arcoslab/open-coroco-legacy/src_DTC-SVM/Three-phase_bridge/20131107_111719.jpg

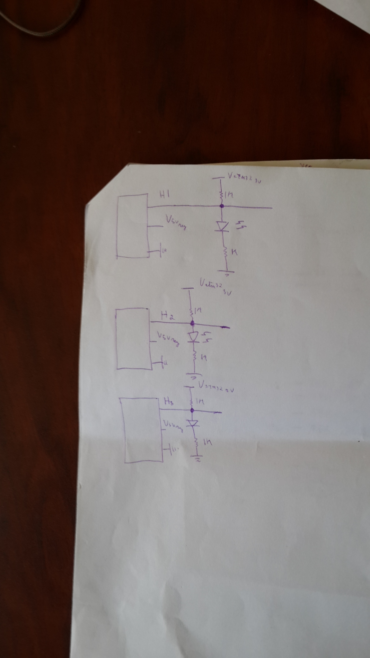
src_DTC-SVM/Three-phase_bridge/20131107_111719.jpg
