arcoslab/open-coroco-legacy/src_DTC-SVM/Three-phase_bridge/20131031_172141(1).jpg

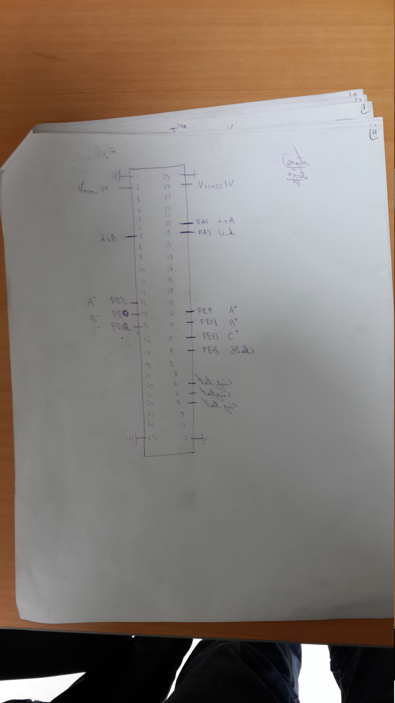
src_DTC-SVM/Three-phase_bridge/20131031_172141(1).jpg
