arcoslab/open-coroco-legacy/README.md

open-coroco
===========

COmpliant RObot COntroller is a free software project aiming to create an impedance controller based on a STM32F4 microcontroller using bldc motors and strain gauges.
