arcoslab/open-coroco-legacy/trabajo/datas/quadcopt/datasheet/accelerometer/bsp_lsm330.png

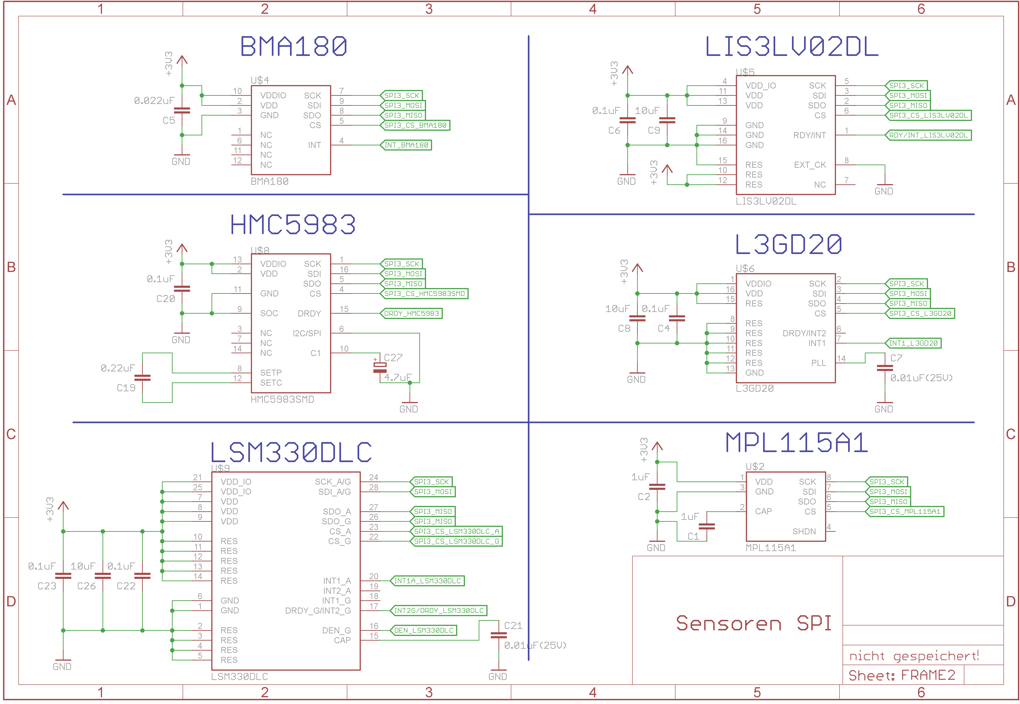
trabajo/datas/quadcopt/datasheet/accelerometer/bsp_lsm330.png
