arcoslab/open-coroco-legacy/trabajo/datas/quadcopt/datasheet/accelerometer/bsp_lsm330_stm32.png

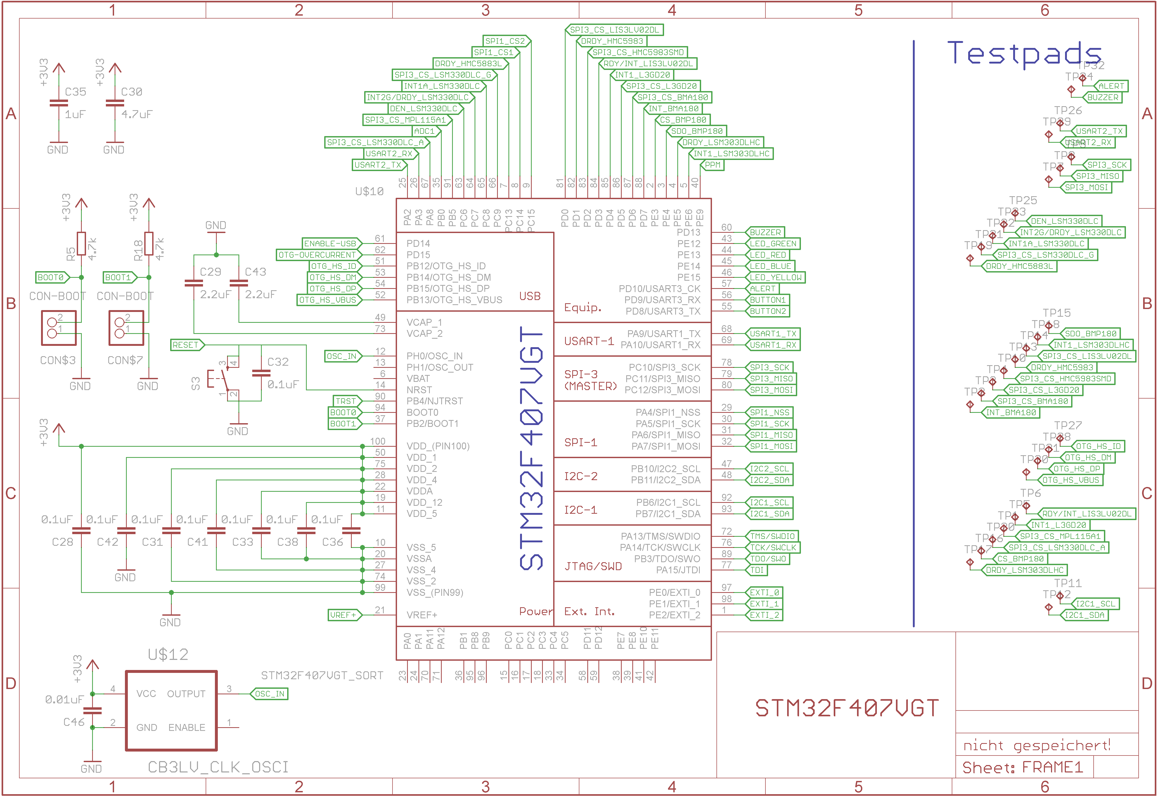
trabajo/datas/quadcopt/datasheet/accelerometer/bsp_lsm330_stm32.png
