arcoslab/open-coroco-legacy/trabajo/datas/quadcopt/datasheet/bsp_JTAG.jpg

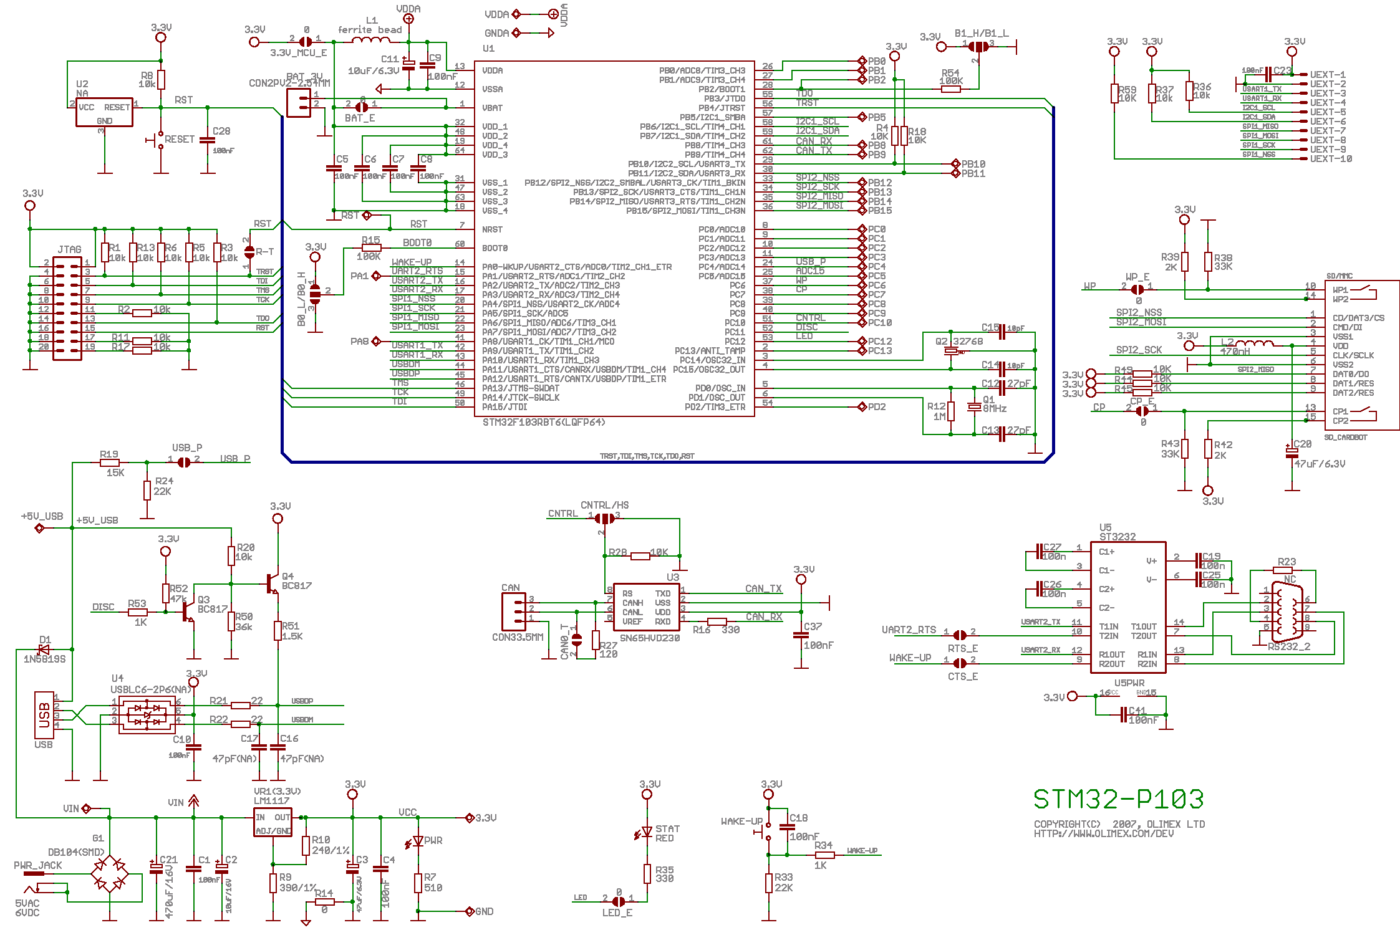
trabajo/datas/quadcopt/datasheet/bsp_JTAG.jpg
