arcoslab/open-coroco-legacy/trabajo/datas/quadcopt/datasheet/Schematics_KroozSD.jpg

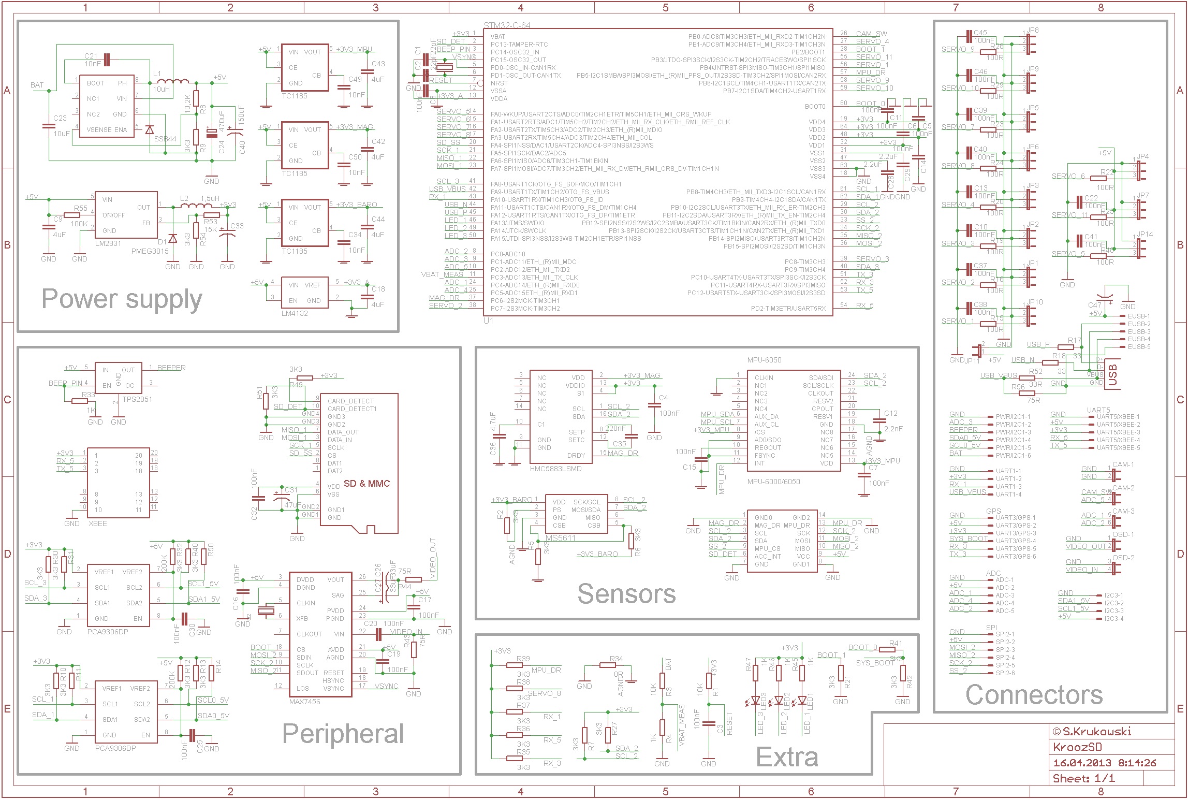
trabajo/datas/quadcopt/datasheet/Schematics_KroozSD.jpg
