arcoslab/open-coroco-legacy/trabajo/datas/quadcopt/components_octo.xlsx

Octocopter
µC1 -main
STM32F4 | mouser: $14.88
Connectors:
SD-Card
SD-Halterung direkt anschließen, evtl Pegel-Shifter einfügen. Wenn nicht benötigt, nur Halterung. Ansteuerung über SPI
SD-Connector | $1.64 | 688-SCHA5B0200
USB
direct Verbinden
USB-Connector
JTAG
herausführen, nötig? pins opfern. Vergleich mit BA, Schaltplan „bsp_Jtag“, großer Stecker
USART
4 stck verfügbar, Krooz 3 rausgeführt, welche Spannungen
XBEE
über UART ansteuern | $37.86 | 888-XBP24-ASI-001
OSD
MAX7456EUI+ | $20.64 | 700-MAX7456EUI
über SPI ansteuern
BARO measure
 |  | MS5611 | $6.51 | 824-MS561101BA03-50
 |  | I2C + SPI möglich, Krooz mit I2C
Accel/Gyro
LSM330DLC | $7.31 | 511-LSM330DLC
Package: LGA-28L Problem mit Löten!
I2C + SPI möglich, Krooz mit MPU_6050
GPS-Modul
Nole: Magnet, GPS, µC2
CAN-Bus:
http://www.fischl.de/usbtin/
http://www.mikrocontroller.net/topic/308543
http://www.mikrocontroller.net/topic/267388#new
http://ww1.microchip.com/downloads/en/AppNotes/00228a.pdf
http://www.mikrocontroller.net/topic/279426
http://www.mikrocontroller.net/topic/299315
Battery
AD-IO
Motors
PWM-Pins,
Gimpal
http://mikrocontroller.com/files/BL_Ctrl_V2_0_Doku.pdf
http://fpv-community.de/showthread.php?22617-Gimbal-Brushless-Controller-V3-0-50x50mm-by-Martinez
http://www.mikrocontroller.net/articles/Brushless-Controller_f%FCr_Modellbaumotoren
http://home.versanet.de/~b-konze/ur_blmc/schaltplan.htm
