arcoslab/open-coroco-legacy/trabajo/datas/quadcopt/datasheet/EvvGC v1.2/EvvGC v1.2 BOM.xls

Designator | Comment | Description | Footprint | Quantity
C1, C2 | 22pF | Capacitor | CAPC2012L | 2
C3, C4, C5, C6, C7, C8, C9, C10 | 100nF | Capacitor | CAPC2012L | 8
C11 | 47uF | Capacitor | TC6032-2412 | 1
D1 | LED2 | Typical RED, GREEN, YELLOW, AMBER GaAs LED | CAPC2012L | 1
J1 | USB Mini | USB 2.0, Right Angle, SMT, B Type, Receptacle, 5 Position, Black | 440247 | 1
P1 | I2C | Header, 4-Pin | HDR1X4 | 1
P2, P3, P4 | Header 3 | Header, 3-Pin | HDR1X3 | 3
P5 | SWD | Header, 4-Pin | HDR1X4 | 1
P6 | BOOT | Header, 3-Pin, Dual row | HDR2X3 | 1
P7 | Aux3 | Header, 3-Pin | HDR1X3 | 1
P9 | Aux4 | Header, 3-Pin | HDR1X3 | 1
P10 | Aux5 | Header, 3-Pin | HDR1X3 | 1
P11 | UART4 | Header, 4-Pin | HDR1X4 | 1
P12 | Aux1 | Header, 3-Pin | HDR1X3 | 1
P13 | Aux2 | Header, 3-Pin | HDR1X3 | 1
P14 | UART1 | Header, 4-Pin | HDR1X4 | 1
Q1, Q2, Q5, Q6, Q9, Q10, Q13, Q15, Q17 | SI4599DY | HEXFET Power MOSFET | SO-8_N | 9
Q3, Q4, Q7, Q8, Q11, Q12, Q14, Q16, Q18 | BSS123 | N-channel Enhancement Mode Field-effect Transistor | SOT23_N_EM | 9
Q19 | IRF9335 | HEXFET Power MOSFET | SO-8_N | 1
R1, R2, R3, R4, R6, R7, R10, R11, R12 | 330R | Resistor | C0805 | 9
R5, R8, R9, R13, R14, R15, R16 | 1K5 | RES 0603 1K5 | RESC1608N | 7
U1 | STM32F103RCT6 | STM32 ARM-based 32-bit MCU with 128 Kbytes Flash, 64-pin LQFP, Industrial Temperature | LQFP64_N | 1
U3 | 24C02C-E/SN | 2Kbit, 400kHz, 5V, I2C Serial EEPROM, 8-Pin SOIC 150mil, Extended Temperature | SOIC-SN8_N | 1
U4 | 78M33 | Positive Voltage Regulator | TO-252 | 1
Y1 | 8MHz | CRYSTAL 16M SMD5x3.2mm | ABM3 | 1
