arcoslab/open-coroco-legacy/trabajo/datas/robot/component_robot.xlsx

eeschema | (2013-dec-23)-stable |  | >> | Creation | date: | Fr | 30 | Mai | 2014 | 20:09:50 | CDT
#Cmp | ( | order |  |  | Mouser-Teilenr.
| | AD1 | AD2S1210 | LQFP48 |  | 584-AD2S1210ASTZ |  | $24.10 |  | x
| | C1 | 4.7µ | SM1206 |  | 581-12063C475KAT2A |  | $0.245 |  | x |  |  |  |  |  |  |  | ~ |  |  |  |  |  | ~
| | C2 | 10n | SM0805 |  | 77-VJ0805Y103KXBMC |  | $0.066 |  | x |  |  |  |  |  |  |  |  |  | ~ |  |  |  |  |  | ~
| | C3 | 10n | SM0805 |  | 77-VJ0805Y103KXBMC |  | $0.066 |  | x |  |  |  |  |  |  |  |  |  | ~ |  |  |  |  |  | ~
| | C4 | 20p | SM0805 |  | 581-08051A200JAT2A |  | $0.187 |  | x |  |  |  |  |  |  |  |  |  | ~ |  |  |  |  |  | ~
| | C5 | 10n | SM0805 |  | 77-VJ0805Y103KXBMC |  | $0.066 |  | x |  |  |  |  |  |  |  |  |  | ~ |  |  |  |  |  | ~
| | C6 | 10µ | SM1206 |  | 963-TMK316B7106KL-TD |  | $0.379 |  | x |  |  |  |  |  |  |  |  | ~ |  |  |  |  |  | ~
| | C7 | 4.7µ | SM1206 |  | 581-12063C475KAT2A |  | $0.245 |  | x |  |  |  |  |  |  |  | ~ |  |  |  |  |  | ~
| | C8 | 20p | SM0805 |  | 581-08051A200JAT2A |  | $0.187 |  | x |  |  |  |  |  |  |  |  |  | ~ |  |  |  |  |  | ~
| | C9 | 10n | SM0805 |  | 77-VJ0805Y103KXBMC |  | $0.066 |  | x |  |  |  |  |  |  |  |  |  | ~ |  |  |  |  |  | ~
| | C10 | 4.7µ | SM1206 |  | 581-12063C475KAT2A |  | $0.245 |  | x |  |  |  |  |  |  | ~ |  |  |  |  |  | ~
| | C11 | 2.2µ | SM0805 |  | 77-VJ0805V225MXJTBC |  | $0.066 |  | x |  |  |  |  |  |  | ~ |  |  |  |  |  | ~
| | C12 | 120p | SM0805 |  | 77-VJ0805A121GXXPBC |  | $0.065 |  | x |  |  |  |  |  |  |  | ~ |  |  |  |  |  | ~
| | C13 | 120p | SM0805 |  | 77-VJ0805A121GXXPBC |  | $0.065 |  | x |  |  |  |  |  |  |  | ~ |  |  |  |  |  | ~
| | C14 | 220µ | Elko_vert_DM10_RM5 |  | 140-REA221M1VBK1012P |  | $0.198 |  | x |  |  |  |  |  |  | ~ |  |  |  |  |  | ~
| | C15 | 10µ | SM1206 |  | 963-TMK316B7106KL-TD |  | $0.379 |  | x |  |  |  |  |  |  |  | ~ |  |  |  |  |  | ~
| | C16 | 100n | SM0805 |  | 77-VJ0805V104MXBPBC |  | $0.066 |  | x |  |  |  |  |  |  |  | ~ |  |  |  |  |  | ~
| | C17 | 100n | SM0805 |  | 77-VJ0805V104MXBPBC |  | $0.066 |  | x |  |  |  |  |  |  |  | ~ |  |  |  |  |  | ~
| | C18 | 10n | SM0805 |  | 77-VJ0805Y103KXBMC |  | $0.066 |  | x |  |  |  |  |  |  |  |  | ~ |  |  |  |  |  | ~
 | C19 | 100n | SM0805 |  | 77-VJ0805V104MXBPBC |  | $0.066 |  | x
 | C20 | 10µ | SM0805 |  | 963-TMK316B7106KL-TD |  | $0.379 |  | x
 | C21 | 10µ | SM0805 |  | 963-TMK316B7106KL-TD |  | $0.379 |  | x
| | D1 | DIODE | SM0805 |  | 821-TS4148-0805-RY |  | $0.111 |  | x |  |  |  |  |  |  |  | ~ |  |  |  |  |  | ~
| | D2 | DIODE | SM0805 |  | 821-TS4148-0805-RY |  | $0.111 |  | x |  |  |  |  |  |  |  | ~ |  |  |  |  |  | ~
| | D3 | DIODE | SM0805 |  | 821-TS4148-0805-RY |  | $0.111 |  | x |  |  |  |  |  |  |  | ~ |  |  |  |  |  | ~
| | D4 | DIODE | SM0805 |  | 821-TS4148-0805-RY |  | $0.111 |  | x |  |  |  |  |  |  |  | ~ |  |  |  |  |  | ~
 | Fuse | Fuse | 1812 |  | 650-MINISMDC110F/24 |  | $0.512 |  | x
| | IC1 | AD8662 | MSOP-8 |  | 584-AD8662ARMZ |  | $4.04 |  | x
| | Q1 | RECOM | Sip-3 |  | 919-R-78E5.0-0.5 |  | $3.10 |  | x
| | Q2 | BC846 | SOT-23 |  | 771-BC846215 |  | $0.145 |  | x |  |  |  |  |  |  |  |  | SOT-23
| | Q3 | BC856 | SOT-23 |  | 771-BC856B-T/R |  | $0.156 |  | x |  |  |  |  |  |  |  |  | SOT-23
| | Q4 | BC846 | SOT-23 |  | 771-BC846215 |  | $0.145 |  | x |  |  |  |  |  |  |  |  | SOT-23
| | Q5 | BC856 | SOT-23 |  | 771-BC856B-T/R |  | $0.156 |  | x |  |  |  |  |  |  |  |  | SOT-23
| | R1 | 1k | SM0805 |  | CRCW08051K00FKEA | http://de.mouser.com/Vishay-Dale |  |  | x |  |  |  |  |  |  |  |  |  |  | ~ |  |  |  |  |  | ~
| | R2 | 2.2k | SM0806 |  |  |  |  |  | x |  |  |  |  |  |  |  |  | ~ |  |  |  |  |  | ~
| | R3 | 8.66k | SM0807 |  | CRCW08058K66FKEA (http://de.mouser.com/ProductDetail/Vishay-Dale/CRCW08058K66FKEA/) |  |  |  | x |  |  |  |  |  |  |  | ~ |  |  |  |  |  | ~
| | R4 | 10k | SM0808 |  | CRCW080510K0JNEA (http://de.mouser.com/ProductDetail/Vishay-Dale/CRCW080510K0JNEA/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) | http://de.mouser.com/Vishay-Dale |  |  | x |  |  |  |  |  |  |  |  |  | ~ |  |  |  |  |  | ~
| | R5 | 22k | SM0809 |  | CRCW080522K0FKEA (http://de.mouser.com/ProductDetail/Vishay-Dale/CRCW080522K0FKEA/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) |  |  |  | x |  |  |  |  |  |  |  |  |  | ~ |  |  |  |  |  | ~
| | R6 | 10k | SM0810 |  | CRCW080510K0JNEA (http://de.mouser.com/ProductDetail/Vishay-Dale/CRCW080510K0JNEA/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) | http://de.mouser.com/Vishay-Dale |  |  | x |  |  |  |  |  |  |  |  |  | ~ |  |  |  |  |  | ~
| | R7 | 3.3k | SM0811 |  | CRCW08053K30FKEA |  |  |  | x |  |  |  |  |  |  |  |  | ~ |  |  |  |  |  | ~
| | R8 | 3.3k | SM0812 |  | CRCW08053K30FKEA |  |  |  | x |  |  |  |  |  |  |  |  | ~ |  |  |  |  |  | ~
| | R9 | 2.2k | SM0813 |  | 71-CRCW0805-2.2K-E3 (http://de.mouser.com/Search/ProductDetail.aspx) |  |  |  | x |  |  |  |  |  |  |  |  | ~ |  |  |  |  |  | ~
| | R10 | 4.7k | SM0814 |  | CRCW08054K70FKEA |  |  |  | x |  |  |  |  |  |  |  | ~ |  |  |  |  |  | ~
| | R11 | 4.7k | SM0815 |  | CRCW08054K70FKEA |  |  |  | x |  |  |  |  |  |  |  | ~ |  |  |  |  |  | ~
| | R12 | 4.7k | SM0816 |  | CRCW08054K70FKEA |  |  |  | x |  |  |  |  |  |  |  | ~ |  |  |  |  |  | ~
| | R13 | 4.7k | SM0817 |  | CRCW08054K70FKEA |  |  |  | x |  |  |  |  |  |  |  | ~ |  |  |  |  |  | ~
| | R14 | 2.2k | SM0818 |  | 71-CRCW0805-2.2K-E3 (http://de.mouser.com/Search/ProductDetail.aspx) |  |  |  | x |  |  |  |  |  |  |  | ~ |  |  |  |  |  | ~
| | R15 | 3.3k | SM0819 |  | CRCW08053K30FKEA |  |  |  | x |  |  |  |  |  |  |  | ~ |  |  |  |  |  | ~
| | R16 | 3.3k | SM0820 |  | CRCW08053K30FKEA |  |  |  | x |  |  |  |  |  |  |  | ~ |  |  |  |  |  | ~
| | R17 | 13.3k | SM0821 |  | CRCW080513K3FKEA (http://de.mouser.com/ProductDetail/Vishay-Dale/CRCW080513K3FKEA/) |  |  |  | x |  |  |  |  |  |  | ~ |  |  |  |  |  | ~
| | R18 | 10k | SM0822 |  | CRCW080510K0JNEA (http://de.mouser.com/ProductDetail/Vishay-Dale/CRCW080510K0JNEA/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) | http://de.mouser.com/Vishay-Dale |  |  | x |  |  |  |  |  |  |  |  | ~ |  |  |  |  |  | ~
| | R19 | 22k | SM0823 |  | CRCW080522K0FKEA (http://de.mouser.com/ProductDetail/Vishay-Dale/CRCW080522K0FKEA/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) |  |  |  | x |  |  |  |  |  |  |  |  | ~ |  |  |  |  |  | ~
| | R20 | 10k | SM0824 |  | CRCW080510K0JNEA (http://de.mouser.com/ProductDetail/Vishay-Dale/CRCW080510K0JNEA/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) | http://de.mouser.com/Vishay-Dale |  |  | x |  |  |  |  |  |  |  |  | ~ |  |  |  |  |  | ~
| | R21 | 2.2k | SM0825 |  | 71-CRCW0805-2.2K-E3 (http://de.mouser.com/Search/ProductDetail.aspx) |  |  |  | x |  |  |  |  |  |  |  | ~ |  |  |  |  |  | ~
 | R22 |  |  |  | 71-CRCW0805-0-E3 |  | $0.087 |  | x
 | R23 |  |  |  | 71-CRCW0805-0-E3 |  | $0.087 |  | x
| | R24 | 15.4k |  |  | CRCW080515K4FKEA (http://de.mouser.com/ProductDetail/Vishay-Dale/CRCW080515K4FKEA/) |  |  |  | x |  |  |  |  | ~ |  |  |  |  |  |  | ~
 | R25 | 8.66k | SM0807 |  | CRCW08058K66FKEA (http://de.mouser.com/ProductDetail/Vishay-Dale/CRCW08058K66FKEA/) |  |  |  | x
 | R26 | 15.4k |  |  | CRCW080515K4FKEA (http://de.mouser.com/ProductDetail/Vishay-Dale/CRCW080515K4FKEA/) |  |  |  | x
 | R27 | 13.3k |  |  | CRCW080513K3FKEA (http://de.mouser.com/ProductDetail/Vishay-Dale/CRCW080513K3FKEA/) |  |  |  | x
 | X1 | 8.192MHZ |  |  | 774-ATS081BSM-1E |  | $0.401 |  | x
 | P2 |  |  |  | 571-1986370-6 |  | $7.99 |  | x
 | P2 (Socket) |  |  |  | 571-284514-6 |  | $2.83 |  | x |  |  |  |  |  |  |  |  | ~
 | R/A POWER JACK |  |  |  | 502-RAPC712X |  | $1.34 |  | x |  |  |  |  |  |  |  |  | ~
 | Diode_Verpolung |  | 1206 |  | 581-SD1206S040S1R0 |  | $0.512 |  | x |  |  |  |  |  |  | ~
| | P1 | CONN_25X2 | Pinarray |  | 517-929400-01-25-RK |  | $1.91 |  | x |  |  |  |  |  |  | ~
 | P3 | CONN_25X2 | Pinarray |  | 517-929400-01-25-RK |  | $1.91 |  | x |  |  |  |  |  |  |  |  | ~
 | K1 | CONN_3X1 |  |  | 517-929834-02-03 |  | $0.207 |  | x |  |  |  |  |  |  |  |  | ~
 | K2 | CONN_3X1 |  |  | 517-929834-02-03 |  | $0.207 |  | x |  |  |  |  |  |  |  |  | ~
 | P4 | CONN_3X2 |  |  | 517-929836-09-03 |  | $0.36 |  | x |  |  |  |  |  |  |  |  | ~
 | P5 | CONN_3X2 |  |  | 517-929836-09-03 |  | $0.36 |  | x |  |  |  |  |  |  |  | ~
 |  |  |  |  |  |  |  |  |  |  |  |  |  |  |  | ~
 |  |  |  |  |  |  |  |  |  |  |  |  |  |  |  | ~
 |  |  |  |  |  |  |  |  |  |  |  |  |  |  | ~
 |  |  |  |  |  |  |  |  |  |  |  |  |  |  |  | ~
 |  |  |  |  |  |  |  |  |  |  |  |  |  |  |  | ~
 |  |  |  |  |  |  |  |  |  |  |  |  |  |  | ~
 |  |  |  |  |  |  |  |  |  |  |  |  |  |  |  |  | ~
 |  |  |  |  |  |  |  |  |  |  |  |  |  |  | ~
 |  |  |  |  |  |  |  |  |  |  |  |  |  |  |  | ~
 |  |  |  |  |  |  |  |  |  |  |  |  |  |  |  | ~
 |  |  |  |  |  |  |  |  |  |  |  |  |  |  |  | ~
 |  |  |  |  |  |  |  |  |  |  |  |  |  |  |  | ~
 |  |  |  |  |  |  |  |  |  |  |  |  |  |  |  | ~
 |  |  |  |  |  |  |  |  |  |  |  |  |  |  |  |  |  |  | ~
 |  |  |  |  |  |  |  |  |  |  |  |  |  |  |  |  | ~
 |  |  |  |  |  |  |  |  |  |  |  |  |  |  |  |  | ~
 |  |  |  |  |  |  |  |  |  |  |  |  |  |  |  | ~
 |  |  |  |  |  |  |  |  |  |  |  |  |  |  |  | ~
 |  |  |  |  |  |  |  |  |  |  |  |  |  |  |  |  | ~
 |  |  |  |  |  |  |  |  |  |  |  |  |  |  |  |  | ~
 |  |  |  |  |  |  |  |  |  |  |  |  |  |  |  | ~
 |  |  |  |  |  |  |  |  |  |  |  |  |  |  |  | ~
 |  |  |  |  |  |  |  |  |  |  |  |  |  |  |  | ~
 |  |  |  |  |  |  |  |  |  |  |  |  |  |  |  | ~
 |  |  |  |  |  |  |  |  |  |  |  |  |  |  |  | ~
 |  |  |  |  |  |  |  |  |  |  |  |  |  |  |  | ~
 |  |  |  |  |  |  |  |  |  |  |  | ~ |  |  |  |  |  | ~
 |  |  |  |  |  |  |  |  |  |  |  | ~ |  |  |  |  |  | ~
 |  |  |  |  |  |  |  |  |  |  |  |  |  |  |  |  | ~
 |  |  |  |  |  |  |  |  |  |  |  |  |  |  |  |  | ~
 |  |  |  |  |  |  |  |  |  |  |  |  |  |  |  | ~
| | 20p | C4 |  |  |  |  |  |  |  |  |  |  |  |  | ~
| | 20p | C8 |  |  |  |  |  |  |  |  |  | ~ |  |  |  |  |  | ~
| | 120p | C12 |  |  |  |  |  |  |  |  |  |  |  |  |  |  | ~
| | 120p | C13 |  |  |  |  |  |  |  |  |  |  | ~
| | 10n | C2
| | 10n | C3
| | 10n | C5
| | 10n | C9
| | 10n | C18
| | 100n | C16
| | 100n | C17
| | 2.2µ | C11
| | 4.7µ | C1
| | 4.7µ | C7
| | 4.7µ | C10
| | 22µ | C6
| | 220µ | C14
| | 10µ | C15
| | DIODE | D1
| | DIODE | D2
| | DIODE | D3
| | DIODE | D4
| | AD8662 | IC1
| | CONN_25X2 | P1
| | RECOM | Q1
| | BC846 | Q2
| | BC856 | Q3
| | BC846 | Q4
| | BC856 | Q5
| | 1k | R1
| | 2.2k | R2
| | 2.2k | R9
| | 2.2k | R14
| | 2.2k | R21
| | 3.3k | R7
| | 3.3k | R8
| | 3.3k | R15
| | 3.3k | R16
| | 4.7k | R10
| | 4.7k | R11
| | 4.7k | R12
| | 4.7k | R13
| | 10k | R4
| | 10k | R6
| | 10k | R18
| | 10k | R20
| | 13.6k | R3
| | 13.6k | R17
| | 22k | R5
| | 22k | R19
