arcoslab/open-coroco-legacy/src_DTC-SVM_Fixed_Testing/Vexta adapter/Before high density/Vexta_motor_adapter_real_measures.stl

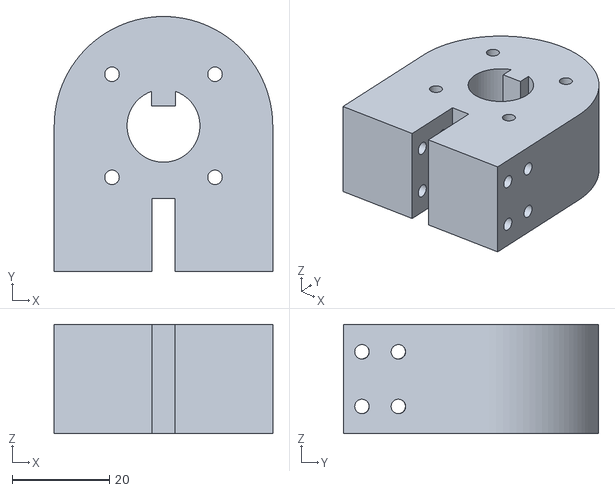
[picture p8: CAD file, 2014-08-01]
src_DTC-SVM_Fixed_Testing/Vexta adapter/Before high density/Vexta_motor_adapter_real_measures.stl
45.0 x 52.5 x 22.5
