arcoslab/open-coroco-legacy/src_Kalman_Filter/sources/src_DTC-SVM/Vexta adapter/old/Vexta_motor_adapter_squared.fcstd

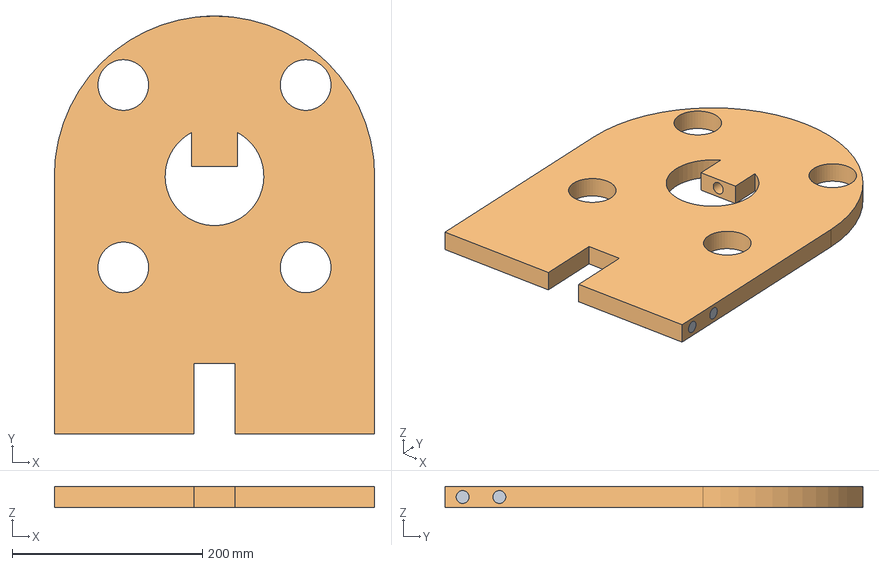
[picture p9: CAD file, 2014-08-01, an earlier design]
src_Kalman_Filter/sources/src_DTC-SVM/Vexta adapter/old/Vexta_motor_adapter_squared.fcstd
337.0 x 439.5 x 22.5 mm
