arcoslab/open-coroco-legacy/(list of files, cad)

Other CAD files:
src_Kalman_Filter/sources/src_DTC-SVM/Vexta adapter/Before high density/Vexta_motor_adapter_squared_real_measures.fcstd
src_DTC-SVM_Fixed_Testing/Vexta adapter/Before high density/Vexta_motor_adapter_squared_real_measures.fcstd
src_DTC-SVM_Fixed_Testing/Vexta adapter/Vexta_motor_adapter_squared_real_measures.fcstd
src_DTC-SVM_FixedPoint/Vexta adapter/Before high density/Vexta_motor_adapter_squared_real_measures.fcstd
src_DTC-SVM_FixedPoint/Vexta adapter/Vexta_motor_adapter_squared_real_measures.fcstd
src_Kalman_Filter/sources/src_DTC-SVM/Vexta adapter/Vexta_motor_adapter_squared_real_measures.fcstd
src_DTC-SVM_Fixed_Testing/Vexta adapter/old/Vexta_motor_just_holes.fcstd
src_DTC-SVM_FixedPoint/Vexta adapter/old/Vexta_motor_adapter.fcstd
src_DTC-SVM_Fixed_Testing/Vexta adapter/old/Vexta_motor_adapter.fcstd
src_Kalman_Filter/sources/src_DTC-SVM/Vexta adapter/old/Vexta_motor_adapter.fcstd
src_DTC-SVM_FixedPoint/Vexta adapter/old/Vexta_motor_adapter.stl
src_DTC-SVM_FixedPoint/Vexta adapter/old/Vexta_motor_just_holes.fcstd
src_DTC-SVM_Fixed_Testing/Vexta adapter/old/Vexta_motor_adapter.stl
src_Kalman_Filter/sources/src_DTC-SVM/Vexta adapter/old/Vexta_motor_adapter.stl
src_Kalman_Filter/sources/src_DTC-SVM/Vexta adapter/old/Vexta_motor_just_holes.fcstd
