arcoslab/open-coroco-legacy/src_DTC-SVM_FixedPoint/StackUsage.txt

Trigonometric_Functions.h:32:5:corrected_rounded_angle	0	static
Trigonometric_Functions.h:40:5:corrected_atan_rounded_angle	0	static
Trigonometric_Functions.h:76:7:sine_linear_interpolation	32	static
Trigonometric_Functions.h:128:7:fast_sine	8	static
Trigonometric_Functions.h:257:7:fast_cos	0	static
Trigonometric_Functions.h:308:7:atan_linear_interpolation	32	static
Trigonometric_Functions.h:338:7:fast_atan	0	static
Print.c:20:6:clean_stdin	8	static
Print.c:29:6:stdin_init	8	static
Print.c:36:6:receive_a_string	24	static
admittance_control.c:20:7:admittance_controller	0	static
PID.c:100:7:frequency_direction_two_hall_sensors_AB	12	static
PID.c:155:6:calc_freq	8	static
PID.c:318:6:frequency_input	16	static
filters.c:366:7:isA_moving_average_filter	136	static
filters.c:540:7:isB_moving_average_filter	136	static
filters.c:713:7:te_moving_average_filter	136	static
filters.c:887:7:wr_moving_average_filter	144	static
initial_setup.c:20:6:leds_init	8	static
initial_setup.c:29:6:hall_init	8	static
initial_setup.c:44:6:test_ports_init	8	static
initial_setup.c:55:6:DTC_SVM_tim_init	8	static
initial_setup.c:198:6:PID_tim_init	8	static
initial_setup.c:340:6:DTC_tim_init	8	static
initial_setup.c:483:6:adc_init	8	static
initial_setup.c:515:6:system_init	8	static
shunt.c:63:6:voltage_measure	24	static
sensorless_PID.c:34:6:sensorless_pure_speed_SVM_pi_controller	0	static
sensorless_PID.c:85:6:sensorless_speed_pi_controller	0	static
sensorless_PID.c:161:7:psi_advance_calculator	0	static
sensorless_PID.c:171:6:sensorless_torque_pi_controller	0	static
DTC.c:24:7:direct_stator_current_i_sD	0	static
DTC.c:28:7:quadrature_stator_current_i_sQ	0	static
DTC.c:36:7:switching_states	40	static
DTC.c:63:7:floating_switching_states	40	static
DTC.c:144:7:direct_stator_flux_linkage_estimator_psi_sD	0	static
DTC.c:167:7:quadrature_stator_flux_linkage_estimator_psi_sQ	0	static
DTC.c:295:6:flux_linkage_estimator_neglected_currents	16	static
DTC.c:441:7:rotor_speed_w_r	0	static
DTC.c:457:7:electromagnetic_torque_estimation_t_e	0	static
DTC.c:498:5:stator_flux_linkage_hysteresis_controller_d_psi	0	static
DTC.c:517:5:electromagnetic_torque_hysteresis_controller_d_te	0	static
DTC.c:575:6:optimal_voltage_switching_vector_selection_table	12	static
DTC.c:633:6:voltage_switch_inverter_VSI	40	static
DTC.c:884:7:fast_vector_angle	8	static
DTC.c:189:6:fast_vector_angle_and_magnitude	24	static
DTC.c:204:6:flux_linkage_estimator	56	static
DTC.c:912:7:extended_fast_atan	0	static
DTC.c:918:7:A_inverse_clark_transformation	0	static
DTC.c:924:7:B_inverse_clark_transformation	0	static
DTC.c:932:7:C_inverse_clark_transformation	0	static
DTC.c:942:7:duty_cycle_to_angle	8	static
DTC.c:956:7:phase_A_angle_to_stator_angle	0	static
DTC.c:969:7:stator_angle_to_phase_A	0	static
DTC.c:1010:7:DTC_torque_reference_PI	0	static
initial_rotor_position.c:23:6:checking_initial_rotor_currents_sign	0	static
initial_rotor_position.c:28:7:initial_rotor_position_I_VI_quadrants	8	static
initial_rotor_position.c:48:5:initial_rotor_sector_120_degrees_ABC	0	static
initial_rotor_position.c:86:7:initial_rotor_position_angle_discrimination	0	static
initial_rotor_position.c:138:6:initial_rotor_position_pulses	24	static
initial_rotor_position.c:296:6:do_nothing	0	static
initial_rotor_position.c:307:6:A_pulse_voltage_vector	0	static
initial_rotor_position.c:318:6:negative_A_pulse_voltage_vector	0	static
initial_rotor_position.c:328:6:B_pulse_voltage_vector	24	static
initial_rotor_position.c:339:6:negative_B_pulse_voltage_vector	24	static
initial_rotor_position.c:350:6:C_pulse_voltage_vector	24	static
initial_rotor_position.c:361:6:negative_C_pulse_voltage_vector	24	static
initial_rotor_position.c:375:6:zero_voltage_vector	8	static
initial_rotor_position.c:390:6:initial_rotor_position_ABC_pulses	56	static
SVM.c:22:7:SVM_V_s_ref_D	40	static
SVM.c:35:7:SVM_V_s_ref_Q	40	static
SVM.c:50:6:SVM_Maximum_allowed_V_s_ref	0	static
SVM.c:73:7:SVM_V_s_relative_angle	0	static
SVM.c:88:7:SVM_T1	16	static
SVM.c:98:7:SVM_T2	16	static
SVM.c:112:7:SVM_T_min_on	0	static
SVM.c:122:7:SVM_T_med_on	0	static
SVM.c:148:7:SVM_T_max_on	0	static
SVM.c:169:6:SVM_phase_duty_cycles	0	static
SVM.c:217:7:SVM_voltage_switch_inverter_VSI	32	static
SVM.c:338:6:shutdown_SVM_speed	0	static
SVM.c:356:6:shutdown_admittance_speed	0	static
SVM.c:383:6:shutdown_SVM_position	8	static
SVM.c:448:6:simple_shutdown	0	static
SVM.c:457:6:shutdown_SVM_torque	0	static
SVM.c:487:6:SVM_starting_open_loop	32	static
SVM.c:636:7:SVM_speed_close_loop_of_voltage_frequency	32	static
SVM.c:683:6:SVM_speed_close_loop	40	static
SVM.c:725:6:SVM_torque_close_loop	40	static
SVM.c:818:7:DTC_SVM	80	static
interrupts.c:378:6:adc_isr	16	static
collecting_data.c:144:6:collecting_collected_in_buffer	12	static
collecting_data.c:127:6:colllecting_flux_linkage	8	static
collecting_data.c:322:6:collecting_samples	0	static
collecting_data.c:235:6:collecting_floating_data	8	static
interrupts.c:156:6:tim1_up_tim10_isr	8	static
collecting_data.c:496:6:print_captured_data	0	static
collecting_data.c:548:6:print_captured_collected_char	200	static
collecting_data.c:1120:6:print_collected_data_buffer_character	0	static
collecting_data.c:1181:6:print_float_as_bytes	24	static
collecting_data.c:625:6:print_regular_data	24	static
collecting_data.c:928:6:full_print_regular_data	24	static
collecting_data.c:1081:6:print_collected_data_buffer	16	static
collecting_data.c:1202:6:print_fixedpt_as_bytes	24	static
collecting_data.c:1224:6:print_int_as_bytes	24	static
collecting_data.c:1246:1:fixedpt_print	80	static
parameter_identification.c:20:6:pwm_parameter_identification	32	static
example.c:98:5:main	8	static
