arcoslab/open-coroco-legacy/src_caro_DTC-SVM/Print/sine_function_plain.png

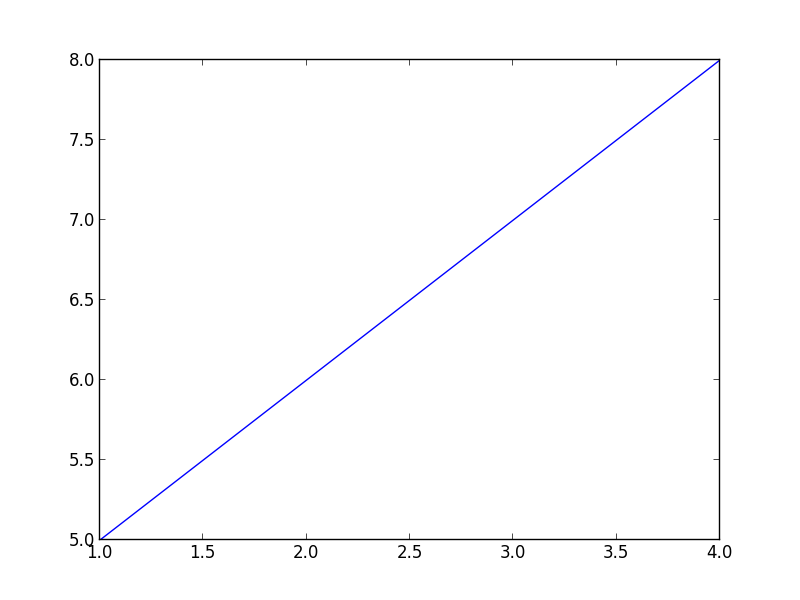
src_caro_DTC-SVM/Print/sine_function_plain.png
