arcoslab/open-coroco-legacy/src_DTC-SVM_Fixed_Testing/ADC_Measurements_Results/images/[Fri Apr 17 19:04:54 2015] [one 300 0, hall frequency controller, P =0.001]/[Fri Apr 17 19:04:54 2015] [one 300 0, hall frequency controller, P =0.001] data frequencies.csv

t t ref_freq ref_freq electric_frequency electric_frequency hall_freq hall_freq
t: 31.00 ref_freq: 300.00 electric_frequency: -1.74 hall_freq: 0.00 mechanical_freq: -0.35 gear_freq: -0.001736 changing_frequency initial 0
t: 31.00 ref_freq: 300.00 electric_frequency: -1.74 hall_freq: 0.00 mechanical_freq: -0.35 gear_freq: -0.001736 changing_frequency initial 0
t: 31.00 ref_freq: 300.00 electric_frequency: -1.74 hall_freq: 0.00 mechanical_freq: -0.35 gear_freq: -0.001736 changing_frequency initial 0
t: 31.00 ref_freq: 300.00 electric_frequency: -1.74 hall_freq: 0.00 mechanical_freq: -0.35 gear_freq: -0.001736 changing_frequency initial 0
t: 31.00 ref_freq: 300.00 electric_frequency: -1.74 hall_freq: 0.00 mechanical_freq: -0.35 gear_freq: -0.001736 changing_frequency initial 0
t: 31.00 ref_freq: 300.00 electric_frequency: -1.74 hall_freq: 0.00 mechanical_freq: -0.35 gear_freq: -0.001736 changing_frequency initial 0
t: 31.00 ref_freq: 300.00 electric_frequency: -1.74 hall_freq: 0.00 mechanical_freq: -0.35 gear_freq: -0.001736 changing_frequency initial 0
t: 31.00 ref_freq: 300.00 electric_frequency: -1.74 hall_freq: 0.00 mechanical_freq: -0.35 gear_freq: -0.001736 changing_frequency initial 0
t: 31.00 ref_freq: 300.00 electric_frequency: -1.74 hall_freq: 0.00 mechanical_freq: -0.35 gear_freq: -0.001736 changing_frequency initial 0
t: 31.00 ref_freq: 300.00 electric_frequency: -1.74 hall_freq: 0.00 mechanical_freq: -0.35 gear_freq: -0.001736 changing_frequency initial 0
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
t: 157.00 ref_freq: 300.00 electric_frequency: 1.67 hall_freq: 0.00 mechanical_freq: 0.33 gear_freq: 0.001670 changing_frequency initial 0
t: 172.00 ref_freq: 300.00 electric_frequency: 1.70 hall_freq: 0.00 mechanical_freq: 0.34 gear_freq: 0.001696 changing_frequency initial 0
t: 187.00 ref_freq: 300.00 electric_frequency: 1.63 hall_freq: 0.00 mechanical_freq: 0.33 gear_freq: 0.001632 changing_frequency initial 0
t: 201.00 ref_freq: 300.00 electric_frequency: 1.64 hall_freq: 0.00 mechanical_freq: 0.33 gear_freq: 0.001644 changing_frequency initial 0
t: 216.00 ref_freq: 300.00 electric_frequency: 1.62 hall_freq: 0.00 mechanical_freq: 0.32 gear_freq: 0.001616 changing_frequency initial 0
t: 231.00 ref_freq: 300.00 electric_frequency: 1.49 hall_freq: 0.00 mechanical_freq: 0.30 gear_freq: 0.001486 changing_frequency initial 0
t: 246.00 ref_freq: 300.00 electric_frequency: 1.51 hall_freq: 0.00 mechanical_freq: 0.30 gear_freq: 0.001509 changing_frequency initial 0
t: 261.00 ref_freq: 300.00 electric_frequency: 1.45 hall_freq: 0.00 mechanical_freq: 0.29 gear_freq: 0.001448 changing_frequency initial 0
t: 276.00 ref_freq: 300.00 electric_frequency: 1.40 hall_freq: 0.00 mechanical_freq: 0.28 gear_freq: 0.001395 changing_frequency initial 0
t: 290.00 ref_freq: 300.00 electric_frequency: 1.27 hall_freq: 0.00 mechanical_freq: 0.25 gear_freq: 0.001266 changing_frequency initial 0
t: 304.00 ref_freq: 300.00 electric_frequency: 1.30 hall_freq: 0.00 mechanical_freq: 0.26 gear_freq: 0.001300 changing_frequency initial 0
t: 318.00 ref_freq: 300.00 electric_frequency: 1.16 hall_freq: 0.00 mechanical_freq: 0.23 gear_freq: 0.001165 changing_frequency initial 0
t: 331.00 ref_freq: 300.00 electric_frequency: 1.08 hall_freq: 0.00 mechanical_freq: 0.22 gear_freq: 0.001085 changing_frequency initial 0
t: 344.00 ref_freq: 300.00 electric_frequency: 0.94 hall_freq: 0.00 mechanical_freq: 0.19 gear_freq: 0.000940 changing_frequency initial 0
t: 357.00 ref_freq: 300.00 electric_frequency: 0.89 hall_freq: 0.00 mechanical_freq: 0.18 gear_freq: 0.000887 changing_frequency initial 0
t: 372.00 ref_freq: 300.00 electric_frequency: 0.79 hall_freq: 0.00 mechanical_freq: 0.16 gear_freq: 0.000790 changing_frequency initial 0
t: 387.00 ref_freq: 300.00 electric_frequency: 0.64 hall_freq: 0.00 mechanical_freq: 0.13 gear_freq: 0.000643 changing_frequency initial 0
t: 403.00 ref_freq: 300.00 electric_frequency: 0.49 hall_freq: 0.00 mechanical_freq: 0.10 gear_freq: 0.000494 changing_frequency initial 0
t: 418.00 ref_freq: 300.00 electric_frequency: 0.35 hall_freq: 0.00 mechanical_freq: 0.07 gear_freq: 0.000345 changing_frequency initial 0
t: 432.00 ref_freq: 300.00 electric_frequency: 0.20 hall_freq: 0.00 mechanical_freq: 0.04 gear_freq: 0.000202 changing_frequency initial 0
t: 459.00 ref_freq: 300.00 electric_frequency: -0.11 hall_freq: 0.00 mechanical_freq: -0.02 gear_freq: -0.000111 changing_frequency initial 0
t: 473.00 ref_freq: 300.00 electric_frequency: -0.28 hall_freq: 0.00 mechanical_freq: -0.06 gear_freq: -0.000276 changing_frequency initial 0
t: 487.00 ref_freq: 300.00 electric_frequency: -0.44 hall_freq: 0.00 mechanical_freq: -0.09 gear_freq: -0.000444 changing_frequency initial 0
t: 502.00 ref_freq: 300.00 electric_frequency: -0.66 hall_freq: 0.00 mechanical_freq: -0.13 gear_freq: -0.000664 changing_frequency initial 0
t: 516.00 ref_freq: 300.00 electric_frequency: -0.85 hall_freq: 0.00 mechanical_freq: -0.17 gear_freq: -0.000854 changing_frequency initial 0
t: 532.00 ref_freq: 300.00 electric_frequency: -1.08 hall_freq: 0.00 mechanical_freq: -0.22 gear_freq: -0.001076 changing_frequency initial 0
t: 545.00 ref_freq: 300.00 electric_frequency: -1.26 hall_freq: 0.00 mechanical_freq: -0.25 gear_freq: -0.001263 changing_frequency initial 0
t: 559.00 ref_freq: 300.00 electric_frequency: -1.46 hall_freq: 0.00 mechanical_freq: -0.29 gear_freq: -0.001459 changing_frequency initial 0
t: 574.00 ref_freq: 300.00 electric_frequency: -1.69 hall_freq: 0.00 mechanical_freq: -0.34 gear_freq: -0.001688 changing_frequency initial 0
t: 588.00 ref_freq: 300.00 electric_frequency: -1.86 hall_freq: 0.00 mechanical_freq: -0.37 gear_freq: -0.001857 changing_frequency initial 0
t: 604.00 ref_freq: 300.00 electric_frequency: -2.07 hall_freq: 0.00 mechanical_freq: -0.41 gear_freq: -0.002067 changing_frequency initial 0
t: 618.00 ref_freq: 300.00 electric_frequency: -2.22 hall_freq: 0.00 mechanical_freq: -0.44 gear_freq: -0.002220 changing_frequency initial 0
t: 631.00 ref_freq: 300.00 electric_frequency: -2.40 hall_freq: 0.00 mechanical_freq: -0.48 gear_freq: -0.002396 changing_frequency initial 0
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
t: 171.00 ref_freq: 300.00 electric_frequency: -1.83 hall_freq: 0.00 mechanical_freq: -0.37 gear_freq: -0.001830 changing_frequency initial 0
t: 185.00 ref_freq: 300.00 electric_frequency: -1.55 hall_freq: 0.00 mechanical_freq: -0.31 gear_freq: -0.001547 changing_frequency initial 0
t: 199.00 ref_freq: 300.00 electric_frequency: -1.41 hall_freq: 0.00 mechanical_freq: -0.28 gear_freq: -0.001413 changing_frequency initial 0
t: 213.00 ref_freq: 300.00 electric_frequency: -1.18 hall_freq: 0.00 mechanical_freq: -0.24 gear_freq: -0.001176 changing_frequency initial 0
t: 225.00 ref_freq: 300.00 electric_frequency: -0.98 hall_freq: 0.00 mechanical_freq: -0.20 gear_freq: -0.000979 changing_frequency initial 0
t: 238.00 ref_freq: 300.00 electric_frequency: -0.79 hall_freq: 0.00 mechanical_freq: -0.16 gear_freq: -0.000787 changing_frequency initial 0
t: 252.00 ref_freq: 300.00 electric_frequency: -0.64 hall_freq: 0.00 mechanical_freq: -0.13 gear_freq: -0.000639 changing_frequency initial 0
t: 265.00 ref_freq: 300.00 electric_frequency: -0.47 hall_freq: 0.00 mechanical_freq: -0.09 gear_freq: -0.000467 changing_frequency initial 0
t: 279.00 ref_freq: 300.00 electric_frequency: -0.25 hall_freq: 0.00 mechanical_freq: -0.05 gear_freq: -0.000253 changing_frequency initial 0
t: 292.00 ref_freq: 300.00 electric_frequency: -0.08 hall_freq: 0.00 mechanical_freq: -0.02 gear_freq: -0.000083 changing_frequency initial 0
t: 305.00 ref_freq: 300.00 electric_frequency: 0.09 hall_freq: 0.00 mechanical_freq: 0.02 gear_freq: 0.000093 changing_frequency initial 0
t: 318.00 ref_freq: 300.00 electric_frequency: 0.25 hall_freq: 0.00 mechanical_freq: 0.05 gear_freq: 0.000247 changing_frequency initial 0
t: 330.00 ref_freq: 300.00 electric_frequency: 0.37 hall_freq: 0.00 mechanical_freq: 0.07 gear_freq: 0.000371 changing_frequency initial 0
t: 344.00 ref_freq: 300.00 electric_frequency: 0.53 hall_freq: 0.00 mechanical_freq: 0.11 gear_freq: 0.000533 changing_frequency initial 0
t: 357.00 ref_freq: 300.00 electric_frequency: 0.64 hall_freq: 0.00 mechanical_freq: 0.13 gear_freq: 0.000637 changing_frequency initial 0
t: 370.00 ref_freq: 300.00 electric_frequency: 0.77 hall_freq: 0.00 mechanical_freq: 0.15 gear_freq: 0.000765 changing_frequency initial 0
t: 383.00 ref_freq: 300.00 electric_frequency: 0.90 hall_freq: 0.00 mechanical_freq: 0.18 gear_freq: 0.000903 changing_frequency initial 0
t: 396.00 ref_freq: 300.00 electric_frequency: 1.01 hall_freq: 0.00 mechanical_freq: 0.20 gear_freq: 0.001009 changing_frequency initial 0
t: 409.00 ref_freq: 300.00 electric_frequency: 1.10 hall_freq: 0.00 mechanical_freq: 0.22 gear_freq: 0.001096 changing_frequency initial 0
t: 422.00 ref_freq: 300.00 electric_frequency: 1.23 hall_freq: 0.00 mechanical_freq: 0.25 gear_freq: 0.001227 changing_frequency initial 0
t: 434.00 ref_freq: 300.00 electric_frequency: 1.32 hall_freq: 0.00 mechanical_freq: 0.26 gear_freq: 0.001316 changing_frequency initial 0
t: 447.00 ref_freq: 300.00 electric_frequency: 1.40 hall_freq: 0.00 mechanical_freq: 0.28 gear_freq: 0.001398 changing_frequency initial 0
t: 460.00 ref_freq: 300.00 electric_frequency: 1.45 hall_freq: 0.00 mechanical_freq: 0.29 gear_freq: 0.001451 changing_frequency initial 0
t: 473.00 ref_freq: 300.00 electric_frequency: 1.51 hall_freq: 0.00 mechanical_freq: 0.30 gear_freq: 0.001512 changing_frequency initial 0
t: 486.00 ref_freq: 300.00 electric_frequency: 1.54 hall_freq: 0.00 mechanical_freq: 0.31 gear_freq: 0.001541 changing_frequency initial 0
t: 499.00 ref_freq: 300.00 electric_frequency: 1.65 hall_freq: 0.00 mechanical_freq: 0.33 gear_freq: 0.001646 changing_frequency initial 0
t: 511.00 ref_freq: 300.00 electric_frequency: 1.71 hall_freq: 0.00 mechanical_freq: 0.34 gear_freq: 0.001711 changing_frequency initial 0
t: 524.00 ref_freq: 300.00 electric_frequency: 1.77 hall_freq: 0.00 mechanical_freq: 0.35 gear_freq: 0.001773 changing_frequency initial 0
t: 537.00 ref_freq: 300.00 electric_frequency: 1.81 hall_freq: 0.00 mechanical_freq: 0.36 gear_freq: 0.001815 changing_frequency initial 0
t: 550.00 ref_freq: 300.00 electric_frequency: 1.82 hall_freq: 0.00 mechanical_freq: 0.36 gear_freq: 0.001816 changing_frequency initial 0
t: 563.00 ref_freq: 300.00 electric_frequency: 1.86 hall_freq: 0.00 mechanical_freq: 0.37 gear_freq: 0.001860 changing_frequency initial 0
t: 577.00 ref_freq: 300.00 electric_frequency: 1.87 hall_freq: 0.00 mechanical_freq: 0.37 gear_freq: 0.001875 changing_frequency initial 0
t: 590.00 ref_freq: 300.00 electric_frequency: 1.85 hall_freq: 0.00 mechanical_freq: 0.37 gear_freq: 0.001854 changing_frequency initial 0
t: 603.00 ref_freq: 300.00 electric_frequency: 1.96 hall_freq: 0.00 mechanical_freq: 0.39 gear_freq: 0.001958 changing_frequency initial 0
t: 617.00 ref_freq: 300.00 electric_frequency: 1.93 hall_freq: 0.00 mechanical_freq: 0.39 gear_freq: 0.001933 changing_frequency initial 0
t: 630.00 ref_freq: 300.00 electric_frequency: 1.91 hall_freq: 0.00 mechanical_freq: 0.38 gear_freq: 0.001910 changing_frequency initial 0
t: 644.00 ref_freq: 300.00 electric_frequency: 1.87 hall_freq: 0.00 mechanical_freq: 0.37 gear_freq: 0.001869 changing_frequency initial 0
t: 658.00 ref_freq: 300.00 electric_frequency: 1.91 hall_freq: 0.00 mechanical_freq: 0.38 gear_freq: 0.001913 changing_frequency initial 0
t: 672.00 ref_freq: 300.00 electric_frequency: 1.90 hall_freq: 0.00 mechanical_freq: 0.38 gear_freq: 0.001899 changing_frequency initial 0
t: 686.00 ref_freq: 300.00 electric_frequency: 1.88 hall_freq: 0.00 mechanical_freq: 0.38 gear_freq: 0.001877 changing_frequency initial 0
t: 699.00 ref_freq: 300.00 electric_frequency: 1.85 hall_freq: 0.00 mechanical_freq: 0.37 gear_freq: 0.001851 changing_frequency initial 0
t: 712.00 ref_freq: 300.00 electric_frequency: 1.82 hall_freq: 0.00 mechanical_freq: 0.36 gear_freq: 0.001816 changing_frequency initial 0
t: 725.00 ref_freq: 300.00 electric_frequency: 1.78 hall_freq: 0.00 mechanical_freq: 0.36 gear_freq: 0.001778 changing_frequency initial 0
t: 739.00 ref_freq: 300.00 electric_frequency: 1.73 hall_freq: 0.00 mechanical_freq: 0.35 gear_freq: 0.001726 changing_frequency initial 0
t: 751.00 ref_freq: 300.00 electric_frequency: 1.75 hall_freq: 0.00 mechanical_freq: 0.35 gear_freq: 0.001754 changing_frequency initial 0
t: 764.00 ref_freq: 300.00 electric_frequency: 1.67 hall_freq: 0.00 mechanical_freq: 0.33 gear_freq: 0.001674 changing_frequency initial 0
t: 777.00 ref_freq: 300.00 electric_frequency: 1.61 hall_freq: 0.00 mechanical_freq: 0.32 gear_freq: 0.001605 changing_frequency initial 0
t: 791.00 ref_freq: 300.00 electric_frequency: 1.55 hall_freq: 0.00 mechanical_freq: 0.31 gear_freq: 0.001550 changing_frequency initial 0
t: 804.00 ref_freq: 300.00 electric_frequency: 1.43 hall_freq: 0.00 mechanical_freq: 0.29 gear_freq: 0.001433 changing_frequency initial 0
t: 818.00 ref_freq: 300.00 electric_frequency: 1.41 hall_freq: 0.00 mechanical_freq: 0.28 gear_freq: 0.001409 changing_frequency initial 0
t: 832.00 ref_freq: 300.00 electric_frequency: 1.24 hall_freq: 0.00 mechanical_freq: 0.25 gear_freq: 0.001244 changing_frequency initial 0
t: 846.00 ref_freq: 300.00 electric_frequency: 1.18 hall_freq: 0.00 mechanical_freq: 0.24 gear_freq: 0.001178 changing_frequency initial 0
t: 859.00 ref_freq: 300.00 electric_frequency: 1.08 hall_freq: 0.00 mechanical_freq: 0.22 gear_freq: 0.001083 changing_frequency initial 0
t: 873.00 ref_freq: 300.00 electric_frequency: 0.97 hall_freq: 0.00 mechanical_freq: 0.19 gear_freq: 0.000969 changing_frequency initial 0
t: 887.00 ref_freq: 300.00 electric_frequency: 0.83 hall_freq: 0.00 mechanical_freq: 0.17 gear_freq: 0.000826 changing_frequency initial 0
t: 900.00 ref_freq: 300.00 electric_frequency: 0.74 hall_freq: 0.00 mechanical_freq: 0.15 gear_freq: 0.000738 changing_frequency initial 0
t: 914.00 ref_freq: 300.00 electric_frequency: 0.51 hall_freq: 0.00 mechanical_freq: 0.10 gear_freq: 0.000506 changing_frequency initial 0
t: 929.00 ref_freq: 300.00 electric_frequency: 0.40 hall_freq: 0.00 mechanical_freq: 0.08 gear_freq: 0.000397 changing_frequency initial 0
t: 942.00 ref_freq: 300.00 electric_frequency: 0.29 hall_freq: 0.00 mechanical_freq: 0.06 gear_freq: 0.000288 changing_frequency initial 0
t: 956.00 ref_freq: 300.00 electric_frequency: 0.09 hall_freq: 0.00 mechanical_freq: 0.02 gear_freq: 0.000088 changing_frequency initial 0
t: 970.00 ref_freq: 300.00 electric_frequency: -0.13 hall_freq: 0.00 mechanical_freq: -0.03 gear_freq: -0.000133 changing_frequency initial 0
t: 984.00 ref_freq: 300.00 electric_frequency: -0.24 hall_freq: 0.00 mechanical_freq: -0.05 gear_freq: -0.000244 changing_frequency initial 0
t: 998.00 ref_freq: 300.00 electric_frequency: -0.50 hall_freq: 0.00 mechanical_freq: -0.10 gear_freq: -0.000504 changing_frequency initial 0
t: 1012.00 ref_freq: 300.00 electric_frequency: -0.63 hall_freq: 0.00 mechanical_freq: -0.13 gear_freq: -0.000631 changing_frequency initial 0
t: 1026.00 ref_freq: 300.00 electric_frequency: -0.83 hall_freq: 0.00 mechanical_freq: -0.17 gear_freq: -0.000830 changing_frequency initial 0
t: 1041.00 ref_freq: 300.00 electric_frequency: -1.04 hall_freq: 0.00 mechanical_freq: -0.21 gear_freq: -0.001041 changing_frequency initial 0
t: 1054.00 ref_freq: 300.00 electric_frequency: -1.24 hall_freq: 0.00 mechanical_freq: -0.25 gear_freq: -0.001240 changing_frequency initial 0
t: 1067.00 ref_freq: 300.00 electric_frequency: -1.40 hall_freq: 0.00 mechanical_freq: -0.28 gear_freq: -0.001395 changing_frequency initial 0
t: 1081.00 ref_freq: 300.00 electric_frequency: -1.61 hall_freq: 0.00 mechanical_freq: -0.32 gear_freq: -0.001615 changing_frequency initial 0
t: 1094.00 ref_freq: 300.00 electric_frequency: -1.78 hall_freq: 0.00 mechanical_freq: -0.36 gear_freq: -0.001784 changing_frequency initial 0
t: 1108.00 ref_freq: 300.00 electric_frequency: -2.03 hall_freq: 0.00 mechanical_freq: -0.41 gear_freq: -0.002027 changing_frequency initial 0
t: 1121.00 ref_freq: 300.00 electric_frequency: -2.14 hall_freq: 0.00 mechanical_freq: -0.43 gear_freq: -0.002135 changing_frequency initial 0
t: 1134.00 ref_freq: 300.00 electric_frequency: -2.30 hall_freq: 0.00 mechanical_freq: -0.46 gear_freq: -0.002303 changing_frequency initial 0
t: 1147.00 ref_freq: 300.00 electric_frequency: -2.44 hall_freq: 0.00 mechanical_freq: -0.49 gear_freq: -0.002440 changing_frequency initial 0
t: 1161.00 ref_freq: 300.00 electric_frequency: -2.57 hall_freq: 0.00 mechanical_freq: -0.51 gear_freq: -0.002567 changing_frequency initial 0
t: 1174.00 ref_freq: 300.00 electric_frequency: -2.66 hall_freq: 0.00 mechanical_freq: -0.53 gear_freq: -0.002661 changing_frequency initial 0
t: 1187.00 ref_freq: 300.00 electric_frequency: -2.74 hall_freq: 0.00 mechanical_freq: -0.55 gear_freq: -0.002736 changing_frequency initial 0
t: 1200.00 ref_freq: 300.00 electric_frequency: -2.81 hall_freq: 0.00 mechanical_freq: -0.56 gear_freq: -0.002813 changing_frequency initial 0
t: 1213.00 ref_freq: 300.00 electric_frequency: -2.87 hall_freq: 0.00 mechanical_freq: -0.57 gear_freq: -0.002872 changing_frequency initial 0
t: 1226.00 ref_freq: 300.00 electric_frequency: -2.88 hall_freq: 0.00 mechanical_freq: -0.58 gear_freq: -0.002875 changing_frequency initial 0
t: 1239.00 ref_freq: 300.00 electric_frequency: -2.88 hall_freq: 0.00 mechanical_freq: -0.58 gear_freq: -0.002879 changing_frequency initial 0
t: 1252.00 ref_freq: 300.00 electric_frequency: -2.83 hall_freq: 0.00 mechanical_freq: -0.57 gear_freq: -0.002829 changing_frequency initial 0
t: 1265.00 ref_freq: 300.00 electric_frequency: -2.80 hall_freq: 0.00 mechanical_freq: -0.56 gear_freq: -0.002799 changing_frequency initial 0
t: 1278.00 ref_freq: 300.00 electric_frequency: -2.73 hall_freq: 0.00 mechanical_freq: -0.55 gear_freq: -0.002727 changing_frequency initial 0
t: 1291.00 ref_freq: 300.00 electric_frequency: -2.63 hall_freq: 0.00 mechanical_freq: -0.53 gear_freq: -0.002626 changing_frequency initial 0
t: 1305.00 ref_freq: 300.00 electric_frequency: -2.51 hall_freq: 0.00 mechanical_freq: -0.50 gear_freq: -0.002511 changing_frequency initial 0
t: 1318.00 ref_freq: 300.00 electric_frequency: -2.34 hall_freq: 0.00 mechanical_freq: -0.47 gear_freq: -0.002338 changing_frequency initial 0
t: 1331.00 ref_freq: 300.00 electric_frequency: -2.25 hall_freq: 0.00 mechanical_freq: -0.45 gear_freq: -0.002249 changing_frequency initial 0
t: 1344.00 ref_freq: 300.00 electric_frequency: -2.05 hall_freq: 0.00 mechanical_freq: -0.41 gear_freq: -0.002047 changing_frequency initial 0
t: 1358.00 ref_freq: 300.00 electric_frequency: -1.88 hall_freq: 0.00 mechanical_freq: -0.38 gear_freq: -0.001876 changing_frequency initial 0
t: 1372.00 ref_freq: 300.00 electric_frequency: -1.69 hall_freq: 0.00 mechanical_freq: -0.34 gear_freq: -0.001691 changing_frequency initial 0
t: 1386.00 ref_freq: 300.00 electric_frequency: -1.48 hall_freq: 0.00 mechanical_freq: -0.30 gear_freq: -0.001479 changing_frequency initial 0
t: 1399.00 ref_freq: 300.00 electric_frequency: -1.27 hall_freq: 0.00 mechanical_freq: -0.25 gear_freq: -0.001266 changing_frequency initial 0
t: 1413.00 ref_freq: 300.00 electric_frequency: -1.10 hall_freq: 0.00 mechanical_freq: -0.22 gear_freq: -0.001103 changing_frequency initial 0
t: 1426.00 ref_freq: 300.00 electric_frequency: -0.86 hall_freq: 0.00 mechanical_freq: -0.17 gear_freq: -0.000864 changing_frequency initial 0
t: 1440.00 ref_freq: 300.00 electric_frequency: -0.67 hall_freq: 0.00 mechanical_freq: -0.13 gear_freq: -0.000671 changing_frequency initial 0
t: 1454.00 ref_freq: 300.00 electric_frequency: -0.50 hall_freq: 0.00 mechanical_freq: -0.10 gear_freq: -0.000498 changing_frequency initial 0
t: 1467.00 ref_freq: 300.00 electric_frequency: -0.36 hall_freq: 0.00 mechanical_freq: -0.07 gear_freq: -0.000355 changing_frequency initial 0
t: 1480.00 ref_freq: 300.00 electric_frequency: -0.18 hall_freq: 0.00 mechanical_freq: -0.04 gear_freq: -0.000180 changing_frequency initial 0
t: 1494.00 ref_freq: 300.00 electric_frequency: -0.01 hall_freq: 0.00 mechanical_freq: -0.00 gear_freq: -0.000009 changing_frequency initial 0
t: 1507.00 ref_freq: 300.00 electric_frequency: 0.17 hall_freq: 0.00 mechanical_freq: 0.03 gear_freq: 0.000167 changing_frequency initial 0
t: 1520.00 ref_freq: 300.00 electric_frequency: 0.30 hall_freq: 0.00 mechanical_freq: 0.06 gear_freq: 0.000304 changing_frequency initial 0
t: 1533.00 ref_freq: 300.00 electric_frequency: 0.48 hall_freq: 0.00 mechanical_freq: 0.10 gear_freq: 0.000476 changing_frequency initial 0
t: 1546.00 ref_freq: 300.00 electric_frequency: 0.58 hall_freq: 0.00 mechanical_freq: 0.12 gear_freq: 0.000575 changing_frequency initial 0
t: 1559.00 ref_freq: 300.00 electric_frequency: 0.73 hall_freq: 0.00 mechanical_freq: 0.15 gear_freq: 0.000734 changing_frequency initial 0
t: 1572.00 ref_freq: 300.00 electric_frequency: 0.87 hall_freq: 0.00 mechanical_freq: 0.17 gear_freq: 0.000874 changing_frequency initial 0
t: 1585.00 ref_freq: 300.00 electric_frequency: 0.97 hall_freq: 0.00 mechanical_freq: 0.19 gear_freq: 0.000975 changing_frequency initial 0
t: 1598.00 ref_freq: 300.00 electric_frequency: 1.09 hall_freq: 0.00 mechanical_freq: 0.22 gear_freq: 0.001090 changing_frequency initial 0
t: 1611.00 ref_freq: 300.00 electric_frequency: 1.18 hall_freq: 0.00 mechanical_freq: 0.24 gear_freq: 0.001175 changing_frequency initial 0
t: 1624.00 ref_freq: 300.00 electric_frequency: 1.27 hall_freq: 0.00 mechanical_freq: 0.25 gear_freq: 0.001274 changing_frequency initial 0
t: 1636.00 ref_freq: 300.00 electric_frequency: 1.35 hall_freq: 0.00 mechanical_freq: 0.27 gear_freq: 0.001354 changing_frequency initial 0
t: 1649.00 ref_freq: 300.00 electric_frequency: 1.39 hall_freq: 0.00 mechanical_freq: 0.28 gear_freq: 0.001389 changing_frequency initial 0
t: 1662.00 ref_freq: 300.00 electric_frequency: 1.50 hall_freq: 0.00 mechanical_freq: 0.30 gear_freq: 0.001503 changing_frequency initial 0
t: 1675.00 ref_freq: 300.00 electric_frequency: 1.53 hall_freq: 0.00 mechanical_freq: 0.31 gear_freq: 0.001533 changing_frequency initial 0
t: 1688.00 ref_freq: 300.00 electric_frequency: 1.64 hall_freq: 0.00 mechanical_freq: 0.33 gear_freq: 0.001639 changing_frequency initial 0
t: 1701.00 ref_freq: 300.00 electric_frequency: 1.68 hall_freq: 0.00 mechanical_freq: 0.34 gear_freq: 0.001681 changing_frequency initial 0
t: 1714.00 ref_freq: 300.00 electric_frequency: 1.74 hall_freq: 0.00 mechanical_freq: 0.35 gear_freq: 0.001738 changing_frequency initial 0
t: 1727.00 ref_freq: 300.00 electric_frequency: 1.82 hall_freq: 0.00 mechanical_freq: 0.36 gear_freq: 0.001818 changing_frequency initial 0
t: 1740.00 ref_freq: 300.00 electric_frequency: 1.78 hall_freq: 0.00 mechanical_freq: 0.36 gear_freq: 0.001780 changing_frequency initial 0
t: 1753.00 ref_freq: 300.00 electric_frequency: 1.90 hall_freq: 0.00 mechanical_freq: 0.38 gear_freq: 0.001899 changing_frequency initial 0
t: 1766.00 ref_freq: 300.00 electric_frequency: 1.92 hall_freq: 0.00 mechanical_freq: 0.38 gear_freq: 0.001924 changing_frequency initial 0
t: 1780.00 ref_freq: 300.00 electric_frequency: 1.86 hall_freq: 0.00 mechanical_freq: 0.37 gear_freq: 0.001864 changing_frequency initial 0
t: 1794.00 ref_freq: 300.00 electric_frequency: 1.94 hall_freq: 0.00 mechanical_freq: 0.39 gear_freq: 0.001938 changing_frequency initial 0
t: 1808.00 ref_freq: 300.00 electric_frequency: 1.97 hall_freq: 0.00 mechanical_freq: 0.39 gear_freq: 0.001968 changing_frequency initial 0
t: 1821.00 ref_freq: 300.00 electric_frequency: 1.94 hall_freq: 0.00 mechanical_freq: 0.39 gear_freq: 0.001936 changing_frequency initial 0
t: 1834.00 ref_freq: 300.00 electric_frequency: 1.96 hall_freq: 0.00 mechanical_freq: 0.39 gear_freq: 0.001963 changing_frequency initial 0
t: 1848.00 ref_freq: 300.00 electric_frequency: 1.99 hall_freq: 0.00 mechanical_freq: 0.40 gear_freq: 0.001993 changing_frequency initial 0
t: 1862.00 ref_freq: 300.00 electric_frequency: 1.94 hall_freq: 0.00 mechanical_freq: 0.39 gear_freq: 0.001938 changing_frequency initial 0
t: 1876.00 ref_freq: 300.00 electric_frequency: 1.96 hall_freq: 0.00 mechanical_freq: 0.39 gear_freq: 0.001956 changing_frequency initial 0
t: 1890.00 ref_freq: 300.00 electric_frequency: 1.93 hall_freq: 0.00 mechanical_freq: 0.39 gear_freq: 0.001932 changing_frequency initial 0
t: 1903.00 ref_freq: 300.00 electric_frequency: 1.82 hall_freq: 0.00 mechanical_freq: 0.36 gear_freq: 0.001821 changing_frequency initial 0
t: 1917.00 ref_freq: 300.00 electric_frequency: 1.90 hall_freq: 0.00 mechanical_freq: 0.38 gear_freq: 0.001898 changing_frequency initial 0
t: 1931.00 ref_freq: 300.00 electric_frequency: 1.73 hall_freq: 0.00 mechanical_freq: 0.35 gear_freq: 0.001729 changing_frequency initial 0
t: 1945.00 ref_freq: 300.00 electric_frequency: 1.84 hall_freq: 0.00 mechanical_freq: 0.37 gear_freq: 0.001838 changing_frequency initial 0
t: 1959.00 ref_freq: 300.00 electric_frequency: 1.68 hall_freq: 0.00 mechanical_freq: 0.34 gear_freq: 0.001684 changing_frequency initial 0
t: 1973.00 ref_freq: 300.00 electric_frequency: 1.60 hall_freq: 0.00 mechanical_freq: 0.32 gear_freq: 0.001602 changing_frequency initial 0
t: 1987.00 ref_freq: 300.00 electric_frequency: 1.57 hall_freq: 0.00 mechanical_freq: 0.31 gear_freq: 0.001571 changing_frequency initial 0
t: 2001.00 ref_freq: 300.00 electric_frequency: 1.43 hall_freq: 0.00 mechanical_freq: 0.29 gear_freq: 0.001431 changing_frequency initial 0
t: 2015.00 ref_freq: 300.00 electric_frequency: 1.37 hall_freq: 0.00 mechanical_freq: 0.27 gear_freq: 0.001371 changing_frequency initial 0
t: 2029.00 ref_freq: 300.00 electric_frequency: 1.23 hall_freq: 0.00 mechanical_freq: 0.25 gear_freq: 0.001233 changing_frequency initial 0
t: 2043.00 ref_freq: 300.00 electric_frequency: 1.21 hall_freq: 0.00 mechanical_freq: 0.24 gear_freq: 0.001214 changing_frequency initial 0
t: 2056.00 ref_freq: 300.00 electric_frequency: 1.12 hall_freq: 0.00 mechanical_freq: 0.22 gear_freq: 0.001117 changing_frequency initial 0
t: 2069.00 ref_freq: 300.00 electric_frequency: 0.99 hall_freq: 0.00 mechanical_freq: 0.20 gear_freq: 0.000986 changing_frequency initial 0
t: 2082.00 ref_freq: 300.00 electric_frequency: 0.86 hall_freq: 0.00 mechanical_freq: 0.17 gear_freq: 0.000858 changing_frequency initial 0
t: 2095.00 ref_freq: 300.00 electric_frequency: 0.74 hall_freq: 0.00 mechanical_freq: 0.15 gear_freq: 0.000739 changing_frequency initial 0
t: 2108.00 ref_freq: 300.00 electric_frequency: 0.71 hall_freq: 0.00 mechanical_freq: 0.14 gear_freq: 0.000713 changing_frequency initial 0
t: 2121.00 ref_freq: 300.00 electric_frequency: 0.48 hall_freq: 0.00 mechanical_freq: 0.10 gear_freq: 0.000477 changing_frequency initial 0
t: 2134.00 ref_freq: 300.00 electric_frequency: 0.34 hall_freq: 0.00 mechanical_freq: 0.07 gear_freq: 0.000342 changing_frequency initial 0
t: 2148.00 ref_freq: 300.00 electric_frequency: 0.20 hall_freq: 0.00 mechanical_freq: 0.04 gear_freq: 0.000200 changing_frequency initial 0
t: 2161.00 ref_freq: 300.00 electric_frequency: 0.03 hall_freq: 0.00 mechanical_freq: 0.01 gear_freq: 0.000027 changing_frequency initial 0
t: 2175.00 ref_freq: 300.00 electric_frequency: -0.14 hall_freq: 0.00 mechanical_freq: -0.03 gear_freq: -0.000137 changing_frequency initial 0
t: 2189.00 ref_freq: 300.00 electric_frequency: -0.33 hall_freq: 0.00 mechanical_freq: -0.07 gear_freq: -0.000332 changing_frequency initial 0
t: 2203.00 ref_freq: 300.00 electric_frequency: -0.48 hall_freq: 0.00 mechanical_freq: -0.10 gear_freq: -0.000480 changing_frequency initial 0
t: 2230.00 ref_freq: 300.00 electric_frequency: -0.90 hall_freq: 0.00 mechanical_freq: -0.18 gear_freq: -0.000903 changing_frequency initial 0
t: 2244.00 ref_freq: 300.00 electric_frequency: -1.07 hall_freq: 0.00 mechanical_freq: -0.21 gear_freq: -0.001066 changing_frequency initial 0
t: 2257.00 ref_freq: 300.00 electric_frequency: -1.27 hall_freq: 0.00 mechanical_freq: -0.25 gear_freq: -0.001266 changing_frequency initial 0
t: 2271.00 ref_freq: 300.00 electric_frequency: -1.47 hall_freq: 0.00 mechanical_freq: -0.29 gear_freq: -0.001474 changing_frequency initial 0
t: 2285.00 ref_freq: 300.00 electric_frequency: -1.67 hall_freq: 0.00 mechanical_freq: -0.33 gear_freq: -0.001670 changing_frequency initial 0
t: 2300.00 ref_freq: 300.00 electric_frequency: -1.86 hall_freq: 0.00 mechanical_freq: -0.37 gear_freq: -0.001855 changing_frequency initial 0
t: 2314.00 ref_freq: 300.00 electric_frequency: -2.09 hall_freq: 0.00 mechanical_freq: -0.42 gear_freq: -0.002093 changing_frequency initial 0
t: 2328.00 ref_freq: 300.00 electric_frequency: -2.24 hall_freq: 0.00 mechanical_freq: -0.45 gear_freq: -0.002236 changing_frequency initial 0
t: 2341.00 ref_freq: 300.00 electric_frequency: -2.37 hall_freq: 0.00 mechanical_freq: -0.47 gear_freq: -0.002373 changing_frequency initial 0
t: 2354.00 ref_freq: 300.00 electric_frequency: -2.53 hall_freq: 0.00 mechanical_freq: -0.51 gear_freq: -0.002534 changing_frequency initial 0
t: 2368.00 ref_freq: 300.00 electric_frequency: -2.63 hall_freq: 0.00 mechanical_freq: -0.53 gear_freq: -0.002628 changing_frequency initial 0
t: 2382.00 ref_freq: 300.00 electric_frequency: -2.70 hall_freq: 0.00 mechanical_freq: -0.54 gear_freq: -0.002695 changing_frequency initial 0
t: 2396.00 ref_freq: 300.00 electric_frequency: -2.82 hall_freq: 0.00 mechanical_freq: -0.56 gear_freq: -0.002819 changing_frequency initial 0
t: 2410.00 ref_freq: 300.00 electric_frequency: -2.85 hall_freq: 0.00 mechanical_freq: -0.57 gear_freq: -0.002849 changing_frequency initial 0
t: 2424.00 ref_freq: 300.00 electric_frequency: -2.83 hall_freq: 0.00 mechanical_freq: -0.57 gear_freq: -0.002826 changing_frequency initial 0
t: 2438.00 ref_freq: 300.00 electric_frequency: -2.87 hall_freq: 0.00 mechanical_freq: -0.57 gear_freq: -0.002865 changing_frequency initial 0
t: 2452.00 ref_freq: 300.00 electric_frequency: -2.81 hall_freq: 0.00 mechanical_freq: -0.56 gear_freq: -0.002807 changing_frequency initial 0
t: 2466.00 ref_freq: 300.00 electric_frequency: -2.81 hall_freq: 0.00 mechanical_freq: -0.56 gear_freq: -0.002806 changing_frequency initial 0
t: 2480.00 ref_freq: 300.00 electric_frequency: -2.72 hall_freq: 0.00 mechanical_freq: -0.54 gear_freq: -0.002723 changing_frequency initial 0
t: 2495.00 ref_freq: 300.00 electric_frequency: -2.55 hall_freq: 0.00 mechanical_freq: -0.51 gear_freq: -0.002554 changing_frequency initial 0
t: 2509.00 ref_freq: 300.00 electric_frequency: -2.47 hall_freq: 0.00 mechanical_freq: -0.49 gear_freq: -0.002469 changing_frequency initial 0
t: 2523.00 ref_freq: 300.00 electric_frequency: -2.27 hall_freq: 0.00 mechanical_freq: -0.45 gear_freq: -0.002266 changing_frequency initial 0
t: 2550.00 ref_freq: 300.00 electric_frequency: -1.99 hall_freq: 0.00 mechanical_freq: -0.40 gear_freq: -0.001994 changing_frequency initial 0
t: 2563.00 ref_freq: 300.00 electric_frequency: -1.77 hall_freq: 0.00 mechanical_freq: -0.35 gear_freq: -0.001769 changing_frequency initial 0
t: 2577.00 ref_freq: 300.00 electric_frequency: -1.61 hall_freq: 0.00 mechanical_freq: -0.32 gear_freq: -0.001615 changing_frequency initial 0
t: 2591.00 ref_freq: 300.00 electric_frequency: -1.37 hall_freq: 0.00 mechanical_freq: -0.27 gear_freq: -0.001373 changing_frequency initial 0
t: 2604.00 ref_freq: 300.00 electric_frequency: -1.26 hall_freq: 0.00 mechanical_freq: -0.25 gear_freq: -0.001264 changing_frequency initial 0
t: 2617.00 ref_freq: 300.00 electric_frequency: -1.01 hall_freq: 0.00 mechanical_freq: -0.20 gear_freq: -0.001014 changing_frequency initial 0
t: 2630.00 ref_freq: 300.00 electric_frequency: -0.84 hall_freq: 0.00 mechanical_freq: -0.17 gear_freq: -0.000845 changing_frequency initial 0
t: 2643.00 ref_freq: 300.00 electric_frequency: -0.65 hall_freq: 0.00 mechanical_freq: -0.13 gear_freq: -0.000654 changing_frequency initial 0
t: 2656.00 ref_freq: 300.00 electric_frequency: -0.50 hall_freq: 0.00 mechanical_freq: -0.10 gear_freq: -0.000495 changing_frequency initial 0
t: 2670.00 ref_freq: 300.00 electric_frequency: -0.26 hall_freq: 0.00 mechanical_freq: -0.05 gear_freq: -0.000258 changing_frequency initial 0
t: 2683.00 ref_freq: 300.00 electric_frequency: -0.16 hall_freq: 0.00 mechanical_freq: -0.03 gear_freq: -0.000161 changing_frequency initial 0
t: 2696.00 ref_freq: 300.00 electric_frequency: 0.07 hall_freq: 0.00 mechanical_freq: 0.01 gear_freq: 0.000070 changing_frequency initial 0
t: 2710.00 ref_freq: 300.00 electric_frequency: 0.21 hall_freq: 0.00 mechanical_freq: 0.04 gear_freq: 0.000210 changing_frequency initial 0
t: 2725.00 ref_freq: 300.00 electric_frequency: 0.39 hall_freq: 0.00 mechanical_freq: 0.08 gear_freq: 0.000391 changing_frequency initial 0
t: 2738.00 ref_freq: 300.00 electric_frequency: 0.51 hall_freq: 0.00 mechanical_freq: 0.10 gear_freq: 0.000513 changing_frequency initial 0
t: 2751.00 ref_freq: 300.00 electric_frequency: 0.68 hall_freq: 0.00 mechanical_freq: 0.14 gear_freq: 0.000683 changing_frequency initial 0
t: 2764.00 ref_freq: 300.00 electric_frequency: 0.78 hall_freq: 0.00 mechanical_freq: 0.16 gear_freq: 0.000782 changing_frequency initial 0
t: 2776.00 ref_freq: 300.00 electric_frequency: 0.85 hall_freq: 0.00 mechanical_freq: 0.17 gear_freq: 0.000847 changing_frequency initial 0
t: 2789.00 ref_freq: 300.00 electric_frequency: 1.00 hall_freq: 0.00 mechanical_freq: 0.20 gear_freq: 0.000999 changing_frequency initial 0
t: 2802.00 ref_freq: 300.00 electric_frequency: 1.12 hall_freq: 0.00 mechanical_freq: 0.22 gear_freq: 0.001120 changing_frequency initial 0
t: 2815.00 ref_freq: 300.00 electric_frequency: 1.23 hall_freq: 0.00 mechanical_freq: 0.25 gear_freq: 0.001226 changing_frequency initial 0
t: 2829.00 ref_freq: 300.00 electric_frequency: 1.32 hall_freq: 0.00 mechanical_freq: 0.26 gear_freq: 0.001323 changing_frequency initial 0
t: 2842.00 ref_freq: 300.00 electric_frequency: 1.41 hall_freq: 0.00 mechanical_freq: 0.28 gear_freq: 0.001410 changing_frequency initial 0
t: 2856.00 ref_freq: 300.00 electric_frequency: 1.50 hall_freq: 0.00 mechanical_freq: 0.30 gear_freq: 0.001500 changing_frequency initial 0
t: 2870.00 ref_freq: 300.00 electric_frequency: 1.57 hall_freq: 0.00 mechanical_freq: 0.31 gear_freq: 0.001572 changing_frequency initial 0
t: 2883.00 ref_freq: 300.00 electric_frequency: 1.64 hall_freq: 0.00 mechanical_freq: 0.33 gear_freq: 0.001637 changing_frequency initial 0
t: 2896.00 ref_freq: 300.00 electric_frequency: 1.68 hall_freq: 0.00 mechanical_freq: 0.34 gear_freq: 0.001683 changing_frequency initial 0
t: 2909.00 ref_freq: 300.00 electric_frequency: 1.76 hall_freq: 0.00 mechanical_freq: 0.35 gear_freq: 0.001758 changing_frequency initial 0
t: 2922.00 ref_freq: 300.00 electric_frequency: 1.80 hall_freq: 0.00 mechanical_freq: 0.36 gear_freq: 0.001802 changing_frequency initial 0
t: 2935.00 ref_freq: 300.00 electric_frequency: 1.80 hall_freq: 0.00 mechanical_freq: 0.36 gear_freq: 0.001797 changing_frequency initial 0
t: 2949.00 ref_freq: 300.00 electric_frequency: 1.88 hall_freq: 0.00 mechanical_freq: 0.38 gear_freq: 0.001876 changing_frequency initial 0
t: 2963.00 ref_freq: 300.00 electric_frequency: 1.84 hall_freq: 0.00 mechanical_freq: 0.37 gear_freq: 0.001837 changing_frequency initial 0
t: 2976.00 ref_freq: 300.00 electric_frequency: 1.96 hall_freq: 0.00 mechanical_freq: 0.39 gear_freq: 0.001955 changing_frequency initial 0
t: 2989.00 ref_freq: 300.00 electric_frequency: 1.87 hall_freq: 0.00 mechanical_freq: 0.37 gear_freq: 0.001871 changing_frequency initial 0
t: 3002.00 ref_freq: 300.00 electric_frequency: 1.99 hall_freq: 0.00 mechanical_freq: 0.40 gear_freq: 0.001988 changing_frequency initial 0
t: 3015.00 ref_freq: 300.00 electric_frequency: 1.96 hall_freq: 0.00 mechanical_freq: 0.39 gear_freq: 0.001963 changing_frequency initial 0
t: 3028.00 ref_freq: 300.00 electric_frequency: 1.95 hall_freq: 0.00 mechanical_freq: 0.39 gear_freq: 0.001948 changing_frequency initial 0
t: 3041.00 ref_freq: 300.00 electric_frequency: 2.02 hall_freq: 0.00 mechanical_freq: 0.40 gear_freq: 0.002016 changing_frequency initial 0
t: 3054.00 ref_freq: 300.00 electric_frequency: 1.95 hall_freq: 0.00 mechanical_freq: 0.39 gear_freq: 0.001950 changing_frequency initial 0
t: 3068.00 ref_freq: 300.00 electric_frequency: 1.96 hall_freq: 0.00 mechanical_freq: 0.39 gear_freq: 0.001955 changing_frequency initial 0
t: 3081.00 ref_freq: 300.00 electric_frequency: 1.92 hall_freq: 0.00 mechanical_freq: 0.38 gear_freq: 0.001921 changing_frequency initial 0
t: 3094.00 ref_freq: 300.00 electric_frequency: 1.89 hall_freq: 0.00 mechanical_freq: 0.38 gear_freq: 0.001891 changing_frequency initial 0
t: 3107.00 ref_freq: 300.00 electric_frequency: 1.89 hall_freq: 0.00 mechanical_freq: 0.38 gear_freq: 0.001895 changing_frequency initial 0
t: 3120.00 ref_freq: 300.00 electric_frequency: 1.83 hall_freq: 0.00 mechanical_freq: 0.37 gear_freq: 0.001825 changing_frequency initial 0
t: 3133.00 ref_freq: 300.00 electric_frequency: 1.80 hall_freq: 0.00 mechanical_freq: 0.36 gear_freq: 0.001802 changing_frequency initial 0
t: 3146.00 ref_freq: 300.00 electric_frequency: 1.77 hall_freq: 0.00 mechanical_freq: 0.35 gear_freq: 0.001765 changing_frequency initial 0
t: 3160.00 ref_freq: 300.00 electric_frequency: 1.67 hall_freq: 0.00 mechanical_freq: 0.33 gear_freq: 0.001675 changing_frequency initial 0
t: 3173.00 ref_freq: 300.00 electric_frequency: 1.62 hall_freq: 0.00 mechanical_freq: 0.32 gear_freq: 0.001621 changing_frequency initial 0
t: 3187.00 ref_freq: 300.00 electric_frequency: 1.53 hall_freq: 0.00 mechanical_freq: 0.31 gear_freq: 0.001533 changing_frequency initial 0
t: 3200.00 ref_freq: 300.00 electric_frequency: 1.47 hall_freq: 0.00 mechanical_freq: 0.29 gear_freq: 0.001466 changing_frequency initial 0
t: 3213.00 ref_freq: 300.00 electric_frequency: 1.45 hall_freq: 0.00 mechanical_freq: 0.29 gear_freq: 0.001447 changing_frequency initial 0
t: 3226.00 ref_freq: 300.00 electric_frequency: 1.33 hall_freq: 0.00 mechanical_freq: 0.27 gear_freq: 0.001327 changing_frequency initial 0
t: 3239.00 ref_freq: 300.00 electric_frequency: 1.23 hall_freq: 0.00 mechanical_freq: 0.25 gear_freq: 0.001231 changing_frequency initial 0
t: 3252.00 ref_freq: 300.00 electric_frequency: 1.16 hall_freq: 0.00 mechanical_freq: 0.23 gear_freq: 0.001155 changing_frequency initial 0
t: 3266.00 ref_freq: 300.00 electric_frequency: 1.01 hall_freq: 0.00 mechanical_freq: 0.20 gear_freq: 0.001011 changing_frequency initial 0
t: 3280.00 ref_freq: 300.00 electric_frequency: 0.89 hall_freq: 0.00 mechanical_freq: 0.18 gear_freq: 0.000889 changing_frequency initial 0
t: 3293.00 ref_freq: 300.00 electric_frequency: 0.81 hall_freq: 0.00 mechanical_freq: 0.16 gear_freq: 0.000808 changing_frequency initial 0
t: 3308.00 ref_freq: 300.00 electric_frequency: 0.64 hall_freq: 0.00 mechanical_freq: 0.13 gear_freq: 0.000639 changing_frequency initial 0
t: 3322.00 ref_freq: 300.00 electric_frequency: 0.52 hall_freq: 0.00 mechanical_freq: 0.10 gear_freq: 0.000523 changing_frequency initial 0
t: 3337.00 ref_freq: 300.00 electric_frequency: 0.33 hall_freq: 0.00 mechanical_freq: 0.07 gear_freq: 0.000327 changing_frequency initial 0
t: 3351.00 ref_freq: 300.00 electric_frequency: 0.17 hall_freq: 0.00 mechanical_freq: 0.03 gear_freq: 0.000173 changing_frequency initial 0
t: 3366.00 ref_freq: 300.00 electric_frequency: -0.01 hall_freq: 0.00 mechanical_freq: -0.00 gear_freq: -0.000009 changing_frequency initial 0
t: 3380.00 ref_freq: 300.00 electric_frequency: -0.20 hall_freq: 0.00 mechanical_freq: -0.04 gear_freq: -0.000195 changing_frequency initial 0
t: 3394.00 ref_freq: 300.00 electric_frequency: -0.39 hall_freq: 0.00 mechanical_freq: -0.08 gear_freq: -0.000395 changing_frequency initial 0
t: 3408.00 ref_freq: 300.00 electric_frequency: -0.56 hall_freq: 0.00 mechanical_freq: -0.11 gear_freq: -0.000560 changing_frequency initial 0
t: 3421.00 ref_freq: 300.00 electric_frequency: -0.74 hall_freq: 0.00 mechanical_freq: -0.15 gear_freq: -0.000735 changing_frequency initial 0
t: 3435.00 ref_freq: 300.00 electric_frequency: -0.95 hall_freq: 0.00 mechanical_freq: -0.19 gear_freq: -0.000947 changing_frequency initial 0
t: 3448.00 ref_freq: 300.00 electric_frequency: -1.12 hall_freq: 0.00 mechanical_freq: -0.22 gear_freq: -0.001121 changing_frequency initial 0
t: 3461.00 ref_freq: 300.00 electric_frequency: -1.34 hall_freq: 0.00 mechanical_freq: -0.27 gear_freq: -0.001344 changing_frequency initial 0
t: 3475.00 ref_freq: 300.00 electric_frequency: -1.51 hall_freq: 0.00 mechanical_freq: -0.30 gear_freq: -0.001511 changing_frequency initial 0
t: 3488.00 ref_freq: 300.00 electric_frequency: -1.69 hall_freq: 0.00 mechanical_freq: -0.34 gear_freq: -0.001691 changing_frequency initial 0
t: 3501.00 ref_freq: 300.00 electric_frequency: -1.89 hall_freq: 0.00 mechanical_freq: -0.38 gear_freq: -0.001886 changing_frequency initial 0
t: 3515.00 ref_freq: 300.00 electric_frequency: -2.02 hall_freq: 0.00 mechanical_freq: -0.40 gear_freq: -0.002018 changing_frequency initial 0
t: 3528.00 ref_freq: 300.00 electric_frequency: -2.20 hall_freq: 0.00 mechanical_freq: -0.44 gear_freq: -0.002201 changing_frequency initial 0
t: 3541.00 ref_freq: 300.00 electric_frequency: -2.37 hall_freq: 0.00 mechanical_freq: -0.47 gear_freq: -0.002365 changing_frequency initial 0
t: 3555.00 ref_freq: 300.00 electric_frequency: -2.53 hall_freq: 0.00 mechanical_freq: -0.51 gear_freq: -0.002529 changing_frequency initial 0
t: 3569.00 ref_freq: 300.00 electric_frequency: -2.66 hall_freq: 0.00 mechanical_freq: -0.53 gear_freq: -0.002660 changing_frequency initial 0
t: 3582.00 ref_freq: 300.00 electric_frequency: -2.66 hall_freq: 0.00 mechanical_freq: -0.53 gear_freq: -0.002660 changing_frequency initial 0
t: 3596.00 ref_freq: 300.00 electric_frequency: -2.73 hall_freq: 0.00 mechanical_freq: -0.55 gear_freq: -0.002727 changing_frequency initial 0
t: 3610.00 ref_freq: 300.00 electric_frequency: -2.81 hall_freq: 0.00 mechanical_freq: -0.56 gear_freq: -0.002807 changing_frequency initial 0
t: 3624.00 ref_freq: 300.00 electric_frequency: -2.88 hall_freq: 0.00 mechanical_freq: -0.58 gear_freq: -0.002881 changing_frequency initial 0
t: 3638.00 ref_freq: 300.00 electric_frequency: -2.88 hall_freq: 0.00 mechanical_freq: -0.58 gear_freq: -0.002876 changing_frequency initial 0
t: 3652.00 ref_freq: 300.00 electric_frequency: -2.85 hall_freq: 0.00 mechanical_freq: -0.57 gear_freq: -0.002850 changing_frequency initial 0
t: 3666.00 ref_freq: 300.00 electric_frequency: -2.73 hall_freq: 0.00 mechanical_freq: -0.55 gear_freq: -0.002731 changing_frequency initial 0
t: 3680.00 ref_freq: 300.00 electric_frequency: -2.70 hall_freq: 0.00 mechanical_freq: -0.54 gear_freq: -0.002698 changing_frequency initial 0
t: 3695.00 ref_freq: 300.00 electric_frequency: -2.58 hall_freq: 0.00 mechanical_freq: -0.52 gear_freq: -0.002583 changing_frequency initial 0
t: 3710.00 ref_freq: 300.00 electric_frequency: -2.39 hall_freq: 0.00 mechanical_freq: -0.48 gear_freq: -0.002395 changing_frequency initial 0
t: 3724.00 ref_freq: 300.00 electric_frequency: -2.23 hall_freq: 0.00 mechanical_freq: -0.45 gear_freq: -0.002231 changing_frequency initial 0
t: 3738.00 ref_freq: 300.00 electric_frequency: -2.06 hall_freq: 0.00 mechanical_freq: -0.41 gear_freq: -0.002060 changing_frequency initial 0
t: 3752.00 ref_freq: 300.00 electric_frequency: -1.92 hall_freq: 0.00 mechanical_freq: -0.38 gear_freq: -0.001918 changing_frequency initial 0
t: 3765.00 ref_freq: 300.00 electric_frequency: -1.75 hall_freq: 0.00 mechanical_freq: -0.35 gear_freq: -0.001749 changing_frequency initial 0
t: 3780.00 ref_freq: 300.00 electric_frequency: -1.59 hall_freq: 0.00 mechanical_freq: -0.32 gear_freq: -0.001591 changing_frequency initial 0
t: 3794.00 ref_freq: 300.00 electric_frequency: -1.32 hall_freq: 0.00 mechanical_freq: -0.26 gear_freq: -0.001324 changing_frequency initial 0
t: 3808.00 ref_freq: 300.00 electric_frequency: -1.13 hall_freq: 0.00 mechanical_freq: -0.23 gear_freq: -0.001129 changing_frequency initial 0
t: 3821.00 ref_freq: 300.00 electric_frequency: -0.98 hall_freq: 0.00 mechanical_freq: -0.20 gear_freq: -0.000978 changing_frequency initial 0
t: 3834.00 ref_freq: 300.00 electric_frequency: -0.76 hall_freq: 0.00 mechanical_freq: -0.15 gear_freq: -0.000758 changing_frequency initial 0
t: 3848.00 ref_freq: 300.00 electric_frequency: -0.56 hall_freq: 0.00 mechanical_freq: -0.11 gear_freq: -0.000565 changing_frequency initial 0
t: 3861.00 ref_freq: 300.00 electric_frequency: -0.42 hall_freq: 0.00 mechanical_freq: -0.08 gear_freq: -0.000425 changing_frequency initial 0
t: 3874.00 ref_freq: 300.00 electric_frequency: -0.23 hall_freq: 0.00 mechanical_freq: -0.05 gear_freq: -0.000232 changing_frequency initial 0
t: 3886.00 ref_freq: 300.00 electric_frequency: -0.10 hall_freq: 0.00 mechanical_freq: -0.02 gear_freq: -0.000097 changing_frequency initial 0
t: 3899.00 ref_freq: 300.00 electric_frequency: 0.07 hall_freq: 0.00 mechanical_freq: 0.01 gear_freq: 0.000065 changing_frequency initial 0
t: 3912.00 ref_freq: 300.00 electric_frequency: 0.24 hall_freq: 0.00 mechanical_freq: 0.05 gear_freq: 0.000243 changing_frequency initial 0
t: 3925.00 ref_freq: 300.00 electric_frequency: 0.38 hall_freq: 0.00 mechanical_freq: 0.08 gear_freq: 0.000385 changing_frequency initial 0
t: 3938.00 ref_freq: 300.00 electric_frequency: 0.54 hall_freq: 0.00 mechanical_freq: 0.11 gear_freq: 0.000539 changing_frequency initial 0
t: 3951.00 ref_freq: 300.00 electric_frequency: 0.64 hall_freq: 0.00 mechanical_freq: 0.13 gear_freq: 0.000637 changing_frequency initial 0
t: 3964.00 ref_freq: 300.00 electric_frequency: 0.77 hall_freq: 0.00 mechanical_freq: 0.15 gear_freq: 0.000774 changing_frequency initial 0
t: 3976.00 ref_freq: 300.00 electric_frequency: 0.89 hall_freq: 0.00 mechanical_freq: 0.18 gear_freq: 0.000887 changing_frequency initial 0
t: 3989.00 ref_freq: 300.00 electric_frequency: 1.01 hall_freq: 0.00 mechanical_freq: 0.20 gear_freq: 0.001012 changing_frequency initial 0
t: 4002.00 ref_freq: 300.00 electric_frequency: 1.10 hall_freq: 0.00 mechanical_freq: 0.22 gear_freq: 0.001102 changing_frequency initial 0
t: 4015.00 ref_freq: 300.00 electric_frequency: 1.24 hall_freq: 0.00 mechanical_freq: 0.25 gear_freq: 0.001239 changing_frequency initial 0
t: 4028.00 ref_freq: 300.00 electric_frequency: 1.29 hall_freq: 0.00 mechanical_freq: 0.26 gear_freq: 0.001294 changing_frequency initial 0
t: 4041.00 ref_freq: 300.00 electric_frequency: 1.42 hall_freq: 0.00 mechanical_freq: 0.28 gear_freq: 0.001421 changing_frequency initial 0
t: 4055.00 ref_freq: 300.00 electric_frequency: 1.49 hall_freq: 0.00 mechanical_freq: 0.30 gear_freq: 0.001494 changing_frequency initial 0
t: 4068.00 ref_freq: 300.00 electric_frequency: 1.58 hall_freq: 0.00 mechanical_freq: 0.32 gear_freq: 0.001580 changing_frequency initial 0
t: 4080.00 ref_freq: 300.00 electric_frequency: 1.60 hall_freq: 0.00 mechanical_freq: 0.32 gear_freq: 0.001599 changing_frequency initial 0
t: 4094.00 ref_freq: 300.00 electric_frequency: 1.65 hall_freq: 0.00 mechanical_freq: 0.33 gear_freq: 0.001653 changing_frequency initial 0
t: 4107.00 ref_freq: 300.00 electric_frequency: 1.73 hall_freq: 0.00 mechanical_freq: 0.35 gear_freq: 0.001734 changing_frequency initial 0
t: 4121.00 ref_freq: 300.00 electric_frequency: 1.77 hall_freq: 0.00 mechanical_freq: 0.35 gear_freq: 0.001769 changing_frequency initial 0
t: 4134.00 ref_freq: 300.00 electric_frequency: 1.81 hall_freq: 0.00 mechanical_freq: 0.36 gear_freq: 0.001814 changing_frequency initial 0
t: 4148.00 ref_freq: 300.00 electric_frequency: 1.86 hall_freq: 0.00 mechanical_freq: 0.37 gear_freq: 0.001860 changing_frequency initial 0
t: 4162.00 ref_freq: 300.00 electric_frequency: 1.88 hall_freq: 0.00 mechanical_freq: 0.38 gear_freq: 0.001875 changing_frequency initial 0
t: 4176.00 ref_freq: 300.00 electric_frequency: 1.86 hall_freq: 0.00 mechanical_freq: 0.37 gear_freq: 0.001864 changing_frequency initial 0
t: 4190.00 ref_freq: 300.00 electric_frequency: 1.99 hall_freq: 0.00 mechanical_freq: 0.40 gear_freq: 0.001986 changing_frequency initial 0
t: 4204.00 ref_freq: 300.00 electric_frequency: 1.99 hall_freq: 0.00 mechanical_freq: 0.40 gear_freq: 0.001988 changing_frequency initial 0
t: 4217.00 ref_freq: 300.00 electric_frequency: 1.99 hall_freq: 0.00 mechanical_freq: 0.40 gear_freq: 0.001993 changing_frequency initial 0
t: 4230.00 ref_freq: 300.00 electric_frequency: 1.97 hall_freq: 0.00 mechanical_freq: 0.39 gear_freq: 0.001966 changing_frequency initial 0
t: 4244.00 ref_freq: 300.00 electric_frequency: 1.96 hall_freq: 0.00 mechanical_freq: 0.39 gear_freq: 0.001958 changing_frequency initial 0
t: 4259.00 ref_freq: 300.00 electric_frequency: 1.94 hall_freq: 0.00 mechanical_freq: 0.39 gear_freq: 0.001937 changing_frequency initial 0
t: 4274.00 ref_freq: 300.00 electric_frequency: 1.93 hall_freq: 0.00 mechanical_freq: 0.39 gear_freq: 0.001934 changing_frequency initial 0
t: 4289.00 ref_freq: 300.00 electric_frequency: 1.92 hall_freq: 0.00 mechanical_freq: 0.38 gear_freq: 0.001920 changing_frequency initial 0
t: 4304.00 ref_freq: 300.00 electric_frequency: 1.86 hall_freq: 0.00 mechanical_freq: 0.37 gear_freq: 0.001860 changing_frequency initial 0
t: 4318.00 ref_freq: 300.00 electric_frequency: 1.86 hall_freq: 0.00 mechanical_freq: 0.37 gear_freq: 0.001865 changing_frequency initial 0
t: 4333.00 ref_freq: 300.00 electric_frequency: 1.81 hall_freq: 0.00 mechanical_freq: 0.36 gear_freq: 0.001809 changing_frequency initial 0
t: 4347.00 ref_freq: 300.00 electric_frequency: 1.72 hall_freq: 0.00 mechanical_freq: 0.34 gear_freq: 0.001724 changing_frequency initial 0
t: 4361.00 ref_freq: 300.00 electric_frequency: 1.66 hall_freq: 0.00 mechanical_freq: 0.33 gear_freq: 0.001661 changing_frequency initial 0
t: 4375.00 ref_freq: 300.00 electric_frequency: 1.62 hall_freq: 0.00 mechanical_freq: 0.32 gear_freq: 0.001625 changing_frequency initial 0
t: 4389.00 ref_freq: 300.00 electric_frequency: 1.54 hall_freq: 0.00 mechanical_freq: 0.31 gear_freq: 0.001542 changing_frequency initial 0
t: 4403.00 ref_freq: 300.00 electric_frequency: 1.47 hall_freq: 0.00 mechanical_freq: 0.29 gear_freq: 0.001466 changing_frequency initial 0
t: 4417.00 ref_freq: 300.00 electric_frequency: 1.39 hall_freq: 0.00 mechanical_freq: 0.28 gear_freq: 0.001386 changing_frequency initial 0
t: 4431.00 ref_freq: 300.00 electric_frequency: 1.29 hall_freq: 0.00 mechanical_freq: 0.26 gear_freq: 0.001289 changing_frequency initial 0
t: 4445.00 ref_freq: 300.00 electric_frequency: 1.18 hall_freq: 0.00 mechanical_freq: 0.24 gear_freq: 0.001176 changing_frequency initial 0
t: 4459.00 ref_freq: 300.00 electric_frequency: 1.06 hall_freq: 0.00 mechanical_freq: 0.21 gear_freq: 0.001065 changing_frequency initial 0
t: 4474.00 ref_freq: 300.00 electric_frequency: 0.96 hall_freq: 0.00 mechanical_freq: 0.19 gear_freq: 0.000960 changing_frequency initial 0
t: 4489.00 ref_freq: 300.00 electric_frequency: 0.83 hall_freq: 0.00 mechanical_freq: 0.17 gear_freq: 0.000830 changing_frequency initial 0
t: 4502.00 ref_freq: 300.00 electric_frequency: 0.68 hall_freq: 0.00 mechanical_freq: 0.14 gear_freq: 0.000678 changing_frequency initial 0
t: 4515.00 ref_freq: 300.00 electric_frequency: 0.61 hall_freq: 0.00 mechanical_freq: 0.12 gear_freq: 0.000605 changing_frequency initial 0
t: 4529.00 ref_freq: 300.00 electric_frequency: 0.43 hall_freq: 0.00 mechanical_freq: 0.09 gear_freq: 0.000435 changing_frequency initial 0
t: 4543.00 ref_freq: 300.00 electric_frequency: 0.27 hall_freq: 0.00 mechanical_freq: 0.05 gear_freq: 0.000271 changing_frequency initial 0
t: 4558.00 ref_freq: 300.00 electric_frequency: 0.09 hall_freq: 0.00 mechanical_freq: 0.02 gear_freq: 0.000089 changing_frequency initial 0
t: 4573.00 ref_freq: 300.00 electric_frequency: -0.10 hall_freq: 0.00 mechanical_freq: -0.02 gear_freq: -0.000098 changing_frequency initial 0
t: 4588.00 ref_freq: 300.00 electric_frequency: -0.28 hall_freq: 0.00 mechanical_freq: -0.06 gear_freq: -0.000282 changing_frequency initial 0
t: 4603.00 ref_freq: 300.00 electric_frequency: -0.46 hall_freq: 0.00 mechanical_freq: -0.09 gear_freq: -0.000457 changing_frequency initial 0
t: 4617.00 ref_freq: 300.00 electric_frequency: -0.72 hall_freq: 0.00 mechanical_freq: -0.14 gear_freq: -0.000716 changing_frequency initial 0
t: 4631.00 ref_freq: 300.00 electric_frequency: -0.87 hall_freq: 0.00 mechanical_freq: -0.17 gear_freq: -0.000865 changing_frequency initial 0
t: 4646.00 ref_freq: 300.00 electric_frequency: -1.12 hall_freq: 0.00 mechanical_freq: -0.22 gear_freq: -0.001117 changing_frequency initial 0
t: 4660.00 ref_freq: 300.00 electric_frequency: -1.36 hall_freq: 0.00 mechanical_freq: -0.27 gear_freq: -0.001361 changing_frequency initial 0
t: 4675.00 ref_freq: 300.00 electric_frequency: -1.51 hall_freq: 0.00 mechanical_freq: -0.30 gear_freq: -0.001510 changing_frequency initial 0
t: 4689.00 ref_freq: 300.00 electric_frequency: -1.76 hall_freq: 0.00 mechanical_freq: -0.35 gear_freq: -0.001759 changing_frequency initial 0
t: 4703.00 ref_freq: 300.00 electric_frequency: -1.92 hall_freq: 0.00 mechanical_freq: -0.38 gear_freq: -0.001916 changing_frequency initial 0
t: 4717.00 ref_freq: 300.00 electric_frequency: -2.07 hall_freq: 0.00 mechanical_freq: -0.41 gear_freq: -0.002073 changing_frequency initial 0
t: 4731.00 ref_freq: 300.00 electric_frequency: -2.25 hall_freq: 0.00 mechanical_freq: -0.45 gear_freq: -0.002246 changing_frequency initial 0
t: 4745.00 ref_freq: 300.00 electric_frequency: -2.42 hall_freq: 0.00 mechanical_freq: -0.48 gear_freq: -0.002423 changing_frequency initial 0
t: 4759.00 ref_freq: 300.00 electric_frequency: -2.57 hall_freq: 0.00 mechanical_freq: -0.51 gear_freq: -0.002572 changing_frequency initial 0
t: 4773.00 ref_freq: 300.00 electric_frequency: -2.72 hall_freq: 0.00 mechanical_freq: -0.54 gear_freq: -0.002716 changing_frequency initial 0
t: 4786.00 ref_freq: 300.00 electric_frequency: -2.75 hall_freq: 0.00 mechanical_freq: -0.55 gear_freq: -0.002752 changing_frequency initial 0
t: 4799.00 ref_freq: 300.00 electric_frequency: -2.84 hall_freq: 0.00 mechanical_freq: -0.57 gear_freq: -0.002840 changing_frequency initial 0
t: 4813.00 ref_freq: 300.00 electric_frequency: -2.91 hall_freq: 0.00 mechanical_freq: -0.58 gear_freq: -0.002905 changing_frequency initial 0
t: 4827.00 ref_freq: 300.00 electric_frequency: -2.84 hall_freq: 0.00 mechanical_freq: -0.57 gear_freq: -0.002840 changing_frequency initial 0
t: 4841.00 ref_freq: 300.00 electric_frequency: -2.85 hall_freq: 0.00 mechanical_freq: -0.57 gear_freq: -0.002853 changing_frequency initial 0
t: 4855.00 ref_freq: 300.00 electric_frequency: -2.84 hall_freq: 0.00 mechanical_freq: -0.57 gear_freq: -0.002843 changing_frequency initial 0
t: 4869.00 ref_freq: 300.00 electric_frequency: -2.78 hall_freq: 0.00 mechanical_freq: -0.56 gear_freq: -0.002776 changing_frequency initial 0
t: 4883.00 ref_freq: 300.00 electric_frequency: -2.63 hall_freq: 0.00 mechanical_freq: -0.53 gear_freq: -0.002634 changing_frequency initial 0
t: 4897.00 ref_freq: 300.00 electric_frequency: -2.56 hall_freq: 0.00 mechanical_freq: -0.51 gear_freq: -0.002562 changing_frequency initial 0
t: 4911.00 ref_freq: 300.00 electric_frequency: -2.45 hall_freq: 0.00 mechanical_freq: -0.49 gear_freq: -0.002448 changing_frequency initial 0
t: 4925.00 ref_freq: 300.00 electric_frequency: -2.28 hall_freq: 0.00 mechanical_freq: -0.46 gear_freq: -0.002279 changing_frequency initial 0
t: 4940.00 ref_freq: 300.00 electric_frequency: -2.09 hall_freq: 0.00 mechanical_freq: -0.42 gear_freq: -0.002092 changing_frequency initial 0
t: 4954.00 ref_freq: 300.00 electric_frequency: -1.94 hall_freq: 0.00 mechanical_freq: -0.39 gear_freq: -0.001943 changing_frequency initial 0
t: 4968.00 ref_freq: 300.00 electric_frequency: -1.78 hall_freq: 0.00 mechanical_freq: -0.36 gear_freq: -0.001777 changing_frequency initial 0
t: 4981.00 ref_freq: 300.00 electric_frequency: -1.50 hall_freq: 0.00 mechanical_freq: -0.30 gear_freq: -0.001497 changing_frequency initial 0
t: 4996.00 ref_freq: 300.00 electric_frequency: -1.28 hall_freq: 0.00 mechanical_freq: -0.26 gear_freq: -0.001284 changing_frequency initial 0
t: 5009.00 ref_freq: 300.00 electric_frequency: -1.20 hall_freq: 0.00 mechanical_freq: -0.24 gear_freq: -0.001197 changing_frequency initial 0
t: 5022.00 ref_freq: 300.00 electric_frequency: -0.94 hall_freq: 0.00 mechanical_freq: -0.19 gear_freq: -0.000937 changing_frequency initial 0
t: 5035.00 ref_freq: 300.00 electric_frequency: -0.75 hall_freq: 0.00 mechanical_freq: -0.15 gear_freq: -0.000751 changing_frequency initial 0
t: 5048.00 ref_freq: 300.00 electric_frequency: -0.63 hall_freq: 0.00 mechanical_freq: -0.13 gear_freq: -0.000633 changing_frequency initial 0
t: 5061.00 ref_freq: 300.00 electric_frequency: -0.42 hall_freq: 0.00 mechanical_freq: -0.08 gear_freq: -0.000425 changing_frequency initial 0
t: 5074.00 ref_freq: 300.00 electric_frequency: -0.23 hall_freq: 0.00 mechanical_freq: -0.05 gear_freq: -0.000226 changing_frequency initial 0
t: 5088.00 ref_freq: 300.00 electric_frequency: -0.06 hall_freq: 0.00 mechanical_freq: -0.01 gear_freq: -0.000060 changing_frequency initial 0
t: 5100.00 ref_freq: 300.00 electric_frequency: 0.10 hall_freq: 0.00 mechanical_freq: 0.02 gear_freq: 0.000100 changing_frequency initial 0
t: 5114.00 ref_freq: 300.00 electric_frequency: 0.26 hall_freq: 0.00 mechanical_freq: 0.05 gear_freq: 0.000265 changing_frequency initial 0
t: 5127.00 ref_freq: 300.00 electric_frequency: 0.41 hall_freq: 0.00 mechanical_freq: 0.08 gear_freq: 0.000411 changing_frequency initial 0
t: 5140.00 ref_freq: 300.00 electric_frequency: 0.56 hall_freq: 0.00 mechanical_freq: 0.11 gear_freq: 0.000558 changing_frequency initial 0
t: 5153.00 ref_freq: 300.00 electric_frequency: 0.67 hall_freq: 0.00 mechanical_freq: 0.13 gear_freq: 0.000672 changing_frequency initial 0
t: 5167.00 ref_freq: 300.00 electric_frequency: 0.82 hall_freq: 0.00 mechanical_freq: 0.16 gear_freq: 0.000819 changing_frequency initial 0
t: 5180.00 ref_freq: 300.00 electric_frequency: 0.92 hall_freq: 0.00 mechanical_freq: 0.18 gear_freq: 0.000923 changing_frequency initial 0
t: 5193.00 ref_freq: 300.00 electric_frequency: 1.06 hall_freq: 0.00 mechanical_freq: 0.21 gear_freq: 0.001059 changing_frequency initial 0
t: 5205.00 ref_freq: 300.00 electric_frequency: 1.13 hall_freq: 0.00 mechanical_freq: 0.23 gear_freq: 0.001128 changing_frequency initial 0
t: 5219.00 ref_freq: 300.00 electric_frequency: 1.25 hall_freq: 0.00 mechanical_freq: 0.25 gear_freq: 0.001252 changing_frequency initial 0
t: 5232.00 ref_freq: 300.00 electric_frequency: 1.36 hall_freq: 0.00 mechanical_freq: 0.27 gear_freq: 0.001360 changing_frequency initial 0
t: 5245.00 ref_freq: 300.00 electric_frequency: 1.42 hall_freq: 0.00 mechanical_freq: 0.28 gear_freq: 0.001417 changing_frequency initial 0
t: 5259.00 ref_freq: 300.00 electric_frequency: 1.49 hall_freq: 0.00 mechanical_freq: 0.30 gear_freq: 0.001491 changing_frequency initial 0
t: 5273.00 ref_freq: 300.00 electric_frequency: 1.52 hall_freq: 0.00 mechanical_freq: 0.30 gear_freq: 0.001520 changing_frequency initial 0
t: 5287.00 ref_freq: 300.00 electric_frequency: 1.64 hall_freq: 0.00 mechanical_freq: 0.33 gear_freq: 0.001643 changing_frequency initial 0
t: 5302.00 ref_freq: 300.00 electric_frequency: 1.70 hall_freq: 0.00 mechanical_freq: 0.34 gear_freq: 0.001704 changing_frequency initial 0
t: 5315.00 ref_freq: 300.00 electric_frequency: 1.79 hall_freq: 0.00 mechanical_freq: 0.36 gear_freq: 0.001789 changing_frequency initial 0
t: 5329.00 ref_freq: 300.00 electric_frequency: 1.83 hall_freq: 0.00 mechanical_freq: 0.37 gear_freq: 0.001833 changing_frequency initial 0
t: 5341.00 ref_freq: 300.00 electric_frequency: 1.78 hall_freq: 0.00 mechanical_freq: 0.36 gear_freq: 0.001779 changing_frequency initial 0
t: 5354.00 ref_freq: 300.00 electric_frequency: 1.85 hall_freq: 0.00 mechanical_freq: 0.37 gear_freq: 0.001850 changing_frequency initial 0
t: 5368.00 ref_freq: 300.00 electric_frequency: 1.84 hall_freq: 0.00 mechanical_freq: 0.37 gear_freq: 0.001841 changing_frequency initial 0
t: 5381.00 ref_freq: 300.00 electric_frequency: 1.92 hall_freq: 0.00 mechanical_freq: 0.38 gear_freq: 0.001916 changing_frequency initial 0
t: 5395.00 ref_freq: 300.00 electric_frequency: 1.93 hall_freq: 0.00 mechanical_freq: 0.39 gear_freq: 0.001930 changing_frequency initial 0
t: 5408.00 ref_freq: 300.00 electric_frequency: 1.98 hall_freq: 0.00 mechanical_freq: 0.40 gear_freq: 0.001977 changing_frequency initial 0
t: 5422.00 ref_freq: 300.00 electric_frequency: 1.98 hall_freq: 0.00 mechanical_freq: 0.40 gear_freq: 0.001978 changing_frequency initial 0
t: 5436.00 ref_freq: 300.00 electric_frequency: 1.95 hall_freq: 0.00 mechanical_freq: 0.39 gear_freq: 0.001953 changing_frequency initial 0
t: 5451.00 ref_freq: 300.00 electric_frequency: 1.98 hall_freq: 0.00 mechanical_freq: 0.40 gear_freq: 0.001978 changing_frequency initial 0
t: 5465.00 ref_freq: 300.00 electric_frequency: 1.95 hall_freq: 0.00 mechanical_freq: 0.39 gear_freq: 0.001949 changing_frequency initial 0
t: 5478.00 ref_freq: 300.00 electric_frequency: 1.85 hall_freq: 0.00 mechanical_freq: 0.37 gear_freq: 0.001855 changing_frequency initial 0
t: 5491.00 ref_freq: 300.00 electric_frequency: 1.84 hall_freq: 0.00 mechanical_freq: 0.37 gear_freq: 0.001843 changing_frequency initial 0
t: 5504.00 ref_freq: 300.00 electric_frequency: 1.91 hall_freq: 0.00 mechanical_freq: 0.38 gear_freq: 0.001908 changing_frequency initial 0
t: 5518.00 ref_freq: 300.00 electric_frequency: 1.84 hall_freq: 0.00 mechanical_freq: 0.37 gear_freq: 0.001842 changing_frequency initial 0
t: 5532.00 ref_freq: 300.00 electric_frequency: 1.79 hall_freq: 0.00 mechanical_freq: 0.36 gear_freq: 0.001793 changing_frequency initial 0
t: 5546.00 ref_freq: 300.00 electric_frequency: 1.74 hall_freq: 0.00 mechanical_freq: 0.35 gear_freq: 0.001740 changing_frequency initial 0
t: 5560.00 ref_freq: 300.00 electric_frequency: 1.69 hall_freq: 0.00 mechanical_freq: 0.34 gear_freq: 0.001693 changing_frequency initial 0
t: 5574.00 ref_freq: 300.00 electric_frequency: 1.57 hall_freq: 0.00 mechanical_freq: 0.31 gear_freq: 0.001573 changing_frequency initial 0
t: 5587.00 ref_freq: 300.00 electric_frequency: 1.56 hall_freq: 0.00 mechanical_freq: 0.31 gear_freq: 0.001564 changing_frequency initial 0
t: 5601.00 ref_freq: 300.00 electric_frequency: 1.47 hall_freq: 0.00 mechanical_freq: 0.29 gear_freq: 0.001469 changing_frequency initial 0
t: 5615.00 ref_freq: 300.00 electric_frequency: 1.40 hall_freq: 0.00 mechanical_freq: 0.28 gear_freq: 0.001400 changing_frequency initial 0
t: 5629.00 ref_freq: 300.00 electric_frequency: 1.31 hall_freq: 0.00 mechanical_freq: 0.26 gear_freq: 0.001306 changing_frequency initial 0
t: 5642.00 ref_freq: 300.00 electric_frequency: 1.20 hall_freq: 0.00 mechanical_freq: 0.24 gear_freq: 0.001204 changing_frequency initial 0
t: 5655.00 ref_freq: 300.00 electric_frequency: 1.10 hall_freq: 0.00 mechanical_freq: 0.22 gear_freq: 0.001101 changing_frequency initial 0
t: 5668.00 ref_freq: 300.00 electric_frequency: 1.00 hall_freq: 0.00 mechanical_freq: 0.20 gear_freq: 0.001001 changing_frequency initial 0
t: 5682.00 ref_freq: 300.00 electric_frequency: 0.89 hall_freq: 0.00 mechanical_freq: 0.18 gear_freq: 0.000888 changing_frequency initial 0
t: 5695.00 ref_freq: 300.00 electric_frequency: 0.74 hall_freq: 0.00 mechanical_freq: 0.15 gear_freq: 0.000739 changing_frequency initial 0
t: 5709.00 ref_freq: 300.00 electric_frequency: 0.63 hall_freq: 0.00 mechanical_freq: 0.13 gear_freq: 0.000630 changing_frequency initial 0
t: 5723.00 ref_freq: 300.00 electric_frequency: 0.46 hall_freq: 0.00 mechanical_freq: 0.09 gear_freq: 0.000462 changing_frequency initial 0
t: 5737.00 ref_freq: 300.00 electric_frequency: 0.33 hall_freq: 0.00 mechanical_freq: 0.07 gear_freq: 0.000328 changing_frequency initial 0
t: 5751.00 ref_freq: 300.00 electric_frequency: 0.15 hall_freq: 0.00 mechanical_freq: 0.03 gear_freq: 0.000147 changing_frequency initial 0
t: 5765.00 ref_freq: 300.00 electric_frequency: -0.07 hall_freq: 0.00 mechanical_freq: -0.01 gear_freq: -0.000074 changing_frequency initial 0
t: 5779.00 ref_freq: 300.00 electric_frequency: -0.16 hall_freq: 0.00 mechanical_freq: -0.03 gear_freq: -0.000157 changing_frequency initial 0
t: 5792.00 ref_freq: 300.00 electric_frequency: -0.35 hall_freq: 0.00 mechanical_freq: -0.07 gear_freq: -0.000346 changing_frequency initial 0
t: 5805.00 ref_freq: 300.00 electric_frequency: -0.52 hall_freq: 0.00 mechanical_freq: -0.10 gear_freq: -0.000519 changing_frequency initial 0
t: 5819.00 ref_freq: 300.00 electric_frequency: -0.70 hall_freq: 0.00 mechanical_freq: -0.14 gear_freq: -0.000705 changing_frequency initial 0
t: 5834.00 ref_freq: 300.00 electric_frequency: -0.93 hall_freq: 0.00 mechanical_freq: -0.19 gear_freq: -0.000930 changing_frequency initial 0
t: 5848.00 ref_freq: 300.00 electric_frequency: -1.14 hall_freq: 0.00 mechanical_freq: -0.23 gear_freq: -0.001143 changing_frequency initial 0
t: 5862.00 ref_freq: 300.00 electric_frequency: -1.39 hall_freq: 0.00 mechanical_freq: -0.28 gear_freq: -0.001392 changing_frequency initial 0
t: 5877.00 ref_freq: 300.00 electric_frequency: -1.55 hall_freq: 0.00 mechanical_freq: -0.31 gear_freq: -0.001548 changing_frequency initial 0
t: 5892.00 ref_freq: 300.00 electric_frequency: -1.74 hall_freq: 0.00 mechanical_freq: -0.35 gear_freq: -0.001745 changing_frequency initial 0
t: 5906.00 ref_freq: 300.00 electric_frequency: -1.93 hall_freq: 0.00 mechanical_freq: -0.39 gear_freq: -0.001929 changing_frequency initial 0
t: 5920.00 ref_freq: 300.00 electric_frequency: -2.11 hall_freq: 0.00 mechanical_freq: -0.42 gear_freq: -0.002112 changing_frequency initial 0
t: 5934.00 ref_freq: 300.00 electric_frequency: -2.34 hall_freq: 0.00 mechanical_freq: -0.47 gear_freq: -0.002336 changing_frequency initial 0
t: 5949.00 ref_freq: 300.00 electric_frequency: -2.47 hall_freq: 0.00 mechanical_freq: -0.49 gear_freq: -0.002473 changing_frequency initial 0
t: 5963.00 ref_freq: 300.00 electric_frequency: -2.62 hall_freq: 0.00 mechanical_freq: -0.52 gear_freq: -0.002620 changing_frequency initial 0
t: 5977.00 ref_freq: 300.00 electric_frequency: -2.65 hall_freq: 0.00 mechanical_freq: -0.53 gear_freq: -0.002655 changing_frequency initial 0
t: 5991.00 ref_freq: 300.00 electric_frequency: -2.78 hall_freq: 0.00 mechanical_freq: -0.56 gear_freq: -0.002781 changing_frequency initial 0
t: 6006.00 ref_freq: 300.00 electric_frequency: -2.84 hall_freq: 0.00 mechanical_freq: -0.57 gear_freq: -0.002840 changing_frequency initial 0
t: 6020.00 ref_freq: 300.00 electric_frequency: -2.88 hall_freq: 0.00 mechanical_freq: -0.58 gear_freq: -0.002878 changing_frequency initial 0
t: 6034.00 ref_freq: 300.00 electric_frequency: -2.88 hall_freq: 0.00 mechanical_freq: -0.58 gear_freq: -0.002879 changing_frequency initial 0
t: 6048.00 ref_freq: 300.00 electric_frequency: -2.79 hall_freq: 0.00 mechanical_freq: -0.56 gear_freq: -0.002791 changing_frequency initial 0
t: 6061.00 ref_freq: 300.00 electric_frequency: -2.82 hall_freq: 0.00 mechanical_freq: -0.56 gear_freq: -0.002816 changing_frequency initial 0
t: 6074.00 ref_freq: 300.00 electric_frequency: -2.71 hall_freq: 0.00 mechanical_freq: -0.54 gear_freq: -0.002709 changing_frequency initial 0
t: 6088.00 ref_freq: 300.00 electric_frequency: -2.69 hall_freq: 0.00 mechanical_freq: -0.54 gear_freq: -0.002691 changing_frequency initial 0
t: 6102.00 ref_freq: 300.00 electric_frequency: -2.45 hall_freq: 0.00 mechanical_freq: -0.49 gear_freq: -0.002452 changing_frequency initial 0
t: 6116.00 ref_freq: 300.00 electric_frequency: -2.30 hall_freq: 0.00 mechanical_freq: -0.46 gear_freq: -0.002305 changing_frequency initial 0
t: 6130.00 ref_freq: 300.00 electric_frequency: -2.17 hall_freq: 0.00 mechanical_freq: -0.43 gear_freq: -0.002173 changing_frequency initial 0
t: 6144.00 ref_freq: 300.00 electric_frequency: -2.08 hall_freq: 0.00 mechanical_freq: -0.42 gear_freq: -0.002082 changing_frequency initial 0
t: 6158.00 ref_freq: 300.00 electric_frequency: -1.86 hall_freq: 0.00 mechanical_freq: -0.37 gear_freq: -0.001859 changing_frequency initial 0
t: 6173.00 ref_freq: 300.00 electric_frequency: -1.62 hall_freq: 0.00 mechanical_freq: -0.32 gear_freq: -0.001619 changing_frequency initial 0
t: 6188.00 ref_freq: 300.00 electric_frequency: -1.41 hall_freq: 0.00 mechanical_freq: -0.28 gear_freq: -0.001406 changing_frequency initial 0
t: 6202.00 ref_freq: 300.00 electric_frequency: -1.25 hall_freq: 0.00 mechanical_freq: -0.25 gear_freq: -0.001245 changing_frequency initial 0
t: 6216.00 ref_freq: 300.00 electric_frequency: -1.09 hall_freq: 0.00 mechanical_freq: -0.22 gear_freq: -0.001089 changing_frequency initial 0
t: 6229.00 ref_freq: 300.00 electric_frequency: -0.90 hall_freq: 0.00 mechanical_freq: -0.18 gear_freq: -0.000896 changing_frequency initial 0
t: 6242.00 ref_freq: 300.00 electric_frequency: -0.64 hall_freq: 0.00 mechanical_freq: -0.13 gear_freq: -0.000640 changing_frequency initial 0
t: 6255.00 ref_freq: 300.00 electric_frequency: -0.47 hall_freq: 0.00 mechanical_freq: -0.09 gear_freq: -0.000467 changing_frequency initial 0
t: 6268.00 ref_freq: 300.00 electric_frequency: -0.31 hall_freq: 0.00 mechanical_freq: -0.06 gear_freq: -0.000311 changing_frequency initial 0
t: 6281.00 ref_freq: 300.00 electric_frequency: -0.12 hall_freq: 0.00 mechanical_freq: -0.02 gear_freq: -0.000120 changing_frequency initial 0
t: 6294.00 ref_freq: 300.00 electric_frequency: 0.04 hall_freq: 0.00 mechanical_freq: 0.01 gear_freq: 0.000039 changing_frequency initial 0
t: 6307.00 ref_freq: 300.00 electric_frequency: 0.17 hall_freq: 0.00 mechanical_freq: 0.03 gear_freq: 0.000175 changing_frequency initial 0
t: 6320.00 ref_freq: 300.00 electric_frequency: 0.34 hall_freq: 0.00 mechanical_freq: 0.07 gear_freq: 0.000341 changing_frequency initial 0
t: 6333.00 ref_freq: 300.00 electric_frequency: 0.47 hall_freq: 0.00 mechanical_freq: 0.09 gear_freq: 0.000466 changing_frequency initial 0
t: 6345.00 ref_freq: 300.00 electric_frequency: 0.55 hall_freq: 0.00 mechanical_freq: 0.11 gear_freq: 0.000552 changing_frequency initial 0
t: 6358.00 ref_freq: 300.00 electric_frequency: 0.75 hall_freq: 0.00 mechanical_freq: 0.15 gear_freq: 0.000745 changing_frequency initial 0
t: 6372.00 ref_freq: 300.00 electric_frequency: 0.87 hall_freq: 0.00 mechanical_freq: 0.17 gear_freq: 0.000871 changing_frequency initial 0
t: 6385.00 ref_freq: 300.00 electric_frequency: 0.96 hall_freq: 0.00 mechanical_freq: 0.19 gear_freq: 0.000956 changing_frequency initial 0
t: 6398.00 ref_freq: 300.00 electric_frequency: 1.03 hall_freq: 0.00 mechanical_freq: 0.21 gear_freq: 0.001029 changing_frequency initial 0
t: 6411.00 ref_freq: 300.00 electric_frequency: 1.16 hall_freq: 0.00 mechanical_freq: 0.23 gear_freq: 0.001163 changing_frequency initial 0
t: 6425.00 ref_freq: 300.00 electric_frequency: 1.27 hall_freq: 0.00 mechanical_freq: 0.25 gear_freq: 0.001270 changing_frequency initial 0
t: 6437.00 ref_freq: 300.00 electric_frequency: 1.38 hall_freq: 0.00 mechanical_freq: 0.28 gear_freq: 0.001383 changing_frequency initial 0
t: 6450.00 ref_freq: 300.00 electric_frequency: 1.44 hall_freq: 0.00 mechanical_freq: 0.29 gear_freq: 0.001437 changing_frequency initial 0
t: 6463.00 ref_freq: 300.00 electric_frequency: 1.53 hall_freq: 0.00 mechanical_freq: 0.31 gear_freq: 0.001530 changing_frequency initial 0
t: 6476.00 ref_freq: 300.00 electric_frequency: 1.53 hall_freq: 0.00 mechanical_freq: 0.31 gear_freq: 0.001528 changing_frequency initial 0
t: 6490.00 ref_freq: 300.00 electric_frequency: 1.65 hall_freq: 0.00 mechanical_freq: 0.33 gear_freq: 0.001654 changing_frequency initial 0
t: 6503.00 ref_freq: 300.00 electric_frequency: 1.75 hall_freq: 0.00 mechanical_freq: 0.35 gear_freq: 0.001753 changing_frequency initial 0
t: 6517.00 ref_freq: 300.00 electric_frequency: 1.79 hall_freq: 0.00 mechanical_freq: 0.36 gear_freq: 0.001793 changing_frequency initial 0
t: 6531.00 ref_freq: 300.00 electric_frequency: 1.88 hall_freq: 0.00 mechanical_freq: 0.38 gear_freq: 0.001879 changing_frequency initial 0
t: 6544.00 ref_freq: 300.00 electric_frequency: 1.89 hall_freq: 0.00 mechanical_freq: 0.38 gear_freq: 0.001890 changing_frequency initial 0
t: 6557.00 ref_freq: 300.00 electric_frequency: 1.88 hall_freq: 0.00 mechanical_freq: 0.38 gear_freq: 0.001884 changing_frequency initial 0
t: 6570.00 ref_freq: 300.00 electric_frequency: 1.91 hall_freq: 0.00 mechanical_freq: 0.38 gear_freq: 0.001912 changing_frequency initial 0
t: 6584.00 ref_freq: 300.00 electric_frequency: 1.93 hall_freq: 0.00 mechanical_freq: 0.39 gear_freq: 0.001932 changing_frequency initial 0
t: 6597.00 ref_freq: 300.00 electric_frequency: 1.94 hall_freq: 0.00 mechanical_freq: 0.39 gear_freq: 0.001936 changing_frequency initial 0
t: 6611.00 ref_freq: 300.00 electric_frequency: 1.95 hall_freq: 0.00 mechanical_freq: 0.39 gear_freq: 0.001948 changing_frequency initial 0
t: 6625.00 ref_freq: 300.00 electric_frequency: 1.95 hall_freq: 0.00 mechanical_freq: 0.39 gear_freq: 0.001945 changing_frequency initial 0
t: 6639.00 ref_freq: 300.00 electric_frequency: 1.98 hall_freq: 0.00 mechanical_freq: 0.40 gear_freq: 0.001981 changing_frequency initial 0
t: 6653.00 ref_freq: 300.00 electric_frequency: 2.00 hall_freq: 0.00 mechanical_freq: 0.40 gear_freq: 0.001995 changing_frequency initial 0
t: 6667.00 ref_freq: 300.00 electric_frequency: 1.94 hall_freq: 0.00 mechanical_freq: 0.39 gear_freq: 0.001939 changing_frequency initial 0
t: 6681.00 ref_freq: 300.00 electric_frequency: 1.95 hall_freq: 0.00 mechanical_freq: 0.39 gear_freq: 0.001949 changing_frequency initial 0
t: 6695.00 ref_freq: 300.00 electric_frequency: 1.89 hall_freq: 0.00 mechanical_freq: 0.38 gear_freq: 0.001893 changing_frequency initial 0
t: 6708.00 ref_freq: 300.00 electric_frequency: 1.85 hall_freq: 0.00 mechanical_freq: 0.37 gear_freq: 0.001848 changing_frequency initial 0
t: 6721.00 ref_freq: 300.00 electric_frequency: 1.88 hall_freq: 0.00 mechanical_freq: 0.38 gear_freq: 0.001884 changing_frequency initial 0
t: 6734.00 ref_freq: 300.00 electric_frequency: 1.76 hall_freq: 0.00 mechanical_freq: 0.35 gear_freq: 0.001764 changing_frequency initial 0
t: 6748.00 ref_freq: 300.00 electric_frequency: 1.74 hall_freq: 0.00 mechanical_freq: 0.35 gear_freq: 0.001740 changing_frequency initial 0
t: 6776.00 ref_freq: 300.00 electric_frequency: 1.60 hall_freq: 0.00 mechanical_freq: 0.32 gear_freq: 0.001603 changing_frequency initial 0
t: 6789.00 ref_freq: 300.00 electric_frequency: 1.57 hall_freq: 0.00 mechanical_freq: 0.31 gear_freq: 0.001575 changing_frequency initial 0
t: 6803.00 ref_freq: 300.00 electric_frequency: 1.46 hall_freq: 0.00 mechanical_freq: 0.29 gear_freq: 0.001465 changing_frequency initial 0
t: 6817.00 ref_freq: 300.00 electric_frequency: 1.33 hall_freq: 0.00 mechanical_freq: 0.27 gear_freq: 0.001326 changing_frequency initial 0
t: 6831.00 ref_freq: 300.00 electric_frequency: 1.29 hall_freq: 0.00 mechanical_freq: 0.26 gear_freq: 0.001290 changing_frequency initial 0
t: 6845.00 ref_freq: 300.00 electric_frequency: 1.18 hall_freq: 0.00 mechanical_freq: 0.24 gear_freq: 0.001184 changing_frequency initial 0
t: 6859.00 ref_freq: 300.00 electric_frequency: 1.11 hall_freq: 0.00 mechanical_freq: 0.22 gear_freq: 0.001114 changing_frequency initial 0
t: 6872.00 ref_freq: 300.00 electric_frequency: 1.01 hall_freq: 0.00 mechanical_freq: 0.20 gear_freq: 0.001006 changing_frequency initial 0
t: 6885.00 ref_freq: 300.00 electric_frequency: 0.88 hall_freq: 0.00 mechanical_freq: 0.18 gear_freq: 0.000877 changing_frequency initial 0
t: 6899.00 ref_freq: 300.00 electric_frequency: 0.71 hall_freq: 0.00 mechanical_freq: 0.14 gear_freq: 0.000713 changing_frequency initial 0
t: 6913.00 ref_freq: 300.00 electric_frequency: 0.53 hall_freq: 0.00 mechanical_freq: 0.11 gear_freq: 0.000528 changing_frequency initial 0
t: 6926.00 ref_freq: 300.00 electric_frequency: 0.45 hall_freq: 0.00 mechanical_freq: 0.09 gear_freq: 0.000451 changing_frequency initial 0
t: 6940.00 ref_freq: 300.00 electric_frequency: 0.24 hall_freq: 0.00 mechanical_freq: 0.05 gear_freq: 0.000237 changing_frequency initial 0
t: 6954.00 ref_freq: 300.00 electric_frequency: 0.12 hall_freq: 0.00 mechanical_freq: 0.02 gear_freq: 0.000123 changing_frequency initial 0
t: 6969.00 ref_freq: 300.00 electric_frequency: -0.12 hall_freq: 0.00 mechanical_freq: -0.02 gear_freq: -0.000118 changing_frequency initial 0
t: 6983.00 ref_freq: 300.00 electric_frequency: -0.22 hall_freq: 0.00 mechanical_freq: -0.04 gear_freq: -0.000219 changing_frequency initial 0
t: 6997.00 ref_freq: 300.00 electric_frequency: -0.41 hall_freq: 0.00 mechanical_freq: -0.08 gear_freq: -0.000412 changing_frequency initial 0
t: 7011.00 ref_freq: 300.00 electric_frequency: -0.63 hall_freq: 0.00 mechanical_freq: -0.13 gear_freq: -0.000634 changing_frequency initial 0
t: 7026.00 ref_freq: 300.00 electric_frequency: -0.82 hall_freq: 0.00 mechanical_freq: -0.16 gear_freq: -0.000817 changing_frequency initial 0
t: 7039.00 ref_freq: 300.00 electric_frequency: -1.02 hall_freq: 0.00 mechanical_freq: -0.20 gear_freq: -0.001016 changing_frequency initial 0
t: 7053.00 ref_freq: 300.00 electric_frequency: -1.20 hall_freq: 0.00 mechanical_freq: -0.24 gear_freq: -0.001203 changing_frequency initial 0
t: 7069.00 ref_freq: 300.00 electric_frequency: -1.44 hall_freq: 0.00 mechanical_freq: -0.29 gear_freq: -0.001436 changing_frequency initial 0
t: 7083.00 ref_freq: 300.00 electric_frequency: -1.66 hall_freq: 0.00 mechanical_freq: -0.33 gear_freq: -0.001658 changing_frequency initial 0
t: 7097.00 ref_freq: 300.00 electric_frequency: -1.83 hall_freq: 0.00 mechanical_freq: -0.37 gear_freq: -0.001826 changing_frequency initial 0
t: 7110.00 ref_freq: 300.00 electric_frequency: -1.99 hall_freq: 0.00 mechanical_freq: -0.40 gear_freq: -0.001995 changing_frequency initial 0
t: 7124.00 ref_freq: 300.00 electric_frequency: -2.18 hall_freq: 0.00 mechanical_freq: -0.44 gear_freq: -0.002176 changing_frequency initial 0
t: 7138.00 ref_freq: 300.00 electric_frequency: -2.33 hall_freq: 0.00 mechanical_freq: -0.47 gear_freq: -0.002331 changing_frequency initial 0
t: 7152.00 ref_freq: 300.00 electric_frequency: -2.46 hall_freq: 0.00 mechanical_freq: -0.49 gear_freq: -0.002463 changing_frequency initial 0
t: 7166.00 ref_freq: 300.00 electric_frequency: -2.56 hall_freq: 0.00 mechanical_freq: -0.51 gear_freq: -0.002565 changing_frequency initial 0
t: 7180.00 ref_freq: 300.00 electric_frequency: -2.68 hall_freq: 0.00 mechanical_freq: -0.54 gear_freq: -0.002683 changing_frequency initial 0
t: 7194.00 ref_freq: 300.00 electric_frequency: -2.77 hall_freq: 0.00 mechanical_freq: -0.55 gear_freq: -0.002766 changing_frequency initial 0
t: 7207.00 ref_freq: 300.00 electric_frequency: -2.80 hall_freq: 0.00 mechanical_freq: -0.56 gear_freq: -0.002803 changing_frequency initial 0
t: 7220.00 ref_freq: 300.00 electric_frequency: -2.84 hall_freq: 0.00 mechanical_freq: -0.57 gear_freq: -0.002843 changing_frequency initial 0
t: 7233.00 ref_freq: 300.00 electric_frequency: -2.77 hall_freq: 0.00 mechanical_freq: -0.55 gear_freq: -0.002771 changing_frequency initial 0
t: 7246.00 ref_freq: 300.00 electric_frequency: -2.77 hall_freq: 0.00 mechanical_freq: -0.55 gear_freq: -0.002773 changing_frequency initial 0
t: 7260.00 ref_freq: 300.00 electric_frequency: -2.79 hall_freq: 0.00 mechanical_freq: -0.56 gear_freq: -0.002787 changing_frequency initial 0
t: 7274.00 ref_freq: 300.00 electric_frequency: -2.74 hall_freq: 0.00 mechanical_freq: -0.55 gear_freq: -0.002739 changing_frequency initial 0
t: 7288.00 ref_freq: 300.00 electric_frequency: -2.65 hall_freq: 0.00 mechanical_freq: -0.53 gear_freq: -0.002655 changing_frequency initial 0
t: 7302.00 ref_freq: 300.00 electric_frequency: -2.48 hall_freq: 0.00 mechanical_freq: -0.50 gear_freq: -0.002484 changing_frequency initial 0
t: 7316.00 ref_freq: 300.00 electric_frequency: -2.31 hall_freq: 0.00 mechanical_freq: -0.46 gear_freq: -0.002305 changing_frequency initial 0
t: 7330.00 ref_freq: 300.00 electric_frequency: -2.24 hall_freq: 0.00 mechanical_freq: -0.45 gear_freq: -0.002243 changing_frequency initial 0
t: 7344.00 ref_freq: 300.00 electric_frequency: -2.06 hall_freq: 0.00 mechanical_freq: -0.41 gear_freq: -0.002062 changing_frequency initial 0
t: 7359.00 ref_freq: 300.00 electric_frequency: -1.87 hall_freq: 0.00 mechanical_freq: -0.37 gear_freq: -0.001868 changing_frequency initial 0
t: 7374.00 ref_freq: 300.00 electric_frequency: -1.63 hall_freq: 0.00 mechanical_freq: -0.33 gear_freq: -0.001635 changing_frequency initial 0
t: 7388.00 ref_freq: 300.00 electric_frequency: -1.43 hall_freq: 0.00 mechanical_freq: -0.29 gear_freq: -0.001425 changing_frequency initial 0
t: 7402.00 ref_freq: 300.00 electric_frequency: -1.21 hall_freq: 0.00 mechanical_freq: -0.24 gear_freq: -0.001211 changing_frequency initial 0
t: 7416.00 ref_freq: 300.00 electric_frequency: -1.06 hall_freq: 0.00 mechanical_freq: -0.21 gear_freq: -0.001061 changing_frequency initial 0
t: 7429.00 ref_freq: 300.00 electric_frequency: -0.90 hall_freq: 0.00 mechanical_freq: -0.18 gear_freq: -0.000899 changing_frequency initial 0
t: 7441.00 ref_freq: 300.00 electric_frequency: -0.69 hall_freq: 0.00 mechanical_freq: -0.14 gear_freq: -0.000690 changing_frequency initial 0
t: 7454.00 ref_freq: 300.00 electric_frequency: -0.49 hall_freq: 0.00 mechanical_freq: -0.10 gear_freq: -0.000485 changing_frequency initial 0
t: 7469.00 ref_freq: 300.00 electric_frequency: -0.30 hall_freq: 0.00 mechanical_freq: -0.06 gear_freq: -0.000297 changing_frequency initial 0
t: 7482.00 ref_freq: 300.00 electric_frequency: -0.17 hall_freq: 0.00 mechanical_freq: -0.03 gear_freq: -0.000173 changing_frequency initial 0
t: 7495.00 ref_freq: 300.00 electric_frequency: -0.00 hall_freq: 0.00 mechanical_freq: -0.00 gear_freq: -0.000000 changing_frequency initial 0
t: 7510.00 ref_freq: 300.00 electric_frequency: 0.21 hall_freq: 0.00 mechanical_freq: 0.04 gear_freq: 0.000210 changing_frequency initial 0
t: 7524.00 ref_freq: 300.00 electric_frequency: 0.38 hall_freq: 0.00 mechanical_freq: 0.08 gear_freq: 0.000377 changing_frequency initial 0
t: 7537.00 ref_freq: 300.00 electric_frequency: 0.50 hall_freq: 0.00 mechanical_freq: 0.10 gear_freq: 0.000501 changing_frequency initial 0
t: 7550.00 ref_freq: 300.00 electric_frequency: 0.64 hall_freq: 0.00 mechanical_freq: 0.13 gear_freq: 0.000640 changing_frequency initial 0
t: 7562.00 ref_freq: 300.00 electric_frequency: 0.78 hall_freq: 0.00 mechanical_freq: 0.16 gear_freq: 0.000782 changing_frequency initial 0
t: 7575.00 ref_freq: 300.00 electric_frequency: 0.90 hall_freq: 0.00 mechanical_freq: 0.18 gear_freq: 0.000898 changing_frequency initial 0
t: 7588.00 ref_freq: 300.00 electric_frequency: 1.00 hall_freq: 0.00 mechanical_freq: 0.20 gear_freq: 0.000998 changing_frequency initial 0
t: 7601.00 ref_freq: 300.00 electric_frequency: 1.10 hall_freq: 0.00 mechanical_freq: 0.22 gear_freq: 0.001098 changing_frequency initial 0
t: 7614.00 ref_freq: 300.00 electric_frequency: 1.21 hall_freq: 0.00 mechanical_freq: 0.24 gear_freq: 0.001211 changing_frequency initial 0
t: 7628.00 ref_freq: 300.00 electric_frequency: 1.30 hall_freq: 0.00 mechanical_freq: 0.26 gear_freq: 0.001297 changing_frequency initial 0
t: 7641.00 ref_freq: 300.00 electric_frequency: 1.42 hall_freq: 0.00 mechanical_freq: 0.28 gear_freq: 0.001416 changing_frequency initial 0
t: 7654.00 ref_freq: 300.00 electric_frequency: 1.47 hall_freq: 0.00 mechanical_freq: 0.29 gear_freq: 0.001473 changing_frequency initial 0
t: 7667.00 ref_freq: 300.00 electric_frequency: 1.54 hall_freq: 0.00 mechanical_freq: 0.31 gear_freq: 0.001539 changing_frequency initial 0
t: 7680.00 ref_freq: 300.00 electric_frequency: 1.61 hall_freq: 0.00 mechanical_freq: 0.32 gear_freq: 0.001605 changing_frequency initial 0
t: 7693.00 ref_freq: 300.00 electric_frequency: 1.67 hall_freq: 0.00 mechanical_freq: 0.33 gear_freq: 0.001671 changing_frequency initial 0
t: 7706.00 ref_freq: 300.00 electric_frequency: 1.71 hall_freq: 0.00 mechanical_freq: 0.34 gear_freq: 0.001711 changing_frequency initial 0
t: 7719.00 ref_freq: 300.00 electric_frequency: 1.77 hall_freq: 0.00 mechanical_freq: 0.35 gear_freq: 0.001767 changing_frequency initial 0
t: 7733.00 ref_freq: 300.00 electric_frequency: 1.81 hall_freq: 0.00 mechanical_freq: 0.36 gear_freq: 0.001808 changing_frequency initial 0
t: 7747.00 ref_freq: 300.00 electric_frequency: 1.87 hall_freq: 0.00 mechanical_freq: 0.37 gear_freq: 0.001868 changing_frequency initial 0
t: 7761.00 ref_freq: 300.00 electric_frequency: 1.89 hall_freq: 0.00 mechanical_freq: 0.38 gear_freq: 0.001888 changing_frequency initial 0
t: 7774.00 ref_freq: 300.00 electric_frequency: 1.92 hall_freq: 0.00 mechanical_freq: 0.38 gear_freq: 0.001924 changing_frequency initial 0
t: 7787.00 ref_freq: 300.00 electric_frequency: 1.95 hall_freq: 0.00 mechanical_freq: 0.39 gear_freq: 0.001955 changing_frequency initial 0
t: 7801.00 ref_freq: 300.00 electric_frequency: 1.96 hall_freq: 0.00 mechanical_freq: 0.39 gear_freq: 0.001959 changing_frequency initial 0
t: 7815.00 ref_freq: 300.00 electric_frequency: 1.95 hall_freq: 0.00 mechanical_freq: 0.39 gear_freq: 0.001954 changing_frequency initial 0
t: 7829.00 ref_freq: 300.00 electric_frequency: 1.99 hall_freq: 0.00 mechanical_freq: 0.40 gear_freq: 0.001987 changing_frequency initial 0
t: 7843.00 ref_freq: 300.00 electric_frequency: 1.99 hall_freq: 0.00 mechanical_freq: 0.40 gear_freq: 0.001991 changing_frequency initial 0
t: 7857.00 ref_freq: 300.00 electric_frequency: 1.97 hall_freq: 0.00 mechanical_freq: 0.39 gear_freq: 0.001967 changing_frequency initial 0
t: 7872.00 ref_freq: 300.00 electric_frequency: 1.92 hall_freq: 0.00 mechanical_freq: 0.38 gear_freq: 0.001924 changing_frequency initial 0
t: 7886.00 ref_freq: 300.00 electric_frequency: 1.97 hall_freq: 0.00 mechanical_freq: 0.39 gear_freq: 0.001966 changing_frequency initial 0
t: 7900.00 ref_freq: 300.00 electric_frequency: 1.91 hall_freq: 0.00 mechanical_freq: 0.38 gear_freq: 0.001915 changing_frequency initial 0
t: 7914.00 ref_freq: 300.00 electric_frequency: 1.90 hall_freq: 0.00 mechanical_freq: 0.38 gear_freq: 0.001896 changing_frequency initial 0
t: 7927.00 ref_freq: 300.00 electric_frequency: 1.83 hall_freq: 0.00 mechanical_freq: 0.37 gear_freq: 0.001825 changing_frequency initial 0
t: 7940.00 ref_freq: 300.00 electric_frequency: 1.83 hall_freq: 0.00 mechanical_freq: 0.37 gear_freq: 0.001827 changing_frequency initial 0
t: 7954.00 ref_freq: 300.00 electric_frequency: 1.75 hall_freq: 0.00 mechanical_freq: 0.35 gear_freq: 0.001748 changing_frequency initial 0
t: 7967.00 ref_freq: 300.00 electric_frequency: 1.64 hall_freq: 0.00 mechanical_freq: 0.33 gear_freq: 0.001642 changing_frequency initial 0
t: 7980.00 ref_freq: 300.00 electric_frequency: 1.62 hall_freq: 0.00 mechanical_freq: 0.32 gear_freq: 0.001621 changing_frequency initial 0
t: 7993.00 ref_freq: 300.00 electric_frequency: 1.51 hall_freq: 0.00 mechanical_freq: 0.30 gear_freq: 0.001513 changing_frequency initial 0
t: 8006.00 ref_freq: 300.00 electric_frequency: 1.46 hall_freq: 0.00 mechanical_freq: 0.29 gear_freq: 0.001464 changing_frequency initial 0
t: 8020.00 ref_freq: 300.00 electric_frequency: 1.40 hall_freq: 0.00 mechanical_freq: 0.28 gear_freq: 0.001400 changing_frequency initial 0
t: 8033.00 ref_freq: 300.00 electric_frequency: 1.31 hall_freq: 0.00 mechanical_freq: 0.26 gear_freq: 0.001312 changing_frequency initial 0
t: 8046.00 ref_freq: 300.00 electric_frequency: 1.19 hall_freq: 0.00 mechanical_freq: 0.24 gear_freq: 0.001191 changing_frequency initial 0
t: 8060.00 ref_freq: 300.00 electric_frequency: 1.06 hall_freq: 0.00 mechanical_freq: 0.21 gear_freq: 0.001056 changing_frequency initial 0
t: 8073.00 ref_freq: 300.00 electric_frequency: 1.00 hall_freq: 0.00 mechanical_freq: 0.20 gear_freq: 0.000998 changing_frequency initial 0
t: 8086.00 ref_freq: 300.00 electric_frequency: 0.88 hall_freq: 0.00 mechanical_freq: 0.18 gear_freq: 0.000878 changing_frequency initial 0
t: 8099.00 ref_freq: 300.00 electric_frequency: 0.71 hall_freq: 0.00 mechanical_freq: 0.14 gear_freq: 0.000715 changing_frequency initial 0
t: 8112.00 ref_freq: 300.00 electric_frequency: 0.62 hall_freq: 0.00 mechanical_freq: 0.12 gear_freq: 0.000617 changing_frequency initial 0
t: 8125.00 ref_freq: 300.00 electric_frequency: 0.44 hall_freq: 0.00 mechanical_freq: 0.09 gear_freq: 0.000444 changing_frequency initial 0
t: 8139.00 ref_freq: 300.00 electric_frequency: 0.29 hall_freq: 0.00 mechanical_freq: 0.06 gear_freq: 0.000291 changing_frequency initial 0
t: 8153.00 ref_freq: 300.00 electric_frequency: 0.08 hall_freq: 0.00 mechanical_freq: 0.02 gear_freq: 0.000081 changing_frequency initial 0
t: 8166.00 ref_freq: 300.00 electric_frequency: 0.01 hall_freq: 0.00 mechanical_freq: 0.00 gear_freq: 0.000006 changing_frequency initial 0
t: 8179.00 ref_freq: 300.00 electric_frequency: -0.20 hall_freq: 0.00 mechanical_freq: -0.04 gear_freq: -0.000197 changing_frequency initial 0
t: 8192.00 ref_freq: 300.00 electric_frequency: -0.33 hall_freq: 0.00 mechanical_freq: -0.07 gear_freq: -0.000330 changing_frequency initial 0
t: 8219.00 ref_freq: 300.00 electric_frequency: -0.73 hall_freq: 0.00 mechanical_freq: -0.15 gear_freq: -0.000727 changing_frequency initial 0
t: 8233.00 ref_freq: 300.00 electric_frequency: -0.92 hall_freq: 0.00 mechanical_freq: -0.18 gear_freq: -0.000925 changing_frequency initial 0
t: 8248.00 ref_freq: 300.00 electric_frequency: -1.12 hall_freq: 0.00 mechanical_freq: -0.22 gear_freq: -0.001123 changing_frequency initial 0
t: 8262.00 ref_freq: 300.00 electric_frequency: -1.39 hall_freq: 0.00 mechanical_freq: -0.28 gear_freq: -0.001388 changing_frequency initial 0
t: 8276.00 ref_freq: 300.00 electric_frequency: -1.53 hall_freq: 0.00 mechanical_freq: -0.31 gear_freq: -0.001529 changing_frequency initial 0
t: 8289.00 ref_freq: 300.00 electric_frequency: -1.70 hall_freq: 0.00 mechanical_freq: -0.34 gear_freq: -0.001705 changing_frequency initial 0
t: 8303.00 ref_freq: 300.00 electric_frequency: -1.89 hall_freq: 0.00 mechanical_freq: -0.38 gear_freq: -0.001893 changing_frequency initial 0
t: 8316.00 ref_freq: 300.00 electric_frequency: -2.13 hall_freq: 0.00 mechanical_freq: -0.43 gear_freq: -0.002125 changing_frequency initial 0
t: 8331.00 ref_freq: 300.00 electric_frequency: -2.24 hall_freq: 0.00 mechanical_freq: -0.45 gear_freq: -0.002243 changing_frequency initial 0
t: 8344.00 ref_freq: 300.00 electric_frequency: -2.35 hall_freq: 0.00 mechanical_freq: -0.47 gear_freq: -0.002347 changing_frequency initial 0
t: 8357.00 ref_freq: 300.00 electric_frequency: -2.56 hall_freq: 0.00 mechanical_freq: -0.51 gear_freq: -0.002559 changing_frequency initial 0
t: 8371.00 ref_freq: 300.00 electric_frequency: -2.66 hall_freq: 0.00 mechanical_freq: -0.53 gear_freq: -0.002660 changing_frequency initial 0
t: 8385.00 ref_freq: 300.00 electric_frequency: -2.72 hall_freq: 0.00 mechanical_freq: -0.54 gear_freq: -0.002723 changing_frequency initial 0
t: 8399.00 ref_freq: 300.00 electric_frequency: -2.73 hall_freq: 0.00 mechanical_freq: -0.55 gear_freq: -0.002726 changing_frequency initial 0
t: 8414.00 ref_freq: 300.00 electric_frequency: -2.84 hall_freq: 0.00 mechanical_freq: -0.57 gear_freq: -0.002842 changing_frequency initial 0
t: 8428.00 ref_freq: 300.00 electric_frequency: -2.83 hall_freq: 0.00 mechanical_freq: -0.57 gear_freq: -0.002831 changing_frequency initial 0
t: 8443.00 ref_freq: 300.00 electric_frequency: -2.87 hall_freq: 0.00 mechanical_freq: -0.57 gear_freq: -0.002872 changing_frequency initial 0
t: 8458.00 ref_freq: 300.00 electric_frequency: -2.84 hall_freq: 0.00 mechanical_freq: -0.57 gear_freq: -0.002838 changing_frequency initial 0
t: 8472.00 ref_freq: 300.00 electric_frequency: -2.76 hall_freq: 0.00 mechanical_freq: -0.55 gear_freq: -0.002764 changing_frequency initial 0
t: 8485.00 ref_freq: 300.00 electric_frequency: -2.68 hall_freq: 0.00 mechanical_freq: -0.54 gear_freq: -0.002679 changing_frequency initial 0
t: 8498.00 ref_freq: 300.00 electric_frequency: -2.53 hall_freq: 0.00 mechanical_freq: -0.51 gear_freq: -0.002533 changing_frequency initial 0
t: 8511.00 ref_freq: 300.00 electric_frequency: -2.38 hall_freq: 0.00 mechanical_freq: -0.48 gear_freq: -0.002381 changing_frequency initial 0
t: 8525.00 ref_freq: 300.00 electric_frequency: -2.30 hall_freq: 0.00 mechanical_freq: -0.46 gear_freq: -0.002299 changing_frequency initial 0
t: 8538.00 ref_freq: 300.00 electric_frequency: -2.11 hall_freq: 0.00 mechanical_freq: -0.42 gear_freq: -0.002111 changing_frequency initial 0
t: 8551.00 ref_freq: 300.00 electric_frequency: -1.96 hall_freq: 0.00 mechanical_freq: -0.39 gear_freq: -0.001957 changing_frequency initial 0
t: 8564.00 ref_freq: 300.00 electric_frequency: -1.72 hall_freq: 0.00 mechanical_freq: -0.34 gear_freq: -0.001721 changing_frequency initial 0
t: 8577.00 ref_freq: 300.00 electric_frequency: -1.62 hall_freq: 0.00 mechanical_freq: -0.32 gear_freq: -0.001624 changing_frequency initial 0
t: 8591.00 ref_freq: 300.00 electric_frequency: -1.46 hall_freq: 0.00 mechanical_freq: -0.29 gear_freq: -0.001460 changing_frequency initial 0
t: 8605.00 ref_freq: 300.00 electric_frequency: -1.19 hall_freq: 0.00 mechanical_freq: -0.24 gear_freq: -0.001188 changing_frequency initial 0
t: 8618.00 ref_freq: 300.00 electric_frequency: -0.98 hall_freq: 0.00 mechanical_freq: -0.20 gear_freq: -0.000977 changing_frequency initial 0
t: 8631.00 ref_freq: 300.00 electric_frequency: -0.83 hall_freq: 0.00 mechanical_freq: -0.17 gear_freq: -0.000829 changing_frequency initial 0
t: 8644.00 ref_freq: 300.00 electric_frequency: -0.63 hall_freq: 0.00 mechanical_freq: -0.13 gear_freq: -0.000634 changing_frequency initial 0
t: 8657.00 ref_freq: 300.00 electric_frequency: -0.44 hall_freq: 0.00 mechanical_freq: -0.09 gear_freq: -0.000438 changing_frequency initial 0
t: 8670.00 ref_freq: 300.00 electric_frequency: -0.34 hall_freq: 0.00 mechanical_freq: -0.07 gear_freq: -0.000338 changing_frequency initial 0
t: 8683.00 ref_freq: 300.00 electric_frequency: -0.10 hall_freq: 0.00 mechanical_freq: -0.02 gear_freq: -0.000101 changing_frequency initial 0
t: 8697.00 ref_freq: 300.00 electric_frequency: 0.04 hall_freq: 0.00 mechanical_freq: 0.01 gear_freq: 0.000036 changing_frequency initial 0
t: 8712.00 ref_freq: 300.00 electric_frequency: 0.24 hall_freq: 0.00 mechanical_freq: 0.05 gear_freq: 0.000235 changing_frequency initial 0
t: 8726.00 ref_freq: 300.00 electric_frequency: 0.38 hall_freq: 0.00 mechanical_freq: 0.08 gear_freq: 0.000376 changing_frequency initial 0
t: 8739.00 ref_freq: 300.00 electric_frequency: 0.49 hall_freq: 0.00 mechanical_freq: 0.10 gear_freq: 0.000488 changing_frequency initial 0
t: 8752.00 ref_freq: 300.00 electric_frequency: 0.62 hall_freq: 0.00 mechanical_freq: 0.12 gear_freq: 0.000615 changing_frequency initial 0
t: 8766.00 ref_freq: 300.00 electric_frequency: 0.81 hall_freq: 0.00 mechanical_freq: 0.16 gear_freq: 0.000810 changing_frequency initial 0
t: 8780.00 ref_freq: 300.00 electric_frequency: 0.95 hall_freq: 0.00 mechanical_freq: 0.19 gear_freq: 0.000950 changing_frequency initial 0
t: 8795.00 ref_freq: 300.00 electric_frequency: 1.07 hall_freq: 0.00 mechanical_freq: 0.21 gear_freq: 0.001065 changing_frequency initial 0
t: 8809.00 ref_freq: 300.00 electric_frequency: 1.16 hall_freq: 0.00 mechanical_freq: 0.23 gear_freq: 0.001157 changing_frequency initial 0
t: 8822.00 ref_freq: 300.00 electric_frequency: 1.25 hall_freq: 0.00 mechanical_freq: 0.25 gear_freq: 0.001249 changing_frequency initial 0
t: 8907.00 ref_freq: 300.00 electric_frequency: 1.74 hall_freq: 0.00 mechanical_freq: 0.35 gear_freq: 0.001742 changing_frequency initial 0
t: 8921.00 ref_freq: 300.00 electric_frequency: 1.78 hall_freq: 0.00 mechanical_freq: 0.36 gear_freq: 0.001782 changing_frequency initial 0
t: 8935.00 ref_freq: 300.00 electric_frequency: 1.85 hall_freq: 0.00 mechanical_freq: 0.37 gear_freq: 0.001848 changing_frequency initial 0
t: 8949.00 ref_freq: 300.00 electric_frequency: 1.91 hall_freq: 0.00 mechanical_freq: 0.38 gear_freq: 0.001915 changing_frequency initial 0
t: 8963.00 ref_freq: 300.00 electric_frequency: 1.89 hall_freq: 0.00 mechanical_freq: 0.38 gear_freq: 0.001888 changing_frequency initial 0
t: 8977.00 ref_freq: 300.00 electric_frequency: 1.93 hall_freq: 0.00 mechanical_freq: 0.39 gear_freq: 0.001930 changing_frequency initial 0
t: 8990.00 ref_freq: 300.00 electric_frequency: 1.98 hall_freq: 0.00 mechanical_freq: 0.40 gear_freq: 0.001982 changing_frequency initial 0
t: 9003.00 ref_freq: 300.00 electric_frequency: 1.94 hall_freq: 0.00 mechanical_freq: 0.39 gear_freq: 0.001936 changing_frequency initial 0
t: 9016.00 ref_freq: 300.00 electric_frequency: 1.97 hall_freq: 0.00 mechanical_freq: 0.39 gear_freq: 0.001965 changing_frequency initial 0
t: 9030.00 ref_freq: 300.00 electric_frequency: 1.98 hall_freq: 0.00 mechanical_freq: 0.40 gear_freq: 0.001982 changing_frequency initial 0
t: 9044.00 ref_freq: 300.00 electric_frequency: 1.89 hall_freq: 0.00 mechanical_freq: 0.38 gear_freq: 0.001890 changing_frequency initial 0
t: 9057.00 ref_freq: 300.00 electric_frequency: 1.93 hall_freq: 0.00 mechanical_freq: 0.39 gear_freq: 0.001928 changing_frequency initial 0
t: 9070.00 ref_freq: 300.00 electric_frequency: 1.96 hall_freq: 0.00 mechanical_freq: 0.39 gear_freq: 0.001961 changing_frequency initial 0
t: 9083.00 ref_freq: 300.00 electric_frequency: 1.91 hall_freq: 0.00 mechanical_freq: 0.38 gear_freq: 0.001914 changing_frequency initial 0
t: 9097.00 ref_freq: 300.00 electric_frequency: 1.88 hall_freq: 0.00 mechanical_freq: 0.38 gear_freq: 0.001879 changing_frequency initial 0
t: 9110.00 ref_freq: 300.00 electric_frequency: 1.84 hall_freq: 0.00 mechanical_freq: 0.37 gear_freq: 0.001838 changing_frequency initial 0
t: 9124.00 ref_freq: 300.00 electric_frequency: 1.80 hall_freq: 0.00 mechanical_freq: 0.36 gear_freq: 0.001804 changing_frequency initial 0
t: 9138.00 ref_freq: 300.00 electric_frequency: 1.83 hall_freq: 0.00 mechanical_freq: 0.37 gear_freq: 0.001831 changing_frequency initial 0
t: 9151.00 ref_freq: 300.00 electric_frequency: 1.72 hall_freq: 0.00 mechanical_freq: 0.34 gear_freq: 0.001722 changing_frequency initial 0
t: 9165.00 ref_freq: 300.00 electric_frequency: 1.71 hall_freq: 0.00 mechanical_freq: 0.34 gear_freq: 0.001710 changing_frequency initial 0
t: 9179.00 ref_freq: 300.00 electric_frequency: 1.62 hall_freq: 0.00 mechanical_freq: 0.32 gear_freq: 0.001623 changing_frequency initial 0
t: 9193.00 ref_freq: 300.00 electric_frequency: 1.53 hall_freq: 0.00 mechanical_freq: 0.31 gear_freq: 0.001532 changing_frequency initial 0
t: 9207.00 ref_freq: 300.00 electric_frequency: 1.44 hall_freq: 0.00 mechanical_freq: 0.29 gear_freq: 0.001439 changing_frequency initial 0
t: 9221.00 ref_freq: 300.00 electric_frequency: 1.42 hall_freq: 0.00 mechanical_freq: 0.28 gear_freq: 0.001417 changing_frequency initial 0
t: 9235.00 ref_freq: 300.00 electric_frequency: 1.25 hall_freq: 0.00 mechanical_freq: 0.25 gear_freq: 0.001250 changing_frequency initial 0
t: 9248.00 ref_freq: 300.00 electric_frequency: 1.19 hall_freq: 0.00 mechanical_freq: 0.24 gear_freq: 0.001186 changing_frequency initial 0
t: 9263.00 ref_freq: 300.00 electric_frequency: 0.99 hall_freq: 0.00 mechanical_freq: 0.20 gear_freq: 0.000992 changing_frequency initial 0
t: 9276.00 ref_freq: 300.00 electric_frequency: 0.92 hall_freq: 0.00 mechanical_freq: 0.18 gear_freq: 0.000918 changing_frequency initial 0
t: 9290.00 ref_freq: 300.00 electric_frequency: 0.81 hall_freq: 0.00 mechanical_freq: 0.16 gear_freq: 0.000807 changing_frequency initial 0
t: 9303.00 ref_freq: 300.00 electric_frequency: 0.74 hall_freq: 0.00 mechanical_freq: 0.15 gear_freq: 0.000744 changing_frequency initial 0
t: 9316.00 ref_freq: 300.00 electric_frequency: 0.59 hall_freq: 0.00 mechanical_freq: 0.12 gear_freq: 0.000594 changing_frequency initial 0
t: 9329.00 ref_freq: 300.00 electric_frequency: 0.42 hall_freq: 0.00 mechanical_freq: 0.08 gear_freq: 0.000419 changing_frequency initial 0
t: 9342.00 ref_freq: 300.00 electric_frequency: 0.27 hall_freq: 0.00 mechanical_freq: 0.05 gear_freq: 0.000274 changing_frequency initial 0
t: 9355.00 ref_freq: 300.00 electric_frequency: 0.10 hall_freq: 0.00 mechanical_freq: 0.02 gear_freq: 0.000098 changing_frequency initial 0
t: 9369.00 ref_freq: 300.00 electric_frequency: -0.02 hall_freq: 0.00 mechanical_freq: -0.00 gear_freq: -0.000024 changing_frequency initial 0
t: 9382.00 ref_freq: 300.00 electric_frequency: -0.24 hall_freq: 0.00 mechanical_freq: -0.05 gear_freq: -0.000239 changing_frequency initial 0
t: 9395.00 ref_freq: 300.00 electric_frequency: -0.39 hall_freq: 0.00 mechanical_freq: -0.08 gear_freq: -0.000392 changing_frequency initial 0
t: 9408.00 ref_freq: 300.00 electric_frequency: -0.55 hall_freq: 0.00 mechanical_freq: -0.11 gear_freq: -0.000548 changing_frequency initial 0
t: 9421.00 ref_freq: 300.00 electric_frequency: -0.81 hall_freq: 0.00 mechanical_freq: -0.16 gear_freq: -0.000810 changing_frequency initial 0
t: 9435.00 ref_freq: 300.00 electric_frequency: -0.93 hall_freq: 0.00 mechanical_freq: -0.19 gear_freq: -0.000931 changing_frequency initial 0
t: 9449.00 ref_freq: 300.00 electric_frequency: -1.15 hall_freq: 0.00 mechanical_freq: -0.23 gear_freq: -0.001151 changing_frequency initial 0
t: 9462.00 ref_freq: 300.00 electric_frequency: -1.35 hall_freq: 0.00 mechanical_freq: -0.27 gear_freq: -0.001349 changing_frequency initial 0
t: 9475.00 ref_freq: 300.00 electric_frequency: -1.51 hall_freq: 0.00 mechanical_freq: -0.30 gear_freq: -0.001509 changing_frequency initial 0
t: 9488.00 ref_freq: 300.00 electric_frequency: -1.75 hall_freq: 0.00 mechanical_freq: -0.35 gear_freq: -0.001746 changing_frequency initial 0
t: 9501.00 ref_freq: 300.00 electric_frequency: -1.92 hall_freq: 0.00 mechanical_freq: -0.38 gear_freq: -0.001924 changing_frequency initial 0
t: 9514.00 ref_freq: 300.00 electric_frequency: -2.07 hall_freq: 0.00 mechanical_freq: -0.41 gear_freq: -0.002070 changing_frequency initial 0
t: 9527.00 ref_freq: 300.00 electric_frequency: -2.20 hall_freq: 0.00 mechanical_freq: -0.44 gear_freq: -0.002195 changing_frequency initial 0
t: 9540.00 ref_freq: 300.00 electric_frequency: -2.33 hall_freq: 0.00 mechanical_freq: -0.47 gear_freq: -0.002333 changing_frequency initial 0
t: 9553.00 ref_freq: 300.00 electric_frequency: -2.46 hall_freq: 0.00 mechanical_freq: -0.49 gear_freq: -0.002464 changing_frequency initial 0
t: 9566.00 ref_freq: 300.00 electric_frequency: -2.61 hall_freq: 0.00 mechanical_freq: -0.52 gear_freq: -0.002614 changing_frequency initial 0
t: 9580.00 ref_freq: 300.00 electric_frequency: -2.70 hall_freq: 0.00 mechanical_freq: -0.54 gear_freq: -0.002702 changing_frequency initial 0
t: 9594.00 ref_freq: 300.00 electric_frequency: -2.73 hall_freq: 0.00 mechanical_freq: -0.55 gear_freq: -0.002728 changing_frequency initial 0
t: 9608.00 ref_freq: 300.00 electric_frequency: -2.82 hall_freq: 0.00 mechanical_freq: -0.56 gear_freq: -0.002823 changing_frequency initial 0
t: 9621.00 ref_freq: 300.00 electric_frequency: -2.87 hall_freq: 0.00 mechanical_freq: -0.57 gear_freq: -0.002875 changing_frequency initial 0
t: 9635.00 ref_freq: 300.00 electric_frequency: -2.89 hall_freq: 0.00 mechanical_freq: -0.58 gear_freq: -0.002886 changing_frequency initial 0
t: 9649.00 ref_freq: 300.00 electric_frequency: -2.88 hall_freq: 0.00 mechanical_freq: -0.58 gear_freq: -0.002880 changing_frequency initial 0
t: 9663.00 ref_freq: 300.00 electric_frequency: -2.82 hall_freq: 0.00 mechanical_freq: -0.56 gear_freq: -0.002823 changing_frequency initial 0
t: 9678.00 ref_freq: 300.00 electric_frequency: -2.72 hall_freq: 0.00 mechanical_freq: -0.54 gear_freq: -0.002720 changing_frequency initial 0
t: 9694.00 ref_freq: 300.00 electric_frequency: -2.56 hall_freq: 0.00 mechanical_freq: -0.51 gear_freq: -0.002560 changing_frequency initial 0
t: 9707.00 ref_freq: 300.00 electric_frequency: -2.43 hall_freq: 0.00 mechanical_freq: -0.49 gear_freq: -0.002426 changing_frequency initial 0
t: 9721.00 ref_freq: 300.00 electric_frequency: -2.24 hall_freq: 0.00 mechanical_freq: -0.45 gear_freq: -0.002239 changing_frequency initial 0
t: 9735.00 ref_freq: 300.00 electric_frequency: -2.11 hall_freq: 0.00 mechanical_freq: -0.42 gear_freq: -0.002114 changing_frequency initial 0
t: 9749.00 ref_freq: 300.00 electric_frequency: -1.94 hall_freq: 0.00 mechanical_freq: -0.39 gear_freq: -0.001941 changing_frequency initial 0
t: 9764.00 ref_freq: 300.00 electric_frequency: -1.75 hall_freq: 0.00 mechanical_freq: -0.35 gear_freq: -0.001748 changing_frequency initial 0
t: 9778.00 ref_freq: 300.00 electric_frequency: -1.60 hall_freq: 0.00 mechanical_freq: -0.32 gear_freq: -0.001596 changing_frequency initial 0
t: 9792.00 ref_freq: 300.00 electric_frequency: -1.38 hall_freq: 0.00 mechanical_freq: -0.28 gear_freq: -0.001383 changing_frequency initial 0
t: 9807.00 ref_freq: 300.00 electric_frequency: -1.14 hall_freq: 0.00 mechanical_freq: -0.23 gear_freq: -0.001140 changing_frequency initial 0
t: 9821.00 ref_freq: 300.00 electric_frequency: -0.95 hall_freq: 0.00 mechanical_freq: -0.19 gear_freq: -0.000949 changing_frequency initial 0
t: 9835.00 ref_freq: 300.00 electric_frequency: -0.78 hall_freq: 0.00 mechanical_freq: -0.16 gear_freq: -0.000776 changing_frequency initial 0
t: 9848.00 ref_freq: 300.00 electric_frequency: -0.57 hall_freq: 0.00 mechanical_freq: -0.11 gear_freq: -0.000569 changing_frequency initial 0
t: 9861.00 ref_freq: 300.00 electric_frequency: -0.40 hall_freq: 0.00 mechanical_freq: -0.08 gear_freq: -0.000403 changing_frequency initial 0
t: 9873.00 ref_freq: 300.00 electric_frequency: -0.28 hall_freq: 0.00 mechanical_freq: -0.06 gear_freq: -0.000277 changing_frequency initial 0
t: 9886.00 ref_freq: 300.00 electric_frequency: -0.07 hall_freq: 0.00 mechanical_freq: -0.01 gear_freq: -0.000074 changing_frequency initial 0
t: 9899.00 ref_freq: 300.00 electric_frequency: 0.11 hall_freq: 0.00 mechanical_freq: 0.02 gear_freq: 0.000105 changing_frequency initial 0
t: 9912.00 ref_freq: 300.00 electric_frequency: 0.24 hall_freq: 0.00 mechanical_freq: 0.05 gear_freq: 0.000242 changing_frequency initial 0
t: 9925.00 ref_freq: 300.00 electric_frequency: 0.38 hall_freq: 0.00 mechanical_freq: 0.08 gear_freq: 0.000384 changing_frequency initial 0
t: 9938.00 ref_freq: 300.00 electric_frequency: 0.51 hall_freq: 0.00 mechanical_freq: 0.10 gear_freq: 0.000512 changing_frequency initial 0
t: 9951.00 ref_freq: 300.00 electric_frequency: 0.66 hall_freq: 0.00 mechanical_freq: 0.13 gear_freq: 0.000661 changing_frequency initial 0
t: 9964.00 ref_freq: 300.00 electric_frequency: 0.80 hall_freq: 0.00 mechanical_freq: 0.16 gear_freq: 0.000803 changing_frequency initial 0
t: 9976.00 ref_freq: 300.00 electric_frequency: 0.88 hall_freq: 0.00 mechanical_freq: 0.18 gear_freq: 0.000883 changing_frequency initial 0
t: 9989.00 ref_freq: 300.00 electric_frequency: 1.02 hall_freq: 0.00 mechanical_freq: 0.20 gear_freq: 0.001020 changing_frequency initial 0
t: 10002.00 ref_freq: 300.00 electric_frequency: 1.13 hall_freq: 0.00 mechanical_freq: 0.23 gear_freq: 0.001131 changing_frequency initial 0
t: 10016.00 ref_freq: 300.00 electric_frequency: 1.22 hall_freq: 0.00 mechanical_freq: 0.24 gear_freq: 0.001224 changing_frequency initial 0
t: 10029.00 ref_freq: 300.00 electric_frequency: 1.34 hall_freq: 0.00 mechanical_freq: 0.27 gear_freq: 0.001337 changing_frequency initial 0
t: 10043.00 ref_freq: 300.00 electric_frequency: 1.41 hall_freq: 0.00 mechanical_freq: 0.28 gear_freq: 0.001413 changing_frequency initial 0
t: 10056.00 ref_freq: 300.00 electric_frequency: 1.47 hall_freq: 0.00 mechanical_freq: 0.29 gear_freq: 0.001471 changing_frequency initial 0
t: 10069.00 ref_freq: 300.00 electric_frequency: 1.56 hall_freq: 0.00 mechanical_freq: 0.31 gear_freq: 0.001556 changing_frequency initial 0
t: 10082.00 ref_freq: 300.00 electric_frequency: 1.62 hall_freq: 0.00 mechanical_freq: 0.32 gear_freq: 0.001624 changing_frequency initial 0
t: 10096.00 ref_freq: 300.00 electric_frequency: 1.68 hall_freq: 0.00 mechanical_freq: 0.34 gear_freq: 0.001685 changing_frequency initial 0
t: 10110.00 ref_freq: 300.00 electric_frequency: 1.69 hall_freq: 0.00 mechanical_freq: 0.34 gear_freq: 0.001687 changing_frequency initial 0
t: 10123.00 ref_freq: 300.00 electric_frequency: 1.79 hall_freq: 0.00 mechanical_freq: 0.36 gear_freq: 0.001788 changing_frequency initial 0
t: 10137.00 ref_freq: 300.00 electric_frequency: 1.84 hall_freq: 0.00 mechanical_freq: 0.37 gear_freq: 0.001842 changing_frequency initial 0
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
