arcoslab/open-coroco-legacy/src_DTC-SVM_Fixed_Testing/ADC_Measurements_Results/images/[Fri Apr 17 19:05:29 2015] [one 300 0, hall frequency controller, P =0.001]/[Fri Apr 17 19:05:29 2015] [one 300 0, hall frequency controller, P =0.001] data frequencies.csv

t t ref_freq ref_freq electric_frequency electric_frequency hall_freq hall_freq
t: 122.00 ref_freq: 300.00 electric_frequency: 1.83 hall_freq: 0.00 mechanical_freq: 0.37 gear_freq: 0.001827 changing_frequency initial 0
t: 122.00 ref_freq: 300.00 electric_frequency: 1.83 hall_freq: 0.00 mechanical_freq: 0.37 gear_freq: 0.001827 changing_frequency initial 0
t: 122.00 ref_freq: 300.00 electric_frequency: 1.83 hall_freq: 0.00 mechanical_freq: 0.37 gear_freq: 0.001827 changing_frequency initial 0
t: 122.00 ref_freq: 300.00 electric_frequency: 1.83 hall_freq: 0.00 mechanical_freq: 0.37 gear_freq: 0.001827 changing_frequency initial 0
t: 122.00 ref_freq: 300.00 electric_frequency: 1.83 hall_freq: 0.00 mechanical_freq: 0.37 gear_freq: 0.001827 changing_frequency initial 0
t: 122.00 ref_freq: 300.00 electric_frequency: 1.83 hall_freq: 0.00 mechanical_freq: 0.37 gear_freq: 0.001827 changing_frequency initial 0
t: 122.00 ref_freq: 300.00 electric_frequency: 1.83 hall_freq: 0.00 mechanical_freq: 0.37 gear_freq: 0.001827 changing_frequency initial 0
t: 122.00 ref_freq: 300.00 electric_frequency: 1.83 hall_freq: 0.00 mechanical_freq: 0.37 gear_freq: 0.001827 changing_frequency initial 0
t: 122.00 ref_freq: 300.00 electric_frequency: 1.83 hall_freq: 0.00 mechanical_freq: 0.37 gear_freq: 0.001827 changing_frequency initial 0
t: 122.00 ref_freq: 300.00 electric_frequency: 1.83 hall_freq: 0.00 mechanical_freq: 0.37 gear_freq: 0.001827 changing_frequency initial 0
t: 122.00 ref_freq: 300.00 electric_frequency: 1.83 hall_freq: 0.00 mechanical_freq: 0.37 gear_freq: 0.001827 changing_frequency initial 0
t: 122.00 ref_freq: 300.00 electric_frequency: 1.83 hall_freq: 0.00 mechanical_freq: 0.37 gear_freq: 0.001827 changing_frequency initial 0
t: 122.00 ref_freq: 300.00 electric_frequency: 1.83 hall_freq: 0.00 mechanical_freq: 0.37 gear_freq: 0.001827 changing_frequency initial 0
t: 122.00 ref_freq: 300.00 electric_frequency: 1.83 hall_freq: 0.00 mechanical_freq: 0.37 gear_freq: 0.001827 changing_frequency initial 0
t: 122.00 ref_freq: 300.00 electric_frequency: 1.83 hall_freq: 0.00 mechanical_freq: 0.37 gear_freq: 0.001827 changing_frequency initial 0
t: 142.00 ref_freq: 300.00 electric_frequency: 1.83 hall_freq: 0.00 mechanical_freq: 0.37 gear_freq: 0.001829 changing_frequency initial 0
t: 15.00 ref_freq: 300.00 electric_frequency: 1.73 hall_freq: 0.00 mechanical_freq: 0.35 gear_freq: 0.001731 changing_frequency initial 0
t: 29.00 ref_freq: 300.00 electric_frequency: 1.75 hall_freq: 0.00 mechanical_freq: 0.35 gear_freq: 0.001747 changing_frequency initial 0
t: 43.00 ref_freq: 300.00 electric_frequency: 1.67 hall_freq: 0.00 mechanical_freq: 0.33 gear_freq: 0.001673 changing_frequency initial 0
t: 57.00 ref_freq: 300.00 electric_frequency: 1.71 hall_freq: 0.00 mechanical_freq: 0.34 gear_freq: 0.001707 changing_frequency initial 0
t: 71.00 ref_freq: 300.00 electric_frequency: 1.47 hall_freq: 0.00 mechanical_freq: 0.29 gear_freq: 0.001467 changing_frequency initial 0
t: 85.00 ref_freq: 300.00 electric_frequency: 1.45 hall_freq: 0.00 mechanical_freq: 0.29 gear_freq: 0.001451 changing_frequency initial 0
t: 99.00 ref_freq: 300.00 electric_frequency: 1.42 hall_freq: 0.00 mechanical_freq: 0.28 gear_freq: 0.001420 changing_frequency initial 0
t: 113.00 ref_freq: 300.00 electric_frequency: 1.30 hall_freq: 0.00 mechanical_freq: 0.26 gear_freq: 0.001297 changing_frequency initial 0
t: 127.00 ref_freq: 300.00 electric_frequency: 1.22 hall_freq: 0.00 mechanical_freq: 0.24 gear_freq: 0.001218 changing_frequency initial 0
t: 141.00 ref_freq: 300.00 electric_frequency: 1.10 hall_freq: 0.00 mechanical_freq: 0.22 gear_freq: 0.001098 changing_frequency initial 0
t: 155.00 ref_freq: 300.00 electric_frequency: 1.00 hall_freq: 0.00 mechanical_freq: 0.20 gear_freq: 0.000998 changing_frequency initial 0
t: 169.00 ref_freq: 300.00 electric_frequency: 0.86 hall_freq: 0.00 mechanical_freq: 0.17 gear_freq: 0.000858 changing_frequency initial 0
t: 182.00 ref_freq: 300.00 electric_frequency: 0.82 hall_freq: 0.00 mechanical_freq: 0.16 gear_freq: 0.000823 changing_frequency initial 0
t: 195.00 ref_freq: 300.00 electric_frequency: 0.64 hall_freq: 0.00 mechanical_freq: 0.13 gear_freq: 0.000644 changing_frequency initial 0
t: 209.00 ref_freq: 300.00 electric_frequency: 0.49 hall_freq: 0.00 mechanical_freq: 0.10 gear_freq: 0.000489 changing_frequency initial 0
t: 223.00 ref_freq: 300.00 electric_frequency: 0.33 hall_freq: 0.00 mechanical_freq: 0.07 gear_freq: 0.000331 changing_frequency initial 0
t: 237.00 ref_freq: 300.00 electric_frequency: 0.17 hall_freq: 0.00 mechanical_freq: 0.03 gear_freq: 0.000174 changing_frequency initial 0
t: 252.00 ref_freq: 300.00 electric_frequency: 0.02 hall_freq: 0.00 mechanical_freq: 0.00 gear_freq: 0.000020 changing_frequency initial 0
t: 267.00 ref_freq: 300.00 electric_frequency: -0.20 hall_freq: 0.00 mechanical_freq: -0.04 gear_freq: -0.000195 changing_frequency initial 0
t: 282.00 ref_freq: 300.00 electric_frequency: -0.41 hall_freq: 0.00 mechanical_freq: -0.08 gear_freq: -0.000406 changing_frequency initial 0
t: 297.00 ref_freq: 300.00 electric_frequency: -0.59 hall_freq: 0.00 mechanical_freq: -0.12 gear_freq: -0.000591 changing_frequency initial 0
t: 312.00 ref_freq: 300.00 electric_frequency: -0.88 hall_freq: 0.00 mechanical_freq: -0.18 gear_freq: -0.000883 changing_frequency initial 0
t: 327.00 ref_freq: 300.00 electric_frequency: -1.02 hall_freq: 0.00 mechanical_freq: -0.20 gear_freq: -0.001023 changing_frequency initial 0
t: 341.00 ref_freq: 300.00 electric_frequency: -1.25 hall_freq: 0.00 mechanical_freq: -0.25 gear_freq: -0.001247 changing_frequency initial 0
t: 355.00 ref_freq: 300.00 electric_frequency: -1.45 hall_freq: 0.00 mechanical_freq: -0.29 gear_freq: -0.001454 changing_frequency initial 0
t: 369.00 ref_freq: 300.00 electric_frequency: -1.65 hall_freq: 0.00 mechanical_freq: -0.33 gear_freq: -0.001652 changing_frequency initial 0
t: 383.00 ref_freq: 300.00 electric_frequency: -1.87 hall_freq: 0.00 mechanical_freq: -0.37 gear_freq: -0.001867 changing_frequency initial 0
t: 397.00 ref_freq: 300.00 electric_frequency: -2.07 hall_freq: 0.00 mechanical_freq: -0.41 gear_freq: -0.002074 changing_frequency initial 0
t: 411.00 ref_freq: 300.00 electric_frequency: -2.26 hall_freq: 0.00 mechanical_freq: -0.45 gear_freq: -0.002258 changing_frequency initial 0
t: 425.00 ref_freq: 300.00 electric_frequency: -2.45 hall_freq: 0.00 mechanical_freq: -0.49 gear_freq: -0.002445 changing_frequency initial 0
t: 438.00 ref_freq: 300.00 electric_frequency: -2.66 hall_freq: 0.00 mechanical_freq: -0.53 gear_freq: -0.002662 changing_frequency initial 0
t: 451.00 ref_freq: 300.00 electric_frequency: -2.75 hall_freq: 0.00 mechanical_freq: -0.55 gear_freq: -0.002754 changing_frequency initial 0
t: 465.00 ref_freq: 300.00 electric_frequency: -2.86 hall_freq: 0.00 mechanical_freq: -0.57 gear_freq: -0.002860 changing_frequency initial 0
t: 479.00 ref_freq: 300.00 electric_frequency: -2.97 hall_freq: 0.00 mechanical_freq: -0.59 gear_freq: -0.002971 changing_frequency initial 0
t: 493.00 ref_freq: 300.00 electric_frequency: -3.09 hall_freq: 0.00 mechanical_freq: -0.62 gear_freq: -0.003092 changing_frequency initial 0
t: 507.00 ref_freq: 300.00 electric_frequency: -3.10 hall_freq: 0.00 mechanical_freq: -0.62 gear_freq: -0.003104 changing_frequency initial 0
t: 521.00 ref_freq: 300.00 electric_frequency: -3.15 hall_freq: 0.00 mechanical_freq: -0.63 gear_freq: -0.003146 changing_frequency initial 0
t: 535.00 ref_freq: 300.00 electric_frequency: -3.07 hall_freq: 0.00 mechanical_freq: -0.61 gear_freq: -0.003067 changing_frequency initial 0
t: 549.00 ref_freq: 300.00 electric_frequency: -3.12 hall_freq: 0.00 mechanical_freq: -0.62 gear_freq: -0.003115 changing_frequency initial 0
t: 563.00 ref_freq: 300.00 electric_frequency: -3.07 hall_freq: 0.00 mechanical_freq: -0.61 gear_freq: -0.003066 changing_frequency initial 0
t: 577.00 ref_freq: 300.00 electric_frequency: -2.96 hall_freq: 0.00 mechanical_freq: -0.59 gear_freq: -0.002956 changing_frequency initial 0
t: 591.00 ref_freq: 300.00 electric_frequency: -2.85 hall_freq: 0.00 mechanical_freq: -0.57 gear_freq: -0.002850 changing_frequency initial 0
t: 606.00 ref_freq: 300.00 electric_frequency: -2.65 hall_freq: 0.00 mechanical_freq: -0.53 gear_freq: -0.002652 changing_frequency initial 0
t: 621.00 ref_freq: 300.00 electric_frequency: -2.54 hall_freq: 0.00 mechanical_freq: -0.51 gear_freq: -0.002537 changing_frequency initial 0
t: 636.00 ref_freq: 300.00 electric_frequency: -2.34 hall_freq: 0.00 mechanical_freq: -0.47 gear_freq: -0.002344 changing_frequency initial 0
t: 650.00 ref_freq: 300.00 electric_frequency: -2.10 hall_freq: 0.00 mechanical_freq: -0.42 gear_freq: -0.002103 changing_frequency initial 0
t: 664.00 ref_freq: 300.00 electric_frequency: -1.83 hall_freq: 0.00 mechanical_freq: -0.37 gear_freq: -0.001826 changing_frequency initial 0
t: 678.00 ref_freq: 300.00 electric_frequency: -1.73 hall_freq: 0.00 mechanical_freq: -0.35 gear_freq: -0.001730 changing_frequency initial 0
t: 691.00 ref_freq: 300.00 electric_frequency: -1.52 hall_freq: 0.00 mechanical_freq: -0.30 gear_freq: -0.001519 changing_frequency initial 0
t: 705.00 ref_freq: 300.00 electric_frequency: -1.29 hall_freq: 0.00 mechanical_freq: -0.26 gear_freq: -0.001287 changing_frequency initial 0
t: 719.00 ref_freq: 300.00 electric_frequency: -1.10 hall_freq: 0.00 mechanical_freq: -0.22 gear_freq: -0.001095 changing_frequency initial 0
t: 732.00 ref_freq: 300.00 electric_frequency: -0.90 hall_freq: 0.00 mechanical_freq: -0.18 gear_freq: -0.000897 changing_frequency initial 0
t: 745.00 ref_freq: 300.00 electric_frequency: -0.67 hall_freq: 0.00 mechanical_freq: -0.13 gear_freq: -0.000673 changing_frequency initial 0
t: 759.00 ref_freq: 300.00 electric_frequency: -0.55 hall_freq: 0.00 mechanical_freq: -0.11 gear_freq: -0.000549 changing_frequency initial 0
t: 774.00 ref_freq: 300.00 electric_frequency: -0.25 hall_freq: 0.00 mechanical_freq: -0.05 gear_freq: -0.000247 changing_frequency initial 0
t: 788.00 ref_freq: 300.00 electric_frequency: -0.08 hall_freq: 0.00 mechanical_freq: -0.02 gear_freq: -0.000078 changing_frequency initial 0
t: 803.00 ref_freq: 300.00 electric_frequency: 0.10 hall_freq: 0.00 mechanical_freq: 0.02 gear_freq: 0.000100 changing_frequency initial 0
t: 817.00 ref_freq: 300.00 electric_frequency: 0.26 hall_freq: 0.00 mechanical_freq: 0.05 gear_freq: 0.000257 changing_frequency initial 0
t: 831.00 ref_freq: 300.00 electric_frequency: 0.43 hall_freq: 0.00 mechanical_freq: 0.09 gear_freq: 0.000434 changing_frequency initial 0
t: 844.00 ref_freq: 300.00 electric_frequency: 0.55 hall_freq: 0.00 mechanical_freq: 0.11 gear_freq: 0.000554 changing_frequency initial 0
t: 858.00 ref_freq: 300.00 electric_frequency: 0.72 hall_freq: 0.00 mechanical_freq: 0.14 gear_freq: 0.000724 changing_frequency initial 0
t: 871.00 ref_freq: 300.00 electric_frequency: 0.83 hall_freq: 0.00 mechanical_freq: 0.17 gear_freq: 0.000827 changing_frequency initial 0
t: 885.00 ref_freq: 300.00 electric_frequency: 0.96 hall_freq: 0.00 mechanical_freq: 0.19 gear_freq: 0.000955 changing_frequency initial 0
t: 898.00 ref_freq: 300.00 electric_frequency: 1.08 hall_freq: 0.00 mechanical_freq: 0.22 gear_freq: 0.001075 changing_frequency initial 0
t: 912.00 ref_freq: 300.00 electric_frequency: 1.17 hall_freq: 0.00 mechanical_freq: 0.23 gear_freq: 0.001170 changing_frequency initial 0
t: 926.00 ref_freq: 300.00 electric_frequency: 1.28 hall_freq: 0.00 mechanical_freq: 0.26 gear_freq: 0.001279 changing_frequency initial 0
t: 940.00 ref_freq: 300.00 electric_frequency: 1.38 hall_freq: 0.00 mechanical_freq: 0.28 gear_freq: 0.001381 changing_frequency initial 0
t: 954.00 ref_freq: 300.00 electric_frequency: 1.46 hall_freq: 0.00 mechanical_freq: 0.29 gear_freq: 0.001460 changing_frequency initial 0
t: 968.00 ref_freq: 300.00 electric_frequency: 1.53 hall_freq: 0.00 mechanical_freq: 0.31 gear_freq: 0.001534 changing_frequency initial 0
t: 982.00 ref_freq: 300.00 electric_frequency: 1.63 hall_freq: 0.00 mechanical_freq: 0.33 gear_freq: 0.001630 changing_frequency initial 0
t: 996.00 ref_freq: 300.00 electric_frequency: 1.69 hall_freq: 0.00 mechanical_freq: 0.34 gear_freq: 0.001688 changing_frequency initial 0
t: 1009.00 ref_freq: 300.00 electric_frequency: 1.77 hall_freq: 0.00 mechanical_freq: 0.35 gear_freq: 0.001766 changing_frequency initial 0
t: 1022.00 ref_freq: 300.00 electric_frequency: 1.81 hall_freq: 0.00 mechanical_freq: 0.36 gear_freq: 0.001812 changing_frequency initial 0
t: 1035.00 ref_freq: 300.00 electric_frequency: 1.83 hall_freq: 0.00 mechanical_freq: 0.37 gear_freq: 0.001830 changing_frequency initial 0
t: 1049.00 ref_freq: 300.00 electric_frequency: 1.80 hall_freq: 0.00 mechanical_freq: 0.36 gear_freq: 0.001804 changing_frequency initial 0
t: 1063.00 ref_freq: 300.00 electric_frequency: 1.93 hall_freq: 0.00 mechanical_freq: 0.39 gear_freq: 0.001932 changing_frequency initial 0
t: 1077.00 ref_freq: 300.00 electric_frequency: 1.96 hall_freq: 0.00 mechanical_freq: 0.39 gear_freq: 0.001963 changing_frequency initial 0
t: 1091.00 ref_freq: 300.00 electric_frequency: 1.98 hall_freq: 0.00 mechanical_freq: 0.40 gear_freq: 0.001983 changing_frequency initial 0
t: 1104.00 ref_freq: 300.00 electric_frequency: 1.98 hall_freq: 0.00 mechanical_freq: 0.40 gear_freq: 0.001976 changing_frequency initial 0
t: 1119.00 ref_freq: 300.00 electric_frequency: 1.89 hall_freq: 0.00 mechanical_freq: 0.38 gear_freq: 0.001894 changing_frequency initial 0
t: 1133.00 ref_freq: 300.00 electric_frequency: 1.94 hall_freq: 0.00 mechanical_freq: 0.39 gear_freq: 0.001937 changing_frequency initial 0
t: 1148.00 ref_freq: 300.00 electric_frequency: 1.98 hall_freq: 0.00 mechanical_freq: 0.40 gear_freq: 0.001982 changing_frequency initial 0
t: 1162.00 ref_freq: 300.00 electric_frequency: 1.89 hall_freq: 0.00 mechanical_freq: 0.38 gear_freq: 0.001890 changing_frequency initial 0
t: 1177.00 ref_freq: 300.00 electric_frequency: 1.94 hall_freq: 0.00 mechanical_freq: 0.39 gear_freq: 0.001943 changing_frequency initial 0
t: 1191.00 ref_freq: 300.00 electric_frequency: 1.89 hall_freq: 0.00 mechanical_freq: 0.38 gear_freq: 0.001892 changing_frequency initial 0
t: 1206.00 ref_freq: 300.00 electric_frequency: 1.85 hall_freq: 0.00 mechanical_freq: 0.37 gear_freq: 0.001846 changing_frequency initial 0
t: 1220.00 ref_freq: 300.00 electric_frequency: 1.82 hall_freq: 0.00 mechanical_freq: 0.36 gear_freq: 0.001821 changing_frequency initial 0
t: 1235.00 ref_freq: 300.00 electric_frequency: 1.80 hall_freq: 0.00 mechanical_freq: 0.36 gear_freq: 0.001797 changing_frequency initial 0
t: 1248.00 ref_freq: 300.00 electric_frequency: 1.72 hall_freq: 0.00 mechanical_freq: 0.34 gear_freq: 0.001720 changing_frequency initial 0
t: 1261.00 ref_freq: 300.00 electric_frequency: 1.65 hall_freq: 0.00 mechanical_freq: 0.33 gear_freq: 0.001653 changing_frequency initial 0
t: 1276.00 ref_freq: 300.00 electric_frequency: 1.61 hall_freq: 0.00 mechanical_freq: 0.32 gear_freq: 0.001610 changing_frequency initial 0
t: 1291.00 ref_freq: 300.00 electric_frequency: 1.51 hall_freq: 0.00 mechanical_freq: 0.30 gear_freq: 0.001510 changing_frequency initial 0
t: 1305.00 ref_freq: 300.00 electric_frequency: 1.43 hall_freq: 0.00 mechanical_freq: 0.29 gear_freq: 0.001428 changing_frequency initial 0
t: 1319.00 ref_freq: 300.00 electric_frequency: 1.34 hall_freq: 0.00 mechanical_freq: 0.27 gear_freq: 0.001342 changing_frequency initial 0
t: 1334.00 ref_freq: 300.00 electric_frequency: 1.31 hall_freq: 0.00 mechanical_freq: 0.26 gear_freq: 0.001307 changing_frequency initial 0
t: 1348.00 ref_freq: 300.00 electric_frequency: 1.17 hall_freq: 0.00 mechanical_freq: 0.23 gear_freq: 0.001175 changing_frequency initial 0
t: 1363.00 ref_freq: 300.00 electric_frequency: 1.02 hall_freq: 0.00 mechanical_freq: 0.20 gear_freq: 0.001017 changing_frequency initial 0
t: 1378.00 ref_freq: 300.00 electric_frequency: 0.88 hall_freq: 0.00 mechanical_freq: 0.18 gear_freq: 0.000877 changing_frequency initial 0
t: 1392.00 ref_freq: 300.00 electric_frequency: 0.76 hall_freq: 0.00 mechanical_freq: 0.15 gear_freq: 0.000756 changing_frequency initial 0
t: 1406.00 ref_freq: 300.00 electric_frequency: 0.64 hall_freq: 0.00 mechanical_freq: 0.13 gear_freq: 0.000643 changing_frequency initial 0
t: 1420.00 ref_freq: 300.00 electric_frequency: 0.49 hall_freq: 0.00 mechanical_freq: 0.10 gear_freq: 0.000486 changing_frequency initial 0
t: 1435.00 ref_freq: 300.00 electric_frequency: 0.30 hall_freq: 0.00 mechanical_freq: 0.06 gear_freq: 0.000299 changing_frequency initial 0
t: 1449.00 ref_freq: 300.00 electric_frequency: 0.18 hall_freq: 0.00 mechanical_freq: 0.04 gear_freq: 0.000179 changing_frequency initial 0
t: 1463.00 ref_freq: 300.00 electric_frequency: -0.02 hall_freq: 0.00 mechanical_freq: -0.00 gear_freq: -0.000024 changing_frequency initial 0
t: 1477.00 ref_freq: 300.00 electric_frequency: -0.18 hall_freq: 0.00 mechanical_freq: -0.04 gear_freq: -0.000178 changing_frequency initial 0
t: 1491.00 ref_freq: 300.00 electric_frequency: -0.35 hall_freq: 0.00 mechanical_freq: -0.07 gear_freq: -0.000353 changing_frequency initial 0
t: 1505.00 ref_freq: 300.00 electric_frequency: -0.56 hall_freq: 0.00 mechanical_freq: -0.11 gear_freq: -0.000563 changing_frequency initial 0
t: 1520.00 ref_freq: 300.00 electric_frequency: -0.74 hall_freq: 0.00 mechanical_freq: -0.15 gear_freq: -0.000742 changing_frequency initial 0
t: 1535.00 ref_freq: 300.00 electric_frequency: -0.99 hall_freq: 0.00 mechanical_freq: -0.20 gear_freq: -0.000986 changing_frequency initial 0
t: 1549.00 ref_freq: 300.00 electric_frequency: -1.19 hall_freq: 0.00 mechanical_freq: -0.24 gear_freq: -0.001195 changing_frequency initial 0
t: 1564.00 ref_freq: 300.00 electric_frequency: -1.41 hall_freq: 0.00 mechanical_freq: -0.28 gear_freq: -0.001410 changing_frequency initial 0
t: 1578.00 ref_freq: 300.00 electric_frequency: -1.59 hall_freq: 0.00 mechanical_freq: -0.32 gear_freq: -0.001591 changing_frequency initial 0
t: 1591.00 ref_freq: 300.00 electric_frequency: -1.83 hall_freq: 0.00 mechanical_freq: -0.37 gear_freq: -0.001833 changing_frequency initial 0
t: 1605.00 ref_freq: 300.00 electric_frequency: -1.97 hall_freq: 0.00 mechanical_freq: -0.39 gear_freq: -0.001973 changing_frequency initial 0
t: 1620.00 ref_freq: 300.00 electric_frequency: -2.14 hall_freq: 0.00 mechanical_freq: -0.43 gear_freq: -0.002140 changing_frequency initial 0
t: 1636.00 ref_freq: 300.00 electric_frequency: -2.34 hall_freq: 0.00 mechanical_freq: -0.47 gear_freq: -0.002343 changing_frequency initial 0
t: 1650.00 ref_freq: 300.00 electric_frequency: -2.44 hall_freq: 0.00 mechanical_freq: -0.49 gear_freq: -0.002436 changing_frequency initial 0
t: 1664.00 ref_freq: 300.00 electric_frequency: -2.65 hall_freq: 0.00 mechanical_freq: -0.53 gear_freq: -0.002652 changing_frequency initial 0
t: 1678.00 ref_freq: 300.00 electric_frequency: -2.65 hall_freq: 0.00 mechanical_freq: -0.53 gear_freq: -0.002652 changing_frequency initial 0
t: 1692.00 ref_freq: 300.00 electric_frequency: -2.79 hall_freq: 0.00 mechanical_freq: -0.56 gear_freq: -0.002788 changing_frequency initial 0
t: 1707.00 ref_freq: 300.00 electric_frequency: -2.87 hall_freq: 0.00 mechanical_freq: -0.57 gear_freq: -0.002871 changing_frequency initial 0
t: 1721.00 ref_freq: 300.00 electric_frequency: -2.87 hall_freq: 0.00 mechanical_freq: -0.57 gear_freq: -0.002869 changing_frequency initial 0
t: 1735.00 ref_freq: 300.00 electric_frequency: -2.87 hall_freq: 0.00 mechanical_freq: -0.57 gear_freq: -0.002871 changing_frequency initial 0
t: 1749.00 ref_freq: 300.00 electric_frequency: -2.86 hall_freq: 0.00 mechanical_freq: -0.57 gear_freq: -0.002858 changing_frequency initial 0
t: 1764.00 ref_freq: 300.00 electric_frequency: -2.80 hall_freq: 0.00 mechanical_freq: -0.56 gear_freq: -0.002804 changing_frequency initial 0
t: 1778.00 ref_freq: 300.00 electric_frequency: -2.70 hall_freq: 0.00 mechanical_freq: -0.54 gear_freq: -0.002698 changing_frequency initial 0
t: 1792.00 ref_freq: 300.00 electric_frequency: -2.64 hall_freq: 0.00 mechanical_freq: -0.53 gear_freq: -0.002636 changing_frequency initial 0
t: 1807.00 ref_freq: 300.00 electric_frequency: -2.42 hall_freq: 0.00 mechanical_freq: -0.48 gear_freq: -0.002420 changing_frequency initial 0
t: 1821.00 ref_freq: 300.00 electric_frequency: -2.29 hall_freq: 0.00 mechanical_freq: -0.46 gear_freq: -0.002290 changing_frequency initial 0
t: 1852.00 ref_freq: 300.00 electric_frequency: -1.94 hall_freq: 0.00 mechanical_freq: -0.39 gear_freq: -0.001943 changing_frequency initial 0
t: 1866.00 ref_freq: 300.00 electric_frequency: -1.76 hall_freq: 0.00 mechanical_freq: -0.35 gear_freq: -0.001757 changing_frequency initial 0
t: 1880.00 ref_freq: 300.00 electric_frequency: -1.51 hall_freq: 0.00 mechanical_freq: -0.30 gear_freq: -0.001510 changing_frequency initial 0
t: 1894.00 ref_freq: 300.00 electric_frequency: -1.34 hall_freq: 0.00 mechanical_freq: -0.27 gear_freq: -0.001338 changing_frequency initial 0
t: 1907.00 ref_freq: 300.00 electric_frequency: -1.16 hall_freq: 0.00 mechanical_freq: -0.23 gear_freq: -0.001160 changing_frequency initial 0
t: 1920.00 ref_freq: 300.00 electric_frequency: -1.00 hall_freq: 0.00 mechanical_freq: -0.20 gear_freq: -0.000997 changing_frequency initial 0
t: 1933.00 ref_freq: 300.00 electric_frequency: -0.80 hall_freq: 0.00 mechanical_freq: -0.16 gear_freq: -0.000804 changing_frequency initial 0
t: 1946.00 ref_freq: 300.00 electric_frequency: -0.60 hall_freq: 0.00 mechanical_freq: -0.12 gear_freq: -0.000602 changing_frequency initial 0
t: 1959.00 ref_freq: 300.00 electric_frequency: -0.41 hall_freq: 0.00 mechanical_freq: -0.08 gear_freq: -0.000405 changing_frequency initial 0
t: 1972.00 ref_freq: 300.00 electric_frequency: -0.28 hall_freq: 0.00 mechanical_freq: -0.06 gear_freq: -0.000278 changing_frequency initial 0
t: 1985.00 ref_freq: 300.00 electric_frequency: -0.06 hall_freq: 0.00 mechanical_freq: -0.01 gear_freq: -0.000056 changing_frequency initial 0
t: 1997.00 ref_freq: 300.00 electric_frequency: 0.06 hall_freq: 0.00 mechanical_freq: 0.01 gear_freq: 0.000065 changing_frequency initial 0
t: 2010.00 ref_freq: 300.00 electric_frequency: 0.24 hall_freq: 0.00 mechanical_freq: 0.05 gear_freq: 0.000237 changing_frequency initial 0
t: 2024.00 ref_freq: 300.00 electric_frequency: 0.37 hall_freq: 0.00 mechanical_freq: 0.07 gear_freq: 0.000370 changing_frequency initial 0
t: 2051.00 ref_freq: 300.00 electric_frequency: 0.69 hall_freq: 0.00 mechanical_freq: 0.14 gear_freq: 0.000687 changing_frequency initial 0
t: 2064.00 ref_freq: 300.00 electric_frequency: 0.80 hall_freq: 0.00 mechanical_freq: 0.16 gear_freq: 0.000804 changing_frequency initial 0
t: 2078.00 ref_freq: 300.00 electric_frequency: 0.94 hall_freq: 0.00 mechanical_freq: 0.19 gear_freq: 0.000941 changing_frequency initial 0
t: 2091.00 ref_freq: 300.00 electric_frequency: 1.04 hall_freq: 0.00 mechanical_freq: 0.21 gear_freq: 0.001039 changing_frequency initial 0
t: 2105.00 ref_freq: 300.00 electric_frequency: 1.16 hall_freq: 0.00 mechanical_freq: 0.23 gear_freq: 0.001163 changing_frequency initial 0
t: 2117.00 ref_freq: 300.00 electric_frequency: 1.25 hall_freq: 0.00 mechanical_freq: 0.25 gear_freq: 0.001251 changing_frequency initial 0
t: 2131.00 ref_freq: 300.00 electric_frequency: 1.33 hall_freq: 0.00 mechanical_freq: 0.27 gear_freq: 0.001326 changing_frequency initial 0
t: 2144.00 ref_freq: 300.00 electric_frequency: 1.44 hall_freq: 0.00 mechanical_freq: 0.29 gear_freq: 0.001438 changing_frequency initial 0
t: 2157.00 ref_freq: 300.00 electric_frequency: 1.50 hall_freq: 0.00 mechanical_freq: 0.30 gear_freq: 0.001499 changing_frequency initial 0
t: 2171.00 ref_freq: 300.00 electric_frequency: 1.55 hall_freq: 0.00 mechanical_freq: 0.31 gear_freq: 0.001549 changing_frequency initial 0
t: 2184.00 ref_freq: 300.00 electric_frequency: 1.58 hall_freq: 0.00 mechanical_freq: 0.32 gear_freq: 0.001578 changing_frequency initial 0
t: 2197.00 ref_freq: 300.00 electric_frequency: 1.69 hall_freq: 0.00 mechanical_freq: 0.34 gear_freq: 0.001690 changing_frequency initial 0
t: 2224.00 ref_freq: 300.00 electric_frequency: 1.79 hall_freq: 0.00 mechanical_freq: 0.36 gear_freq: 0.001793 changing_frequency initial 0
t: 2239.00 ref_freq: 300.00 electric_frequency: 1.85 hall_freq: 0.00 mechanical_freq: 0.37 gear_freq: 0.001846 changing_frequency initial 0
t: 2252.00 ref_freq: 300.00 electric_frequency: 1.88 hall_freq: 0.00 mechanical_freq: 0.38 gear_freq: 0.001881 changing_frequency initial 0
t: 2266.00 ref_freq: 300.00 electric_frequency: 1.90 hall_freq: 0.00 mechanical_freq: 0.38 gear_freq: 0.001897 changing_frequency initial 0
t: 2280.00 ref_freq: 300.00 electric_frequency: 1.93 hall_freq: 0.00 mechanical_freq: 0.39 gear_freq: 0.001926 changing_frequency initial 0
t: 2294.00 ref_freq: 300.00 electric_frequency: 1.94 hall_freq: 0.00 mechanical_freq: 0.39 gear_freq: 0.001941 changing_frequency initial 0
t: 2307.00 ref_freq: 300.00 electric_frequency: 1.97 hall_freq: 0.00 mechanical_freq: 0.39 gear_freq: 0.001972 changing_frequency initial 0
t: 2321.00 ref_freq: 300.00 electric_frequency: 1.96 hall_freq: 0.00 mechanical_freq: 0.39 gear_freq: 0.001960 changing_frequency initial 0
t: 2334.00 ref_freq: 300.00 electric_frequency: 1.95 hall_freq: 0.00 mechanical_freq: 0.39 gear_freq: 0.001947 changing_frequency initial 0
t: 2348.00 ref_freq: 300.00 electric_frequency: 1.97 hall_freq: 0.00 mechanical_freq: 0.39 gear_freq: 0.001971 changing_frequency initial 0
t: 2361.00 ref_freq: 300.00 electric_frequency: 1.96 hall_freq: 0.00 mechanical_freq: 0.39 gear_freq: 0.001962 changing_frequency initial 0
t: 2374.00 ref_freq: 300.00 electric_frequency: 1.93 hall_freq: 0.00 mechanical_freq: 0.39 gear_freq: 0.001925 changing_frequency initial 0
t: 2387.00 ref_freq: 300.00 electric_frequency: 1.90 hall_freq: 0.00 mechanical_freq: 0.38 gear_freq: 0.001904 changing_frequency initial 0
t: 2400.00 ref_freq: 300.00 electric_frequency: 1.88 hall_freq: 0.00 mechanical_freq: 0.38 gear_freq: 0.001879 changing_frequency initial 0
t: 2414.00 ref_freq: 300.00 electric_frequency: 1.80 hall_freq: 0.00 mechanical_freq: 0.36 gear_freq: 0.001797 changing_frequency initial 0
t: 2428.00 ref_freq: 300.00 electric_frequency: 1.80 hall_freq: 0.00 mechanical_freq: 0.36 gear_freq: 0.001798 changing_frequency initial 0
t: 2442.00 ref_freq: 300.00 electric_frequency: 1.81 hall_freq: 0.00 mechanical_freq: 0.36 gear_freq: 0.001809 changing_frequency initial 0
t: 2455.00 ref_freq: 300.00 electric_frequency: 1.69 hall_freq: 0.00 mechanical_freq: 0.34 gear_freq: 0.001691 changing_frequency initial 0
t: 2470.00 ref_freq: 300.00 electric_frequency: 1.63 hall_freq: 0.00 mechanical_freq: 0.33 gear_freq: 0.001634 changing_frequency initial 0
t: 2483.00 ref_freq: 300.00 electric_frequency: 1.55 hall_freq: 0.00 mechanical_freq: 0.31 gear_freq: 0.001550 changing_frequency initial 0
t: 2497.00 ref_freq: 300.00 electric_frequency: 1.50 hall_freq: 0.00 mechanical_freq: 0.30 gear_freq: 0.001505 changing_frequency initial 0
t: 2511.00 ref_freq: 300.00 electric_frequency: 1.41 hall_freq: 0.00 mechanical_freq: 0.28 gear_freq: 0.001414 changing_frequency initial 0
t: 2526.00 ref_freq: 300.00 electric_frequency: 1.34 hall_freq: 0.00 mechanical_freq: 0.27 gear_freq: 0.001340 changing_frequency initial 0
t: 2540.00 ref_freq: 300.00 electric_frequency: 1.25 hall_freq: 0.00 mechanical_freq: 0.25 gear_freq: 0.001250 changing_frequency initial 0
t: 2554.00 ref_freq: 300.00 electric_frequency: 1.11 hall_freq: 0.00 mechanical_freq: 0.22 gear_freq: 0.001109 changing_frequency initial 0
t: 2567.00 ref_freq: 300.00 electric_frequency: 0.98 hall_freq: 0.00 mechanical_freq: 0.20 gear_freq: 0.000984 changing_frequency initial 0
t: 2580.00 ref_freq: 300.00 electric_frequency: 0.90 hall_freq: 0.00 mechanical_freq: 0.18 gear_freq: 0.000898 changing_frequency initial 0
t: 2594.00 ref_freq: 300.00 electric_frequency: 0.76 hall_freq: 0.00 mechanical_freq: 0.15 gear_freq: 0.000763 changing_frequency initial 0
t: 2609.00 ref_freq: 300.00 electric_frequency: 0.62 hall_freq: 0.00 mechanical_freq: 0.12 gear_freq: 0.000624 changing_frequency initial 0
t: 2623.00 ref_freq: 300.00 electric_frequency: 0.47 hall_freq: 0.00 mechanical_freq: 0.09 gear_freq: 0.000475 changing_frequency initial 0
t: 2636.00 ref_freq: 300.00 electric_frequency: 0.35 hall_freq: 0.00 mechanical_freq: 0.07 gear_freq: 0.000353 changing_frequency initial 0
t: 2651.00 ref_freq: 300.00 electric_frequency: 0.16 hall_freq: 0.00 mechanical_freq: 0.03 gear_freq: 0.000162 changing_frequency initial 0
t: 2666.00 ref_freq: 300.00 electric_frequency: -0.04 hall_freq: 0.00 mechanical_freq: -0.01 gear_freq: -0.000043 changing_frequency initial 0
t: 2680.00 ref_freq: 300.00 electric_frequency: -0.23 hall_freq: 0.00 mechanical_freq: -0.05 gear_freq: -0.000227 changing_frequency initial 0
t: 2694.00 ref_freq: 300.00 electric_frequency: -0.41 hall_freq: 0.00 mechanical_freq: -0.08 gear_freq: -0.000414 changing_frequency initial 0
t: 2708.00 ref_freq: 300.00 electric_frequency: -0.60 hall_freq: 0.00 mechanical_freq: -0.12 gear_freq: -0.000596 changing_frequency initial 0
t: 2721.00 ref_freq: 300.00 electric_frequency: -0.78 hall_freq: 0.00 mechanical_freq: -0.16 gear_freq: -0.000781 changing_frequency initial 0
t: 2735.00 ref_freq: 300.00 electric_frequency: -0.96 hall_freq: 0.00 mechanical_freq: -0.19 gear_freq: -0.000962 changing_frequency initial 0
t: 2748.00 ref_freq: 300.00 electric_frequency: -1.16 hall_freq: 0.00 mechanical_freq: -0.23 gear_freq: -0.001155 changing_frequency initial 0
t: 2761.00 ref_freq: 300.00 electric_frequency: -1.34 hall_freq: 0.00 mechanical_freq: -0.27 gear_freq: -0.001337 changing_frequency initial 0
t: 2775.00 ref_freq: 300.00 electric_frequency: -1.53 hall_freq: 0.00 mechanical_freq: -0.31 gear_freq: -0.001531 changing_frequency initial 0
t: 2789.00 ref_freq: 300.00 electric_frequency: -1.74 hall_freq: 0.00 mechanical_freq: -0.35 gear_freq: -0.001744 changing_frequency initial 0
t: 2803.00 ref_freq: 300.00 electric_frequency: -1.93 hall_freq: 0.00 mechanical_freq: -0.39 gear_freq: -0.001925 changing_frequency initial 0
t: 2817.00 ref_freq: 300.00 electric_frequency: -2.16 hall_freq: 0.00 mechanical_freq: -0.43 gear_freq: -0.002156 changing_frequency initial 0
t: 2831.00 ref_freq: 300.00 electric_frequency: -2.27 hall_freq: 0.00 mechanical_freq: -0.45 gear_freq: -0.002273 changing_frequency initial 0
t: 2844.00 ref_freq: 300.00 electric_frequency: -2.44 hall_freq: 0.00 mechanical_freq: -0.49 gear_freq: -0.002442 changing_frequency initial 0
t: 2858.00 ref_freq: 300.00 electric_frequency: -2.59 hall_freq: 0.00 mechanical_freq: -0.52 gear_freq: -0.002590 changing_frequency initial 0
t: 2871.00 ref_freq: 300.00 electric_frequency: -2.69 hall_freq: 0.00 mechanical_freq: -0.54 gear_freq: -0.002685 changing_frequency initial 0
t: 2884.00 ref_freq: 300.00 electric_frequency: -2.75 hall_freq: 0.00 mechanical_freq: -0.55 gear_freq: -0.002751 changing_frequency initial 0
t: 2898.00 ref_freq: 300.00 electric_frequency: -2.83 hall_freq: 0.00 mechanical_freq: -0.57 gear_freq: -0.002833 changing_frequency initial 0
t: 2911.00 ref_freq: 300.00 electric_frequency: -2.82 hall_freq: 0.00 mechanical_freq: -0.56 gear_freq: -0.002821 changing_frequency initial 0
t: 2925.00 ref_freq: 300.00 electric_frequency: -2.92 hall_freq: 0.00 mechanical_freq: -0.58 gear_freq: -0.002918 changing_frequency initial 0
t: 2938.00 ref_freq: 300.00 electric_frequency: -2.79 hall_freq: 0.00 mechanical_freq: -0.56 gear_freq: -0.002787 changing_frequency initial 0
t: 2951.00 ref_freq: 300.00 electric_frequency: -2.85 hall_freq: 0.00 mechanical_freq: -0.57 gear_freq: -0.002846 changing_frequency initial 0
t: 2965.00 ref_freq: 300.00 electric_frequency: -2.75 hall_freq: 0.00 mechanical_freq: -0.55 gear_freq: -0.002752 changing_frequency initial 0
t: 2979.00 ref_freq: 300.00 electric_frequency: -2.63 hall_freq: 0.00 mechanical_freq: -0.53 gear_freq: -0.002629 changing_frequency initial 0
t: 2994.00 ref_freq: 300.00 electric_frequency: -2.53 hall_freq: 0.00 mechanical_freq: -0.51 gear_freq: -0.002530 changing_frequency initial 0
t: 3009.00 ref_freq: 300.00 electric_frequency: -2.43 hall_freq: 0.00 mechanical_freq: -0.49 gear_freq: -0.002432 changing_frequency initial 0
t: 3024.00 ref_freq: 300.00 electric_frequency: -2.20 hall_freq: 0.00 mechanical_freq: -0.44 gear_freq: -0.002197 changing_frequency initial 0
t: 3038.00 ref_freq: 300.00 electric_frequency: -2.19 hall_freq: 0.00 mechanical_freq: -0.44 gear_freq: -0.002186 changing_frequency initial 0
t: 3052.00 ref_freq: 300.00 electric_frequency: -1.94 hall_freq: 0.00 mechanical_freq: -0.39 gear_freq: -0.001939 changing_frequency initial 0
t: 3067.00 ref_freq: 300.00 electric_frequency: -1.74 hall_freq: 0.00 mechanical_freq: -0.35 gear_freq: -0.001740 changing_frequency initial 0
t: 3082.00 ref_freq: 300.00 electric_frequency: -1.49 hall_freq: 0.00 mechanical_freq: -0.30 gear_freq: -0.001494 changing_frequency initial 0
t: 3097.00 ref_freq: 300.00 electric_frequency: -1.25 hall_freq: 0.00 mechanical_freq: -0.25 gear_freq: -0.001250 changing_frequency initial 0
t: 3111.00 ref_freq: 300.00 electric_frequency: -1.08 hall_freq: 0.00 mechanical_freq: -0.22 gear_freq: -0.001082 changing_frequency initial 0
t: 3124.00 ref_freq: 300.00 electric_frequency: -0.88 hall_freq: 0.00 mechanical_freq: -0.18 gear_freq: -0.000881 changing_frequency initial 0
t: 3137.00 ref_freq: 300.00 electric_frequency: -0.69 hall_freq: 0.00 mechanical_freq: -0.14 gear_freq: -0.000692 changing_frequency initial 0
t: 3151.00 ref_freq: 300.00 electric_frequency: -0.49 hall_freq: 0.00 mechanical_freq: -0.10 gear_freq: -0.000488 changing_frequency initial 0
t: 3164.00 ref_freq: 300.00 electric_frequency: -0.34 hall_freq: 0.00 mechanical_freq: -0.07 gear_freq: -0.000343 changing_frequency initial 0
t: 3179.00 ref_freq: 300.00 electric_frequency: -0.12 hall_freq: 0.00 mechanical_freq: -0.02 gear_freq: -0.000121 changing_frequency initial 0
t: 3192.00 ref_freq: 300.00 electric_frequency: 0.02 hall_freq: 0.00 mechanical_freq: 0.00 gear_freq: 0.000023 changing_frequency initial 0
t: 3207.00 ref_freq: 300.00 electric_frequency: 0.15 hall_freq: 0.00 mechanical_freq: 0.03 gear_freq: 0.000150 changing_frequency initial 0
t: 3221.00 ref_freq: 300.00 electric_frequency: 0.37 hall_freq: 0.00 mechanical_freq: 0.07 gear_freq: 0.000368 changing_frequency initial 0
t: 3235.00 ref_freq: 300.00 electric_frequency: 0.53 hall_freq: 0.00 mechanical_freq: 0.11 gear_freq: 0.000528 changing_frequency initial 0
t: 3248.00 ref_freq: 300.00 electric_frequency: 0.64 hall_freq: 0.00 mechanical_freq: 0.13 gear_freq: 0.000637 changing_frequency initial 0
t: 3262.00 ref_freq: 300.00 electric_frequency: 0.80 hall_freq: 0.00 mechanical_freq: 0.16 gear_freq: 0.000795 changing_frequency initial 0
t: 3277.00 ref_freq: 300.00 electric_frequency: 0.85 hall_freq: 0.00 mechanical_freq: 0.17 gear_freq: 0.000853 changing_frequency initial 0
t: 3290.00 ref_freq: 300.00 electric_frequency: 1.04 hall_freq: 0.00 mechanical_freq: 0.21 gear_freq: 0.001044 changing_frequency initial 0
t: 3302.00 ref_freq: 300.00 electric_frequency: 1.12 hall_freq: 0.00 mechanical_freq: 0.22 gear_freq: 0.001117 changing_frequency initial 0
t: 3315.00 ref_freq: 300.00 electric_frequency: 1.23 hall_freq: 0.00 mechanical_freq: 0.25 gear_freq: 0.001232 changing_frequency initial 0
t: 3328.00 ref_freq: 300.00 electric_frequency: 1.30 hall_freq: 0.00 mechanical_freq: 0.26 gear_freq: 0.001298 changing_frequency initial 0
t: 3341.00 ref_freq: 300.00 electric_frequency: 1.40 hall_freq: 0.00 mechanical_freq: 0.28 gear_freq: 0.001404 changing_frequency initial 0
t: 3354.00 ref_freq: 300.00 electric_frequency: 1.51 hall_freq: 0.00 mechanical_freq: 0.30 gear_freq: 0.001508 changing_frequency initial 0
t: 3367.00 ref_freq: 300.00 electric_frequency: 1.56 hall_freq: 0.00 mechanical_freq: 0.31 gear_freq: 0.001561 changing_frequency initial 0
t: 3380.00 ref_freq: 300.00 electric_frequency: 1.63 hall_freq: 0.00 mechanical_freq: 0.33 gear_freq: 0.001629 changing_frequency initial 0
t: 3393.00 ref_freq: 300.00 electric_frequency: 1.68 hall_freq: 0.00 mechanical_freq: 0.34 gear_freq: 0.001678 changing_frequency initial 0
t: 3406.00 ref_freq: 300.00 electric_frequency: 1.67 hall_freq: 0.00 mechanical_freq: 0.33 gear_freq: 0.001673 changing_frequency initial 0
t: 3422.00 ref_freq: 300.00 electric_frequency: 1.79 hall_freq: 0.00 mechanical_freq: 0.36 gear_freq: 0.001790 changing_frequency initial 0
t: 3436.00 ref_freq: 300.00 electric_frequency: 1.84 hall_freq: 0.00 mechanical_freq: 0.37 gear_freq: 0.001841 changing_frequency initial 0
t: 3451.00 ref_freq: 300.00 electric_frequency: 1.86 hall_freq: 0.00 mechanical_freq: 0.37 gear_freq: 0.001864 changing_frequency initial 0
t: 3464.00 ref_freq: 300.00 electric_frequency: 1.83 hall_freq: 0.00 mechanical_freq: 0.37 gear_freq: 0.001833 changing_frequency initial 0
t: 3477.00 ref_freq: 300.00 electric_frequency: 1.91 hall_freq: 0.00 mechanical_freq: 0.38 gear_freq: 0.001910 changing_frequency initial 0
t: 3491.00 ref_freq: 300.00 electric_frequency: 1.95 hall_freq: 0.00 mechanical_freq: 0.39 gear_freq: 0.001952 changing_frequency initial 0
t: 3505.00 ref_freq: 300.00 electric_frequency: 1.89 hall_freq: 0.00 mechanical_freq: 0.38 gear_freq: 0.001891 changing_frequency initial 0
t: 3519.00 ref_freq: 300.00 electric_frequency: 1.95 hall_freq: 0.00 mechanical_freq: 0.39 gear_freq: 0.001951 changing_frequency initial 0
t: 3534.00 ref_freq: 300.00 electric_frequency: 1.98 hall_freq: 0.00 mechanical_freq: 0.40 gear_freq: 0.001982 changing_frequency initial 0
t: 3549.00 ref_freq: 300.00 electric_frequency: 1.95 hall_freq: 0.00 mechanical_freq: 0.39 gear_freq: 0.001945 changing_frequency initial 0
t: 3562.00 ref_freq: 300.00 electric_frequency: 1.93 hall_freq: 0.00 mechanical_freq: 0.39 gear_freq: 0.001929 changing_frequency initial 0
t: 3577.00 ref_freq: 300.00 electric_frequency: 1.92 hall_freq: 0.00 mechanical_freq: 0.38 gear_freq: 0.001918 changing_frequency initial 0
t: 3592.00 ref_freq: 300.00 electric_frequency: 1.93 hall_freq: 0.00 mechanical_freq: 0.39 gear_freq: 0.001934 changing_frequency initial 0
t: 3606.00 ref_freq: 300.00 electric_frequency: 1.87 hall_freq: 0.00 mechanical_freq: 0.37 gear_freq: 0.001867 changing_frequency initial 0
t: 3619.00 ref_freq: 300.00 electric_frequency: 1.87 hall_freq: 0.00 mechanical_freq: 0.37 gear_freq: 0.001874 changing_frequency initial 0
t: 3632.00 ref_freq: 300.00 electric_frequency: 1.73 hall_freq: 0.00 mechanical_freq: 0.35 gear_freq: 0.001729 changing_frequency initial 0
t: 3646.00 ref_freq: 300.00 electric_frequency: 1.78 hall_freq: 0.00 mechanical_freq: 0.36 gear_freq: 0.001776 changing_frequency initial 0
t: 3662.00 ref_freq: 300.00 electric_frequency: 1.72 hall_freq: 0.00 mechanical_freq: 0.34 gear_freq: 0.001721 changing_frequency initial 0
t: 3675.00 ref_freq: 300.00 electric_frequency: 1.55 hall_freq: 0.00 mechanical_freq: 0.31 gear_freq: 0.001555 changing_frequency initial 0
t: 3690.00 ref_freq: 300.00 electric_frequency: 1.55 hall_freq: 0.00 mechanical_freq: 0.31 gear_freq: 0.001548 changing_frequency initial 0
t: 3704.00 ref_freq: 300.00 electric_frequency: 1.46 hall_freq: 0.00 mechanical_freq: 0.29 gear_freq: 0.001464 changing_frequency initial 0
t: 3718.00 ref_freq: 300.00 electric_frequency: 1.31 hall_freq: 0.00 mechanical_freq: 0.26 gear_freq: 0.001312 changing_frequency initial 0
t: 3732.00 ref_freq: 300.00 electric_frequency: 1.29 hall_freq: 0.00 mechanical_freq: 0.26 gear_freq: 0.001292 changing_frequency initial 0
t: 3746.00 ref_freq: 300.00 electric_frequency: 1.18 hall_freq: 0.00 mechanical_freq: 0.24 gear_freq: 0.001176 changing_frequency initial 0
t: 3761.00 ref_freq: 300.00 electric_frequency: 1.10 hall_freq: 0.00 mechanical_freq: 0.22 gear_freq: 0.001098 changing_frequency initial 0
t: 3775.00 ref_freq: 300.00 electric_frequency: 0.94 hall_freq: 0.00 mechanical_freq: 0.19 gear_freq: 0.000937 changing_frequency initial 0
t: 3789.00 ref_freq: 300.00 electric_frequency: 0.82 hall_freq: 0.00 mechanical_freq: 0.16 gear_freq: 0.000820 changing_frequency initial 0
t: 3802.00 ref_freq: 300.00 electric_frequency: 0.67 hall_freq: 0.00 mechanical_freq: 0.13 gear_freq: 0.000673 changing_frequency initial 0
t: 3816.00 ref_freq: 300.00 electric_frequency: 0.56 hall_freq: 0.00 mechanical_freq: 0.11 gear_freq: 0.000564 changing_frequency initial 0
t: 3831.00 ref_freq: 300.00 electric_frequency: 0.38 hall_freq: 0.00 mechanical_freq: 0.08 gear_freq: 0.000377 changing_frequency initial 0
t: 3845.00 ref_freq: 300.00 electric_frequency: 0.22 hall_freq: 0.00 mechanical_freq: 0.04 gear_freq: 0.000216 changing_frequency initial 0
t: 3860.00 ref_freq: 300.00 electric_frequency: 0.07 hall_freq: 0.00 mechanical_freq: 0.01 gear_freq: 0.000075 changing_frequency initial 0
t: 3875.00 ref_freq: 300.00 electric_frequency: -0.14 hall_freq: 0.00 mechanical_freq: -0.03 gear_freq: -0.000142 changing_frequency initial 0
t: 3889.00 ref_freq: 300.00 electric_frequency: -0.32 hall_freq: 0.00 mechanical_freq: -0.06 gear_freq: -0.000324 changing_frequency initial 0
t: 3902.00 ref_freq: 300.00 electric_frequency: -0.51 hall_freq: 0.00 mechanical_freq: -0.10 gear_freq: -0.000507 changing_frequency initial 0
t: 3917.00 ref_freq: 300.00 electric_frequency: -0.71 hall_freq: 0.00 mechanical_freq: -0.14 gear_freq: -0.000708 changing_frequency initial 0
t: 3932.00 ref_freq: 300.00 electric_frequency: -0.93 hall_freq: 0.00 mechanical_freq: -0.19 gear_freq: -0.000934 changing_frequency initial 0
t: 3946.00 ref_freq: 300.00 electric_frequency: -1.14 hall_freq: 0.00 mechanical_freq: -0.23 gear_freq: -0.001141 changing_frequency initial 0
t: 3960.00 ref_freq: 300.00 electric_frequency: -1.32 hall_freq: 0.00 mechanical_freq: -0.26 gear_freq: -0.001324 changing_frequency initial 0
t: 3975.00 ref_freq: 300.00 electric_frequency: -1.54 hall_freq: 0.00 mechanical_freq: -0.31 gear_freq: -0.001541 changing_frequency initial 0
t: 3989.00 ref_freq: 300.00 electric_frequency: -1.72 hall_freq: 0.00 mechanical_freq: -0.34 gear_freq: -0.001724 changing_frequency initial 0
t: 4004.00 ref_freq: 300.00 electric_frequency: -1.98 hall_freq: 0.00 mechanical_freq: -0.40 gear_freq: -0.001981 changing_frequency initial 0
t: 4018.00 ref_freq: 300.00 electric_frequency: -2.10 hall_freq: 0.00 mechanical_freq: -0.42 gear_freq: -0.002097 changing_frequency initial 0
t: 4037.00 ref_freq: 300.00 electric_frequency: -2.31 hall_freq: 0.00 mechanical_freq: -0.46 gear_freq: -0.002309 changing_frequency initial 0
t: 4051.00 ref_freq: 300.00 electric_frequency: -2.47 hall_freq: 0.00 mechanical_freq: -0.49 gear_freq: -0.002468 changing_frequency initial 0
t: 4065.00 ref_freq: 300.00 electric_frequency: -2.62 hall_freq: 0.00 mechanical_freq: -0.52 gear_freq: -0.002621 changing_frequency initial 0
t: 4078.00 ref_freq: 300.00 electric_frequency: -2.72 hall_freq: 0.00 mechanical_freq: -0.54 gear_freq: -0.002717 changing_frequency initial 0
t: 4092.00 ref_freq: 300.00 electric_frequency: -2.75 hall_freq: 0.00 mechanical_freq: -0.55 gear_freq: -0.002749 changing_frequency initial 0
t: 4107.00 ref_freq: 300.00 electric_frequency: -2.81 hall_freq: 0.00 mechanical_freq: -0.56 gear_freq: -0.002812 changing_frequency initial 0
t: 4122.00 ref_freq: 300.00 electric_frequency: -2.78 hall_freq: 0.00 mechanical_freq: -0.56 gear_freq: -0.002783 changing_frequency initial 0
t: 4136.00 ref_freq: 300.00 electric_frequency: -2.83 hall_freq: 0.00 mechanical_freq: -0.57 gear_freq: -0.002834 changing_frequency initial 0
t: 4151.00 ref_freq: 300.00 electric_frequency: -2.79 hall_freq: 0.00 mechanical_freq: -0.56 gear_freq: -0.002793 changing_frequency initial 0
t: 4165.00 ref_freq: 300.00 electric_frequency: -2.75 hall_freq: 0.00 mechanical_freq: -0.55 gear_freq: -0.002745 changing_frequency initial 0
t: 4180.00 ref_freq: 300.00 electric_frequency: -2.69 hall_freq: 0.00 mechanical_freq: -0.54 gear_freq: -0.002689 changing_frequency initial 0
t: 4195.00 ref_freq: 300.00 electric_frequency: -2.53 hall_freq: 0.00 mechanical_freq: -0.51 gear_freq: -0.002528 changing_frequency initial 0
t: 4209.00 ref_freq: 300.00 electric_frequency: -2.41 hall_freq: 0.00 mechanical_freq: -0.48 gear_freq: -0.002407 changing_frequency initial 0
t: 4224.00 ref_freq: 300.00 electric_frequency: -2.29 hall_freq: 0.00 mechanical_freq: -0.46 gear_freq: -0.002289 changing_frequency initial 0
t: 4239.00 ref_freq: 300.00 electric_frequency: -2.06 hall_freq: 0.00 mechanical_freq: -0.41 gear_freq: -0.002060 changing_frequency initial 0
t: 4254.00 ref_freq: 300.00 electric_frequency: -1.92 hall_freq: 0.00 mechanical_freq: -0.38 gear_freq: -0.001919 changing_frequency initial 0
t: 4268.00 ref_freq: 300.00 electric_frequency: -1.77 hall_freq: 0.00 mechanical_freq: -0.35 gear_freq: -0.001768 changing_frequency initial 0
t: 4282.00 ref_freq: 300.00 electric_frequency: -1.53 hall_freq: 0.00 mechanical_freq: -0.31 gear_freq: -0.001526 changing_frequency initial 0
t: 4297.00 ref_freq: 300.00 electric_frequency: -1.28 hall_freq: 0.00 mechanical_freq: -0.26 gear_freq: -0.001279 changing_frequency initial 0
t: 4311.00 ref_freq: 300.00 electric_frequency: -1.06 hall_freq: 0.00 mechanical_freq: -0.21 gear_freq: -0.001064 changing_frequency initial 0
t: 4325.00 ref_freq: 300.00 electric_frequency: -0.87 hall_freq: 0.00 mechanical_freq: -0.17 gear_freq: -0.000871 changing_frequency initial 0
t: 4338.00 ref_freq: 300.00 electric_frequency: -0.67 hall_freq: 0.00 mechanical_freq: -0.13 gear_freq: -0.000670 changing_frequency initial 0
t: 4351.00 ref_freq: 300.00 electric_frequency: -0.51 hall_freq: 0.00 mechanical_freq: -0.10 gear_freq: -0.000511 changing_frequency initial 0
t: 4365.00 ref_freq: 300.00 electric_frequency: -0.32 hall_freq: 0.00 mechanical_freq: -0.06 gear_freq: -0.000319 changing_frequency initial 0
t: 4378.00 ref_freq: 300.00 electric_frequency: -0.19 hall_freq: 0.00 mechanical_freq: -0.04 gear_freq: -0.000189 changing_frequency initial 0
t: 4393.00 ref_freq: 300.00 electric_frequency: 0.02 hall_freq: 0.00 mechanical_freq: 0.00 gear_freq: 0.000023 changing_frequency initial 0
t: 4407.00 ref_freq: 300.00 electric_frequency: 0.18 hall_freq: 0.00 mechanical_freq: 0.04 gear_freq: 0.000185 changing_frequency initial 0
t: 4421.00 ref_freq: 300.00 electric_frequency: 0.34 hall_freq: 0.00 mechanical_freq: 0.07 gear_freq: 0.000339 changing_frequency initial 0
t: 4435.00 ref_freq: 300.00 electric_frequency: 0.51 hall_freq: 0.00 mechanical_freq: 0.10 gear_freq: 0.000511 changing_frequency initial 0
t: 4449.00 ref_freq: 300.00 electric_frequency: 0.66 hall_freq: 0.00 mechanical_freq: 0.13 gear_freq: 0.000658 changing_frequency initial 0
t: 4462.00 ref_freq: 300.00 electric_frequency: 0.76 hall_freq: 0.00 mechanical_freq: 0.15 gear_freq: 0.000758 changing_frequency initial 0
t: 4475.00 ref_freq: 300.00 electric_frequency: 0.83 hall_freq: 0.00 mechanical_freq: 0.17 gear_freq: 0.000830 changing_frequency initial 0
t: 4488.00 ref_freq: 300.00 electric_frequency: 1.01 hall_freq: 0.00 mechanical_freq: 0.20 gear_freq: 0.001006 changing_frequency initial 0
t: 4501.00 ref_freq: 300.00 electric_frequency: 1.11 hall_freq: 0.00 mechanical_freq: 0.22 gear_freq: 0.001114 changing_frequency initial 0
t: 4514.00 ref_freq: 300.00 electric_frequency: 1.23 hall_freq: 0.00 mechanical_freq: 0.25 gear_freq: 0.001235 changing_frequency initial 0
t: 4527.00 ref_freq: 300.00 electric_frequency: 1.31 hall_freq: 0.00 mechanical_freq: 0.26 gear_freq: 0.001314 changing_frequency initial 0
t: 4541.00 ref_freq: 300.00 electric_frequency: 1.40 hall_freq: 0.00 mechanical_freq: 0.28 gear_freq: 0.001398 changing_frequency initial 0
t: 4555.00 ref_freq: 300.00 electric_frequency: 1.51 hall_freq: 0.00 mechanical_freq: 0.30 gear_freq: 0.001507 changing_frequency initial 0
t: 4569.00 ref_freq: 300.00 electric_frequency: 1.56 hall_freq: 0.00 mechanical_freq: 0.31 gear_freq: 0.001558 changing_frequency initial 0
t: 4583.00 ref_freq: 300.00 electric_frequency: 1.64 hall_freq: 0.00 mechanical_freq: 0.33 gear_freq: 0.001643 changing_frequency initial 0
t: 4597.00 ref_freq: 300.00 electric_frequency: 1.68 hall_freq: 0.00 mechanical_freq: 0.34 gear_freq: 0.001682 changing_frequency initial 0
t: 4612.00 ref_freq: 300.00 electric_frequency: 1.76 hall_freq: 0.00 mechanical_freq: 0.35 gear_freq: 0.001758 changing_frequency initial 0
t: 4625.00 ref_freq: 300.00 electric_frequency: 1.79 hall_freq: 0.00 mechanical_freq: 0.36 gear_freq: 0.001790 changing_frequency initial 0
t: 4640.00 ref_freq: 300.00 electric_frequency: 1.85 hall_freq: 0.00 mechanical_freq: 0.37 gear_freq: 0.001848 changing_frequency initial 0
t: 4653.00 ref_freq: 300.00 electric_frequency: 1.86 hall_freq: 0.00 mechanical_freq: 0.37 gear_freq: 0.001859 changing_frequency initial 0
t: 4667.00 ref_freq: 300.00 electric_frequency: 1.85 hall_freq: 0.00 mechanical_freq: 0.37 gear_freq: 0.001850 changing_frequency initial 0
t: 4681.00 ref_freq: 300.00 electric_frequency: 1.94 hall_freq: 0.00 mechanical_freq: 0.39 gear_freq: 0.001939 changing_frequency initial 0
t: 4694.00 ref_freq: 300.00 electric_frequency: 1.95 hall_freq: 0.00 mechanical_freq: 0.39 gear_freq: 0.001946 changing_frequency initial 0
t: 4708.00 ref_freq: 300.00 electric_frequency: 2.01 hall_freq: 0.00 mechanical_freq: 0.40 gear_freq: 0.002006 changing_frequency initial 0
t: 4722.00 ref_freq: 300.00 electric_frequency: 2.01 hall_freq: 0.00 mechanical_freq: 0.40 gear_freq: 0.002007 changing_frequency initial 0
t: 4736.00 ref_freq: 300.00 electric_frequency: 1.95 hall_freq: 0.00 mechanical_freq: 0.39 gear_freq: 0.001951 changing_frequency initial 0
t: 4750.00 ref_freq: 300.00 electric_frequency: 1.96 hall_freq: 0.00 mechanical_freq: 0.39 gear_freq: 0.001956 changing_frequency initial 0
t: 4765.00 ref_freq: 300.00 electric_frequency: 1.92 hall_freq: 0.00 mechanical_freq: 0.38 gear_freq: 0.001918 changing_frequency initial 0
t: 4779.00 ref_freq: 300.00 electric_frequency: 1.91 hall_freq: 0.00 mechanical_freq: 0.38 gear_freq: 0.001913 changing_frequency initial 0
t: 4794.00 ref_freq: 300.00 electric_frequency: 1.89 hall_freq: 0.00 mechanical_freq: 0.38 gear_freq: 0.001891 changing_frequency initial 0
t: 4809.00 ref_freq: 300.00 electric_frequency: 1.86 hall_freq: 0.00 mechanical_freq: 0.37 gear_freq: 0.001863 changing_frequency initial 0
t: 4824.00 ref_freq: 300.00 electric_frequency: 1.82 hall_freq: 0.00 mechanical_freq: 0.36 gear_freq: 0.001820 changing_frequency initial 0
t: 4837.00 ref_freq: 300.00 electric_frequency: 1.84 hall_freq: 0.00 mechanical_freq: 0.37 gear_freq: 0.001843 changing_frequency initial 0
t: 4851.00 ref_freq: 300.00 electric_frequency: 1.77 hall_freq: 0.00 mechanical_freq: 0.35 gear_freq: 0.001768 changing_frequency initial 0
t: 4866.00 ref_freq: 300.00 electric_frequency: 1.69 hall_freq: 0.00 mechanical_freq: 0.34 gear_freq: 0.001688 changing_frequency initial 0
t: 4880.00 ref_freq: 300.00 electric_frequency: 1.53 hall_freq: 0.00 mechanical_freq: 0.31 gear_freq: 0.001529 changing_frequency initial 0
t: 4894.00 ref_freq: 300.00 electric_frequency: 1.56 hall_freq: 0.00 mechanical_freq: 0.31 gear_freq: 0.001558 changing_frequency initial 0
t: 4908.00 ref_freq: 300.00 electric_frequency: 1.42 hall_freq: 0.00 mechanical_freq: 0.28 gear_freq: 0.001422 changing_frequency initial 0
t: 4921.00 ref_freq: 300.00 electric_frequency: 1.33 hall_freq: 0.00 mechanical_freq: 0.27 gear_freq: 0.001332 changing_frequency initial 0
t: 4935.00 ref_freq: 300.00 electric_frequency: 1.23 hall_freq: 0.00 mechanical_freq: 0.25 gear_freq: 0.001228 changing_frequency initial 0
t: 4950.00 ref_freq: 300.00 electric_frequency: 1.15 hall_freq: 0.00 mechanical_freq: 0.23 gear_freq: 0.001152 changing_frequency initial 0
t: 4963.00 ref_freq: 300.00 electric_frequency: 1.06 hall_freq: 0.00 mechanical_freq: 0.21 gear_freq: 0.001059 changing_frequency initial 0
t: 4978.00 ref_freq: 300.00 electric_frequency: 0.92 hall_freq: 0.00 mechanical_freq: 0.18 gear_freq: 0.000918 changing_frequency initial 0
t: 4992.00 ref_freq: 300.00 electric_frequency: 0.78 hall_freq: 0.00 mechanical_freq: 0.16 gear_freq: 0.000778 changing_frequency initial 0
t: 5007.00 ref_freq: 300.00 electric_frequency: 0.58 hall_freq: 0.00 mechanical_freq: 0.12 gear_freq: 0.000583 changing_frequency initial 0
t: 5022.00 ref_freq: 300.00 electric_frequency: 0.50 hall_freq: 0.00 mechanical_freq: 0.10 gear_freq: 0.000504 changing_frequency initial 0
t: 5036.00 ref_freq: 300.00 electric_frequency: 0.31 hall_freq: 0.00 mechanical_freq: 0.06 gear_freq: 0.000311 changing_frequency initial 0
t: 5051.00 ref_freq: 300.00 electric_frequency: 0.16 hall_freq: 0.00 mechanical_freq: 0.03 gear_freq: 0.000160 changing_frequency initial 0
t: 5064.00 ref_freq: 300.00 electric_frequency: -0.03 hall_freq: 0.00 mechanical_freq: -0.01 gear_freq: -0.000032 changing_frequency initial 0
t: 5080.00 ref_freq: 300.00 electric_frequency: -0.19 hall_freq: 0.00 mechanical_freq: -0.04 gear_freq: -0.000195 changing_frequency initial 0
t: 5097.00 ref_freq: 300.00 electric_frequency: -0.44 hall_freq: 0.00 mechanical_freq: -0.09 gear_freq: -0.000442 changing_frequency initial 0
t: 5112.00 ref_freq: 300.00 electric_frequency: -0.66 hall_freq: 0.00 mechanical_freq: -0.13 gear_freq: -0.000658 changing_frequency initial 0
t: 5126.00 ref_freq: 300.00 electric_frequency: -0.83 hall_freq: 0.00 mechanical_freq: -0.17 gear_freq: -0.000826 changing_frequency initial 0
t: 5141.00 ref_freq: 300.00 electric_frequency: -1.05 hall_freq: 0.00 mechanical_freq: -0.21 gear_freq: -0.001050 changing_frequency initial 0
t: 5157.00 ref_freq: 300.00 electric_frequency: -1.28 hall_freq: 0.00 mechanical_freq: -0.26 gear_freq: -0.001277 changing_frequency initial 0
t: 5172.00 ref_freq: 300.00 electric_frequency: -1.49 hall_freq: 0.00 mechanical_freq: -0.30 gear_freq: -0.001492 changing_frequency initial 0
t: 5187.00 ref_freq: 300.00 electric_frequency: -1.73 hall_freq: 0.00 mechanical_freq: -0.35 gear_freq: -0.001729 changing_frequency initial 0
t: 5203.00 ref_freq: 300.00 electric_frequency: -1.92 hall_freq: 0.00 mechanical_freq: -0.38 gear_freq: -0.001925 changing_frequency initial 0
t: 5218.00 ref_freq: 300.00 electric_frequency: -2.14 hall_freq: 0.00 mechanical_freq: -0.43 gear_freq: -0.002142 changing_frequency initial 0
t: 5233.00 ref_freq: 300.00 electric_frequency: -2.29 hall_freq: 0.00 mechanical_freq: -0.46 gear_freq: -0.002292 changing_frequency initial 0
t: 5248.00 ref_freq: 300.00 electric_frequency: -2.41 hall_freq: 0.00 mechanical_freq: -0.48 gear_freq: -0.002408 changing_frequency initial 0
t: 5263.00 ref_freq: 300.00 electric_frequency: -2.56 hall_freq: 0.00 mechanical_freq: -0.51 gear_freq: -0.002556 changing_frequency initial 0
t: 5278.00 ref_freq: 300.00 electric_frequency: -2.71 hall_freq: 0.00 mechanical_freq: -0.54 gear_freq: -0.002713 changing_frequency initial 0
t: 5294.00 ref_freq: 300.00 electric_frequency: -2.81 hall_freq: 0.00 mechanical_freq: -0.56 gear_freq: -0.002812 changing_frequency initial 0
t: 385616.00 ref_freq: 300.00 electric_frequency: -2.06 hall_freq: 0.00 mechanical_freq: -0.41 gear_freq: -0.002057 changing_frequency initial 0
