arcoslab/open-coroco-legacy/src_DTC-SVM_Fixed_Testing/ADC_Measurements_Results/images/[Fri Apr 17 19:06:12 2015] [one 300 0, hall frequency controller, P =0.001]/[Fri Apr 17 19:06:12 2015] [one 300 0, hall frequency controller, P =0.001] data frequencies.csv

t t ref_freq ref_freq electric_frequency electric_frequency hall_freq hall_freq
t: 154.00 ref_freq: 300.00 electric_frequency: -1.89 hall_freq: 0.00 mechanical_freq: -0.38 gear_freq: -0.001885 changing_frequency initial 0
t: 168.00 ref_freq: 300.00 electric_frequency: -1.79 hall_freq: 0.00 mechanical_freq: -0.36 gear_freq: -0.001794 changing_frequency initial 0
t: 183.00 ref_freq: 300.00 electric_frequency: -1.60 hall_freq: 0.00 mechanical_freq: -0.32 gear_freq: -0.001599 changing_frequency initial 0
t: 197.00 ref_freq: 300.00 electric_frequency: -1.49 hall_freq: 0.00 mechanical_freq: -0.30 gear_freq: -0.001485 changing_frequency initial 0
t: 211.00 ref_freq: 300.00 electric_frequency: -1.29 hall_freq: 0.00 mechanical_freq: -0.26 gear_freq: -0.001287 changing_frequency initial 0
t: 226.00 ref_freq: 300.00 electric_frequency: -1.10 hall_freq: 0.00 mechanical_freq: -0.22 gear_freq: -0.001102 changing_frequency initial 0
t: 239.00 ref_freq: 300.00 electric_frequency: -0.94 hall_freq: 0.00 mechanical_freq: -0.19 gear_freq: -0.000940 changing_frequency initial 0
t: 252.00 ref_freq: 300.00 electric_frequency: -0.80 hall_freq: 0.00 mechanical_freq: -0.16 gear_freq: -0.000797 changing_frequency initial 0
t: 265.00 ref_freq: 300.00 electric_frequency: -0.68 hall_freq: 0.00 mechanical_freq: -0.14 gear_freq: -0.000678 changing_frequency initial 0
t: 278.00 ref_freq: 300.00 electric_frequency: -0.44 hall_freq: 0.00 mechanical_freq: -0.09 gear_freq: -0.000444 changing_frequency initial 0
t: 291.00 ref_freq: 300.00 electric_frequency: -0.31 hall_freq: 0.00 mechanical_freq: -0.06 gear_freq: -0.000311 changing_frequency initial 0
t: 305.00 ref_freq: 300.00 electric_frequency: -0.19 hall_freq: 0.00 mechanical_freq: -0.04 gear_freq: -0.000186 changing_frequency initial 0
t: 318.00 ref_freq: 300.00 electric_frequency: -0.01 hall_freq: 0.00 mechanical_freq: -0.00 gear_freq: -0.000005 changing_frequency initial 0
t: 331.00 ref_freq: 300.00 electric_frequency: 0.13 hall_freq: 0.00 mechanical_freq: 0.03 gear_freq: 0.000133 changing_frequency initial 0
t: 343.00 ref_freq: 300.00 electric_frequency: 0.23 hall_freq: 0.00 mechanical_freq: 0.05 gear_freq: 0.000231 changing_frequency initial 0
t: 356.00 ref_freq: 300.00 electric_frequency: 0.41 hall_freq: 0.00 mechanical_freq: 0.08 gear_freq: 0.000412 changing_frequency initial 0
t: 369.00 ref_freq: 300.00 electric_frequency: 0.53 hall_freq: 0.00 mechanical_freq: 0.11 gear_freq: 0.000534 changing_frequency initial 0
t: 382.00 ref_freq: 300.00 electric_frequency: 0.64 hall_freq: 0.00 mechanical_freq: 0.13 gear_freq: 0.000636 changing_frequency initial 0
t: 396.00 ref_freq: 300.00 electric_frequency: 0.80 hall_freq: 0.00 mechanical_freq: 0.16 gear_freq: 0.000796 changing_frequency initial 0
t: 409.00 ref_freq: 300.00 electric_frequency: 0.90 hall_freq: 0.00 mechanical_freq: 0.18 gear_freq: 0.000904 changing_frequency initial 0
t: 422.00 ref_freq: 300.00 electric_frequency: 1.00 hall_freq: 0.00 mechanical_freq: 0.20 gear_freq: 0.000995 changing_frequency initial 0
t: 435.00 ref_freq: 300.00 electric_frequency: 1.11 hall_freq: 0.00 mechanical_freq: 0.22 gear_freq: 0.001112 changing_frequency initial 0
t: 451.00 ref_freq: 300.00 electric_frequency: 1.23 hall_freq: 0.00 mechanical_freq: 0.25 gear_freq: 0.001231 changing_frequency initial 0
t: 464.00 ref_freq: 300.00 electric_frequency: 1.31 hall_freq: 0.00 mechanical_freq: 0.26 gear_freq: 0.001308 changing_frequency initial 0
t: 478.00 ref_freq: 300.00 electric_frequency: 1.38 hall_freq: 0.00 mechanical_freq: 0.28 gear_freq: 0.001381 changing_frequency initial 0
t: 493.00 ref_freq: 300.00 electric_frequency: 1.50 hall_freq: 0.00 mechanical_freq: 0.30 gear_freq: 0.001500 changing_frequency initial 0
t: 507.00 ref_freq: 300.00 electric_frequency: 1.58 hall_freq: 0.00 mechanical_freq: 0.32 gear_freq: 0.001580 changing_frequency initial 0
t: 520.00 ref_freq: 300.00 electric_frequency: 1.62 hall_freq: 0.00 mechanical_freq: 0.32 gear_freq: 0.001616 changing_frequency initial 0
t: 534.00 ref_freq: 300.00 electric_frequency: 1.68 hall_freq: 0.00 mechanical_freq: 0.34 gear_freq: 0.001680 changing_frequency initial 0
t: 549.00 ref_freq: 300.00 electric_frequency: 1.77 hall_freq: 0.00 mechanical_freq: 0.35 gear_freq: 0.001768 changing_frequency initial 0
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
t: 213.00 ref_freq: 300.00 electric_frequency: 1.69 hall_freq: 0.00 mechanical_freq: 0.34 gear_freq: 0.001690 changing_frequency initial 0
t: 227.00 ref_freq: 300.00 electric_frequency: 1.58 hall_freq: 0.00 mechanical_freq: 0.32 gear_freq: 0.001575 changing_frequency initial 0
t: 241.00 ref_freq: 300.00 electric_frequency: 1.54 hall_freq: 0.00 mechanical_freq: 0.31 gear_freq: 0.001539 changing_frequency initial 0
t: 254.00 ref_freq: 300.00 electric_frequency: 1.46 hall_freq: 0.00 mechanical_freq: 0.29 gear_freq: 0.001463 changing_frequency initial 0
t: 268.00 ref_freq: 300.00 electric_frequency: 1.32 hall_freq: 0.00 mechanical_freq: 0.26 gear_freq: 0.001318 changing_frequency initial 0
t: 282.00 ref_freq: 300.00 electric_frequency: 1.30 hall_freq: 0.00 mechanical_freq: 0.26 gear_freq: 0.001297 changing_frequency initial 0
t: 297.00 ref_freq: 300.00 electric_frequency: 1.16 hall_freq: 0.00 mechanical_freq: 0.23 gear_freq: 0.001164 changing_frequency initial 0
t: 312.00 ref_freq: 300.00 electric_frequency: 1.11 hall_freq: 0.00 mechanical_freq: 0.22 gear_freq: 0.001108 changing_frequency initial 0
t: 326.00 ref_freq: 300.00 electric_frequency: 0.99 hall_freq: 0.00 mechanical_freq: 0.20 gear_freq: 0.000990 changing_frequency initial 0
t: 340.00 ref_freq: 300.00 electric_frequency: 0.80 hall_freq: 0.00 mechanical_freq: 0.16 gear_freq: 0.000799 changing_frequency initial 0
t: 355.00 ref_freq: 300.00 electric_frequency: 0.67 hall_freq: 0.00 mechanical_freq: 0.13 gear_freq: 0.000666 changing_frequency initial 0
t: 368.00 ref_freq: 300.00 electric_frequency: 0.52 hall_freq: 0.00 mechanical_freq: 0.10 gear_freq: 0.000517 changing_frequency initial 0
t: 383.00 ref_freq: 300.00 electric_frequency: 0.39 hall_freq: 0.00 mechanical_freq: 0.08 gear_freq: 0.000393 changing_frequency initial 0
t: 396.00 ref_freq: 300.00 electric_frequency: 0.24 hall_freq: 0.00 mechanical_freq: 0.05 gear_freq: 0.000238 changing_frequency initial 0
t: 410.00 ref_freq: 300.00 electric_frequency: 0.05 hall_freq: 0.00 mechanical_freq: 0.01 gear_freq: 0.000055 changing_frequency initial 0
t: 424.00 ref_freq: 300.00 electric_frequency: -0.11 hall_freq: 0.00 mechanical_freq: -0.02 gear_freq: -0.000106 changing_frequency initial 0
t: 438.00 ref_freq: 300.00 electric_frequency: -0.34 hall_freq: 0.00 mechanical_freq: -0.07 gear_freq: -0.000342 changing_frequency initial 0
t: 453.00 ref_freq: 300.00 electric_frequency: -0.47 hall_freq: 0.00 mechanical_freq: -0.09 gear_freq: -0.000466 changing_frequency initial 0
t: 467.00 ref_freq: 300.00 electric_frequency: -0.67 hall_freq: 0.00 mechanical_freq: -0.13 gear_freq: -0.000672 changing_frequency initial 0
t: 481.00 ref_freq: 300.00 electric_frequency: -0.86 hall_freq: 0.00 mechanical_freq: -0.17 gear_freq: -0.000864 changing_frequency initial 0
t: 495.00 ref_freq: 300.00 electric_frequency: -1.07 hall_freq: 0.00 mechanical_freq: -0.21 gear_freq: -0.001069 changing_frequency initial 0
t: 510.00 ref_freq: 300.00 electric_frequency: -1.27 hall_freq: 0.00 mechanical_freq: -0.25 gear_freq: -0.001274 changing_frequency initial 0
t: 524.00 ref_freq: 300.00 electric_frequency: -1.48 hall_freq: 0.00 mechanical_freq: -0.30 gear_freq: -0.001480 changing_frequency initial 0
t: 537.00 ref_freq: 300.00 electric_frequency: -1.66 hall_freq: 0.00 mechanical_freq: -0.33 gear_freq: -0.001661 changing_frequency initial 0
t: 550.00 ref_freq: 300.00 electric_frequency: -1.82 hall_freq: 0.00 mechanical_freq: -0.36 gear_freq: -0.001822 changing_frequency initial 0
t: 563.00 ref_freq: 300.00 electric_frequency: -2.00 hall_freq: 0.00 mechanical_freq: -0.40 gear_freq: -0.001996 changing_frequency initial 0
t: 591.00 ref_freq: 300.00 electric_frequency: -2.35 hall_freq: 0.00 mechanical_freq: -0.47 gear_freq: -0.002350 changing_frequency initial 0
t: 605.00 ref_freq: 300.00 electric_frequency: -2.44 hall_freq: 0.00 mechanical_freq: -0.49 gear_freq: -0.002442 changing_frequency initial 0
t: 619.00 ref_freq: 300.00 electric_frequency: -2.63 hall_freq: 0.00 mechanical_freq: -0.53 gear_freq: -0.002626 changing_frequency initial 0
t: 635.00 ref_freq: 300.00 electric_frequency: -2.70 hall_freq: 0.00 mechanical_freq: -0.54 gear_freq: -0.002704 changing_frequency initial 0
t: 650.00 ref_freq: 300.00 electric_frequency: -2.79 hall_freq: 0.00 mechanical_freq: -0.56 gear_freq: -0.002789 changing_frequency initial 0
t: 663.00 ref_freq: 300.00 electric_frequency: -2.78 hall_freq: 0.00 mechanical_freq: -0.56 gear_freq: -0.002781 changing_frequency initial 0
t: 676.00 ref_freq: 300.00 electric_frequency: -2.81 hall_freq: 0.00 mechanical_freq: -0.56 gear_freq: -0.002814 changing_frequency initial 0
t: 691.00 ref_freq: 300.00 electric_frequency: -2.81 hall_freq: 0.00 mechanical_freq: -0.56 gear_freq: -0.002808 changing_frequency initial 0
t: 705.00 ref_freq: 300.00 electric_frequency: -2.72 hall_freq: 0.00 mechanical_freq: -0.54 gear_freq: -0.002722 changing_frequency initial 0
t: 718.00 ref_freq: 300.00 electric_frequency: -2.70 hall_freq: 0.00 mechanical_freq: -0.54 gear_freq: -0.002701 changing_frequency initial 0
t: 732.00 ref_freq: 300.00 electric_frequency: -2.57 hall_freq: 0.00 mechanical_freq: -0.51 gear_freq: -0.002570 changing_frequency initial 0
t: 746.00 ref_freq: 300.00 electric_frequency: -2.54 hall_freq: 0.00 mechanical_freq: -0.51 gear_freq: -0.002541 changing_frequency initial 0
t: 759.00 ref_freq: 300.00 electric_frequency: -2.32 hall_freq: 0.00 mechanical_freq: -0.46 gear_freq: -0.002324 changing_frequency initial 0
t: 772.00 ref_freq: 300.00 electric_frequency: -2.22 hall_freq: 0.00 mechanical_freq: -0.44 gear_freq: -0.002220 changing_frequency initial 0
t: 786.00 ref_freq: 300.00 electric_frequency: -2.12 hall_freq: 0.00 mechanical_freq: -0.42 gear_freq: -0.002125 changing_frequency initial 0
t: 801.00 ref_freq: 300.00 electric_frequency: -1.85 hall_freq: 0.00 mechanical_freq: -0.37 gear_freq: -0.001855 changing_frequency initial 0
t: 815.00 ref_freq: 300.00 electric_frequency: -1.68 hall_freq: 0.00 mechanical_freq: -0.34 gear_freq: -0.001676 changing_frequency initial 0
t: 829.00 ref_freq: 300.00 electric_frequency: -1.55 hall_freq: 0.00 mechanical_freq: -0.31 gear_freq: -0.001546 changing_frequency initial 0
t: 843.00 ref_freq: 300.00 electric_frequency: -1.35 hall_freq: 0.00 mechanical_freq: -0.27 gear_freq: -0.001351 changing_frequency initial 0
t: 857.00 ref_freq: 300.00 electric_frequency: -1.13 hall_freq: 0.00 mechanical_freq: -0.23 gear_freq: -0.001133 changing_frequency initial 0
t: 870.00 ref_freq: 300.00 electric_frequency: -0.97 hall_freq: 0.00 mechanical_freq: -0.19 gear_freq: -0.000974 changing_frequency initial 0
t: 883.00 ref_freq: 300.00 electric_frequency: -0.72 hall_freq: 0.00 mechanical_freq: -0.14 gear_freq: -0.000716 changing_frequency initial 0
t: 896.00 ref_freq: 300.00 electric_frequency: -0.57 hall_freq: 0.00 mechanical_freq: -0.11 gear_freq: -0.000568 changing_frequency initial 0
t: 909.00 ref_freq: 300.00 electric_frequency: -0.43 hall_freq: 0.00 mechanical_freq: -0.09 gear_freq: -0.000431 changing_frequency initial 0
t: 923.00 ref_freq: 300.00 electric_frequency: -0.24 hall_freq: 0.00 mechanical_freq: -0.05 gear_freq: -0.000237 changing_frequency initial 0
t: 937.00 ref_freq: 300.00 electric_frequency: -0.06 hall_freq: 0.00 mechanical_freq: -0.01 gear_freq: -0.000062 changing_frequency initial 0
t: 950.00 ref_freq: 300.00 electric_frequency: 0.13 hall_freq: 0.00 mechanical_freq: 0.03 gear_freq: 0.000126 changing_frequency initial 0
t: 964.00 ref_freq: 300.00 electric_frequency: 0.28 hall_freq: 0.00 mechanical_freq: 0.06 gear_freq: 0.000281 changing_frequency initial 0
t: 977.00 ref_freq: 300.00 electric_frequency: 0.43 hall_freq: 0.00 mechanical_freq: 0.09 gear_freq: 0.000428 changing_frequency initial 0
t: 990.00 ref_freq: 300.00 electric_frequency: 0.57 hall_freq: 0.00 mechanical_freq: 0.11 gear_freq: 0.000569 changing_frequency initial 0
t: 1002.00 ref_freq: 300.00 electric_frequency: 0.69 hall_freq: 0.00 mechanical_freq: 0.14 gear_freq: 0.000686 changing_frequency initial 0
t: 1015.00 ref_freq: 300.00 electric_frequency: 0.82 hall_freq: 0.00 mechanical_freq: 0.16 gear_freq: 0.000819 changing_frequency initial 0
t: 1028.00 ref_freq: 300.00 electric_frequency: 0.95 hall_freq: 0.00 mechanical_freq: 0.19 gear_freq: 0.000952 changing_frequency initial 0
t: 1041.00 ref_freq: 300.00 electric_frequency: 1.04 hall_freq: 0.00 mechanical_freq: 0.21 gear_freq: 0.001044 changing_frequency initial 0
t: 1054.00 ref_freq: 300.00 electric_frequency: 1.10 hall_freq: 0.00 mechanical_freq: 0.22 gear_freq: 0.001096 changing_frequency initial 0
t: 1067.00 ref_freq: 300.00 electric_frequency: 1.27 hall_freq: 0.00 mechanical_freq: 0.25 gear_freq: 0.001267 changing_frequency initial 0
t: 1080.00 ref_freq: 300.00 electric_frequency: 1.34 hall_freq: 0.00 mechanical_freq: 0.27 gear_freq: 0.001339 changing_frequency initial 0
t: 1092.00 ref_freq: 300.00 electric_frequency: 1.41 hall_freq: 0.00 mechanical_freq: 0.28 gear_freq: 0.001409 changing_frequency initial 0
t: 1106.00 ref_freq: 300.00 electric_frequency: 1.49 hall_freq: 0.00 mechanical_freq: 0.30 gear_freq: 0.001494 changing_frequency initial 0
t: 1119.00 ref_freq: 300.00 electric_frequency: 1.54 hall_freq: 0.00 mechanical_freq: 0.31 gear_freq: 0.001543 changing_frequency initial 0
t: 1133.00 ref_freq: 300.00 electric_frequency: 1.67 hall_freq: 0.00 mechanical_freq: 0.33 gear_freq: 0.001670 changing_frequency initial 0
t: 1147.00 ref_freq: 300.00 electric_frequency: 1.72 hall_freq: 0.00 mechanical_freq: 0.34 gear_freq: 0.001718 changing_frequency initial 0
t: 1161.00 ref_freq: 300.00 electric_frequency: 1.74 hall_freq: 0.00 mechanical_freq: 0.35 gear_freq: 0.001736 changing_frequency initial 0
t: 1174.00 ref_freq: 300.00 electric_frequency: 1.81 hall_freq: 0.00 mechanical_freq: 0.36 gear_freq: 0.001814 changing_frequency initial 0
t: 1187.00 ref_freq: 300.00 electric_frequency: 1.82 hall_freq: 0.00 mechanical_freq: 0.36 gear_freq: 0.001823 changing_frequency initial 0
t: 1201.00 ref_freq: 300.00 electric_frequency: 1.91 hall_freq: 0.00 mechanical_freq: 0.38 gear_freq: 0.001908 changing_frequency initial 0
t: 1215.00 ref_freq: 300.00 electric_frequency: 1.89 hall_freq: 0.00 mechanical_freq: 0.38 gear_freq: 0.001887 changing_frequency initial 0
t: 1228.00 ref_freq: 300.00 electric_frequency: 1.95 hall_freq: 0.00 mechanical_freq: 0.39 gear_freq: 0.001949 changing_frequency initial 0
t: 1241.00 ref_freq: 300.00 electric_frequency: 1.93 hall_freq: 0.00 mechanical_freq: 0.39 gear_freq: 0.001934 changing_frequency initial 0
t: 1254.00 ref_freq: 300.00 electric_frequency: 1.98 hall_freq: 0.00 mechanical_freq: 0.40 gear_freq: 0.001984 changing_frequency initial 0
t: 1267.00 ref_freq: 300.00 electric_frequency: 1.90 hall_freq: 0.00 mechanical_freq: 0.38 gear_freq: 0.001903 changing_frequency initial 0
t: 1280.00 ref_freq: 300.00 electric_frequency: 1.99 hall_freq: 0.00 mechanical_freq: 0.40 gear_freq: 0.001987 changing_frequency initial 0
t: 1294.00 ref_freq: 300.00 electric_frequency: 1.94 hall_freq: 0.00 mechanical_freq: 0.39 gear_freq: 0.001943 changing_frequency initial 0
t: 1308.00 ref_freq: 300.00 electric_frequency: 1.95 hall_freq: 0.00 mechanical_freq: 0.39 gear_freq: 0.001948 changing_frequency initial 0
t: 1321.00 ref_freq: 300.00 electric_frequency: 1.97 hall_freq: 0.00 mechanical_freq: 0.39 gear_freq: 0.001966 changing_frequency initial 0
t: 1335.00 ref_freq: 300.00 electric_frequency: 1.96 hall_freq: 0.00 mechanical_freq: 0.39 gear_freq: 0.001964 changing_frequency initial 0
t: 1350.00 ref_freq: 300.00 electric_frequency: 1.88 hall_freq: 0.00 mechanical_freq: 0.38 gear_freq: 0.001879 changing_frequency initial 0
t: 1363.00 ref_freq: 300.00 electric_frequency: 1.85 hall_freq: 0.00 mechanical_freq: 0.37 gear_freq: 0.001845 changing_frequency initial 0
t: 1377.00 ref_freq: 300.00 electric_frequency: 1.80 hall_freq: 0.00 mechanical_freq: 0.36 gear_freq: 0.001797 changing_frequency initial 0
t: 1390.00 ref_freq: 300.00 electric_frequency: 1.75 hall_freq: 0.00 mechanical_freq: 0.35 gear_freq: 0.001754 changing_frequency initial 0
t: 1404.00 ref_freq: 300.00 electric_frequency: 1.75 hall_freq: 0.00 mechanical_freq: 0.35 gear_freq: 0.001751 changing_frequency initial 0
t: 1418.00 ref_freq: 300.00 electric_frequency: 1.68 hall_freq: 0.00 mechanical_freq: 0.34 gear_freq: 0.001677 changing_frequency initial 0
t: 1432.00 ref_freq: 300.00 electric_frequency: 1.57 hall_freq: 0.00 mechanical_freq: 0.31 gear_freq: 0.001572 changing_frequency initial 0
t: 1446.00 ref_freq: 300.00 electric_frequency: 1.54 hall_freq: 0.00 mechanical_freq: 0.31 gear_freq: 0.001541 changing_frequency initial 0
t: 1459.00 ref_freq: 300.00 electric_frequency: 1.45 hall_freq: 0.00 mechanical_freq: 0.29 gear_freq: 0.001454 changing_frequency initial 0
t: 1486.00 ref_freq: 300.00 electric_frequency: 1.27 hall_freq: 0.00 mechanical_freq: 0.25 gear_freq: 0.001265 changing_frequency initial 0
t: 1500.00 ref_freq: 300.00 electric_frequency: 1.17 hall_freq: 0.00 mechanical_freq: 0.23 gear_freq: 0.001175 changing_frequency initial 0
t: 1513.00 ref_freq: 300.00 electric_frequency: 1.03 hall_freq: 0.00 mechanical_freq: 0.21 gear_freq: 0.001034 changing_frequency initial 0
t: 1526.00 ref_freq: 300.00 electric_frequency: 0.92 hall_freq: 0.00 mechanical_freq: 0.18 gear_freq: 0.000922 changing_frequency initial 0
t: 1539.00 ref_freq: 300.00 electric_frequency: 0.85 hall_freq: 0.00 mechanical_freq: 0.17 gear_freq: 0.000852 changing_frequency initial 0
t: 1552.00 ref_freq: 300.00 electric_frequency: 0.72 hall_freq: 0.00 mechanical_freq: 0.14 gear_freq: 0.000720 changing_frequency initial 0
t: 1565.00 ref_freq: 300.00 electric_frequency: 0.59 hall_freq: 0.00 mechanical_freq: 0.12 gear_freq: 0.000592 changing_frequency initial 0
t: 1578.00 ref_freq: 300.00 electric_frequency: 0.34 hall_freq: 0.00 mechanical_freq: 0.07 gear_freq: 0.000338 changing_frequency initial 0
t: 1592.00 ref_freq: 300.00 electric_frequency: 0.23 hall_freq: 0.00 mechanical_freq: 0.05 gear_freq: 0.000235 changing_frequency initial 0
t: 1606.00 ref_freq: 300.00 electric_frequency: 0.08 hall_freq: 0.00 mechanical_freq: 0.02 gear_freq: 0.000080 changing_frequency initial 0
t: 1620.00 ref_freq: 300.00 electric_frequency: -0.15 hall_freq: 0.00 mechanical_freq: -0.03 gear_freq: -0.000148 changing_frequency initial 0
t: 1633.00 ref_freq: 300.00 electric_frequency: -0.27 hall_freq: 0.00 mechanical_freq: -0.05 gear_freq: -0.000267 changing_frequency initial 0
t: 1646.00 ref_freq: 300.00 electric_frequency: -0.43 hall_freq: 0.00 mechanical_freq: -0.09 gear_freq: -0.000426 changing_frequency initial 0
t: 1659.00 ref_freq: 300.00 electric_frequency: -0.67 hall_freq: 0.00 mechanical_freq: -0.13 gear_freq: -0.000674 changing_frequency initial 0
t: 1673.00 ref_freq: 300.00 electric_frequency: -0.78 hall_freq: 0.00 mechanical_freq: -0.16 gear_freq: -0.000784 changing_frequency initial 0
t: 1687.00 ref_freq: 300.00 electric_frequency: -1.00 hall_freq: 0.00 mechanical_freq: -0.20 gear_freq: -0.001003 changing_frequency initial 0
t: 1701.00 ref_freq: 300.00 electric_frequency: -1.19 hall_freq: 0.00 mechanical_freq: -0.24 gear_freq: -0.001194 changing_frequency initial 0
t: 1715.00 ref_freq: 300.00 electric_frequency: -1.42 hall_freq: 0.00 mechanical_freq: -0.28 gear_freq: -0.001423 changing_frequency initial 0
t: 1729.00 ref_freq: 300.00 electric_frequency: -1.62 hall_freq: 0.00 mechanical_freq: -0.32 gear_freq: -0.001616 changing_frequency initial 0
t: 1742.00 ref_freq: 300.00 electric_frequency: -1.78 hall_freq: 0.00 mechanical_freq: -0.36 gear_freq: -0.001777 changing_frequency initial 0
t: 1756.00 ref_freq: 300.00 electric_frequency: -1.97 hall_freq: 0.00 mechanical_freq: -0.39 gear_freq: -0.001968 changing_frequency initial 0
t: 1770.00 ref_freq: 300.00 electric_frequency: -2.10 hall_freq: 0.00 mechanical_freq: -0.42 gear_freq: -0.002096 changing_frequency initial 0
t: 1785.00 ref_freq: 300.00 electric_frequency: -2.32 hall_freq: 0.00 mechanical_freq: -0.46 gear_freq: -0.002324 changing_frequency initial 0
t: 1799.00 ref_freq: 300.00 electric_frequency: -2.46 hall_freq: 0.00 mechanical_freq: -0.49 gear_freq: -0.002464 changing_frequency initial 0
t: 1812.00 ref_freq: 300.00 electric_frequency: -2.58 hall_freq: 0.00 mechanical_freq: -0.52 gear_freq: -0.002578 changing_frequency initial 0
t: 1826.00 ref_freq: 300.00 electric_frequency: -2.69 hall_freq: 0.00 mechanical_freq: -0.54 gear_freq: -0.002685 changing_frequency initial 0
t: 1840.00 ref_freq: 300.00 electric_frequency: -2.69 hall_freq: 0.00 mechanical_freq: -0.54 gear_freq: -0.002689 changing_frequency initial 0
t: 1853.00 ref_freq: 300.00 electric_frequency: -2.85 hall_freq: 0.00 mechanical_freq: -0.57 gear_freq: -0.002851 changing_frequency initial 0
t: 1867.00 ref_freq: 300.00 electric_frequency: -2.83 hall_freq: 0.00 mechanical_freq: -0.57 gear_freq: -0.002826 changing_frequency initial 0
t: 1880.00 ref_freq: 300.00 electric_frequency: -2.78 hall_freq: 0.00 mechanical_freq: -0.56 gear_freq: -0.002780 changing_frequency initial 0
t: 1893.00 ref_freq: 300.00 electric_frequency: -2.84 hall_freq: 0.00 mechanical_freq: -0.57 gear_freq: -0.002844 changing_frequency initial 0
t: 1906.00 ref_freq: 300.00 electric_frequency: -2.82 hall_freq: 0.00 mechanical_freq: -0.56 gear_freq: -0.002825 changing_frequency initial 0
t: 1919.00 ref_freq: 300.00 electric_frequency: -2.73 hall_freq: 0.00 mechanical_freq: -0.55 gear_freq: -0.002732 changing_frequency initial 0
t: 1933.00 ref_freq: 300.00 electric_frequency: -2.69 hall_freq: 0.00 mechanical_freq: -0.54 gear_freq: -0.002689 changing_frequency initial 0
t: 1946.00 ref_freq: 300.00 electric_frequency: -2.62 hall_freq: 0.00 mechanical_freq: -0.52 gear_freq: -0.002620 changing_frequency initial 0
t: 1960.00 ref_freq: 300.00 electric_frequency: -2.46 hall_freq: 0.00 mechanical_freq: -0.49 gear_freq: -0.002456 changing_frequency initial 0
t: 1973.00 ref_freq: 300.00 electric_frequency: -2.33 hall_freq: 0.00 mechanical_freq: -0.47 gear_freq: -0.002334 changing_frequency initial 0
t: 1987.00 ref_freq: 300.00 electric_frequency: -2.04 hall_freq: 0.00 mechanical_freq: -0.41 gear_freq: -0.002036 changing_frequency initial 0
t: 2001.00 ref_freq: 300.00 electric_frequency: -1.98 hall_freq: 0.00 mechanical_freq: -0.40 gear_freq: -0.001975 changing_frequency initial 0
t: 2014.00 ref_freq: 300.00 electric_frequency: -1.76 hall_freq: 0.00 mechanical_freq: -0.35 gear_freq: -0.001759 changing_frequency initial 0
t: 2028.00 ref_freq: 300.00 electric_frequency: -1.58 hall_freq: 0.00 mechanical_freq: -0.32 gear_freq: -0.001578 changing_frequency initial 0
t: 2042.00 ref_freq: 300.00 electric_frequency: -1.37 hall_freq: 0.00 mechanical_freq: -0.27 gear_freq: -0.001373 changing_frequency initial 0
t: 2056.00 ref_freq: 300.00 electric_frequency: -1.18 hall_freq: 0.00 mechanical_freq: -0.24 gear_freq: -0.001183 changing_frequency initial 0
t: 2069.00 ref_freq: 300.00 electric_frequency: -0.98 hall_freq: 0.00 mechanical_freq: -0.20 gear_freq: -0.000979 changing_frequency initial 0
t: 2081.00 ref_freq: 300.00 electric_frequency: -0.82 hall_freq: 0.00 mechanical_freq: -0.16 gear_freq: -0.000819 changing_frequency initial 0
t: 2094.00 ref_freq: 300.00 electric_frequency: -0.59 hall_freq: 0.00 mechanical_freq: -0.12 gear_freq: -0.000595 changing_frequency initial 0
t: 2107.00 ref_freq: 300.00 electric_frequency: -0.40 hall_freq: 0.00 mechanical_freq: -0.08 gear_freq: -0.000401 changing_frequency initial 0
t: 2119.00 ref_freq: 300.00 electric_frequency: -0.27 hall_freq: 0.00 mechanical_freq: -0.05 gear_freq: -0.000265 changing_frequency initial 0
t: 2132.00 ref_freq: 300.00 electric_frequency: -0.11 hall_freq: 0.00 mechanical_freq: -0.02 gear_freq: -0.000111 changing_frequency initial 0
t: 2145.00 ref_freq: 300.00 electric_frequency: 0.06 hall_freq: 0.00 mechanical_freq: 0.01 gear_freq: 0.000058 changing_frequency initial 0
t: 2158.00 ref_freq: 300.00 electric_frequency: 0.15 hall_freq: 0.00 mechanical_freq: 0.03 gear_freq: 0.000151 changing_frequency initial 0
t: 2171.00 ref_freq: 300.00 electric_frequency: 0.35 hall_freq: 0.00 mechanical_freq: 0.07 gear_freq: 0.000347 changing_frequency initial 0
t: 2184.00 ref_freq: 300.00 electric_frequency: 0.46 hall_freq: 0.00 mechanical_freq: 0.09 gear_freq: 0.000464 changing_frequency initial 0
t: 2197.00 ref_freq: 300.00 electric_frequency: 0.64 hall_freq: 0.00 mechanical_freq: 0.13 gear_freq: 0.000639 changing_frequency initial 0
t: 2224.00 ref_freq: 300.00 electric_frequency: 0.91 hall_freq: 0.00 mechanical_freq: 0.18 gear_freq: 0.000910 changing_frequency initial 0
t: 2237.00 ref_freq: 300.00 electric_frequency: 1.02 hall_freq: 0.00 mechanical_freq: 0.20 gear_freq: 0.001017 changing_frequency initial 0
t: 2251.00 ref_freq: 300.00 electric_frequency: 1.14 hall_freq: 0.00 mechanical_freq: 0.23 gear_freq: 0.001139 changing_frequency initial 0
t: 2264.00 ref_freq: 300.00 electric_frequency: 1.22 hall_freq: 0.00 mechanical_freq: 0.24 gear_freq: 0.001217 changing_frequency initial 0
t: 2277.00 ref_freq: 300.00 electric_frequency: 1.32 hall_freq: 0.00 mechanical_freq: 0.26 gear_freq: 0.001317 changing_frequency initial 0
t: 2290.00 ref_freq: 300.00 electric_frequency: 1.41 hall_freq: 0.00 mechanical_freq: 0.28 gear_freq: 0.001414 changing_frequency initial 0
t: 2303.00 ref_freq: 300.00 electric_frequency: 1.50 hall_freq: 0.00 mechanical_freq: 0.30 gear_freq: 0.001501 changing_frequency initial 0
t: 2317.00 ref_freq: 300.00 electric_frequency: 1.55 hall_freq: 0.00 mechanical_freq: 0.31 gear_freq: 0.001547 changing_frequency initial 0
t: 2330.00 ref_freq: 300.00 electric_frequency: 1.63 hall_freq: 0.00 mechanical_freq: 0.33 gear_freq: 0.001634 changing_frequency initial 0
t: 2343.00 ref_freq: 300.00 electric_frequency: 1.67 hall_freq: 0.00 mechanical_freq: 0.33 gear_freq: 0.001673 changing_frequency initial 0
t: 2356.00 ref_freq: 300.00 electric_frequency: 1.73 hall_freq: 0.00 mechanical_freq: 0.35 gear_freq: 0.001727 changing_frequency initial 0
t: 2368.00 ref_freq: 300.00 electric_frequency: 1.79 hall_freq: 0.00 mechanical_freq: 0.36 gear_freq: 0.001790 changing_frequency initial 0
t: 2381.00 ref_freq: 300.00 electric_frequency: 1.83 hall_freq: 0.00 mechanical_freq: 0.37 gear_freq: 0.001828 changing_frequency initial 0
t: 2394.00 ref_freq: 300.00 electric_frequency: 1.84 hall_freq: 0.00 mechanical_freq: 0.37 gear_freq: 0.001843 changing_frequency initial 0
t: 2407.00 ref_freq: 300.00 electric_frequency: 1.90 hall_freq: 0.00 mechanical_freq: 0.38 gear_freq: 0.001902 changing_frequency initial 0
t: 2420.00 ref_freq: 300.00 electric_frequency: 1.92 hall_freq: 0.00 mechanical_freq: 0.38 gear_freq: 0.001924 changing_frequency initial 0
t: 2433.00 ref_freq: 300.00 electric_frequency: 1.93 hall_freq: 0.00 mechanical_freq: 0.39 gear_freq: 0.001932 changing_frequency initial 0
t: 2446.00 ref_freq: 300.00 electric_frequency: 1.97 hall_freq: 0.00 mechanical_freq: 0.39 gear_freq: 0.001971 changing_frequency initial 0
t: 2460.00 ref_freq: 300.00 electric_frequency: 1.90 hall_freq: 0.00 mechanical_freq: 0.38 gear_freq: 0.001899 changing_frequency initial 0
t: 2474.00 ref_freq: 300.00 electric_frequency: 1.99 hall_freq: 0.00 mechanical_freq: 0.40 gear_freq: 0.001992 changing_frequency initial 0
t: 2487.00 ref_freq: 300.00 electric_frequency: 1.95 hall_freq: 0.00 mechanical_freq: 0.39 gear_freq: 0.001949 changing_frequency initial 0
t: 2500.00 ref_freq: 300.00 electric_frequency: 2.00 hall_freq: 0.00 mechanical_freq: 0.40 gear_freq: 0.001995 changing_frequency initial 0
t: 2514.00 ref_freq: 300.00 electric_frequency: 1.92 hall_freq: 0.00 mechanical_freq: 0.38 gear_freq: 0.001925 changing_frequency initial 0
t: 2528.00 ref_freq: 300.00 electric_frequency: 1.91 hall_freq: 0.00 mechanical_freq: 0.38 gear_freq: 0.001913 changing_frequency initial 0
t: 2542.00 ref_freq: 300.00 electric_frequency: 1.89 hall_freq: 0.00 mechanical_freq: 0.38 gear_freq: 0.001889 changing_frequency initial 0
t: 2556.00 ref_freq: 300.00 electric_frequency: 1.91 hall_freq: 0.00 mechanical_freq: 0.38 gear_freq: 0.001912 changing_frequency initial 0
t: 2570.00 ref_freq: 300.00 electric_frequency: 1.82 hall_freq: 0.00 mechanical_freq: 0.36 gear_freq: 0.001821 changing_frequency initial 0
t: 2583.00 ref_freq: 300.00 electric_frequency: 1.79 hall_freq: 0.00 mechanical_freq: 0.36 gear_freq: 0.001795 changing_frequency initial 0
t: 2598.00 ref_freq: 300.00 electric_frequency: 1.74 hall_freq: 0.00 mechanical_freq: 0.35 gear_freq: 0.001743 changing_frequency initial 0
t: 2612.00 ref_freq: 300.00 electric_frequency: 1.66 hall_freq: 0.00 mechanical_freq: 0.33 gear_freq: 0.001662 changing_frequency initial 0
t: 2625.00 ref_freq: 300.00 electric_frequency: 1.55 hall_freq: 0.00 mechanical_freq: 0.31 gear_freq: 0.001553 changing_frequency initial 0
t: 2639.00 ref_freq: 300.00 electric_frequency: 1.53 hall_freq: 0.00 mechanical_freq: 0.31 gear_freq: 0.001532 changing_frequency initial 0
t: 2652.00 ref_freq: 300.00 electric_frequency: 1.40 hall_freq: 0.00 mechanical_freq: 0.28 gear_freq: 0.001405 changing_frequency initial 0
t: 2667.00 ref_freq: 300.00 electric_frequency: 1.37 hall_freq: 0.00 mechanical_freq: 0.27 gear_freq: 0.001367 changing_frequency initial 0
t: 2682.00 ref_freq: 300.00 electric_frequency: 1.33 hall_freq: 0.00 mechanical_freq: 0.27 gear_freq: 0.001327 changing_frequency initial 0
t: 2697.00 ref_freq: 300.00 electric_frequency: 1.15 hall_freq: 0.00 mechanical_freq: 0.23 gear_freq: 0.001147 changing_frequency initial 0
t: 2711.00 ref_freq: 300.00 electric_frequency: 1.03 hall_freq: 0.00 mechanical_freq: 0.21 gear_freq: 0.001030 changing_frequency initial 0
t: 2725.00 ref_freq: 300.00 electric_frequency: 0.88 hall_freq: 0.00 mechanical_freq: 0.18 gear_freq: 0.000881 changing_frequency initial 0
t: 2739.00 ref_freq: 300.00 electric_frequency: 0.84 hall_freq: 0.00 mechanical_freq: 0.17 gear_freq: 0.000841 changing_frequency initial 0
t: 2753.00 ref_freq: 300.00 electric_frequency: 0.66 hall_freq: 0.00 mechanical_freq: 0.13 gear_freq: 0.000664 changing_frequency initial 0
t: 2768.00 ref_freq: 300.00 electric_frequency: 0.50 hall_freq: 0.00 mechanical_freq: 0.10 gear_freq: 0.000503 changing_frequency initial 0
t: 2782.00 ref_freq: 300.00 electric_frequency: 0.35 hall_freq: 0.00 mechanical_freq: 0.07 gear_freq: 0.000349 changing_frequency initial 0
t: 2795.00 ref_freq: 300.00 electric_frequency: 0.20 hall_freq: 0.00 mechanical_freq: 0.04 gear_freq: 0.000203 changing_frequency initial 0
t: 2809.00 ref_freq: 300.00 electric_frequency: 0.07 hall_freq: 0.00 mechanical_freq: 0.01 gear_freq: 0.000069 changing_frequency initial 0
t: 2823.00 ref_freq: 300.00 electric_frequency: -0.10 hall_freq: 0.00 mechanical_freq: -0.02 gear_freq: -0.000103 changing_frequency initial 0
t: 2837.00 ref_freq: 300.00 electric_frequency: -0.31 hall_freq: 0.00 mechanical_freq: -0.06 gear_freq: -0.000314 changing_frequency initial 0
t: 2851.00 ref_freq: 300.00 electric_frequency: -0.50 hall_freq: 0.00 mechanical_freq: -0.10 gear_freq: -0.000498 changing_frequency initial 0
t: 2864.00 ref_freq: 300.00 electric_frequency: -0.69 hall_freq: 0.00 mechanical_freq: -0.14 gear_freq: -0.000691 changing_frequency initial 0
t: 2892.00 ref_freq: 300.00 electric_frequency: -1.08 hall_freq: 0.00 mechanical_freq: -0.22 gear_freq: -0.001083 changing_frequency initial 0
t: 2906.00 ref_freq: 300.00 electric_frequency: -1.26 hall_freq: 0.00 mechanical_freq: -0.25 gear_freq: -0.001265 changing_frequency initial 0
t: 2920.00 ref_freq: 300.00 electric_frequency: -1.47 hall_freq: 0.00 mechanical_freq: -0.29 gear_freq: -0.001466 changing_frequency initial 0
t: 2935.00 ref_freq: 300.00 electric_frequency: -1.68 hall_freq: 0.00 mechanical_freq: -0.34 gear_freq: -0.001677 changing_frequency initial 0
t: 2951.00 ref_freq: 300.00 electric_frequency: -1.85 hall_freq: 0.00 mechanical_freq: -0.37 gear_freq: -0.001849 changing_frequency initial 0
t: 2966.00 ref_freq: 300.00 electric_frequency: -2.11 hall_freq: 0.00 mechanical_freq: -0.42 gear_freq: -0.002114 changing_frequency initial 0
t: 2980.00 ref_freq: 300.00 electric_frequency: -2.33 hall_freq: 0.00 mechanical_freq: -0.47 gear_freq: -0.002330 changing_frequency initial 0
t: 2994.00 ref_freq: 300.00 electric_frequency: -2.45 hall_freq: 0.00 mechanical_freq: -0.49 gear_freq: -0.002449 changing_frequency initial 0
t: 3008.00 ref_freq: 300.00 electric_frequency: -2.58 hall_freq: 0.00 mechanical_freq: -0.52 gear_freq: -0.002583 changing_frequency initial 0
t: 3022.00 ref_freq: 300.00 electric_frequency: -2.66 hall_freq: 0.00 mechanical_freq: -0.53 gear_freq: -0.002659 changing_frequency initial 0
t: 3037.00 ref_freq: 300.00 electric_frequency: -2.78 hall_freq: 0.00 mechanical_freq: -0.56 gear_freq: -0.002785 changing_frequency initial 0
t: 3052.00 ref_freq: 300.00 electric_frequency: -2.83 hall_freq: 0.00 mechanical_freq: -0.57 gear_freq: -0.002830 changing_frequency initial 0
t: 3067.00 ref_freq: 300.00 electric_frequency: -2.82 hall_freq: 0.00 mechanical_freq: -0.56 gear_freq: -0.002816 changing_frequency initial 0
t: 3082.00 ref_freq: 300.00 electric_frequency: -2.87 hall_freq: 0.00 mechanical_freq: -0.57 gear_freq: -0.002873 changing_frequency initial 0
t: 3097.00 ref_freq: 300.00 electric_frequency: -2.79 hall_freq: 0.00 mechanical_freq: -0.56 gear_freq: -0.002793 changing_frequency initial 0
t: 3111.00 ref_freq: 300.00 electric_frequency: -2.75 hall_freq: 0.00 mechanical_freq: -0.55 gear_freq: -0.002749 changing_frequency initial 0
t: 3125.00 ref_freq: 300.00 electric_frequency: -2.69 hall_freq: 0.00 mechanical_freq: -0.54 gear_freq: -0.002690 changing_frequency initial 0
t: 3140.00 ref_freq: 300.00 electric_frequency: -2.62 hall_freq: 0.00 mechanical_freq: -0.52 gear_freq: -0.002617 changing_frequency initial 0
t: 3155.00 ref_freq: 300.00 electric_frequency: -2.47 hall_freq: 0.00 mechanical_freq: -0.49 gear_freq: -0.002469 changing_frequency initial 0
t: 3169.00 ref_freq: 300.00 electric_frequency: -2.28 hall_freq: 0.00 mechanical_freq: -0.46 gear_freq: -0.002277 changing_frequency initial 0
t: 3183.00 ref_freq: 300.00 electric_frequency: -2.18 hall_freq: 0.00 mechanical_freq: -0.44 gear_freq: -0.002176 changing_frequency initial 0
t: 3197.00 ref_freq: 300.00 electric_frequency: -1.95 hall_freq: 0.00 mechanical_freq: -0.39 gear_freq: -0.001952 changing_frequency initial 0
t: 3211.00 ref_freq: 300.00 electric_frequency: -1.79 hall_freq: 0.00 mechanical_freq: -0.36 gear_freq: -0.001789 changing_frequency initial 0
t: 3227.00 ref_freq: 300.00 electric_frequency: -1.56 hall_freq: 0.00 mechanical_freq: -0.31 gear_freq: -0.001561 changing_frequency initial 0
t: 3242.00 ref_freq: 300.00 electric_frequency: -1.38 hall_freq: 0.00 mechanical_freq: -0.28 gear_freq: -0.001383 changing_frequency initial 0
t: 3256.00 ref_freq: 300.00 electric_frequency: -1.13 hall_freq: 0.00 mechanical_freq: -0.23 gear_freq: -0.001129 changing_frequency initial 0
t: 3268.00 ref_freq: 300.00 electric_frequency: -1.03 hall_freq: 0.00 mechanical_freq: -0.21 gear_freq: -0.001025 changing_frequency initial 0
t: 3282.00 ref_freq: 300.00 electric_frequency: -0.74 hall_freq: 0.00 mechanical_freq: -0.15 gear_freq: -0.000742 changing_frequency initial 0
t: 3295.00 ref_freq: 300.00 electric_frequency: -0.59 hall_freq: 0.00 mechanical_freq: -0.12 gear_freq: -0.000592 changing_frequency initial 0
t: 3308.00 ref_freq: 300.00 electric_frequency: -0.47 hall_freq: 0.00 mechanical_freq: -0.09 gear_freq: -0.000469 changing_frequency initial 0
t: 3322.00 ref_freq: 300.00 electric_frequency: -0.25 hall_freq: 0.00 mechanical_freq: -0.05 gear_freq: -0.000249 changing_frequency initial 0
t: 3336.00 ref_freq: 300.00 electric_frequency: -0.06 hall_freq: 0.00 mechanical_freq: -0.01 gear_freq: -0.000062 changing_frequency initial 0
t: 3349.00 ref_freq: 300.00 electric_frequency: 0.10 hall_freq: 0.00 mechanical_freq: 0.02 gear_freq: 0.000103 changing_frequency initial 0
t: 3362.00 ref_freq: 300.00 electric_frequency: 0.27 hall_freq: 0.00 mechanical_freq: 0.05 gear_freq: 0.000267 changing_frequency initial 0
t: 3376.00 ref_freq: 300.00 electric_frequency: 0.43 hall_freq: 0.00 mechanical_freq: 0.09 gear_freq: 0.000429 changing_frequency initial 0
t: 3388.00 ref_freq: 300.00 electric_frequency: 0.54 hall_freq: 0.00 mechanical_freq: 0.11 gear_freq: 0.000537 changing_frequency initial 0
t: 3402.00 ref_freq: 300.00 electric_frequency: 0.70 hall_freq: 0.00 mechanical_freq: 0.14 gear_freq: 0.000703 changing_frequency initial 0
t: 3416.00 ref_freq: 300.00 electric_frequency: 0.82 hall_freq: 0.00 mechanical_freq: 0.16 gear_freq: 0.000816 changing_frequency initial 0
t: 3430.00 ref_freq: 300.00 electric_frequency: 0.94 hall_freq: 0.00 mechanical_freq: 0.19 gear_freq: 0.000941 changing_frequency initial 0
t: 3443.00 ref_freq: 300.00 electric_frequency: 1.07 hall_freq: 0.00 mechanical_freq: 0.21 gear_freq: 0.001068 changing_frequency initial 0
t: 3457.00 ref_freq: 300.00 electric_frequency: 1.16 hall_freq: 0.00 mechanical_freq: 0.23 gear_freq: 0.001163 changing_frequency initial 0
t: 3470.00 ref_freq: 300.00 electric_frequency: 1.26 hall_freq: 0.00 mechanical_freq: 0.25 gear_freq: 0.001264 changing_frequency initial 0
t: 3484.00 ref_freq: 300.00 electric_frequency: 1.35 hall_freq: 0.00 mechanical_freq: 0.27 gear_freq: 0.001353 changing_frequency initial 0
t: 3498.00 ref_freq: 300.00 electric_frequency: 1.46 hall_freq: 0.00 mechanical_freq: 0.29 gear_freq: 0.001462 changing_frequency initial 0
t: 3512.00 ref_freq: 300.00 electric_frequency: 1.52 hall_freq: 0.00 mechanical_freq: 0.30 gear_freq: 0.001522 changing_frequency initial 0
t: 3526.00 ref_freq: 300.00 electric_frequency: 1.59 hall_freq: 0.00 mechanical_freq: 0.32 gear_freq: 0.001590 changing_frequency initial 0
t: 3539.00 ref_freq: 300.00 electric_frequency: 1.67 hall_freq: 0.00 mechanical_freq: 0.33 gear_freq: 0.001665 changing_frequency initial 0
t: 3552.00 ref_freq: 300.00 electric_frequency: 1.71 hall_freq: 0.00 mechanical_freq: 0.34 gear_freq: 0.001706 changing_frequency initial 0
t: 3567.00 ref_freq: 300.00 electric_frequency: 1.80 hall_freq: 0.00 mechanical_freq: 0.36 gear_freq: 0.001801 changing_frequency initial 0
t: 3581.00 ref_freq: 300.00 electric_frequency: 1.81 hall_freq: 0.00 mechanical_freq: 0.36 gear_freq: 0.001810 changing_frequency initial 0
t: 3595.00 ref_freq: 300.00 electric_frequency: 1.89 hall_freq: 0.00 mechanical_freq: 0.38 gear_freq: 0.001890 changing_frequency initial 0
t: 3610.00 ref_freq: 300.00 electric_frequency: 1.90 hall_freq: 0.00 mechanical_freq: 0.38 gear_freq: 0.001897 changing_frequency initial 0
t: 3624.00 ref_freq: 300.00 electric_frequency: 1.90 hall_freq: 0.00 mechanical_freq: 0.38 gear_freq: 0.001905 changing_frequency initial 0
t: 3638.00 ref_freq: 300.00 electric_frequency: 1.95 hall_freq: 0.00 mechanical_freq: 0.39 gear_freq: 0.001953 changing_frequency initial 0
t: 3653.00 ref_freq: 300.00 electric_frequency: 1.95 hall_freq: 0.00 mechanical_freq: 0.39 gear_freq: 0.001953 changing_frequency initial 0
t: 3667.00 ref_freq: 300.00 electric_frequency: 1.94 hall_freq: 0.00 mechanical_freq: 0.39 gear_freq: 0.001943 changing_frequency initial 0
t: 3681.00 ref_freq: 300.00 electric_frequency: 1.95 hall_freq: 0.00 mechanical_freq: 0.39 gear_freq: 0.001947 changing_frequency initial 0
t: 3695.00 ref_freq: 300.00 electric_frequency: 1.99 hall_freq: 0.00 mechanical_freq: 0.40 gear_freq: 0.001987 changing_frequency initial 0
t: 3709.00 ref_freq: 300.00 electric_frequency: 2.02 hall_freq: 0.00 mechanical_freq: 0.40 gear_freq: 0.002021 changing_frequency initial 0
t: 3723.00 ref_freq: 300.00 electric_frequency: 1.92 hall_freq: 0.00 mechanical_freq: 0.38 gear_freq: 0.001921 changing_frequency initial 0
t: 3737.00 ref_freq: 300.00 electric_frequency: 1.89 hall_freq: 0.00 mechanical_freq: 0.38 gear_freq: 0.001888 changing_frequency initial 0
t: 3751.00 ref_freq: 300.00 electric_frequency: 1.86 hall_freq: 0.00 mechanical_freq: 0.37 gear_freq: 0.001861 changing_frequency initial 0
t: 3763.00 ref_freq: 300.00 electric_frequency: 1.85 hall_freq: 0.00 mechanical_freq: 0.37 gear_freq: 0.001846 changing_frequency initial 0
t: 3776.00 ref_freq: 300.00 electric_frequency: 1.83 hall_freq: 0.00 mechanical_freq: 0.37 gear_freq: 0.001826 changing_frequency initial 0
t: 3790.00 ref_freq: 300.00 electric_frequency: 1.79 hall_freq: 0.00 mechanical_freq: 0.36 gear_freq: 0.001787 changing_frequency initial 0
t: 3804.00 ref_freq: 300.00 electric_frequency: 1.71 hall_freq: 0.00 mechanical_freq: 0.34 gear_freq: 0.001707 changing_frequency initial 0
t: 3818.00 ref_freq: 300.00 electric_frequency: 1.68 hall_freq: 0.00 mechanical_freq: 0.34 gear_freq: 0.001679 changing_frequency initial 0
t: 3832.00 ref_freq: 300.00 electric_frequency: 1.51 hall_freq: 0.00 mechanical_freq: 0.30 gear_freq: 0.001514 changing_frequency initial 0
t: 3845.00 ref_freq: 300.00 electric_frequency: 1.52 hall_freq: 0.00 mechanical_freq: 0.30 gear_freq: 0.001515 changing_frequency initial 0
t: 3859.00 ref_freq: 300.00 electric_frequency: 1.40 hall_freq: 0.00 mechanical_freq: 0.28 gear_freq: 0.001403 changing_frequency initial 0
t: 3873.00 ref_freq: 300.00 electric_frequency: 1.32 hall_freq: 0.00 mechanical_freq: 0.26 gear_freq: 0.001325 changing_frequency initial 0
t: 3888.00 ref_freq: 300.00 electric_frequency: 1.23 hall_freq: 0.00 mechanical_freq: 0.25 gear_freq: 0.001226 changing_frequency initial 0
t: 3902.00 ref_freq: 300.00 electric_frequency: 1.12 hall_freq: 0.00 mechanical_freq: 0.22 gear_freq: 0.001120 changing_frequency initial 0
t: 3916.00 ref_freq: 300.00 electric_frequency: 1.06 hall_freq: 0.00 mechanical_freq: 0.21 gear_freq: 0.001060 changing_frequency initial 0
t: 3930.00 ref_freq: 300.00 electric_frequency: 0.92 hall_freq: 0.00 mechanical_freq: 0.18 gear_freq: 0.000920 changing_frequency initial 0
t: 3944.00 ref_freq: 300.00 electric_frequency: 0.77 hall_freq: 0.00 mechanical_freq: 0.15 gear_freq: 0.000771 changing_frequency initial 0
t: 3959.00 ref_freq: 300.00 electric_frequency: 0.61 hall_freq: 0.00 mechanical_freq: 0.12 gear_freq: 0.000611 changing_frequency initial 0
t: 3973.00 ref_freq: 300.00 electric_frequency: 0.48 hall_freq: 0.00 mechanical_freq: 0.10 gear_freq: 0.000475 changing_frequency initial 0
t: 3987.00 ref_freq: 300.00 electric_frequency: 0.25 hall_freq: 0.00 mechanical_freq: 0.05 gear_freq: 0.000249 changing_frequency initial 0
t: 4002.00 ref_freq: 300.00 electric_frequency: 0.12 hall_freq: 0.00 mechanical_freq: 0.02 gear_freq: 0.000123 changing_frequency initial 0
t: 4016.00 ref_freq: 300.00 electric_frequency: -0.01 hall_freq: 0.00 mechanical_freq: -0.00 gear_freq: -0.000012 changing_frequency initial 0
t: 4030.00 ref_freq: 300.00 electric_frequency: -0.22 hall_freq: 0.00 mechanical_freq: -0.04 gear_freq: -0.000222 changing_frequency initial 0
t: 4044.00 ref_freq: 300.00 electric_frequency: -0.40 hall_freq: 0.00 mechanical_freq: -0.08 gear_freq: -0.000401 changing_frequency initial 0
t: 4059.00 ref_freq: 300.00 electric_frequency: -0.62 hall_freq: 0.00 mechanical_freq: -0.12 gear_freq: -0.000617 changing_frequency initial 0
t: 4073.00 ref_freq: 300.00 electric_frequency: -0.86 hall_freq: 0.00 mechanical_freq: -0.17 gear_freq: -0.000862 changing_frequency initial 0
t: 4087.00 ref_freq: 300.00 electric_frequency: -0.99 hall_freq: 0.00 mechanical_freq: -0.20 gear_freq: -0.000992 changing_frequency initial 0
t: 4102.00 ref_freq: 300.00 electric_frequency: -1.29 hall_freq: 0.00 mechanical_freq: -0.26 gear_freq: -0.001286 changing_frequency initial 0
t: 4116.00 ref_freq: 300.00 electric_frequency: -1.43 hall_freq: 0.00 mechanical_freq: -0.29 gear_freq: -0.001431 changing_frequency initial 0
t: 4130.00 ref_freq: 300.00 electric_frequency: -1.62 hall_freq: 0.00 mechanical_freq: -0.32 gear_freq: -0.001619 changing_frequency initial 0
t: 4144.00 ref_freq: 300.00 electric_frequency: -1.81 hall_freq: 0.00 mechanical_freq: -0.36 gear_freq: -0.001810 changing_frequency initial 0
t: 4159.00 ref_freq: 300.00 electric_frequency: -1.96 hall_freq: 0.00 mechanical_freq: -0.39 gear_freq: -0.001961 changing_frequency initial 0
t: 4174.00 ref_freq: 300.00 electric_frequency: -2.21 hall_freq: 0.00 mechanical_freq: -0.44 gear_freq: -0.002208 changing_frequency initial 0
t: 4188.00 ref_freq: 300.00 electric_frequency: -2.35 hall_freq: 0.00 mechanical_freq: -0.47 gear_freq: -0.002346 changing_frequency initial 0
t: 4202.00 ref_freq: 300.00 electric_frequency: -2.52 hall_freq: 0.00 mechanical_freq: -0.50 gear_freq: -0.002518 changing_frequency initial 0
t: 4216.00 ref_freq: 300.00 electric_frequency: -2.65 hall_freq: 0.00 mechanical_freq: -0.53 gear_freq: -0.002650 changing_frequency initial 0
t: 4231.00 ref_freq: 300.00 electric_frequency: -2.76 hall_freq: 0.00 mechanical_freq: -0.55 gear_freq: -0.002757 changing_frequency initial 0
t: 4245.00 ref_freq: 300.00 electric_frequency: -2.84 hall_freq: 0.00 mechanical_freq: -0.57 gear_freq: -0.002840 changing_frequency initial 0
t: 4258.00 ref_freq: 300.00 electric_frequency: -2.88 hall_freq: 0.00 mechanical_freq: -0.58 gear_freq: -0.002879 changing_frequency initial 0
t: 4272.00 ref_freq: 300.00 electric_frequency: -2.90 hall_freq: 0.00 mechanical_freq: -0.58 gear_freq: -0.002901 changing_frequency initial 0
t: 4286.00 ref_freq: 300.00 electric_frequency: -2.88 hall_freq: 0.00 mechanical_freq: -0.58 gear_freq: -0.002880 changing_frequency initial 0
t: 4301.00 ref_freq: 300.00 electric_frequency: -2.85 hall_freq: 0.00 mechanical_freq: -0.57 gear_freq: -0.002853 changing_frequency initial 0
t: 4316.00 ref_freq: 300.00 electric_frequency: -2.76 hall_freq: 0.00 mechanical_freq: -0.55 gear_freq: -0.002759 changing_frequency initial 0
t: 4331.00 ref_freq: 300.00 electric_frequency: -2.66 hall_freq: 0.00 mechanical_freq: -0.53 gear_freq: -0.002662 changing_frequency initial 0
t: 4345.00 ref_freq: 300.00 electric_frequency: -2.50 hall_freq: 0.00 mechanical_freq: -0.50 gear_freq: -0.002504 changing_frequency initial 0
t: 4359.00 ref_freq: 300.00 electric_frequency: -2.44 hall_freq: 0.00 mechanical_freq: -0.49 gear_freq: -0.002441 changing_frequency initial 0
t: 4373.00 ref_freq: 300.00 electric_frequency: -2.25 hall_freq: 0.00 mechanical_freq: -0.45 gear_freq: -0.002254 changing_frequency initial 0
t: 4388.00 ref_freq: 300.00 electric_frequency: -2.07 hall_freq: 0.00 mechanical_freq: -0.41 gear_freq: -0.002070 changing_frequency initial 0
t: 4402.00 ref_freq: 300.00 electric_frequency: -1.95 hall_freq: 0.00 mechanical_freq: -0.39 gear_freq: -0.001952 changing_frequency initial 0
t: 4417.00 ref_freq: 300.00 electric_frequency: -1.74 hall_freq: 0.00 mechanical_freq: -0.35 gear_freq: -0.001736 changing_frequency initial 0
t: 4431.00 ref_freq: 300.00 electric_frequency: -1.53 hall_freq: 0.00 mechanical_freq: -0.31 gear_freq: -0.001526 changing_frequency initial 0
t: 4445.00 ref_freq: 300.00 electric_frequency: -1.27 hall_freq: 0.00 mechanical_freq: -0.25 gear_freq: -0.001274 changing_frequency initial 0
t: 4461.00 ref_freq: 300.00 electric_frequency: -1.11 hall_freq: 0.00 mechanical_freq: -0.22 gear_freq: -0.001108 changing_frequency initial 0
t: 4475.00 ref_freq: 300.00 electric_frequency: -0.85 hall_freq: 0.00 mechanical_freq: -0.17 gear_freq: -0.000849 changing_frequency initial 0
t: 4488.00 ref_freq: 300.00 electric_frequency: -0.67 hall_freq: 0.00 mechanical_freq: -0.13 gear_freq: -0.000675 changing_frequency initial 0
t: 4502.00 ref_freq: 300.00 electric_frequency: -0.52 hall_freq: 0.00 mechanical_freq: -0.10 gear_freq: -0.000521 changing_frequency initial 0
t: 4516.00 ref_freq: 300.00 electric_frequency: -0.30 hall_freq: 0.00 mechanical_freq: -0.06 gear_freq: -0.000298 changing_frequency initial 0
t: 4529.00 ref_freq: 300.00 electric_frequency: -0.18 hall_freq: 0.00 mechanical_freq: -0.04 gear_freq: -0.000178 changing_frequency initial 0
t: 4541.00 ref_freq: 300.00 electric_frequency: -0.04 hall_freq: 0.00 mechanical_freq: -0.01 gear_freq: -0.000040 changing_frequency initial 0
t: 4554.00 ref_freq: 300.00 electric_frequency: 0.17 hall_freq: 0.00 mechanical_freq: 0.03 gear_freq: 0.000173 changing_frequency initial 0
t: 4567.00 ref_freq: 300.00 electric_frequency: 0.29 hall_freq: 0.00 mechanical_freq: 0.06 gear_freq: 0.000293 changing_frequency initial 0
t: 4581.00 ref_freq: 300.00 electric_frequency: 0.48 hall_freq: 0.00 mechanical_freq: 0.10 gear_freq: 0.000475 changing_frequency initial 0
t: 4594.00 ref_freq: 300.00 electric_frequency: 0.59 hall_freq: 0.00 mechanical_freq: 0.12 gear_freq: 0.000591 changing_frequency initial 0
t: 4608.00 ref_freq: 300.00 electric_frequency: 0.74 hall_freq: 0.00 mechanical_freq: 0.15 gear_freq: 0.000741 changing_frequency initial 0
t: 4621.00 ref_freq: 300.00 electric_frequency: 0.88 hall_freq: 0.00 mechanical_freq: 0.18 gear_freq: 0.000876 changing_frequency initial 0
t: 4635.00 ref_freq: 300.00 electric_frequency: 0.99 hall_freq: 0.00 mechanical_freq: 0.20 gear_freq: 0.000987 changing_frequency initial 0
t: 4648.00 ref_freq: 300.00 electric_frequency: 1.08 hall_freq: 0.00 mechanical_freq: 0.22 gear_freq: 0.001079 changing_frequency initial 0
t: 4661.00 ref_freq: 300.00 electric_frequency: 1.19 hall_freq: 0.00 mechanical_freq: 0.24 gear_freq: 0.001191 changing_frequency initial 0
t: 4675.00 ref_freq: 300.00 electric_frequency: 1.32 hall_freq: 0.00 mechanical_freq: 0.26 gear_freq: 0.001320 changing_frequency initial 0
t: 4689.00 ref_freq: 300.00 electric_frequency: 1.40 hall_freq: 0.00 mechanical_freq: 0.28 gear_freq: 0.001398 changing_frequency initial 0
t: 4701.00 ref_freq: 300.00 electric_frequency: 1.41 hall_freq: 0.00 mechanical_freq: 0.28 gear_freq: 0.001414 changing_frequency initial 0
t: 4715.00 ref_freq: 300.00 electric_frequency: 1.54 hall_freq: 0.00 mechanical_freq: 0.31 gear_freq: 0.001536 changing_frequency initial 0
t: 4728.00 ref_freq: 300.00 electric_frequency: 1.60 hall_freq: 0.00 mechanical_freq: 0.32 gear_freq: 0.001600 changing_frequency initial 0
t: 4742.00 ref_freq: 300.00 electric_frequency: 1.66 hall_freq: 0.00 mechanical_freq: 0.33 gear_freq: 0.001658 changing_frequency initial 0
t: 4756.00 ref_freq: 300.00 electric_frequency: 1.72 hall_freq: 0.00 mechanical_freq: 0.34 gear_freq: 0.001718 changing_frequency initial 0
t: 4769.00 ref_freq: 300.00 electric_frequency: 1.79 hall_freq: 0.00 mechanical_freq: 0.36 gear_freq: 0.001790 changing_frequency initial 0
t: 4783.00 ref_freq: 300.00 electric_frequency: 1.82 hall_freq: 0.00 mechanical_freq: 0.36 gear_freq: 0.001816 changing_frequency initial 0
t: 4797.00 ref_freq: 300.00 electric_frequency: 1.80 hall_freq: 0.00 mechanical_freq: 0.36 gear_freq: 0.001800 changing_frequency initial 0
t: 4811.00 ref_freq: 300.00 electric_frequency: 1.89 hall_freq: 0.00 mechanical_freq: 0.38 gear_freq: 0.001887 changing_frequency initial 0
t: 4824.00 ref_freq: 300.00 electric_frequency: 1.94 hall_freq: 0.00 mechanical_freq: 0.39 gear_freq: 0.001935 changing_frequency initial 0
t: 4837.00 ref_freq: 300.00 electric_frequency: 1.99 hall_freq: 0.00 mechanical_freq: 0.40 gear_freq: 0.001989 changing_frequency initial 0
t: 4851.00 ref_freq: 300.00 electric_frequency: 1.96 hall_freq: 0.00 mechanical_freq: 0.39 gear_freq: 0.001957 changing_frequency initial 0
t: 4865.00 ref_freq: 300.00 electric_frequency: 1.97 hall_freq: 0.00 mechanical_freq: 0.39 gear_freq: 0.001968 changing_frequency initial 0
t: 4879.00 ref_freq: 300.00 electric_frequency: 1.95 hall_freq: 0.00 mechanical_freq: 0.39 gear_freq: 0.001951 changing_frequency initial 0
t: 4893.00 ref_freq: 300.00 electric_frequency: 1.93 hall_freq: 0.00 mechanical_freq: 0.39 gear_freq: 0.001928 changing_frequency initial 0
t: 4907.00 ref_freq: 300.00 electric_frequency: 1.99 hall_freq: 0.00 mechanical_freq: 0.40 gear_freq: 0.001987 changing_frequency initial 0
t: 4921.00 ref_freq: 300.00 electric_frequency: 1.92 hall_freq: 0.00 mechanical_freq: 0.38 gear_freq: 0.001919 changing_frequency initial 0
t: 4935.00 ref_freq: 300.00 electric_frequency: 1.90 hall_freq: 0.00 mechanical_freq: 0.38 gear_freq: 0.001898 changing_frequency initial 0
t: 4948.00 ref_freq: 300.00 electric_frequency: 1.86 hall_freq: 0.00 mechanical_freq: 0.37 gear_freq: 0.001862 changing_frequency initial 0
t: 4961.00 ref_freq: 300.00 electric_frequency: 1.90 hall_freq: 0.00 mechanical_freq: 0.38 gear_freq: 0.001898 changing_frequency initial 0
t: 4974.00 ref_freq: 300.00 electric_frequency: 1.81 hall_freq: 0.00 mechanical_freq: 0.36 gear_freq: 0.001807 changing_frequency initial 0
t: 4988.00 ref_freq: 300.00 electric_frequency: 1.70 hall_freq: 0.00 mechanical_freq: 0.34 gear_freq: 0.001696 changing_frequency initial 0
t: 5002.00 ref_freq: 300.00 electric_frequency: 1.72 hall_freq: 0.00 mechanical_freq: 0.34 gear_freq: 0.001717 changing_frequency initial 0
t: 5017.00 ref_freq: 300.00 electric_frequency: 1.72 hall_freq: 0.00 mechanical_freq: 0.34 gear_freq: 0.001719 changing_frequency initial 0
t: 5031.00 ref_freq: 300.00 electric_frequency: 1.62 hall_freq: 0.00 mechanical_freq: 0.32 gear_freq: 0.001620 changing_frequency initial 0
t: 5045.00 ref_freq: 300.00 electric_frequency: 1.55 hall_freq: 0.00 mechanical_freq: 0.31 gear_freq: 0.001552 changing_frequency initial 0
t: 5058.00 ref_freq: 300.00 electric_frequency: 1.42 hall_freq: 0.00 mechanical_freq: 0.28 gear_freq: 0.001417 changing_frequency initial 0
t: 5073.00 ref_freq: 300.00 electric_frequency: 1.28 hall_freq: 0.00 mechanical_freq: 0.26 gear_freq: 0.001281 changing_frequency initial 0
t: 5087.00 ref_freq: 300.00 electric_frequency: 1.25 hall_freq: 0.00 mechanical_freq: 0.25 gear_freq: 0.001253 changing_frequency initial 0
t: 5101.00 ref_freq: 300.00 electric_frequency: 1.16 hall_freq: 0.00 mechanical_freq: 0.23 gear_freq: 0.001164 changing_frequency initial 0
t: 5114.00 ref_freq: 300.00 electric_frequency: 1.01 hall_freq: 0.00 mechanical_freq: 0.20 gear_freq: 0.001009 changing_frequency initial 0
t: 5127.00 ref_freq: 300.00 electric_frequency: 0.92 hall_freq: 0.00 mechanical_freq: 0.18 gear_freq: 0.000924 changing_frequency initial 0
t: 5140.00 ref_freq: 300.00 electric_frequency: 0.81 hall_freq: 0.00 mechanical_freq: 0.16 gear_freq: 0.000811 changing_frequency initial 0
t: 5154.00 ref_freq: 300.00 electric_frequency: 0.66 hall_freq: 0.00 mechanical_freq: 0.13 gear_freq: 0.000659 changing_frequency initial 0
t: 5169.00 ref_freq: 300.00 electric_frequency: 0.51 hall_freq: 0.00 mechanical_freq: 0.10 gear_freq: 0.000505 changing_frequency initial 0
t: 5198.00 ref_freq: 300.00 electric_frequency: 0.18 hall_freq: 0.00 mechanical_freq: 0.04 gear_freq: 0.000178 changing_frequency initial 0
t: 5213.00 ref_freq: 300.00 electric_frequency: 0.03 hall_freq: 0.00 mechanical_freq: 0.01 gear_freq: 0.000032 changing_frequency initial 0
t: 5226.00 ref_freq: 300.00 electric_frequency: -0.13 hall_freq: 0.00 mechanical_freq: -0.03 gear_freq: -0.000134 changing_frequency initial 0
t: 5239.00 ref_freq: 300.00 electric_frequency: -0.36 hall_freq: 0.00 mechanical_freq: -0.07 gear_freq: -0.000360 changing_frequency initial 0
t: 5253.00 ref_freq: 300.00 electric_frequency: -0.51 hall_freq: 0.00 mechanical_freq: -0.10 gear_freq: -0.000505 changing_frequency initial 0
t: 5267.00 ref_freq: 300.00 electric_frequency: -0.74 hall_freq: 0.00 mechanical_freq: -0.15 gear_freq: -0.000740 changing_frequency initial 0
t: 5282.00 ref_freq: 300.00 electric_frequency: -0.93 hall_freq: 0.00 mechanical_freq: -0.19 gear_freq: -0.000925 changing_frequency initial 0
t: 5296.00 ref_freq: 300.00 electric_frequency: -1.13 hall_freq: 0.00 mechanical_freq: -0.23 gear_freq: -0.001134 changing_frequency initial 0
t: 5309.00 ref_freq: 300.00 electric_frequency: -1.31 hall_freq: 0.00 mechanical_freq: -0.26 gear_freq: -0.001310 changing_frequency initial 0
t: 5322.00 ref_freq: 300.00 electric_frequency: -1.49 hall_freq: 0.00 mechanical_freq: -0.30 gear_freq: -0.001493 changing_frequency initial 0
t: 5335.00 ref_freq: 300.00 electric_frequency: -1.68 hall_freq: 0.00 mechanical_freq: -0.34 gear_freq: -0.001681 changing_frequency initial 0
t: 5349.00 ref_freq: 300.00 electric_frequency: -1.87 hall_freq: 0.00 mechanical_freq: -0.37 gear_freq: -0.001871 changing_frequency initial 0
t: 5364.00 ref_freq: 300.00 electric_frequency: -2.08 hall_freq: 0.00 mechanical_freq: -0.42 gear_freq: -0.002083 changing_frequency initial 0
t: 5378.00 ref_freq: 300.00 electric_frequency: -2.24 hall_freq: 0.00 mechanical_freq: -0.45 gear_freq: -0.002239 changing_frequency initial 0
t: 5391.00 ref_freq: 300.00 electric_frequency: -2.40 hall_freq: 0.00 mechanical_freq: -0.48 gear_freq: -0.002396 changing_frequency initial 0
t: 5406.00 ref_freq: 300.00 electric_frequency: -2.51 hall_freq: 0.00 mechanical_freq: -0.50 gear_freq: -0.002508 changing_frequency initial 0
t: 5420.00 ref_freq: 300.00 electric_frequency: -2.65 hall_freq: 0.00 mechanical_freq: -0.53 gear_freq: -0.002652 changing_frequency initial 0
t: 5433.00 ref_freq: 300.00 electric_frequency: -2.75 hall_freq: 0.00 mechanical_freq: -0.55 gear_freq: -0.002749 changing_frequency initial 0
t: 5447.00 ref_freq: 300.00 electric_frequency: -2.83 hall_freq: 0.00 mechanical_freq: -0.57 gear_freq: -0.002830 changing_frequency initial 0
t: 5460.00 ref_freq: 300.00 electric_frequency: -2.90 hall_freq: 0.00 mechanical_freq: -0.58 gear_freq: -0.002903 changing_frequency initial 0
t: 5474.00 ref_freq: 300.00 electric_frequency: -2.86 hall_freq: 0.00 mechanical_freq: -0.57 gear_freq: -0.002864 changing_frequency initial 0
t: 5487.00 ref_freq: 300.00 electric_frequency: -2.88 hall_freq: 0.00 mechanical_freq: -0.58 gear_freq: -0.002877 changing_frequency initial 0
t: 5502.00 ref_freq: 300.00 electric_frequency: -2.82 hall_freq: 0.00 mechanical_freq: -0.56 gear_freq: -0.002819 changing_frequency initial 0
t: 5516.00 ref_freq: 300.00 electric_frequency: -2.78 hall_freq: 0.00 mechanical_freq: -0.56 gear_freq: -0.002776 changing_frequency initial 0
t: 5529.00 ref_freq: 300.00 electric_frequency: -2.63 hall_freq: 0.00 mechanical_freq: -0.53 gear_freq: -0.002633 changing_frequency initial 0
t: 5542.00 ref_freq: 300.00 electric_frequency: -2.58 hall_freq: 0.00 mechanical_freq: -0.52 gear_freq: -0.002583 changing_frequency initial 0
t: 5555.00 ref_freq: 300.00 electric_frequency: -2.48 hall_freq: 0.00 mechanical_freq: -0.50 gear_freq: -0.002481 changing_frequency initial 0
t: 5569.00 ref_freq: 300.00 electric_frequency: -2.32 hall_freq: 0.00 mechanical_freq: -0.46 gear_freq: -0.002323 changing_frequency initial 0
t: 5583.00 ref_freq: 300.00 electric_frequency: -2.14 hall_freq: 0.00 mechanical_freq: -0.43 gear_freq: -0.002135 changing_frequency initial 0
t: 5597.00 ref_freq: 300.00 electric_frequency: -2.02 hall_freq: 0.00 mechanical_freq: -0.40 gear_freq: -0.002017 changing_frequency initial 0
t: 5611.00 ref_freq: 300.00 electric_frequency: -1.82 hall_freq: 0.00 mechanical_freq: -0.36 gear_freq: -0.001816 changing_frequency initial 0
t: 5624.00 ref_freq: 300.00 electric_frequency: -1.59 hall_freq: 0.00 mechanical_freq: -0.32 gear_freq: -0.001586 changing_frequency initial 0
t: 5637.00 ref_freq: 300.00 electric_frequency: -1.47 hall_freq: 0.00 mechanical_freq: -0.29 gear_freq: -0.001468 changing_frequency initial 0
t: 5651.00 ref_freq: 300.00 electric_frequency: -1.22 hall_freq: 0.00 mechanical_freq: -0.24 gear_freq: -0.001223 changing_frequency initial 0
t: 5664.00 ref_freq: 300.00 electric_frequency: -1.00 hall_freq: 0.00 mechanical_freq: -0.20 gear_freq: -0.000998 changing_frequency initial 0
t: 5677.00 ref_freq: 300.00 electric_frequency: -0.85 hall_freq: 0.00 mechanical_freq: -0.17 gear_freq: -0.000854 changing_frequency initial 0
t: 5691.00 ref_freq: 300.00 electric_frequency: -0.69 hall_freq: 0.00 mechanical_freq: -0.14 gear_freq: -0.000694 changing_frequency initial 0
t: 5705.00 ref_freq: 300.00 electric_frequency: -0.49 hall_freq: 0.00 mechanical_freq: -0.10 gear_freq: -0.000488 changing_frequency initial 0
t: 5718.00 ref_freq: 300.00 electric_frequency: -0.32 hall_freq: 0.00 mechanical_freq: -0.06 gear_freq: -0.000317 changing_frequency initial 0
t: 5731.00 ref_freq: 300.00 electric_frequency: -0.13 hall_freq: 0.00 mechanical_freq: -0.03 gear_freq: -0.000135 changing_frequency initial 0
t: 5745.00 ref_freq: 300.00 electric_frequency: 0.06 hall_freq: 0.00 mechanical_freq: 0.01 gear_freq: 0.000058 changing_frequency initial 0
t: 5757.00 ref_freq: 300.00 electric_frequency: 0.16 hall_freq: 0.00 mechanical_freq: 0.03 gear_freq: 0.000157 changing_frequency initial 0
t: 5770.00 ref_freq: 300.00 electric_frequency: 0.34 hall_freq: 0.00 mechanical_freq: 0.07 gear_freq: 0.000336 changing_frequency initial 0
t: 5783.00 ref_freq: 300.00 electric_frequency: 0.50 hall_freq: 0.00 mechanical_freq: 0.10 gear_freq: 0.000504 changing_frequency initial 0
t: 5796.00 ref_freq: 300.00 electric_frequency: 0.63 hall_freq: 0.00 mechanical_freq: 0.13 gear_freq: 0.000630 changing_frequency initial 0
t: 5811.00 ref_freq: 300.00 electric_frequency: 0.80 hall_freq: 0.00 mechanical_freq: 0.16 gear_freq: 0.000795 changing_frequency initial 0
t: 5824.00 ref_freq: 300.00 electric_frequency: 0.90 hall_freq: 0.00 mechanical_freq: 0.18 gear_freq: 0.000900 changing_frequency initial 0
t: 5837.00 ref_freq: 300.00 electric_frequency: 1.01 hall_freq: 0.00 mechanical_freq: 0.20 gear_freq: 0.001012 changing_frequency initial 0
t: 5849.00 ref_freq: 300.00 electric_frequency: 1.12 hall_freq: 0.00 mechanical_freq: 0.22 gear_freq: 0.001118 changing_frequency initial 0
t: 5862.00 ref_freq: 300.00 electric_frequency: 1.22 hall_freq: 0.00 mechanical_freq: 0.24 gear_freq: 0.001216 changing_frequency initial 0
t: 5875.00 ref_freq: 300.00 electric_frequency: 1.30 hall_freq: 0.00 mechanical_freq: 0.26 gear_freq: 0.001304 changing_frequency initial 0
t: 5889.00 ref_freq: 300.00 electric_frequency: 1.41 hall_freq: 0.00 mechanical_freq: 0.28 gear_freq: 0.001407 changing_frequency initial 0
t: 5902.00 ref_freq: 300.00 electric_frequency: 1.48 hall_freq: 0.00 mechanical_freq: 0.30 gear_freq: 0.001480 changing_frequency initial 0
t: 5915.00 ref_freq: 300.00 electric_frequency: 1.54 hall_freq: 0.00 mechanical_freq: 0.31 gear_freq: 0.001543 changing_frequency initial 0
t: 5929.00 ref_freq: 300.00 electric_frequency: 1.63 hall_freq: 0.00 mechanical_freq: 0.33 gear_freq: 0.001631 changing_frequency initial 0
t: 5943.00 ref_freq: 300.00 electric_frequency: 1.69 hall_freq: 0.00 mechanical_freq: 0.34 gear_freq: 0.001688 changing_frequency initial 0
t: 5956.00 ref_freq: 300.00 electric_frequency: 1.68 hall_freq: 0.00 mechanical_freq: 0.34 gear_freq: 0.001678 changing_frequency initial 0
t: 5970.00 ref_freq: 300.00 electric_frequency: 1.80 hall_freq: 0.00 mechanical_freq: 0.36 gear_freq: 0.001795 changing_frequency initial 0
t: 5983.00 ref_freq: 300.00 electric_frequency: 1.76 hall_freq: 0.00 mechanical_freq: 0.35 gear_freq: 0.001762 changing_frequency initial 0
t: 5997.00 ref_freq: 300.00 electric_frequency: 1.91 hall_freq: 0.00 mechanical_freq: 0.38 gear_freq: 0.001909 changing_frequency initial 0
t: 6010.00 ref_freq: 300.00 electric_frequency: 1.89 hall_freq: 0.00 mechanical_freq: 0.38 gear_freq: 0.001893 changing_frequency initial 0
t: 6023.00 ref_freq: 300.00 electric_frequency: 1.95 hall_freq: 0.00 mechanical_freq: 0.39 gear_freq: 0.001950 changing_frequency initial 0
t: 6036.00 ref_freq: 300.00 electric_frequency: 1.93 hall_freq: 0.00 mechanical_freq: 0.39 gear_freq: 0.001930 changing_frequency initial 0
t: 6049.00 ref_freq: 300.00 electric_frequency: 1.97 hall_freq: 0.00 mechanical_freq: 0.39 gear_freq: 0.001968 changing_frequency initial 0
t: 6062.00 ref_freq: 300.00 electric_frequency: 1.98 hall_freq: 0.00 mechanical_freq: 0.40 gear_freq: 0.001977 changing_frequency initial 0
t: 6075.00 ref_freq: 300.00 electric_frequency: 2.01 hall_freq: 0.00 mechanical_freq: 0.40 gear_freq: 0.002005 changing_frequency initial 0
t: 6088.00 ref_freq: 300.00 electric_frequency: 1.90 hall_freq: 0.00 mechanical_freq: 0.38 gear_freq: 0.001901 changing_frequency initial 0
t: 6101.00 ref_freq: 300.00 electric_frequency: 1.93 hall_freq: 0.00 mechanical_freq: 0.39 gear_freq: 0.001929 changing_frequency initial 0
t: 6115.00 ref_freq: 300.00 electric_frequency: 1.97 hall_freq: 0.00 mechanical_freq: 0.39 gear_freq: 0.001971 changing_frequency initial 0
t: 6128.00 ref_freq: 300.00 electric_frequency: 1.87 hall_freq: 0.00 mechanical_freq: 0.37 gear_freq: 0.001866 changing_frequency initial 0
t: 6141.00 ref_freq: 300.00 electric_frequency: 1.90 hall_freq: 0.00 mechanical_freq: 0.38 gear_freq: 0.001896 changing_frequency initial 0
t: 6154.00 ref_freq: 300.00 electric_frequency: 1.81 hall_freq: 0.00 mechanical_freq: 0.36 gear_freq: 0.001807 changing_frequency initial 0
t: 6167.00 ref_freq: 300.00 electric_frequency: 1.76 hall_freq: 0.00 mechanical_freq: 0.35 gear_freq: 0.001764 changing_frequency initial 0
t: 6180.00 ref_freq: 300.00 electric_frequency: 1.79 hall_freq: 0.00 mechanical_freq: 0.36 gear_freq: 0.001791 changing_frequency initial 0
t: 6193.00 ref_freq: 300.00 electric_frequency: 1.78 hall_freq: 0.00 mechanical_freq: 0.36 gear_freq: 0.001783 changing_frequency initial 0
t: 6207.00 ref_freq: 300.00 electric_frequency: 1.73 hall_freq: 0.00 mechanical_freq: 0.35 gear_freq: 0.001725 changing_frequency initial 0
t: 6221.00 ref_freq: 300.00 electric_frequency: 1.62 hall_freq: 0.00 mechanical_freq: 0.32 gear_freq: 0.001616 changing_frequency initial 0
t: 6234.00 ref_freq: 300.00 electric_frequency: 1.58 hall_freq: 0.00 mechanical_freq: 0.32 gear_freq: 0.001578 changing_frequency initial 0
t: 6249.00 ref_freq: 300.00 electric_frequency: 1.48 hall_freq: 0.00 mechanical_freq: 0.30 gear_freq: 0.001482 changing_frequency initial 0
t: 6262.00 ref_freq: 300.00 electric_frequency: 1.44 hall_freq: 0.00 mechanical_freq: 0.29 gear_freq: 0.001442 changing_frequency initial 0
t: 6276.00 ref_freq: 300.00 electric_frequency: 1.31 hall_freq: 0.00 mechanical_freq: 0.26 gear_freq: 0.001306 changing_frequency initial 0
t: 6290.00 ref_freq: 300.00 electric_frequency: 1.26 hall_freq: 0.00 mechanical_freq: 0.25 gear_freq: 0.001257 changing_frequency initial 0
t: 6304.00 ref_freq: 300.00 electric_frequency: 1.11 hall_freq: 0.00 mechanical_freq: 0.22 gear_freq: 0.001107 changing_frequency initial 0
t: 6318.00 ref_freq: 300.00 electric_frequency: 1.01 hall_freq: 0.00 mechanical_freq: 0.20 gear_freq: 0.001005 changing_frequency initial 0
t: 6331.00 ref_freq: 300.00 electric_frequency: 0.89 hall_freq: 0.00 mechanical_freq: 0.18 gear_freq: 0.000889 changing_frequency initial 0
t: 6344.00 ref_freq: 300.00 electric_frequency: 0.82 hall_freq: 0.00 mechanical_freq: 0.16 gear_freq: 0.000822 changing_frequency initial 0
t: 6357.00 ref_freq: 300.00 electric_frequency: 0.62 hall_freq: 0.00 mechanical_freq: 0.12 gear_freq: 0.000620 changing_frequency initial 0
t: 6371.00 ref_freq: 300.00 electric_frequency: 0.50 hall_freq: 0.00 mechanical_freq: 0.10 gear_freq: 0.000498 changing_frequency initial 0
t: 6386.00 ref_freq: 300.00 electric_frequency: 0.32 hall_freq: 0.00 mechanical_freq: 0.06 gear_freq: 0.000321 changing_frequency initial 0
t: 6400.00 ref_freq: 300.00 electric_frequency: 0.15 hall_freq: 0.00 mechanical_freq: 0.03 gear_freq: 0.000153 changing_frequency initial 0
t: 6414.00 ref_freq: 300.00 electric_frequency: -0.07 hall_freq: 0.00 mechanical_freq: -0.01 gear_freq: -0.000071 changing_frequency initial 0
t: 6428.00 ref_freq: 300.00 electric_frequency: -0.25 hall_freq: 0.00 mechanical_freq: -0.05 gear_freq: -0.000249 changing_frequency initial 0
t: 6441.00 ref_freq: 300.00 electric_frequency: -0.42 hall_freq: 0.00 mechanical_freq: -0.08 gear_freq: -0.000421 changing_frequency initial 0
t: 6455.00 ref_freq: 300.00 electric_frequency: -0.61 hall_freq: 0.00 mechanical_freq: -0.12 gear_freq: -0.000608 changing_frequency initial 0
t: 6469.00 ref_freq: 300.00 electric_frequency: -0.74 hall_freq: 0.00 mechanical_freq: -0.15 gear_freq: -0.000743 changing_frequency initial 0
t: 6482.00 ref_freq: 300.00 electric_frequency: -0.93 hall_freq: 0.00 mechanical_freq: -0.19 gear_freq: -0.000933 changing_frequency initial 0
t: 6495.00 ref_freq: 300.00 electric_frequency: -1.11 hall_freq: 0.00 mechanical_freq: -0.22 gear_freq: -0.001109 changing_frequency initial 0
t: 6508.00 ref_freq: 300.00 electric_frequency: -1.31 hall_freq: 0.00 mechanical_freq: -0.26 gear_freq: -0.001306 changing_frequency initial 0
t: 6522.00 ref_freq: 300.00 electric_frequency: -1.50 hall_freq: 0.00 mechanical_freq: -0.30 gear_freq: -0.001502 changing_frequency initial 0
t: 6536.00 ref_freq: 300.00 electric_frequency: -1.67 hall_freq: 0.00 mechanical_freq: -0.33 gear_freq: -0.001665 changing_frequency initial 0
t: 6549.00 ref_freq: 300.00 electric_frequency: -1.89 hall_freq: 0.00 mechanical_freq: -0.38 gear_freq: -0.001888 changing_frequency initial 0
t: 6562.00 ref_freq: 300.00 electric_frequency: -2.05 hall_freq: 0.00 mechanical_freq: -0.41 gear_freq: -0.002052 changing_frequency initial 0
t: 6590.00 ref_freq: 300.00 electric_frequency: -2.42 hall_freq: 0.00 mechanical_freq: -0.48 gear_freq: -0.002416 changing_frequency initial 0
t: 6604.00 ref_freq: 300.00 electric_frequency: -2.52 hall_freq: 0.00 mechanical_freq: -0.50 gear_freq: -0.002517 changing_frequency initial 0
t: 6618.00 ref_freq: 300.00 electric_frequency: -2.61 hall_freq: 0.00 mechanical_freq: -0.52 gear_freq: -0.002613 changing_frequency initial 0
t: 6631.00 ref_freq: 300.00 electric_frequency: -2.75 hall_freq: 0.00 mechanical_freq: -0.55 gear_freq: -0.002750 changing_frequency initial 0
t: 6644.00 ref_freq: 300.00 electric_frequency: -2.78 hall_freq: 0.00 mechanical_freq: -0.56 gear_freq: -0.002776 changing_frequency initial 0
t: 6657.00 ref_freq: 300.00 electric_frequency: -2.80 hall_freq: 0.00 mechanical_freq: -0.56 gear_freq: -0.002802 changing_frequency initial 0
t: 6671.00 ref_freq: 300.00 electric_frequency: -2.92 hall_freq: 0.00 mechanical_freq: -0.58 gear_freq: -0.002925 changing_frequency initial 0
t: 6686.00 ref_freq: 300.00 electric_frequency: -2.86 hall_freq: 0.00 mechanical_freq: -0.57 gear_freq: -0.002856 changing_frequency initial 0
t: 6700.00 ref_freq: 300.00 electric_frequency: -2.83 hall_freq: 0.00 mechanical_freq: -0.57 gear_freq: -0.002828 changing_frequency initial 0
t: 6714.00 ref_freq: 300.00 electric_frequency: -2.78 hall_freq: 0.00 mechanical_freq: -0.56 gear_freq: -0.002778 changing_frequency initial 0
t: 6728.00 ref_freq: 300.00 electric_frequency: -2.67 hall_freq: 0.00 mechanical_freq: -0.53 gear_freq: -0.002665 changing_frequency initial 0
t: 6743.00 ref_freq: 300.00 electric_frequency: -2.62 hall_freq: 0.00 mechanical_freq: -0.52 gear_freq: -0.002624 changing_frequency initial 0
t: 6758.00 ref_freq: 300.00 electric_frequency: -2.39 hall_freq: 0.00 mechanical_freq: -0.48 gear_freq: -0.002394 changing_frequency initial 0
t: 6772.00 ref_freq: 300.00 electric_frequency: -2.25 hall_freq: 0.00 mechanical_freq: -0.45 gear_freq: -0.002251 changing_frequency initial 0
t: 6786.00 ref_freq: 300.00 electric_frequency: -2.14 hall_freq: 0.00 mechanical_freq: -0.43 gear_freq: -0.002143 changing_frequency initial 0
t: 6800.00 ref_freq: 300.00 electric_frequency: -1.94 hall_freq: 0.00 mechanical_freq: -0.39 gear_freq: -0.001939 changing_frequency initial 0
t: 6814.00 ref_freq: 300.00 electric_frequency: -1.71 hall_freq: 0.00 mechanical_freq: -0.34 gear_freq: -0.001712 changing_frequency initial 0
t: 6828.00 ref_freq: 300.00 electric_frequency: -1.52 hall_freq: 0.00 mechanical_freq: -0.30 gear_freq: -0.001522 changing_frequency initial 0
t: 6842.00 ref_freq: 300.00 electric_frequency: -1.37 hall_freq: 0.00 mechanical_freq: -0.27 gear_freq: -0.001367 changing_frequency initial 0
t: 6855.00 ref_freq: 300.00 electric_frequency: -1.23 hall_freq: 0.00 mechanical_freq: -0.25 gear_freq: -0.001226 changing_frequency initial 0
t: 6868.00 ref_freq: 300.00 electric_frequency: -0.96 hall_freq: 0.00 mechanical_freq: -0.19 gear_freq: -0.000960 changing_frequency initial 0
t: 6881.00 ref_freq: 300.00 electric_frequency: -0.84 hall_freq: 0.00 mechanical_freq: -0.17 gear_freq: -0.000835 changing_frequency initial 0
t: 6894.00 ref_freq: 300.00 electric_frequency: -0.62 hall_freq: 0.00 mechanical_freq: -0.12 gear_freq: -0.000624 changing_frequency initial 0
t: 6907.00 ref_freq: 300.00 electric_frequency: -0.44 hall_freq: 0.00 mechanical_freq: -0.09 gear_freq: -0.000437 changing_frequency initial 0
t: 6921.00 ref_freq: 300.00 electric_frequency: -0.28 hall_freq: 0.00 mechanical_freq: -0.06 gear_freq: -0.000276 changing_frequency initial 0
t: 6935.00 ref_freq: 300.00 electric_frequency: -0.07 hall_freq: 0.00 mechanical_freq: -0.01 gear_freq: -0.000073 changing_frequency initial 0
t: 6948.00 ref_freq: 300.00 electric_frequency: 0.10 hall_freq: 0.00 mechanical_freq: 0.02 gear_freq: 0.000097 changing_frequency initial 0
t: 6961.00 ref_freq: 300.00 electric_frequency: 0.22 hall_freq: 0.00 mechanical_freq: 0.04 gear_freq: 0.000216 changing_frequency initial 0
t: 6973.00 ref_freq: 300.00 electric_frequency: 0.39 hall_freq: 0.00 mechanical_freq: 0.08 gear_freq: 0.000393 changing_frequency initial 0
t: 6999.00 ref_freq: 300.00 electric_frequency: 0.67 hall_freq: 0.00 mechanical_freq: 0.13 gear_freq: 0.000671 changing_frequency initial 0
t: 7012.00 ref_freq: 300.00 electric_frequency: 0.78 hall_freq: 0.00 mechanical_freq: 0.16 gear_freq: 0.000778 changing_frequency initial 0
t: 7025.00 ref_freq: 300.00 electric_frequency: 0.89 hall_freq: 0.00 mechanical_freq: 0.18 gear_freq: 0.000894 changing_frequency initial 0
t: 7038.00 ref_freq: 300.00 electric_frequency: 1.02 hall_freq: 0.00 mechanical_freq: 0.20 gear_freq: 0.001023 changing_frequency initial 0
t: 7051.00 ref_freq: 300.00 electric_frequency: 1.06 hall_freq: 0.00 mechanical_freq: 0.21 gear_freq: 0.001063 changing_frequency initial 0
t: 7064.00 ref_freq: 300.00 electric_frequency: 1.22 hall_freq: 0.00 mechanical_freq: 0.24 gear_freq: 0.001220 changing_frequency initial 0
t: 7077.00 ref_freq: 300.00 electric_frequency: 1.30 hall_freq: 0.00 mechanical_freq: 0.26 gear_freq: 0.001297 changing_frequency initial 0
t: 7090.00 ref_freq: 300.00 electric_frequency: 1.35 hall_freq: 0.00 mechanical_freq: 0.27 gear_freq: 0.001346 changing_frequency initial 0
t: 7104.00 ref_freq: 300.00 electric_frequency: 1.49 hall_freq: 0.00 mechanical_freq: 0.30 gear_freq: 0.001492 changing_frequency initial 0
t: 7118.00 ref_freq: 300.00 electric_frequency: 1.54 hall_freq: 0.00 mechanical_freq: 0.31 gear_freq: 0.001545 changing_frequency initial 0
t: 7132.00 ref_freq: 300.00 electric_frequency: 1.57 hall_freq: 0.00 mechanical_freq: 0.31 gear_freq: 0.001572 changing_frequency initial 0
t: 7145.00 ref_freq: 300.00 electric_frequency: 1.67 hall_freq: 0.00 mechanical_freq: 0.33 gear_freq: 0.001675 changing_frequency initial 0
t: 7160.00 ref_freq: 300.00 electric_frequency: 1.78 hall_freq: 0.00 mechanical_freq: 0.36 gear_freq: 0.001776 changing_frequency initial 0
t: 7173.00 ref_freq: 300.00 electric_frequency: 1.80 hall_freq: 0.00 mechanical_freq: 0.36 gear_freq: 0.001797 changing_frequency initial 0
t: 7188.00 ref_freq: 300.00 electric_frequency: 1.77 hall_freq: 0.00 mechanical_freq: 0.35 gear_freq: 0.001769 changing_frequency initial 0
t: 7201.00 ref_freq: 300.00 electric_frequency: 1.87 hall_freq: 0.00 mechanical_freq: 0.37 gear_freq: 0.001874 changing_frequency initial 0
t: 7214.00 ref_freq: 300.00 electric_frequency: 1.88 hall_freq: 0.00 mechanical_freq: 0.38 gear_freq: 0.001881 changing_frequency initial 0
t: 7227.00 ref_freq: 300.00 electric_frequency: 1.94 hall_freq: 0.00 mechanical_freq: 0.39 gear_freq: 0.001936 changing_frequency initial 0
t: 7241.00 ref_freq: 300.00 electric_frequency: 1.99 hall_freq: 0.00 mechanical_freq: 0.40 gear_freq: 0.001991 changing_frequency initial 0
t: 7255.00 ref_freq: 300.00 electric_frequency: 1.96 hall_freq: 0.00 mechanical_freq: 0.39 gear_freq: 0.001964 changing_frequency initial 0
t: 7268.00 ref_freq: 300.00 electric_frequency: 1.96 hall_freq: 0.00 mechanical_freq: 0.39 gear_freq: 0.001958 changing_frequency initial 0
t: 7282.00 ref_freq: 300.00 electric_frequency: 1.99 hall_freq: 0.00 mechanical_freq: 0.40 gear_freq: 0.001994 changing_frequency initial 0
t: 7297.00 ref_freq: 300.00 electric_frequency: 1.95 hall_freq: 0.00 mechanical_freq: 0.39 gear_freq: 0.001948 changing_frequency initial 0
t: 7311.00 ref_freq: 300.00 electric_frequency: 1.94 hall_freq: 0.00 mechanical_freq: 0.39 gear_freq: 0.001939 changing_frequency initial 0
t: 7325.00 ref_freq: 300.00 electric_frequency: 1.91 hall_freq: 0.00 mechanical_freq: 0.38 gear_freq: 0.001907 changing_frequency initial 0
t: 7338.00 ref_freq: 300.00 electric_frequency: 1.88 hall_freq: 0.00 mechanical_freq: 0.38 gear_freq: 0.001884 changing_frequency initial 0
t: 7351.00 ref_freq: 300.00 electric_frequency: 1.89 hall_freq: 0.00 mechanical_freq: 0.38 gear_freq: 0.001894 changing_frequency initial 0
t: 7364.00 ref_freq: 300.00 electric_frequency: 1.83 hall_freq: 0.00 mechanical_freq: 0.37 gear_freq: 0.001834 changing_frequency initial 0
t: 7376.00 ref_freq: 300.00 electric_frequency: 1.80 hall_freq: 0.00 mechanical_freq: 0.36 gear_freq: 0.001800 changing_frequency initial 0
t: 7389.00 ref_freq: 300.00 electric_frequency: 1.78 hall_freq: 0.00 mechanical_freq: 0.36 gear_freq: 0.001780 changing_frequency initial 0
t: 7403.00 ref_freq: 300.00 electric_frequency: 1.70 hall_freq: 0.00 mechanical_freq: 0.34 gear_freq: 0.001701 changing_frequency initial 0
t: 7416.00 ref_freq: 300.00 electric_frequency: 1.66 hall_freq: 0.00 mechanical_freq: 0.33 gear_freq: 0.001658 changing_frequency initial 0
t: 7429.00 ref_freq: 300.00 electric_frequency: 1.52 hall_freq: 0.00 mechanical_freq: 0.30 gear_freq: 0.001523 changing_frequency initial 0
t: 7442.00 ref_freq: 300.00 electric_frequency: 1.56 hall_freq: 0.00 mechanical_freq: 0.31 gear_freq: 0.001557 changing_frequency initial 0
t: 7455.00 ref_freq: 300.00 electric_frequency: 1.44 hall_freq: 0.00 mechanical_freq: 0.29 gear_freq: 0.001443 changing_frequency initial 0
t: 7468.00 ref_freq: 300.00 electric_frequency: 1.37 hall_freq: 0.00 mechanical_freq: 0.27 gear_freq: 0.001366 changing_frequency initial 0
t: 7482.00 ref_freq: 300.00 electric_frequency: 1.32 hall_freq: 0.00 mechanical_freq: 0.26 gear_freq: 0.001318 changing_frequency initial 0
t: 7495.00 ref_freq: 300.00 electric_frequency: 1.18 hall_freq: 0.00 mechanical_freq: 0.24 gear_freq: 0.001178 changing_frequency initial 0
t: 7509.00 ref_freq: 300.00 electric_frequency: 1.07 hall_freq: 0.00 mechanical_freq: 0.21 gear_freq: 0.001073 changing_frequency initial 0
t: 7524.00 ref_freq: 300.00 electric_frequency: 1.01 hall_freq: 0.00 mechanical_freq: 0.20 gear_freq: 0.001007 changing_frequency initial 0
t: 7539.00 ref_freq: 300.00 electric_frequency: 0.82 hall_freq: 0.00 mechanical_freq: 0.16 gear_freq: 0.000817 changing_frequency initial 0
t: 7555.00 ref_freq: 300.00 electric_frequency: 0.70 hall_freq: 0.00 mechanical_freq: 0.14 gear_freq: 0.000700 changing_frequency initial 0
t: 7568.00 ref_freq: 300.00 electric_frequency: 0.52 hall_freq: 0.00 mechanical_freq: 0.10 gear_freq: 0.000522 changing_frequency initial 0
t: 7582.00 ref_freq: 300.00 electric_frequency: 0.36 hall_freq: 0.00 mechanical_freq: 0.07 gear_freq: 0.000356 changing_frequency initial 0
t: 7595.00 ref_freq: 300.00 electric_frequency: 0.20 hall_freq: 0.00 mechanical_freq: 0.04 gear_freq: 0.000203 changing_frequency initial 0
t: 7609.00 ref_freq: 300.00 electric_frequency: 0.06 hall_freq: 0.00 mechanical_freq: 0.01 gear_freq: 0.000056 changing_frequency initial 0
t: 7623.00 ref_freq: 300.00 electric_frequency: -0.19 hall_freq: 0.00 mechanical_freq: -0.04 gear_freq: -0.000191 changing_frequency initial 0
t: 7637.00 ref_freq: 300.00 electric_frequency: -0.32 hall_freq: 0.00 mechanical_freq: -0.06 gear_freq: -0.000324 changing_frequency initial 0
t: 7652.00 ref_freq: 300.00 electric_frequency: -0.57 hall_freq: 0.00 mechanical_freq: -0.11 gear_freq: -0.000568 changing_frequency initial 0
t: 7667.00 ref_freq: 300.00 electric_frequency: -0.71 hall_freq: 0.00 mechanical_freq: -0.14 gear_freq: -0.000713 changing_frequency initial 0
t: 7681.00 ref_freq: 300.00 electric_frequency: -0.93 hall_freq: 0.00 mechanical_freq: -0.19 gear_freq: -0.000927 changing_frequency initial 0
t: 7696.00 ref_freq: 300.00 electric_frequency: -1.11 hall_freq: 0.00 mechanical_freq: -0.22 gear_freq: -0.001108 changing_frequency initial 0
t: 7710.00 ref_freq: 300.00 electric_frequency: -1.30 hall_freq: 0.00 mechanical_freq: -0.26 gear_freq: -0.001302 changing_frequency initial 0
t: 7724.00 ref_freq: 300.00 electric_frequency: -1.60 hall_freq: 0.00 mechanical_freq: -0.32 gear_freq: -0.001599 changing_frequency initial 0
t: 7738.00 ref_freq: 300.00 electric_frequency: -1.73 hall_freq: 0.00 mechanical_freq: -0.35 gear_freq: -0.001725 changing_frequency initial 0
t: 7751.00 ref_freq: 300.00 electric_frequency: -1.90 hall_freq: 0.00 mechanical_freq: -0.38 gear_freq: -0.001896 changing_frequency initial 0
t: 7764.00 ref_freq: 300.00 electric_frequency: -2.08 hall_freq: 0.00 mechanical_freq: -0.42 gear_freq: -0.002076 changing_frequency initial 0
t: 7778.00 ref_freq: 300.00 electric_frequency: -2.18 hall_freq: 0.00 mechanical_freq: -0.44 gear_freq: -0.002183 changing_frequency initial 0
t: 7793.00 ref_freq: 300.00 electric_frequency: -2.40 hall_freq: 0.00 mechanical_freq: -0.48 gear_freq: -0.002400 changing_frequency initial 0
t: 7808.00 ref_freq: 300.00 electric_frequency: -2.54 hall_freq: 0.00 mechanical_freq: -0.51 gear_freq: -0.002542 changing_frequency initial 0
t: 7822.00 ref_freq: 300.00 electric_frequency: -2.64 hall_freq: 0.00 mechanical_freq: -0.53 gear_freq: -0.002643 changing_frequency initial 0
t: 7835.00 ref_freq: 300.00 electric_frequency: -2.74 hall_freq: 0.00 mechanical_freq: -0.55 gear_freq: -0.002741 changing_frequency initial 0
t: 7849.00 ref_freq: 300.00 electric_frequency: -2.82 hall_freq: 0.00 mechanical_freq: -0.56 gear_freq: -0.002820 changing_frequency initial 0
t: 7862.00 ref_freq: 300.00 electric_frequency: -2.85 hall_freq: 0.00 mechanical_freq: -0.57 gear_freq: -0.002850 changing_frequency initial 0
t: 7877.00 ref_freq: 300.00 electric_frequency: -2.91 hall_freq: 0.00 mechanical_freq: -0.58 gear_freq: -0.002907 changing_frequency initial 0
t: 7891.00 ref_freq: 300.00 electric_frequency: -2.81 hall_freq: 0.00 mechanical_freq: -0.56 gear_freq: -0.002815 changing_frequency initial 0
t: 7904.00 ref_freq: 300.00 electric_frequency: -2.84 hall_freq: 0.00 mechanical_freq: -0.57 gear_freq: -0.002837 changing_frequency initial 0
t: 7918.00 ref_freq: 300.00 electric_frequency: -2.71 hall_freq: 0.00 mechanical_freq: -0.54 gear_freq: -0.002708 changing_frequency initial 0
t: 7931.00 ref_freq: 300.00 electric_frequency: -2.68 hall_freq: 0.00 mechanical_freq: -0.54 gear_freq: -0.002678 changing_frequency initial 0
t: 7945.00 ref_freq: 300.00 electric_frequency: -2.54 hall_freq: 0.00 mechanical_freq: -0.51 gear_freq: -0.002544 changing_frequency initial 0
t: 7959.00 ref_freq: 300.00 electric_frequency: -2.40 hall_freq: 0.00 mechanical_freq: -0.48 gear_freq: -0.002401 changing_frequency initial 0
t: 7975.00 ref_freq: 300.00 electric_frequency: -2.21 hall_freq: 0.00 mechanical_freq: -0.44 gear_freq: -0.002209 changing_frequency initial 0
t: 7990.00 ref_freq: 300.00 electric_frequency: -2.10 hall_freq: 0.00 mechanical_freq: -0.42 gear_freq: -0.002097 changing_frequency initial 0
t: 8005.00 ref_freq: 300.00 electric_frequency: -1.90 hall_freq: 0.00 mechanical_freq: -0.38 gear_freq: -0.001899 changing_frequency initial 0
t: 8020.00 ref_freq: 300.00 electric_frequency: -1.63 hall_freq: 0.00 mechanical_freq: -0.33 gear_freq: -0.001633 changing_frequency initial 0
t: 8035.00 ref_freq: 300.00 electric_frequency: -1.42 hall_freq: 0.00 mechanical_freq: -0.28 gear_freq: -0.001422 changing_frequency initial 0
t: 8049.00 ref_freq: 300.00 electric_frequency: -1.27 hall_freq: 0.00 mechanical_freq: -0.25 gear_freq: -0.001270 changing_frequency initial 0
t: 8063.00 ref_freq: 300.00 electric_frequency: -1.03 hall_freq: 0.00 mechanical_freq: -0.21 gear_freq: -0.001035 changing_frequency initial 0
t: 8077.00 ref_freq: 300.00 electric_frequency: -0.85 hall_freq: 0.00 mechanical_freq: -0.17 gear_freq: -0.000853 changing_frequency initial 0
t: 8091.00 ref_freq: 300.00 electric_frequency: -0.66 hall_freq: 0.00 mechanical_freq: -0.13 gear_freq: -0.000661 changing_frequency initial 0
t: 8104.00 ref_freq: 300.00 electric_frequency: -0.49 hall_freq: 0.00 mechanical_freq: -0.10 gear_freq: -0.000490 changing_frequency initial 0
t: 8118.00 ref_freq: 300.00 electric_frequency: -0.27 hall_freq: 0.00 mechanical_freq: -0.05 gear_freq: -0.000270 changing_frequency initial 0
t: 8131.00 ref_freq: 300.00 electric_frequency: -0.11 hall_freq: 0.00 mechanical_freq: -0.02 gear_freq: -0.000106 changing_frequency initial 0
t: 8144.00 ref_freq: 300.00 electric_frequency: 0.05 hall_freq: 0.00 mechanical_freq: 0.01 gear_freq: 0.000053 changing_frequency initial 0
t: 8156.00 ref_freq: 300.00 electric_frequency: 0.19 hall_freq: 0.00 mechanical_freq: 0.04 gear_freq: 0.000191 changing_frequency initial 0
t: 8169.00 ref_freq: 300.00 electric_frequency: 0.35 hall_freq: 0.00 mechanical_freq: 0.07 gear_freq: 0.000353 changing_frequency initial 0
t: 8182.00 ref_freq: 300.00 electric_frequency: 0.48 hall_freq: 0.00 mechanical_freq: 0.10 gear_freq: 0.000481 changing_frequency initial 0
t: 8196.00 ref_freq: 300.00 electric_frequency: 0.59 hall_freq: 0.00 mechanical_freq: 0.12 gear_freq: 0.000587 changing_frequency initial 0
t: 8209.00 ref_freq: 300.00 electric_frequency: 0.71 hall_freq: 0.00 mechanical_freq: 0.14 gear_freq: 0.000710 changing_frequency initial 0
t: 8223.00 ref_freq: 300.00 electric_frequency: 0.87 hall_freq: 0.00 mechanical_freq: 0.17 gear_freq: 0.000874 changing_frequency initial 0
t: 8236.00 ref_freq: 300.00 electric_frequency: 0.99 hall_freq: 0.00 mechanical_freq: 0.20 gear_freq: 0.000989 changing_frequency initial 0
t: 8248.00 ref_freq: 300.00 electric_frequency: 1.08 hall_freq: 0.00 mechanical_freq: 0.22 gear_freq: 0.001080 changing_frequency initial 0
t: 8262.00 ref_freq: 300.00 electric_frequency: 1.23 hall_freq: 0.00 mechanical_freq: 0.25 gear_freq: 0.001230 changing_frequency initial 0
t: 8275.00 ref_freq: 300.00 electric_frequency: 1.29 hall_freq: 0.00 mechanical_freq: 0.26 gear_freq: 0.001289 changing_frequency initial 0
t: 8288.00 ref_freq: 300.00 electric_frequency: 1.38 hall_freq: 0.00 mechanical_freq: 0.28 gear_freq: 0.001376 changing_frequency initial 0
t: 8301.00 ref_freq: 300.00 electric_frequency: 1.46 hall_freq: 0.00 mechanical_freq: 0.29 gear_freq: 0.001459 changing_frequency initial 0
t: 8314.00 ref_freq: 300.00 electric_frequency: 1.52 hall_freq: 0.00 mechanical_freq: 0.30 gear_freq: 0.001519 changing_frequency initial 0
t: 8327.00 ref_freq: 300.00 electric_frequency: 1.60 hall_freq: 0.00 mechanical_freq: 0.32 gear_freq: 0.001603 changing_frequency initial 0
t: 8339.00 ref_freq: 300.00 electric_frequency: 1.66 hall_freq: 0.00 mechanical_freq: 0.33 gear_freq: 0.001659 changing_frequency initial 0
t: 8352.00 ref_freq: 300.00 electric_frequency: 1.72 hall_freq: 0.00 mechanical_freq: 0.34 gear_freq: 0.001725 changing_frequency initial 0
t: 8365.00 ref_freq: 300.00 electric_frequency: 1.78 hall_freq: 0.00 mechanical_freq: 0.36 gear_freq: 0.001782 changing_frequency initial 0
t: 8378.00 ref_freq: 300.00 electric_frequency: 1.80 hall_freq: 0.00 mechanical_freq: 0.36 gear_freq: 0.001797 changing_frequency initial 0
t: 8391.00 ref_freq: 300.00 electric_frequency: 1.82 hall_freq: 0.00 mechanical_freq: 0.36 gear_freq: 0.001825 changing_frequency initial 0
t: 8404.00 ref_freq: 300.00 electric_frequency: 1.86 hall_freq: 0.00 mechanical_freq: 0.37 gear_freq: 0.001859 changing_frequency initial 0
t: 8417.00 ref_freq: 300.00 electric_frequency: 1.90 hall_freq: 0.00 mechanical_freq: 0.38 gear_freq: 0.001898 changing_frequency initial 0
t: 8429.00 ref_freq: 300.00 electric_frequency: 1.92 hall_freq: 0.00 mechanical_freq: 0.38 gear_freq: 0.001916 changing_frequency initial 0
t: 8442.00 ref_freq: 300.00 electric_frequency: 1.96 hall_freq: 0.00 mechanical_freq: 0.39 gear_freq: 0.001957 changing_frequency initial 0
t: 8455.00 ref_freq: 300.00 electric_frequency: 1.96 hall_freq: 0.00 mechanical_freq: 0.39 gear_freq: 0.001957 changing_frequency initial 0
t: 8468.00 ref_freq: 300.00 electric_frequency: 1.99 hall_freq: 0.00 mechanical_freq: 0.40 gear_freq: 0.001986 changing_frequency initial 0
t: 8481.00 ref_freq: 300.00 electric_frequency: 1.99 hall_freq: 0.00 mechanical_freq: 0.40 gear_freq: 0.001994 changing_frequency initial 0
t: 8495.00 ref_freq: 300.00 electric_frequency: 1.99 hall_freq: 0.00 mechanical_freq: 0.40 gear_freq: 0.001987 changing_frequency initial 0
t: 8509.00 ref_freq: 300.00 electric_frequency: 1.93 hall_freq: 0.00 mechanical_freq: 0.39 gear_freq: 0.001930 changing_frequency initial 0
t: 8522.00 ref_freq: 300.00 electric_frequency: 1.98 hall_freq: 0.00 mechanical_freq: 0.40 gear_freq: 0.001979 changing_frequency initial 0
t: 8536.00 ref_freq: 300.00 electric_frequency: 1.86 hall_freq: 0.00 mechanical_freq: 0.37 gear_freq: 0.001856 changing_frequency initial 0
t: 8549.00 ref_freq: 300.00 electric_frequency: 1.87 hall_freq: 0.00 mechanical_freq: 0.37 gear_freq: 0.001866 changing_frequency initial 0
t: 8562.00 ref_freq: 300.00 electric_frequency: 1.83 hall_freq: 0.00 mechanical_freq: 0.37 gear_freq: 0.001833 changing_frequency initial 0
t: 8577.00 ref_freq: 300.00 electric_frequency: 1.84 hall_freq: 0.00 mechanical_freq: 0.37 gear_freq: 0.001842 changing_frequency initial 0
t: 8590.00 ref_freq: 300.00 electric_frequency: 1.74 hall_freq: 0.00 mechanical_freq: 0.35 gear_freq: 0.001743 changing_frequency initial 0
t: 8604.00 ref_freq: 300.00 electric_frequency: 1.70 hall_freq: 0.00 mechanical_freq: 0.34 gear_freq: 0.001698 changing_frequency initial 0
t: 8618.00 ref_freq: 300.00 electric_frequency: 1.57 hall_freq: 0.00 mechanical_freq: 0.31 gear_freq: 0.001572 changing_frequency initial 0
t: 8631.00 ref_freq: 300.00 electric_frequency: 1.51 hall_freq: 0.00 mechanical_freq: 0.30 gear_freq: 0.001514 changing_frequency initial 0
t: 8645.00 ref_freq: 300.00 electric_frequency: 1.52 hall_freq: 0.00 mechanical_freq: 0.30 gear_freq: 0.001517 changing_frequency initial 0
t: 8659.00 ref_freq: 300.00 electric_frequency: 1.44 hall_freq: 0.00 mechanical_freq: 0.29 gear_freq: 0.001438 changing_frequency initial 0
t: 8672.00 ref_freq: 300.00 electric_frequency: 1.39 hall_freq: 0.00 mechanical_freq: 0.28 gear_freq: 0.001392 changing_frequency initial 0
t: 8686.00 ref_freq: 300.00 electric_frequency: 1.24 hall_freq: 0.00 mechanical_freq: 0.25 gear_freq: 0.001241 changing_frequency initial 0
t: 8699.00 ref_freq: 300.00 electric_frequency: 1.15 hall_freq: 0.00 mechanical_freq: 0.23 gear_freq: 0.001153 changing_frequency initial 0
t: 8712.00 ref_freq: 300.00 electric_frequency: 0.99 hall_freq: 0.00 mechanical_freq: 0.20 gear_freq: 0.000994 changing_frequency initial 0
t: 8726.00 ref_freq: 300.00 electric_frequency: 0.90 hall_freq: 0.00 mechanical_freq: 0.18 gear_freq: 0.000905 changing_frequency initial 0
t: 8740.00 ref_freq: 300.00 electric_frequency: 0.79 hall_freq: 0.00 mechanical_freq: 0.16 gear_freq: 0.000787 changing_frequency initial 0
t: 8754.00 ref_freq: 300.00 electric_frequency: 0.66 hall_freq: 0.00 mechanical_freq: 0.13 gear_freq: 0.000664 changing_frequency initial 0
t: 8767.00 ref_freq: 300.00 electric_frequency: 0.45 hall_freq: 0.00 mechanical_freq: 0.09 gear_freq: 0.000454 changing_frequency initial 0
t: 8780.00 ref_freq: 300.00 electric_frequency: 0.33 hall_freq: 0.00 mechanical_freq: 0.07 gear_freq: 0.000327 changing_frequency initial 0
t: 8795.00 ref_freq: 300.00 electric_frequency: 0.22 hall_freq: 0.00 mechanical_freq: 0.04 gear_freq: 0.000220 changing_frequency initial 0
t: 8809.00 ref_freq: 300.00 electric_frequency: 0.07 hall_freq: 0.00 mechanical_freq: 0.01 gear_freq: 0.000066 changing_frequency initial 0
t: 8823.00 ref_freq: 300.00 electric_frequency: -0.13 hall_freq: 0.00 mechanical_freq: -0.03 gear_freq: -0.000125 changing_frequency initial 0
t: 8901.00 ref_freq: 300.00 electric_frequency: -1.20 hall_freq: 0.00 mechanical_freq: -0.24 gear_freq: -0.001201 changing_frequency initial 0
t: 8915.00 ref_freq: 300.00 electric_frequency: -1.41 hall_freq: 0.00 mechanical_freq: -0.28 gear_freq: -0.001410 changing_frequency initial 0
t: 8930.00 ref_freq: 300.00 electric_frequency: -1.61 hall_freq: 0.00 mechanical_freq: -0.32 gear_freq: -0.001607 changing_frequency initial 0
t: 8945.00 ref_freq: 300.00 electric_frequency: -1.87 hall_freq: 0.00 mechanical_freq: -0.37 gear_freq: -0.001870 changing_frequency initial 0
t: 8959.00 ref_freq: 300.00 electric_frequency: -2.00 hall_freq: 0.00 mechanical_freq: -0.40 gear_freq: -0.002000 changing_frequency initial 0
t: 8973.00 ref_freq: 300.00 electric_frequency: -2.17 hall_freq: 0.00 mechanical_freq: -0.43 gear_freq: -0.002173 changing_frequency initial 0
t: 8987.00 ref_freq: 300.00 electric_frequency: -2.36 hall_freq: 0.00 mechanical_freq: -0.47 gear_freq: -0.002364 changing_frequency initial 0
t: 9001.00 ref_freq: 300.00 electric_frequency: -2.49 hall_freq: 0.00 mechanical_freq: -0.50 gear_freq: -0.002490 changing_frequency initial 0
t: 9016.00 ref_freq: 300.00 electric_frequency: -2.64 hall_freq: 0.00 mechanical_freq: -0.53 gear_freq: -0.002638 changing_frequency initial 0
t: 9029.00 ref_freq: 300.00 electric_frequency: -2.71 hall_freq: 0.00 mechanical_freq: -0.54 gear_freq: -0.002709 changing_frequency initial 0
t: 9043.00 ref_freq: 300.00 electric_frequency: -2.82 hall_freq: 0.00 mechanical_freq: -0.56 gear_freq: -0.002823 changing_frequency initial 0
t: 9057.00 ref_freq: 300.00 electric_frequency: -2.80 hall_freq: 0.00 mechanical_freq: -0.56 gear_freq: -0.002804 changing_frequency initial 0
t: 9072.00 ref_freq: 300.00 electric_frequency: -2.87 hall_freq: 0.00 mechanical_freq: -0.57 gear_freq: -0.002872 changing_frequency initial 0
t: 9087.00 ref_freq: 300.00 electric_frequency: -2.89 hall_freq: 0.00 mechanical_freq: -0.58 gear_freq: -0.002887 changing_frequency initial 0
t: 9101.00 ref_freq: 300.00 electric_frequency: -2.80 hall_freq: 0.00 mechanical_freq: -0.56 gear_freq: -0.002797 changing_frequency initial 0
t: 9115.00 ref_freq: 300.00 electric_frequency: -2.76 hall_freq: 0.00 mechanical_freq: -0.55 gear_freq: -0.002758 changing_frequency initial 0
t: 9129.00 ref_freq: 300.00 electric_frequency: -2.66 hall_freq: 0.00 mechanical_freq: -0.53 gear_freq: -0.002660 changing_frequency initial 0
t: 9144.00 ref_freq: 300.00 electric_frequency: -2.62 hall_freq: 0.00 mechanical_freq: -0.52 gear_freq: -0.002622 changing_frequency initial 0
t: 9158.00 ref_freq: 300.00 electric_frequency: -2.44 hall_freq: 0.00 mechanical_freq: -0.49 gear_freq: -0.002436 changing_frequency initial 0
t: 9172.00 ref_freq: 300.00 electric_frequency: -2.20 hall_freq: 0.00 mechanical_freq: -0.44 gear_freq: -0.002201 changing_frequency initial 0
t: 9186.00 ref_freq: 300.00 electric_frequency: -2.12 hall_freq: 0.00 mechanical_freq: -0.42 gear_freq: -0.002117 changing_frequency initial 0
t: 9200.00 ref_freq: 300.00 electric_frequency: -2.01 hall_freq: 0.00 mechanical_freq: -0.40 gear_freq: -0.002008 changing_frequency initial 0
t: 9214.00 ref_freq: 300.00 electric_frequency: -1.75 hall_freq: 0.00 mechanical_freq: -0.35 gear_freq: -0.001748 changing_frequency initial 0
t: 9228.00 ref_freq: 300.00 electric_frequency: -1.55 hall_freq: 0.00 mechanical_freq: -0.31 gear_freq: -0.001548 changing_frequency initial 0
t: 9242.00 ref_freq: 300.00 electric_frequency: -1.37 hall_freq: 0.00 mechanical_freq: -0.27 gear_freq: -0.001366 changing_frequency initial 0
t: 9256.00 ref_freq: 300.00 electric_frequency: -1.18 hall_freq: 0.00 mechanical_freq: -0.24 gear_freq: -0.001183 changing_frequency initial 0
t: 9268.00 ref_freq: 300.00 electric_frequency: -0.97 hall_freq: 0.00 mechanical_freq: -0.19 gear_freq: -0.000969 changing_frequency initial 0
t: 9281.00 ref_freq: 300.00 electric_frequency: -0.78 hall_freq: 0.00 mechanical_freq: -0.16 gear_freq: -0.000785 changing_frequency initial 0
t: 9294.00 ref_freq: 300.00 electric_frequency: -0.63 hall_freq: 0.00 mechanical_freq: -0.13 gear_freq: -0.000628 changing_frequency initial 0
t: 9307.00 ref_freq: 300.00 electric_frequency: -0.47 hall_freq: 0.00 mechanical_freq: -0.09 gear_freq: -0.000469 changing_frequency initial 0
t: 9320.00 ref_freq: 300.00 electric_frequency: -0.24 hall_freq: 0.00 mechanical_freq: -0.05 gear_freq: -0.000240 changing_frequency initial 0
t: 9333.00 ref_freq: 300.00 electric_frequency: -0.08 hall_freq: 0.00 mechanical_freq: -0.02 gear_freq: -0.000084 changing_frequency initial 0
t: 9346.00 ref_freq: 300.00 electric_frequency: 0.07 hall_freq: 0.00 mechanical_freq: 0.01 gear_freq: 0.000070 changing_frequency initial 0
t: 9358.00 ref_freq: 300.00 electric_frequency: 0.19 hall_freq: 0.00 mechanical_freq: 0.04 gear_freq: 0.000190 changing_frequency initial 0
t: 9371.00 ref_freq: 300.00 electric_frequency: 0.36 hall_freq: 0.00 mechanical_freq: 0.07 gear_freq: 0.000365 changing_frequency initial 0
t: 9384.00 ref_freq: 300.00 electric_frequency: 0.48 hall_freq: 0.00 mechanical_freq: 0.10 gear_freq: 0.000477 changing_frequency initial 0
t: 9398.00 ref_freq: 300.00 electric_frequency: 0.66 hall_freq: 0.00 mechanical_freq: 0.13 gear_freq: 0.000657 changing_frequency initial 0
t: 9411.00 ref_freq: 300.00 electric_frequency: 0.76 hall_freq: 0.00 mechanical_freq: 0.15 gear_freq: 0.000758 changing_frequency initial 0
t: 9425.00 ref_freq: 300.00 electric_frequency: 0.91 hall_freq: 0.00 mechanical_freq: 0.18 gear_freq: 0.000910 changing_frequency initial 0
t: 9439.00 ref_freq: 300.00 electric_frequency: 0.97 hall_freq: 0.00 mechanical_freq: 0.19 gear_freq: 0.000970 changing_frequency initial 0
t: 9452.00 ref_freq: 300.00 electric_frequency: 1.11 hall_freq: 0.00 mechanical_freq: 0.22 gear_freq: 0.001111 changing_frequency initial 0
t: 9467.00 ref_freq: 300.00 electric_frequency: 1.25 hall_freq: 0.00 mechanical_freq: 0.25 gear_freq: 0.001250 changing_frequency initial 0
t: 9481.00 ref_freq: 300.00 electric_frequency: 1.34 hall_freq: 0.00 mechanical_freq: 0.27 gear_freq: 0.001338 changing_frequency initial 0
t: 9493.00 ref_freq: 300.00 electric_frequency: 1.41 hall_freq: 0.00 mechanical_freq: 0.28 gear_freq: 0.001406 changing_frequency initial 0
t: 9507.00 ref_freq: 300.00 electric_frequency: 1.51 hall_freq: 0.00 mechanical_freq: 0.30 gear_freq: 0.001511 changing_frequency initial 0
t: 9521.00 ref_freq: 300.00 electric_frequency: 1.59 hall_freq: 0.00 mechanical_freq: 0.32 gear_freq: 0.001593 changing_frequency initial 0
t: 9535.00 ref_freq: 300.00 electric_frequency: 1.64 hall_freq: 0.00 mechanical_freq: 0.33 gear_freq: 0.001641 changing_frequency initial 0
t: 9549.00 ref_freq: 300.00 electric_frequency: 1.65 hall_freq: 0.00 mechanical_freq: 0.33 gear_freq: 0.001647 changing_frequency initial 0
t: 9562.00 ref_freq: 300.00 electric_frequency: 1.74 hall_freq: 0.00 mechanical_freq: 0.35 gear_freq: 0.001740 changing_frequency initial 0
t: 9577.00 ref_freq: 300.00 electric_frequency: 1.82 hall_freq: 0.00 mechanical_freq: 0.36 gear_freq: 0.001824 changing_frequency initial 0
t: 9591.00 ref_freq: 300.00 electric_frequency: 1.85 hall_freq: 0.00 mechanical_freq: 0.37 gear_freq: 0.001852 changing_frequency initial 0
t: 9605.00 ref_freq: 300.00 electric_frequency: 1.91 hall_freq: 0.00 mechanical_freq: 0.38 gear_freq: 0.001911 changing_frequency initial 0
t: 9619.00 ref_freq: 300.00 electric_frequency: 1.89 hall_freq: 0.00 mechanical_freq: 0.38 gear_freq: 0.001890 changing_frequency initial 0
t: 9632.00 ref_freq: 300.00 electric_frequency: 1.95 hall_freq: 0.00 mechanical_freq: 0.39 gear_freq: 0.001949 changing_frequency initial 0
t: 9646.00 ref_freq: 300.00 electric_frequency: 1.95 hall_freq: 0.00 mechanical_freq: 0.39 gear_freq: 0.001953 changing_frequency initial 0
t: 9658.00 ref_freq: 300.00 electric_frequency: 1.97 hall_freq: 0.00 mechanical_freq: 0.39 gear_freq: 0.001968 changing_frequency initial 0
t: 9672.00 ref_freq: 300.00 electric_frequency: 1.98 hall_freq: 0.00 mechanical_freq: 0.40 gear_freq: 0.001978 changing_frequency initial 0
t: 9686.00 ref_freq: 300.00 electric_frequency: 1.97 hall_freq: 0.00 mechanical_freq: 0.39 gear_freq: 0.001969 changing_frequency initial 0
t: 9700.00 ref_freq: 300.00 electric_frequency: 1.94 hall_freq: 0.00 mechanical_freq: 0.39 gear_freq: 0.001939 changing_frequency initial 0
t: 9713.00 ref_freq: 300.00 electric_frequency: 1.88 hall_freq: 0.00 mechanical_freq: 0.38 gear_freq: 0.001881 changing_frequency initial 0
t: 9727.00 ref_freq: 300.00 electric_frequency: 1.92 hall_freq: 0.00 mechanical_freq: 0.38 gear_freq: 0.001918 changing_frequency initial 0
t: 9740.00 ref_freq: 300.00 electric_frequency: 1.90 hall_freq: 0.00 mechanical_freq: 0.38 gear_freq: 0.001903 changing_frequency initial 0
t: 9754.00 ref_freq: 300.00 electric_frequency: 1.86 hall_freq: 0.00 mechanical_freq: 0.37 gear_freq: 0.001856 changing_frequency initial 0
t: 9768.00 ref_freq: 300.00 electric_frequency: 1.80 hall_freq: 0.00 mechanical_freq: 0.36 gear_freq: 0.001802 changing_frequency initial 0
t: 9782.00 ref_freq: 300.00 electric_frequency: 1.81 hall_freq: 0.00 mechanical_freq: 0.36 gear_freq: 0.001806 changing_frequency initial 0
t: 9796.00 ref_freq: 300.00 electric_frequency: 1.73 hall_freq: 0.00 mechanical_freq: 0.35 gear_freq: 0.001727 changing_frequency initial 0
t: 9811.00 ref_freq: 300.00 electric_frequency: 1.67 hall_freq: 0.00 mechanical_freq: 0.33 gear_freq: 0.001671 changing_frequency initial 0
t: 9826.00 ref_freq: 300.00 electric_frequency: 1.60 hall_freq: 0.00 mechanical_freq: 0.32 gear_freq: 0.001605 changing_frequency initial 0
t: 9839.00 ref_freq: 300.00 electric_frequency: 1.52 hall_freq: 0.00 mechanical_freq: 0.30 gear_freq: 0.001521 changing_frequency initial 0
t: 9853.00 ref_freq: 300.00 electric_frequency: 1.40 hall_freq: 0.00 mechanical_freq: 0.28 gear_freq: 0.001398 changing_frequency initial 0
t: 9867.00 ref_freq: 300.00 electric_frequency: 1.35 hall_freq: 0.00 mechanical_freq: 0.27 gear_freq: 0.001354 changing_frequency initial 0
t: 9882.00 ref_freq: 300.00 electric_frequency: 1.33 hall_freq: 0.00 mechanical_freq: 0.27 gear_freq: 0.001327 changing_frequency initial 0
t: 9896.00 ref_freq: 300.00 electric_frequency: 1.17 hall_freq: 0.00 mechanical_freq: 0.23 gear_freq: 0.001171 changing_frequency initial 0
t: 9912.00 ref_freq: 300.00 electric_frequency: 1.04 hall_freq: 0.00 mechanical_freq: 0.21 gear_freq: 0.001036 changing_frequency initial 0
t: 9941.00 ref_freq: 300.00 electric_frequency: 0.77 hall_freq: 0.00 mechanical_freq: 0.15 gear_freq: 0.000773 changing_frequency initial 0
t: 9956.00 ref_freq: 300.00 electric_frequency: 0.57 hall_freq: 0.00 mechanical_freq: 0.11 gear_freq: 0.000570 changing_frequency initial 0
t: 9971.00 ref_freq: 300.00 electric_frequency: 0.48 hall_freq: 0.00 mechanical_freq: 0.10 gear_freq: 0.000475 changing_frequency initial 0
t: 9986.00 ref_freq: 300.00 electric_frequency: 0.34 hall_freq: 0.00 mechanical_freq: 0.07 gear_freq: 0.000344 changing_frequency initial 0
t: 10000.00 ref_freq: 300.00 electric_frequency: 0.15 hall_freq: 0.00 mechanical_freq: 0.03 gear_freq: 0.000151 changing_frequency initial 0
t: 10014.00 ref_freq: 300.00 electric_frequency: -0.08 hall_freq: 0.00 mechanical_freq: -0.02 gear_freq: -0.000079 changing_frequency initial 0
t: 10029.00 ref_freq: 300.00 electric_frequency: -0.21 hall_freq: 0.00 mechanical_freq: -0.04 gear_freq: -0.000212 changing_frequency initial 0
t: 10043.00 ref_freq: 300.00 electric_frequency: -0.40 hall_freq: 0.00 mechanical_freq: -0.08 gear_freq: -0.000401 changing_frequency initial 0
t: 10057.00 ref_freq: 300.00 electric_frequency: -0.58 hall_freq: 0.00 mechanical_freq: -0.12 gear_freq: -0.000577 changing_frequency initial 0
t: 10071.00 ref_freq: 300.00 electric_frequency: -0.78 hall_freq: 0.00 mechanical_freq: -0.16 gear_freq: -0.000780 changing_frequency initial 0
t: 10085.00 ref_freq: 300.00 electric_frequency: -0.98 hall_freq: 0.00 mechanical_freq: -0.20 gear_freq: -0.000982 changing_frequency initial 0
t: 10099.00 ref_freq: 300.00 electric_frequency: -1.18 hall_freq: 0.00 mechanical_freq: -0.24 gear_freq: -0.001175 changing_frequency initial 0
t: 10113.00 ref_freq: 300.00 electric_frequency: -1.37 hall_freq: 0.00 mechanical_freq: -0.27 gear_freq: -0.001372 changing_frequency initial 0
t: 10127.00 ref_freq: 300.00 electric_frequency: -1.58 hall_freq: 0.00 mechanical_freq: -0.32 gear_freq: -0.001575 changing_frequency initial 0
t: 10141.00 ref_freq: 300.00 electric_frequency: -1.79 hall_freq: 0.00 mechanical_freq: -0.36 gear_freq: -0.001793 changing_frequency initial 0
t: 10154.00 ref_freq: 300.00 electric_frequency: -1.94 hall_freq: 0.00 mechanical_freq: -0.39 gear_freq: -0.001939 changing_frequency initial 0
t: 10167.00 ref_freq: 300.00 electric_frequency: -2.10 hall_freq: 0.00 mechanical_freq: -0.42 gear_freq: -0.002104 changing_frequency initial 0
t: 10181.00 ref_freq: 300.00 electric_frequency: -2.30 hall_freq: 0.00 mechanical_freq: -0.46 gear_freq: -0.002297 changing_frequency initial 0
t: 10195.00 ref_freq: 300.00 electric_frequency: -2.44 hall_freq: 0.00 mechanical_freq: -0.49 gear_freq: -0.002437 changing_frequency initial 0
t: 10208.00 ref_freq: 300.00 electric_frequency: -2.59 hall_freq: 0.00 mechanical_freq: -0.52 gear_freq: -0.002594 changing_frequency initial 0
t: 10222.00 ref_freq: 300.00 electric_frequency: -2.67 hall_freq: 0.00 mechanical_freq: -0.53 gear_freq: -0.002669 changing_frequency initial 0
t: 10236.00 ref_freq: 300.00 electric_frequency: -2.75 hall_freq: 0.00 mechanical_freq: -0.55 gear_freq: -0.002755 changing_frequency initial 0
t: 10250.00 ref_freq: 300.00 electric_frequency: -2.87 hall_freq: 0.00 mechanical_freq: -0.57 gear_freq: -0.002868 changing_frequency initial 0
t: 10264.00 ref_freq: 300.00 electric_frequency: -2.81 hall_freq: 0.00 mechanical_freq: -0.56 gear_freq: -0.002814 changing_frequency initial 0
t: 10278.00 ref_freq: 300.00 electric_frequency: -2.87 hall_freq: 0.00 mechanical_freq: -0.57 gear_freq: -0.002872 changing_frequency initial 0
t: 10292.00 ref_freq: 300.00 electric_frequency: -2.82 hall_freq: 0.00 mechanical_freq: -0.56 gear_freq: -0.002819 changing_frequency initial 0
t: 10307.00 ref_freq: 300.00 electric_frequency: -2.76 hall_freq: 0.00 mechanical_freq: -0.55 gear_freq: -0.002759 changing_frequency initial 0
t: 10323.00 ref_freq: 300.00 electric_frequency: -2.71 hall_freq: 0.00 mechanical_freq: -0.54 gear_freq: -0.002706 changing_frequency initial 0
t: 10337.00 ref_freq: 300.00 electric_frequency: -2.64 hall_freq: 0.00 mechanical_freq: -0.53 gear_freq: -0.002635 changing_frequency initial 0
t: 10351.00 ref_freq: 300.00 electric_frequency: -2.44 hall_freq: 0.00 mechanical_freq: -0.49 gear_freq: -0.002439 changing_frequency initial 0
t: 10366.00 ref_freq: 300.00 electric_frequency: -2.34 hall_freq: 0.00 mechanical_freq: -0.47 gear_freq: -0.002339 changing_frequency initial 0
t: 10379.00 ref_freq: 300.00 electric_frequency: -2.18 hall_freq: 0.00 mechanical_freq: -0.44 gear_freq: -0.002185 changing_frequency initial 0
t: 10393.00 ref_freq: 300.00 electric_frequency: -2.00 hall_freq: 0.00 mechanical_freq: -0.40 gear_freq: -0.002001 changing_frequency initial 0
t: 10407.00 ref_freq: 300.00 electric_frequency: -1.87 hall_freq: 0.00 mechanical_freq: -0.37 gear_freq: -0.001867 changing_frequency initial 0
t: 10421.00 ref_freq: 300.00 electric_frequency: -1.68 hall_freq: 0.00 mechanical_freq: -0.34 gear_freq: -0.001682 changing_frequency initial 0
t: 10435.00 ref_freq: 300.00 electric_frequency: -1.49 hall_freq: 0.00 mechanical_freq: -0.30 gear_freq: -0.001489 changing_frequency initial 0
t: 10449.00 ref_freq: 300.00 electric_frequency: -1.28 hall_freq: 0.00 mechanical_freq: -0.26 gear_freq: -0.001283 changing_frequency initial 0
t: 10462.00 ref_freq: 300.00 electric_frequency: -1.10 hall_freq: 0.00 mechanical_freq: -0.22 gear_freq: -0.001096 changing_frequency initial 0
t: 10476.00 ref_freq: 300.00 electric_frequency: -0.85 hall_freq: 0.00 mechanical_freq: -0.17 gear_freq: -0.000845 changing_frequency initial 0
t: 10489.00 ref_freq: 300.00 electric_frequency: -0.73 hall_freq: 0.00 mechanical_freq: -0.15 gear_freq: -0.000726 changing_frequency initial 0
t: 10503.00 ref_freq: 300.00 electric_frequency: -0.48 hall_freq: 0.00 mechanical_freq: -0.10 gear_freq: -0.000480 changing_frequency initial 0
t: 10516.00 ref_freq: 300.00 electric_frequency: -0.28 hall_freq: 0.00 mechanical_freq: -0.06 gear_freq: -0.000278 changing_frequency initial 0
t: 10529.00 ref_freq: 300.00 electric_frequency: -0.13 hall_freq: 0.00 mechanical_freq: -0.03 gear_freq: -0.000132 changing_frequency initial 0
t: 10542.00 ref_freq: 300.00 electric_frequency: 0.02 hall_freq: 0.00 mechanical_freq: 0.00 gear_freq: 0.000018 changing_frequency initial 0
t: 10556.00 ref_freq: 300.00 electric_frequency: 0.19 hall_freq: 0.00 mechanical_freq: 0.04 gear_freq: 0.000194 changing_frequency initial 0
t: 10569.00 ref_freq: 300.00 electric_frequency: 0.35 hall_freq: 0.00 mechanical_freq: 0.07 gear_freq: 0.000355 changing_frequency initial 0
t: 10582.00 ref_freq: 300.00 electric_frequency: 0.43 hall_freq: 0.00 mechanical_freq: 0.09 gear_freq: 0.000433 changing_frequency initial 0
t: 10595.00 ref_freq: 300.00 electric_frequency: 0.61 hall_freq: 0.00 mechanical_freq: 0.12 gear_freq: 0.000611 changing_frequency initial 0
t: 10608.00 ref_freq: 300.00 electric_frequency: 0.74 hall_freq: 0.00 mechanical_freq: 0.15 gear_freq: 0.000745 changing_frequency initial 0
t: 10634.00 ref_freq: 300.00 electric_frequency: 0.99 hall_freq: 0.00 mechanical_freq: 0.20 gear_freq: 0.000995 changing_frequency initial 0
t: 10647.00 ref_freq: 300.00 electric_frequency: 1.11 hall_freq: 0.00 mechanical_freq: 0.22 gear_freq: 0.001107 changing_frequency initial 0
t: 10660.00 ref_freq: 300.00 electric_frequency: 1.21 hall_freq: 0.00 mechanical_freq: 0.24 gear_freq: 0.001211 changing_frequency initial 0
t: 10674.00 ref_freq: 300.00 electric_frequency: 1.30 hall_freq: 0.00 mechanical_freq: 0.26 gear_freq: 0.001295 changing_frequency initial 0
t: 10687.00 ref_freq: 300.00 electric_frequency: 1.39 hall_freq: 0.00 mechanical_freq: 0.28 gear_freq: 0.001393 changing_frequency initial 0
t: 10700.00 ref_freq: 300.00 electric_frequency: 1.47 hall_freq: 0.00 mechanical_freq: 0.29 gear_freq: 0.001468 changing_frequency initial 0
t: 10713.00 ref_freq: 300.00 electric_frequency: 1.53 hall_freq: 0.00 mechanical_freq: 0.31 gear_freq: 0.001526 changing_frequency initial 0
t: 10727.00 ref_freq: 300.00 electric_frequency: 1.62 hall_freq: 0.00 mechanical_freq: 0.32 gear_freq: 0.001624 changing_frequency initial 0
t: 10739.00 ref_freq: 300.00 electric_frequency: 1.68 hall_freq: 0.00 mechanical_freq: 0.34 gear_freq: 0.001676 changing_frequency initial 0
t: 10752.00 ref_freq: 300.00 electric_frequency: 1.71 hall_freq: 0.00 mechanical_freq: 0.34 gear_freq: 0.001712 changing_frequency initial 0
t: 10766.00 ref_freq: 300.00 electric_frequency: 1.80 hall_freq: 0.00 mechanical_freq: 0.36 gear_freq: 0.001796 changing_frequency initial 0
t: 10780.00 ref_freq: 300.00 electric_frequency: 1.80 hall_freq: 0.00 mechanical_freq: 0.36 gear_freq: 0.001797 changing_frequency initial 0
t: 10794.00 ref_freq: 300.00 electric_frequency: 1.87 hall_freq: 0.00 mechanical_freq: 0.37 gear_freq: 0.001867 changing_frequency initial 0
t: 10808.00 ref_freq: 300.00 electric_frequency: 1.88 hall_freq: 0.00 mechanical_freq: 0.38 gear_freq: 0.001880 changing_frequency initial 0
t: 10822.00 ref_freq: 300.00 electric_frequency: 1.94 hall_freq: 0.00 mechanical_freq: 0.39 gear_freq: 0.001940 changing_frequency initial 0
t: 10836.00 ref_freq: 300.00 electric_frequency: 1.94 hall_freq: 0.00 mechanical_freq: 0.39 gear_freq: 0.001939 changing_frequency initial 0
t: 10850.00 ref_freq: 300.00 electric_frequency: 1.96 hall_freq: 0.00 mechanical_freq: 0.39 gear_freq: 0.001959 changing_frequency initial 0
t: 10864.00 ref_freq: 300.00 electric_frequency: 1.99 hall_freq: 0.00 mechanical_freq: 0.40 gear_freq: 0.001989 changing_frequency initial 0
t: 10878.00 ref_freq: 300.00 electric_frequency: 1.94 hall_freq: 0.00 mechanical_freq: 0.39 gear_freq: 0.001940 changing_frequency initial 0
t: 10892.00 ref_freq: 300.00 electric_frequency: 1.89 hall_freq: 0.00 mechanical_freq: 0.38 gear_freq: 0.001891 changing_frequency initial 0
t: 10905.00 ref_freq: 300.00 electric_frequency: 1.95 hall_freq: 0.00 mechanical_freq: 0.39 gear_freq: 0.001949 changing_frequency initial 0
t: 10918.00 ref_freq: 300.00 electric_frequency: 1.95 hall_freq: 0.00 mechanical_freq: 0.39 gear_freq: 0.001953 changing_frequency initial 0
t: 10931.00 ref_freq: 300.00 electric_frequency: 1.94 hall_freq: 0.00 mechanical_freq: 0.39 gear_freq: 0.001937 changing_frequency initial 0
t: 10944.00 ref_freq: 300.00 electric_frequency: 1.88 hall_freq: 0.00 mechanical_freq: 0.38 gear_freq: 0.001883 changing_frequency initial 0
t: 10958.00 ref_freq: 300.00 electric_frequency: 1.86 hall_freq: 0.00 mechanical_freq: 0.37 gear_freq: 0.001860 changing_frequency initial 0
t: 10972.00 ref_freq: 300.00 electric_frequency: 1.88 hall_freq: 0.00 mechanical_freq: 0.38 gear_freq: 0.001884 changing_frequency initial 0
t: 10985.00 ref_freq: 300.00 electric_frequency: 1.79 hall_freq: 0.00 mechanical_freq: 0.36 gear_freq: 0.001792 changing_frequency initial 0
t: 10998.00 ref_freq: 300.00 electric_frequency: 1.73 hall_freq: 0.00 mechanical_freq: 0.35 gear_freq: 0.001733 changing_frequency initial 0
t: 11013.00 ref_freq: 300.00 electric_frequency: 1.68 hall_freq: 0.00 mechanical_freq: 0.34 gear_freq: 0.001681 changing_frequency initial 0
t: 11027.00 ref_freq: 300.00 electric_frequency: 1.59 hall_freq: 0.00 mechanical_freq: 0.32 gear_freq: 0.001590 changing_frequency initial 0
t: 11040.00 ref_freq: 300.00 electric_frequency: 1.53 hall_freq: 0.00 mechanical_freq: 0.31 gear_freq: 0.001529 changing_frequency initial 0
t: 11053.00 ref_freq: 300.00 electric_frequency: 1.39 hall_freq: 0.00 mechanical_freq: 0.28 gear_freq: 0.001393 changing_frequency initial 0
t: 11066.00 ref_freq: 300.00 electric_frequency: 1.37 hall_freq: 0.00 mechanical_freq: 0.27 gear_freq: 0.001373 changing_frequency initial 0
t: 11080.00 ref_freq: 300.00 electric_frequency: 1.27 hall_freq: 0.00 mechanical_freq: 0.25 gear_freq: 0.001270 changing_frequency initial 0
t: 11095.00 ref_freq: 300.00 electric_frequency: 1.19 hall_freq: 0.00 mechanical_freq: 0.24 gear_freq: 0.001192 changing_frequency initial 0
t: 11108.00 ref_freq: 300.00 electric_frequency: 1.13 hall_freq: 0.00 mechanical_freq: 0.23 gear_freq: 0.001133 changing_frequency initial 0
t: 11123.00 ref_freq: 300.00 electric_frequency: 0.98 hall_freq: 0.00 mechanical_freq: 0.20 gear_freq: 0.000977 changing_frequency initial 0
t: 11138.00 ref_freq: 300.00 electric_frequency: 0.81 hall_freq: 0.00 mechanical_freq: 0.16 gear_freq: 0.000806 changing_frequency initial 0
t: 11152.00 ref_freq: 300.00 electric_frequency: 0.66 hall_freq: 0.00 mechanical_freq: 0.13 gear_freq: 0.000658 changing_frequency initial 0
t: 11166.00 ref_freq: 300.00 electric_frequency: 0.55 hall_freq: 0.00 mechanical_freq: 0.11 gear_freq: 0.000549 changing_frequency initial 0
t: 11181.00 ref_freq: 300.00 electric_frequency: 0.37 hall_freq: 0.00 mechanical_freq: 0.07 gear_freq: 0.000373 changing_frequency initial 0
t: 11195.00 ref_freq: 300.00 electric_frequency: 0.15 hall_freq: 0.00 mechanical_freq: 0.03 gear_freq: 0.000153 changing_frequency initial 0
t: 11209.00 ref_freq: 300.00 electric_frequency: 0.06 hall_freq: 0.00 mechanical_freq: 0.01 gear_freq: 0.000061 changing_frequency initial 0
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
