arcoslab/open-coroco-legacy/src_DTC-SVM_Fixed_Testing/ADC_Measurements_Results/images/[Fri Apr 17 19:14:44 2015] [one 300 0, hall frequency controller, P =0.001]/[Fri Apr 17 19:14:45 2015] [one 300 0, hall frequency controller, P =0.001] data frequencies.csv

t t ref_freq ref_freq electric_frequency electric_frequency hall_freq hall_freq
t: 132.00 ref_freq: 300.00 electric_frequency: 1.20 hall_freq: 0.00 mechanical_freq: 0.24 gear_freq: 0.001202 changing_frequency initial 0
t: 132.00 ref_freq: 300.00 electric_frequency: 1.20 hall_freq: 0.00 mechanical_freq: 0.24 gear_freq: 0.001202 changing_frequency initial 0
t: 132.00 ref_freq: 300.00 electric_frequency: 1.20 hall_freq: 0.00 mechanical_freq: 0.24 gear_freq: 0.001202 changing_frequency initial 0
t: 132.00 ref_freq: 300.00 electric_frequency: 1.20 hall_freq: 0.00 mechanical_freq: 0.24 gear_freq: 0.001202 changing_frequency initial 0
t: 132.00 ref_freq: 300.00 electric_frequency: 1.20 hall_freq: 0.00 mechanical_freq: 0.24 gear_freq: 0.001202 changing_frequency initial 0
t: 132.00 ref_freq: 300.00 electric_frequency: 1.20 hall_freq: 0.00 mechanical_freq: 0.24 gear_freq: 0.001202 changing_frequency initial 0
t: 132.00 ref_freq: 300.00 electric_frequency: 1.20 hall_freq: 0.00 mechanical_freq: 0.24 gear_freq: 0.001202 changing_frequency initial 0
t: 132.00 ref_freq: 300.00 electric_frequency: 1.20 hall_freq: 0.00 mechanical_freq: 0.24 gear_freq: 0.001202 changing_frequency initial 0
t: 132.00 ref_freq: 300.00 electric_frequency: 1.20 hall_freq: 0.00 mechanical_freq: 0.24 gear_freq: 0.001202 changing_frequency initial 0
t: 132.00 ref_freq: 300.00 electric_frequency: 1.20 hall_freq: 0.00 mechanical_freq: 0.24 gear_freq: 0.001202 changing_frequency initial 0
t: 132.00 ref_freq: 300.00 electric_frequency: 1.20 hall_freq: 0.00 mechanical_freq: 0.24 gear_freq: 0.001202 changing_frequency initial 0
t: 132.00 ref_freq: 300.00 electric_frequency: 1.20 hall_freq: 0.00 mechanical_freq: 0.24 gear_freq: 0.001202 changing_frequency initial 0
t: 132.00 ref_freq: 300.00 electric_frequency: 1.20 hall_freq: 0.00 mechanical_freq: 0.24 gear_freq: 0.001202 changing_frequency initial 0
t: 132.00 ref_freq: 300.00 electric_frequency: 1.20 hall_freq: 0.00 mechanical_freq: 0.24 gear_freq: 0.001202 changing_frequency initial 0
t: 132.00 ref_freq: 300.00 electric_frequency: 1.20 hall_freq: 0.00 mechanical_freq: 0.24 gear_freq: 0.001202 changing_frequency initial 0
t: 153.00 ref_freq: 300.00 electric_frequency: 0.94 hall_freq: 0.00 mechanical_freq: 0.19 gear_freq: 0.000936 changing_frequency initial 0
t: 15.00 ref_freq: 300.00 electric_frequency: 0.52 hall_freq: 0.00 mechanical_freq: 0.10 gear_freq: 0.000518 changing_frequency initial 0
t: 28.00 ref_freq: 300.00 electric_frequency: 0.35 hall_freq: 0.00 mechanical_freq: 0.07 gear_freq: 0.000349 changing_frequency initial 0
t: 44.00 ref_freq: 300.00 electric_frequency: 0.11 hall_freq: 0.00 mechanical_freq: 0.02 gear_freq: 0.000115 changing_frequency initial 0
t: 58.00 ref_freq: 300.00 electric_frequency: -0.07 hall_freq: 0.00 mechanical_freq: -0.01 gear_freq: -0.000069 changing_frequency initial 0
t: 71.00 ref_freq: 300.00 electric_frequency: -0.29 hall_freq: 0.00 mechanical_freq: -0.06 gear_freq: -0.000286 changing_frequency initial 0
t: 84.00 ref_freq: 300.00 electric_frequency: -0.48 hall_freq: 0.00 mechanical_freq: -0.10 gear_freq: -0.000475 changing_frequency initial 0
t: 97.00 ref_freq: 300.00 electric_frequency: -0.67 hall_freq: 0.00 mechanical_freq: -0.13 gear_freq: -0.000673 changing_frequency initial 0
t: 110.00 ref_freq: 300.00 electric_frequency: -0.87 hall_freq: 0.00 mechanical_freq: -0.17 gear_freq: -0.000867 changing_frequency initial 0
t: 123.00 ref_freq: 300.00 electric_frequency: -1.13 hall_freq: 0.00 mechanical_freq: -0.23 gear_freq: -0.001129 changing_frequency initial 0
t: 136.00 ref_freq: 300.00 electric_frequency: -1.27 hall_freq: 0.00 mechanical_freq: -0.25 gear_freq: -0.001273 changing_frequency initial 0
t: 149.00 ref_freq: 300.00 electric_frequency: -1.46 hall_freq: 0.00 mechanical_freq: -0.29 gear_freq: -0.001455 changing_frequency initial 0
t: 162.00 ref_freq: 300.00 electric_frequency: -1.66 hall_freq: 0.00 mechanical_freq: -0.33 gear_freq: -0.001663 changing_frequency initial 0
t: 175.00 ref_freq: 300.00 electric_frequency: -1.85 hall_freq: 0.00 mechanical_freq: -0.37 gear_freq: -0.001847 changing_frequency initial 0
t: 188.00 ref_freq: 300.00 electric_frequency: -2.02 hall_freq: 0.00 mechanical_freq: -0.40 gear_freq: -0.002020 changing_frequency initial 0
t: 202.00 ref_freq: 300.00 electric_frequency: -2.18 hall_freq: 0.00 mechanical_freq: -0.44 gear_freq: -0.002185 changing_frequency initial 0
t: 215.00 ref_freq: 300.00 electric_frequency: -2.34 hall_freq: 0.00 mechanical_freq: -0.47 gear_freq: -0.002337 changing_frequency initial 0
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
