arcoslab/open-coroco-legacy/src_DTC-SVM/Three-phase_bridge_SMD/test_Refill/Three-phase bridge-B_Cu.png

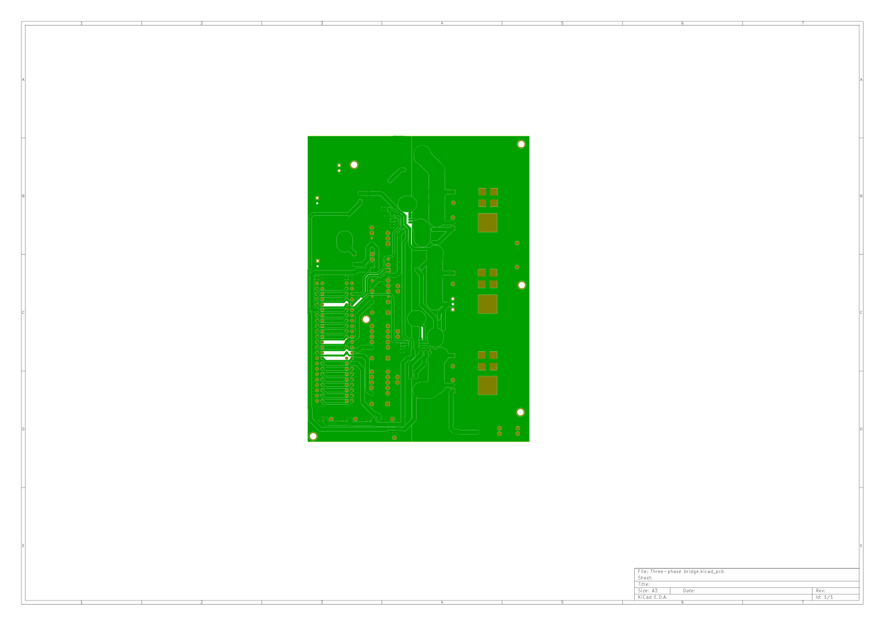
src_DTC-SVM/Three-phase_bridge_SMD/test_Refill/Three-phase bridge-B_Cu.png
