arcoslab/open-coroco-legacy/(list of files, drawings)

Other design files:
trabajo/datas/quadcopt/datasheet/EvvGC v1.2/EvvGC v1.2.PcbDoc
trabajo/datas/quadcopt/datasheet/EvvGC v1.2/EvvGC v1.2.PrjPcb
trabajo/datas/quadcopt/datasheet/EvvGC v1.2/EvvGC v1.2.SchDoc
