arcoslab/open-coroco-legacy/src_DTC-SVM_FixedPoint/Three-phase_bridge_SMD_03_example/Three-phase bridge.kicad_pcb

## KiCad design src_DTC-SVM_FixedPoint/Three-phase_bridge_SMD_03_example/Three-phase bridge.kicad_pcb (2014-02-15)

Schematic: Three-phase bridge.sch

Parts:
1N1, 1N2, 1N3: 1N4003
ACS1, ACS2: ACS712
BT1: BATTERY_12V
BT2: BATTERY_48
C1, C2, C12, C13: 1000uF
C3, C4, C5, C6, C14, C15, C17: 100uF
C7: 100u
C8, C10, C18, C20: 0.1uF
C9: 2.2uF
C11: 0.33uF
C16: 10uF
C19, C21: 1nF
D1, D2, D3, D4, D5, D6, D7, D8, D9, D10, D11: LED
H1, H2, H3: HALL_SENSOR
INA1, INA2: INA148
IR1, IR2, IR3: IR_2110
L1: L7805CV
LF1: LF33CV
M1, M2: MCP6022-I/P
P1, P4, P5: CONN_1
P2, P6: POWER_FUSE
P3: CONN_2
R1, R3, R5, R7, R8, R9, R10, R11, R12, R13, R15, R17, R18, R21, R22, R23, R24, R25, R26: 1k
R2, R4, R14, R16, R19, R20: 36
R6: 3.9k
R27, R28: R
RV1, RV2, RV3, RV4: POT
R_Shunt_1, R_Shunt_2: 0.05
S1, S2, S3, S4, S5, S6: IRF1010N; TO220
STM32_CONN1: CONN_STM32_25X2
STM32_CONN_Passive1: CONN_STM32_25X2_PASSIVE

Connections:
+3.3V: C9.1, INA1.7 (V+), INA2.7 (V+), LF1.2 (OUTPUT), M1.8 (VDD), M2.8 (VDD)
+5V: ACS1.8 (VCC), ACS2.8 (VCC), C10.2, C18.1, C20.1, H1.3, H2.3, H3.3, L1.2 (OUTPUT)
+48V: C12.1, C13.1, C14.1, C15.1, D5.1 (A), P3.1, P6.1, R1.2, R6.1, R13.2, R17.2, RV3.1, RV4.1, S1.3 (D), S3.3 (D), S5.3 (D)
unnamed: M2.3 (VinA+), R7.2, R12.1
unnamed: IR2.1 (Lo), R16.1
unnamed: IR2.7 (HO), R14.1
unnamed: 1N2.2 (K), C6.1, IR2.6 (VB)
unnamed: ACS2.3 (IP-), ACS2.4 (IP-), INA2.2 (-In), R_Shunt_2.2
unnamed: IR3.1 (Lo), R20.1
unnamed: IR3.7 (HO), R19.1
unnamed: 1N3.2 (K), C7.1, IR3.6 (VB)
unnamed: INA2.6 (Out), M1.5 (VinB+)
unnamed: M1.7 (VoutB), R11.1, STM32_CONN1.13 (isB), STM32_CONN_Passive1.13
unnamed: M1.6 (VinB-), R8.2, R11.2
unnamed: IR1.1 (Lo), R4.1
unnamed: INA1.6 (Out), M1.3 (VinA+)
unnamed: M1.2 (VinA-), R5.2, R9.1
unnamed: D10.1 (A), D11.2 (K), INA1.3 (+In), R_Shunt_1.1, S1.1 (S), S4.3 (D)
unnamed: IR1.7 (HO), R2.1
unnamed: 1N1.2 (K), C5.1, IR1.6 (VB)
unnamed: IR1.10 (HIN), STM32_CONN1.28 (A+_PE9), STM32_CONN_Passive1.28
unnamed: M2.6 (VinB-), M2.7 (VoutB), STM32_CONN1.14 (Ud_PA3), STM32_CONN_Passive1.14
unnamed: D2.1 (A), H1.2, R21.2, STM32_CONN1.34 (Hall1_PE15), STM32_CONN_Passive1.34
unnamed: STM32_CONN1.44 (test_pin_3), STM32_CONN_Passive1.44
unnamed: STM32_CONN1.35, STM32_CONN_Passive1.35
unnamed: STM32_CONN1.26, STM32_CONN_Passive1.26
unnamed: STM32_CONN1.46, STM32_CONN_Passive1.46
unnamed: STM32_CONN1.17, STM32_CONN_Passive1.17
unnamed: STM32_CONN1.47, STM32_CONN_Passive1.47
unnamed: STM32_CONN1.18, STM32_CONN_Passive1.18
unnamed: D4.1 (A), H3.2, R23.2, STM32_CONN1.38 (Hall3_PB15), STM32_CONN_Passive1.38
unnamed: STM32_CONN1.39, STM32_CONN_Passive1.39
unnamed: STM32_CONN1.6, STM32_CONN_Passive1.6
unnamed: STM32_CONN1.10, STM32_CONN_Passive1.10
unnamed: IR2.10 (HIN), STM32_CONN1.30 (B+_PE11), STM32_CONN_Passive1.30
unnamed: STM32_CONN1.21, STM32_CONN_Passive1.21
unnamed: STM32_CONN1.22, STM32_CONN_Passive1.22
unnamed: M2.5 (VinB+), R6.2, R10.2, RV1.1, RV2.1, RV3.2, RV4.2
unnamed: D6.2 (K), D7.1 (A), R17.1, R18.1
unnamed: D8.2 (K), D9.1 (A), R13.1, R15.1
unnamed: D5.2 (K), R27.2
unnamed: ACS1.3 (IP-), ACS1.4 (IP-), INA1.2 (-In), R_Shunt_1.2
unnamed: D10.2 (K), D11.1 (A), R1.1, R3.1
unnamed: D8.1 (A), D9.2 (K), INA2.3 (+In), R_Shunt_2.1, S3.1 (S), S6.3 (D)
unnamed: D1.2 (K), R28.1
unnamed: ACS2.6 (Filter), C21.1
unnamed: STM32_CONN1.42 (test_pin_2), STM32_CONN_Passive1.42
unnamed: ACS1.1 (IP+), ACS1.2 (IP+), P1.1
unnamed: ACS1.6 (Filter), C19.1
unnamed: STM32_CONN1.48, STM32_CONN_Passive1.48
unnamed: ACS2.1 (IP+), ACS2.2 (IP+), P4.1
unnamed: D6.1 (A), D7.2 (K), P5.1, S2.3 (D), S5.1 (S)
unnamed: STM32_CONN1.11, STM32_CONN_Passive1.11
unnamed: BT2.1 (+), P6.2
unnamed: BT1.1 (+), P2.2
unnamed: STM32_CONN1.5, STM32_CONN_Passive1.5
unnamed: STM32_CONN1.7, STM32_CONN_Passive1.7
unnamed: STM32_CONN1.15, STM32_CONN_Passive1.15
unnamed: STM32_CONN1.19, STM32_CONN_Passive1.19
unnamed: STM32_CONN1.23, STM32_CONN_Passive1.23
unnamed: IR1.12 (LIN), STM32_CONN1.25 (A-_PE8), STM32_CONN_Passive1.25
unnamed: STM32_CONN1.16, STM32_CONN_Passive1.16
unnamed: STM32_CONN1.20, STM32_CONN_Passive1.20
unnamed: STM32_CONN1.24, STM32_CONN_Passive1.24
unnamed: IR3.10 (HIN), STM32_CONN1.32 (C+_PE13), STM32_CONN_Passive1.32
unnamed: D3.1 (A), H2.2, R22.2, STM32_CONN1.36 (Hall2_PB11), STM32_CONN_Passive1.36
unnamed: STM32_CONN1.40 (test_pin_1), STM32_CONN_Passive1.40
unnamed: STM32_CONN1.41, STM32_CONN_Passive1.41
unnamed: IR2.12 (LIN), STM32_CONN1.27 (B-_PE10), STM32_CONN_Passive1.27
unnamed: IR3.12 (LIN), STM32_CONN1.29 (C-_PE12), STM32_CONN_Passive1.29
unnamed: STM32_CONN1.31, STM32_CONN_Passive1.31
unnamed: STM32_CONN1.33, STM32_CONN_Passive1.33
unnamed: STM32_CONN1.37, STM32_CONN_Passive1.37
unnamed: STM32_CONN1.43, STM32_CONN_Passive1.43
unnamed: STM32_CONN1.45, STM32_CONN_Passive1.45
unnamed: M1.1 (VoutA), R9.2, STM32_CONN1.12 (isA_PA1), STM32_CONN_Passive1.12
unnamed: R14.2, S3.2 (G)
unnamed: C6.2, IR2.5 (Vs)
unnamed: R16.2, S6.2 (G)
unnamed: D2.2 (K), R24.1
unnamed: INA1.1 (Ref), INA2.1 (Ref), M2.1 (VoutA), M2.2 (VinA-), R5.1, R8.1
unnamed: R2.2, S1.2 (G)
unnamed: R4.2, S4.2 (G)
unnamed: C5.2, IR1.5 (Vs)
unnamed: R20.2, S2.2 (G)
unnamed: R19.2, S5.2 (G)
unnamed: C7.2, IR3.5 (Vs)
unnamed: D3.2 (K), R25.1
unnamed: D4.2 (K), R26.1
VCC: 1N1.1 (A), 1N2.1 (A), 1N3.1 (A), C1.1, C2.1, C3.1, C4.1, C8.2, C11.2, D1.1 (A), IR1.3 (VCC), IR2.3 (VCC), IR3.3 (VCC), L1.1 (Input), LF1.1 (Input), P2.1, P3.2 (PM)

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
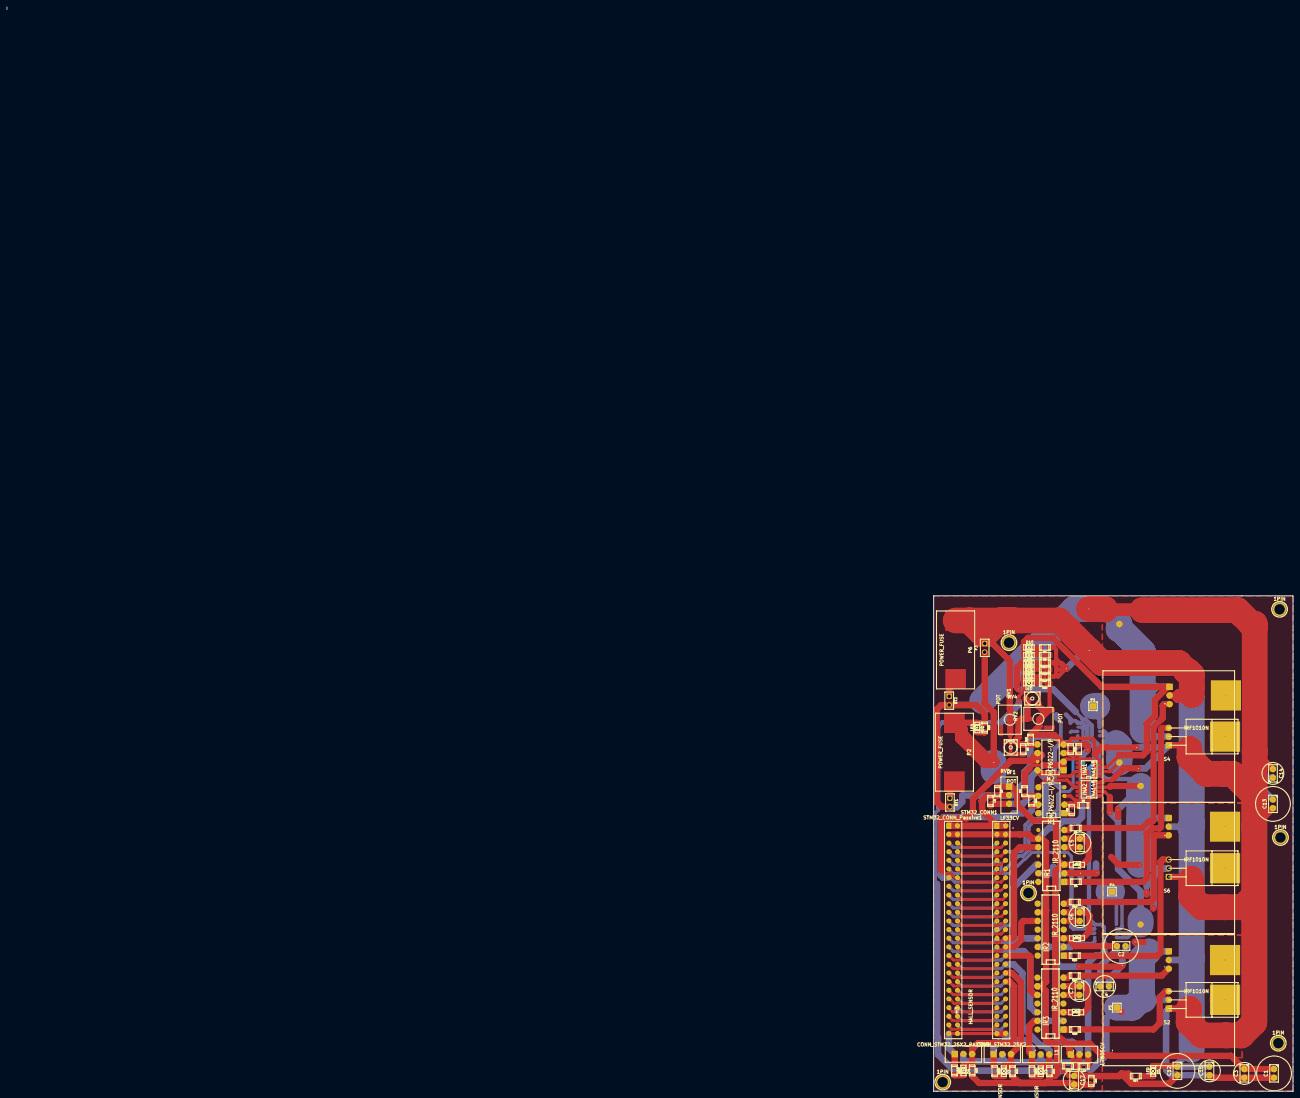
[picture p12: board Three-phase bridge.kicad_pcb from above]

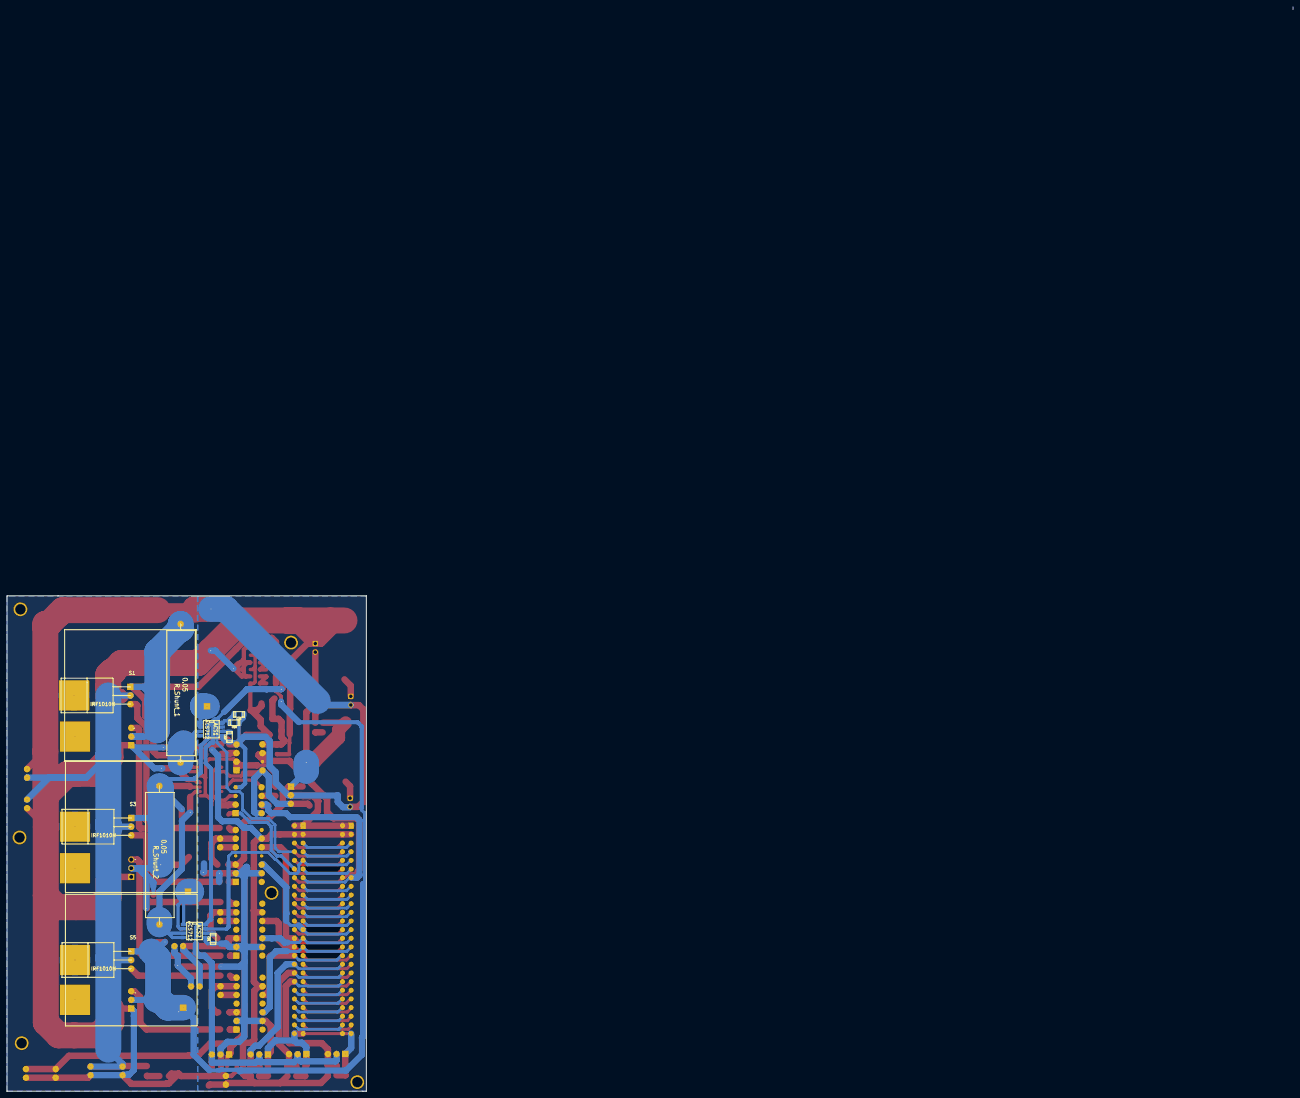
[picture p13: board Three-phase bridge.kicad_pcb from below]

Board: 2 copper layers, 105.4 x 145.3 mm, 105 parts (11 on the bottom side), 94 nets.

Other parts of the board:
1PIN, 1PIN#2, 1PIN#3, 1PIN#4, 1PIN#5, 1PIN#6: P***; 1pin
