arcoslab/open-coroco-legacy/trabajo/kicad/AD2S1210/AD2S1210_AD8662.kicad_pcb

## KiCad design trabajo/kicad/AD2S1210/AD2S1210_AD8662.kicad_pcb (2015-01-27)

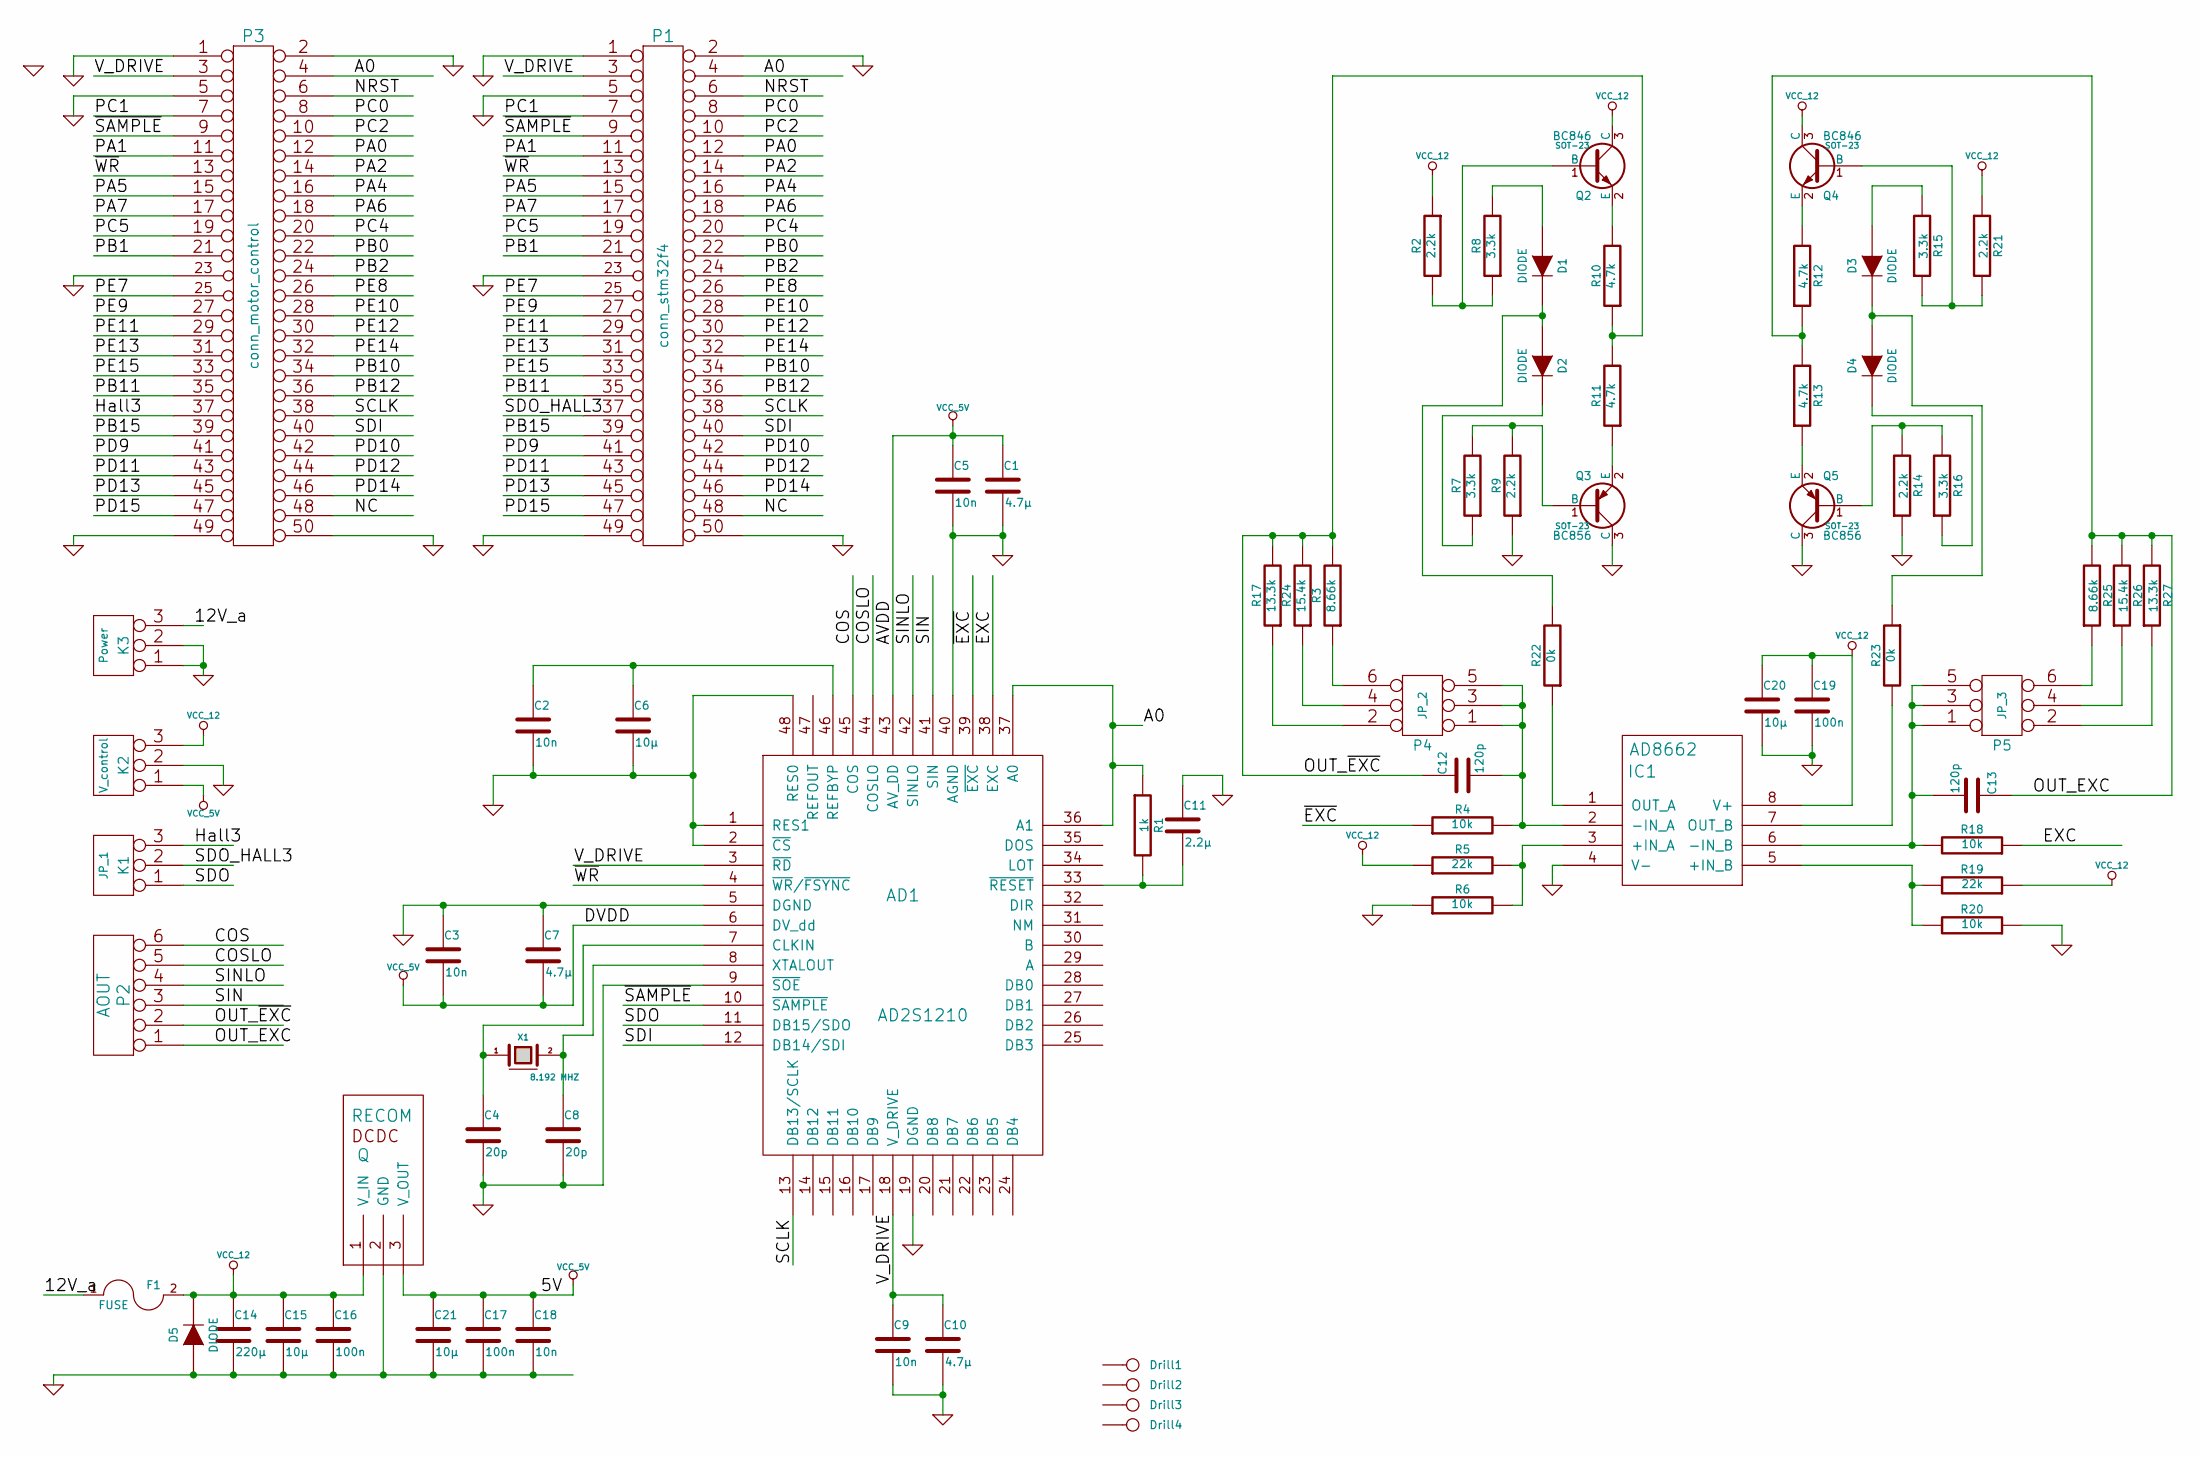
[picture p14: schematic AD2S1210_AD8662.sch, AD2S1210]

Parts:
AD1: AD2S1210
C1, C7, C10: 4.7µ
C2, C3, C5, C9, C18: 10n
C4, C8: 20p
C6, C15, C20, C21: 10µ
C11: 2.2µ
C12, C13: 120p
C14: 220µ
C16, C17, C19: 100n
D1, D2, D3, D4, D5: DIODE
Drill1: Drill1
Drill2: Drill2
Drill3: Drill3
Drill4: Drill4
F1: FUSE
IC1: AD8662
K1: JP_1
K2: V_control
K3: Power
P1: conn_stm32f4
P2: AOUT
P3: conn_motor_control
P4: JP_2
P5: JP_3
Q1: RECOM
Q2, Q4: BC846; SOT-23
Q3, Q5: BC856; SOT-23
R1: 1k
R2, R9, R14, R21: 2.2k
R3, R25: 8.66k
R4, R6, R18, R20: 10k
R5, R19: 22k
R7, R8, R15, R16: 3.3k
R10, R11, R12, R13: 4.7k
R17, R27: 13.3k
R22, R23: 0k
R24, R26: 15.4k
X1: 8.192 MHZ

Connections:
+5V: AD1.6 (DV_dd), AD1.43 (AV_DD), C1.1, C3.2, C5.1, C7.2, C17.1, C18.1, C21.1, K2.1, Q1.3 (V_OUT)
/12V_a: F1.1, K3.3
/A0: AD1.36 (A1), AD1.37 (A0), P1.4, P3.4, R1.1
/COS: AD1.45 (COS), P2.6
/COSLO: AD1.44 (COSLO), P2.5
/EXC: AD1.38 (EXC), R18.1
/Hall3: K1.3, P3.37
/NC: P1.48, P3.48
/NRST: P1.6, P3.6
/OUT_EXC: C13.1, P2.1, R12.1, R13.2, R25.2, R26.2, R27.2
/OUT_~EXC: C12.1, P2.2, R3.2, R10.1, R11.2, R17.2, R24.2
/PA0: P1.12, P3.12
/PA1: P1.11, P3.11
/PA2: P1.14, P3.14
/PA4: P1.16, P3.16
/PA5: P1.15, P3.15
/PA6: P1.18, P3.18
/PA7: P1.17, P3.17
/PB0: P1.22, P3.22
/PB1: P1.21, P3.21
/PB2: P1.24, P3.24
/PB10: P1.34, P3.34
/PB11: P1.35, P3.35
/PB12: P1.36, P3.36
/PB15: P1.39, P3.39
/PC0: P1.8, P3.8
/PC1: P1.7, P3.7
/PC2: P1.10, P3.10
/PC4: P1.20, P3.20
/PC5: P1.19, P3.19
/PD9: P1.41, P3.41
/PD10: P1.42, P3.42
/PD11: P1.43, P3.43
/PD12: P1.44, P3.44
/PD13: P1.45, P3.45
/PD14: P1.46, P3.46
/PD15: P1.47, P3.47
/PE7: P1.25, P3.25
/PE8: P1.26, P3.26
/PE9: P1.27, P3.27
/PE10: P1.28, P3.28
/PE11: P1.29, P3.29
/PE12: P1.30, P3.30
/PE13: P1.31, P3.31
/PE14: P1.32, P3.32
/PE15: P1.33, P3.33
/SCLK: AD1.13 (DB13/SCLK), P1.38, P3.38
/SDI: AD1.12 (DB14/SDI), P1.40, P3.40
/SDO: AD1.11 (DB15/SDO), K1.1
/SDO_HALL3: K1.2 (PM), P1.37
/SIN: AD1.41 (SIN), P2.3
/SINLO: AD1.42 (SINLO), P2.4
/V_DRIVE: AD1.3 (~RD), AD1.18 (V_DRIVE), C9.1, C10.1, P1.3, P3.3
/~EXC: AD1.39 (~EXC), R4.1
/~SAMPLE: AD1.10 (~SAMPLE), P1.9, P3.9
/~WR: AD1.4 (~WR~/~FSYNC), P1.13, P3.13
GND: AD1.1 (RES1), AD1.2 (~CS), AD1.5 (DGND), AD1.9 (~SOE), AD1.19 (DGND), AD1.40 (AGND), AD1.48 (RES0), C1.2, C2.2, C3.1, C4.2, C5.2, C6.2, C7.1, C8.2, C9.2, C10.2, C11.1, C14.2, C15.2, C16.2, C17.2, C18.2, C19.2, C20.2, C21.2, D5.1 (A), IC1.4 (V-), K2.2 (PM), K3.1, K3.2 (PM), P1.1, P1.2, P1.5, P1.23, P1.49, P1.50, P3.1, P3.2, P3.5, P3.23, P3.49, P3.50, Q1.2 (GND), Q3.3 (C), Q5.3 (C), R6.1, R9.1, R14.1, R20.1
unnamed: AD1.33 (~RESET), C11.2, R1.2
unnamed: D4.2 (K), R16.1
unnamed: D3.1 (A), R15.2
unnamed: Q4.1 (B), R15.1, R21.2
unnamed: D3.2 (K), D4.1 (A), R23.1
unnamed: Q5.2 (E), R13.1
unnamed: Q4.2 (E), R12.2
unnamed: Q5.1 (B), R14.2, R16.2
unnamed: IC1.5 (+IN_B), R19.2, R20.2
unnamed: P5.2, R27.1
unnamed: C13.2, IC1.6 (-IN_B), P5.1, P5.3, P5.5, R18.2
unnamed: P5.4, R26.1
unnamed: P5.6, R25.1
unnamed: IC1.3 (+IN_A), R5.2, R6.2
unnamed: IC1.7 (OUT_B), R23.2
unnamed: P4.2, R17.1
unnamed: P4.4, R24.1
unnamed: P4.6, R3.1
unnamed: AD1.46 (REFBYP), C2.1, C6.1
unnamed: Q3.2 (E), R11.1
unnamed: IC1.1 (OUT_A), R22.1
unnamed: C12.2, IC1.2 (-IN_A), P4.1, P4.3, P4.5, R4.2
unnamed: D1.1 (A), R8.2
unnamed: Q2.2 (E), R10.2
unnamed: Q3.1 (B), R7.2, R9.2
unnamed: Q2.1 (B), R2.2, R8.1
unnamed: D2.2 (K), R7.1
unnamed: D1.2 (K), D2.1 (A), R22.2
unnamed: AD1.7 (CLKIN), C4.1, X1.1
unnamed: AD1.8 (XTALOUT), C8.1, X1.2
VCC: C14.1, C15.1, C16.1, C19.1, C20.1, D5.2 (K), F1.2, IC1.8 (V+), K2.3, Q1.1 (V_IN), Q2.3 (C), Q4.3 (C), R2.1, R5.1, R19.1, R21.1

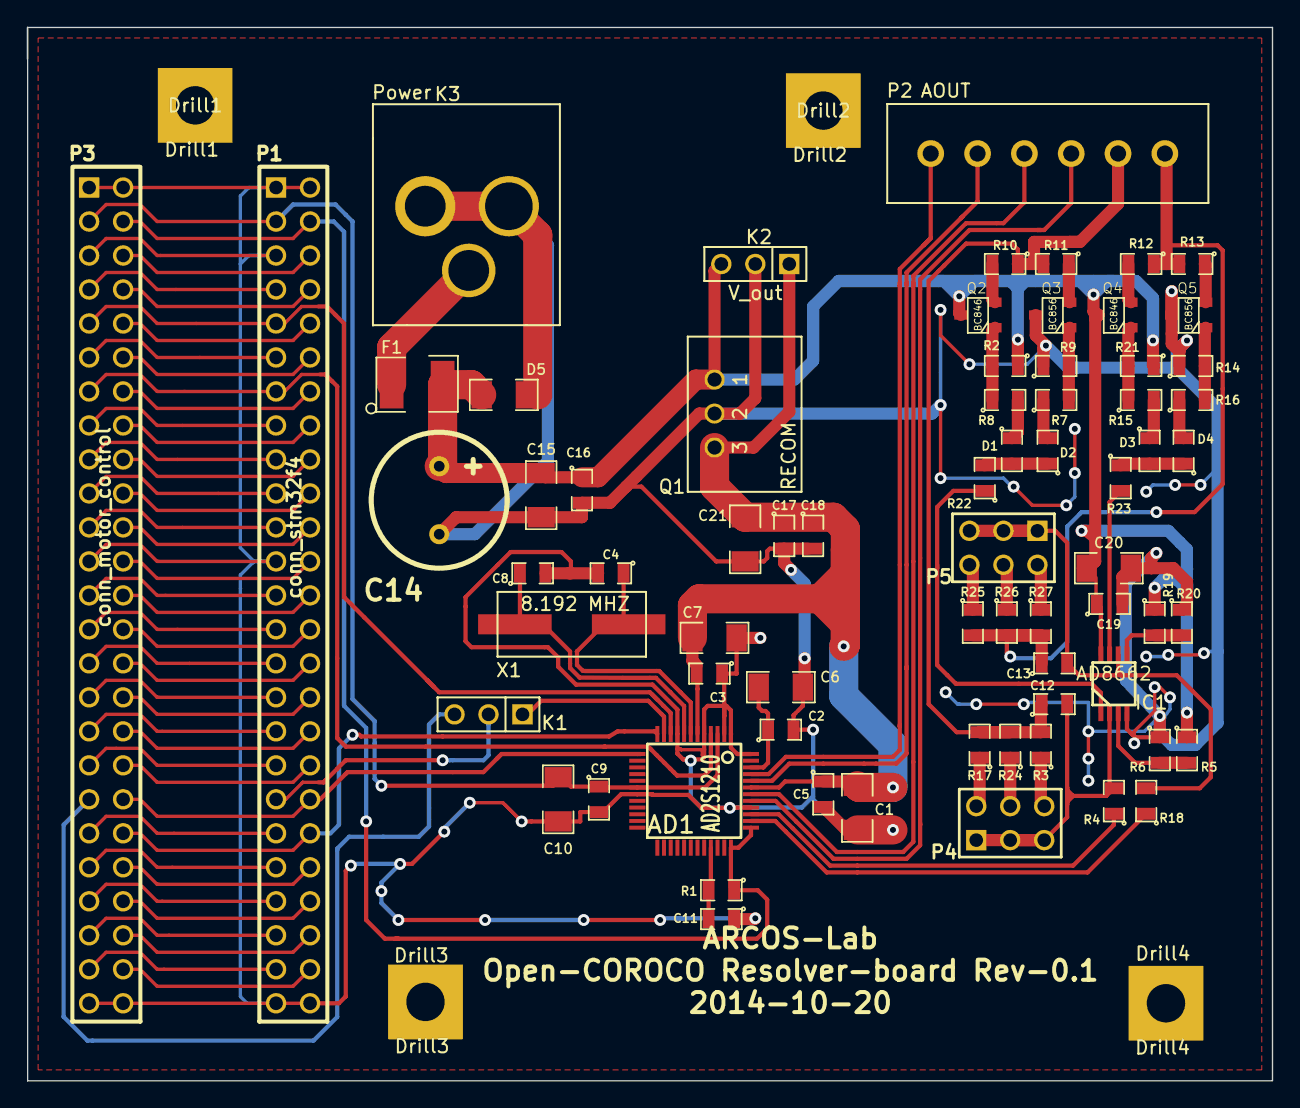
[picture p15: board AD2S1210_AD8662.kicad_pcb from above]

Board: 2 copper layers, 93.0 x 78.7 mm, 74 parts (0 on the bottom side), 88 nets.
