arcoslab/open-coroco-legacy/trabajo/kicad/AD2S1210/AD2S1210.kicad_pcb

## KiCad design trabajo/kicad/AD2S1210/AD2S1210.kicad_pcb (2014-10-18)

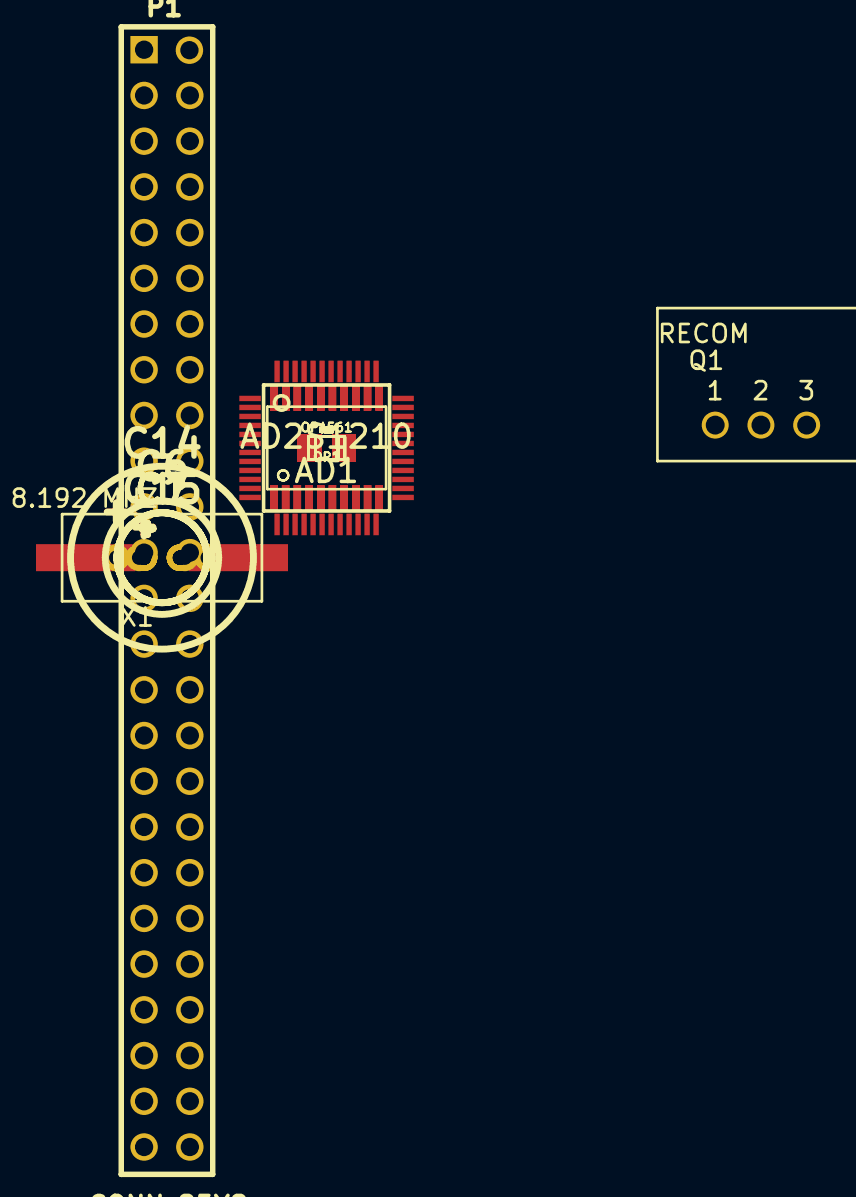
[picture p16: board AD2S1210.kicad_pcb from above]

Board: 2 copper layers, 35 parts (0 on the bottom side), 40 nets, no tracks yet.

Parts:
AD1: AD2S1210; LQFP48
C1, C7: 4.7µ; Elko_vert_DM5_RM2
C2, C3, C5, C9, C18: 10n; c_0805
C4, C8: 20p; c_0805
C6: 22µ; Elko_vert_DM6-3_RM2-5
C10: 4.7µ; c_0805
C11: 2.2µ; c_0805
C12, C13: 120p; c_0805
C14: 220µ; Elko_vert_DM10_RM5
C15: 10µ; Elko_vert_DM5_RM2
C16, C17: 100n; c_0805
OP1, OP2: OPA561; tssop-20
P1: CONN_25X2; PIN_ARRAY_STM32_25X2
Q1: RECOM; SIP-3
R1: 1k; c_0805
R2, R3: 15.4k; c_0805
R4, R5, R9, R11: 10k; c_0805
R6, R7: 390k; c_0805
R8, R10: 22k; c_0805
X1: 8.192 MHZ; crystal_ATS

Connections:
/A0: AD1.36, AD1.37, P1.4, R1.1
/COS: AD1.45, P1.10
/COSLO: AD1.44, P1.12
/EXC: AD1.38, R5.1
/OUT_EXC: C13.1, OP2.7, P1.24, R3.1
/OUT_~EXC: C12.1, OP1.7, P1.22, R2.1
/SCLK: AD1.13, P1.38
/SDI: AD1.12, P1.40
/SDO: AD1.11, P1.37
/SIN: AD1.41, P1.18
/SINLO: AD1.42, P1.16
/V_DRIVE: AD1.3, P1.3
/~EXC: AD1.39, R4.1
/~SAMPLE: AD1.10, P1.9
/~WR: AD1.4, P1.13
GND: AD1.19, C14.2, C15.2, C16.2, C17.2, C18.2, OP1.5, OP2.5, Q1.2
unnamed: AD1.6, C3.2, C7.2
unnamed: AD1.5, C3.1, C7.1
unnamed: C9.2, C10.2
unnamed: AD1.18, C9.1, C10.1
unnamed: AD1.9, C4.2, C8.2
unnamed: C17.1, C18.1, Q1.3
unnamed: AD1.40, C1.2, C5.2
unnamed: AD1.1, AD1.2, AD1.48, C2.2, C6.2
unnamed: AD1.8, C8.1, X1.2
unnamed: AD1.7, C4.1, X1.1
unnamed: C14.1, C15.1, C16.1, Q1.1
unnamed: OP1.8, R6.2
unnamed: C12.2, OP1.3, R2.2, R4.2
unnamed: OP2.8, R7.2
unnamed: C13.2, OP2.3, R3.2, R5.2
unnamed: OP2.2, R10.2, R11.1
unnamed: OP2.4, R11.2
unnamed: OP2.6, R7.1, R10.1
unnamed: AD1.33, C11.2, R1.2
unnamed: AD1.43, C1.1, C5.1
unnamed: AD1.46, C2.1, C6.1
unnamed: OP1.2, R8.2, R9.1
unnamed: OP1.4, R9.2
unnamed: OP1.6, R6.1, R8.1
