arcoslab/open-coroco-legacy/trabajo/kicad/Copter/copter.kicad_pcb

## KiCad design trabajo/kicad/Copter/copter.kicad_pcb (2014-10-18)

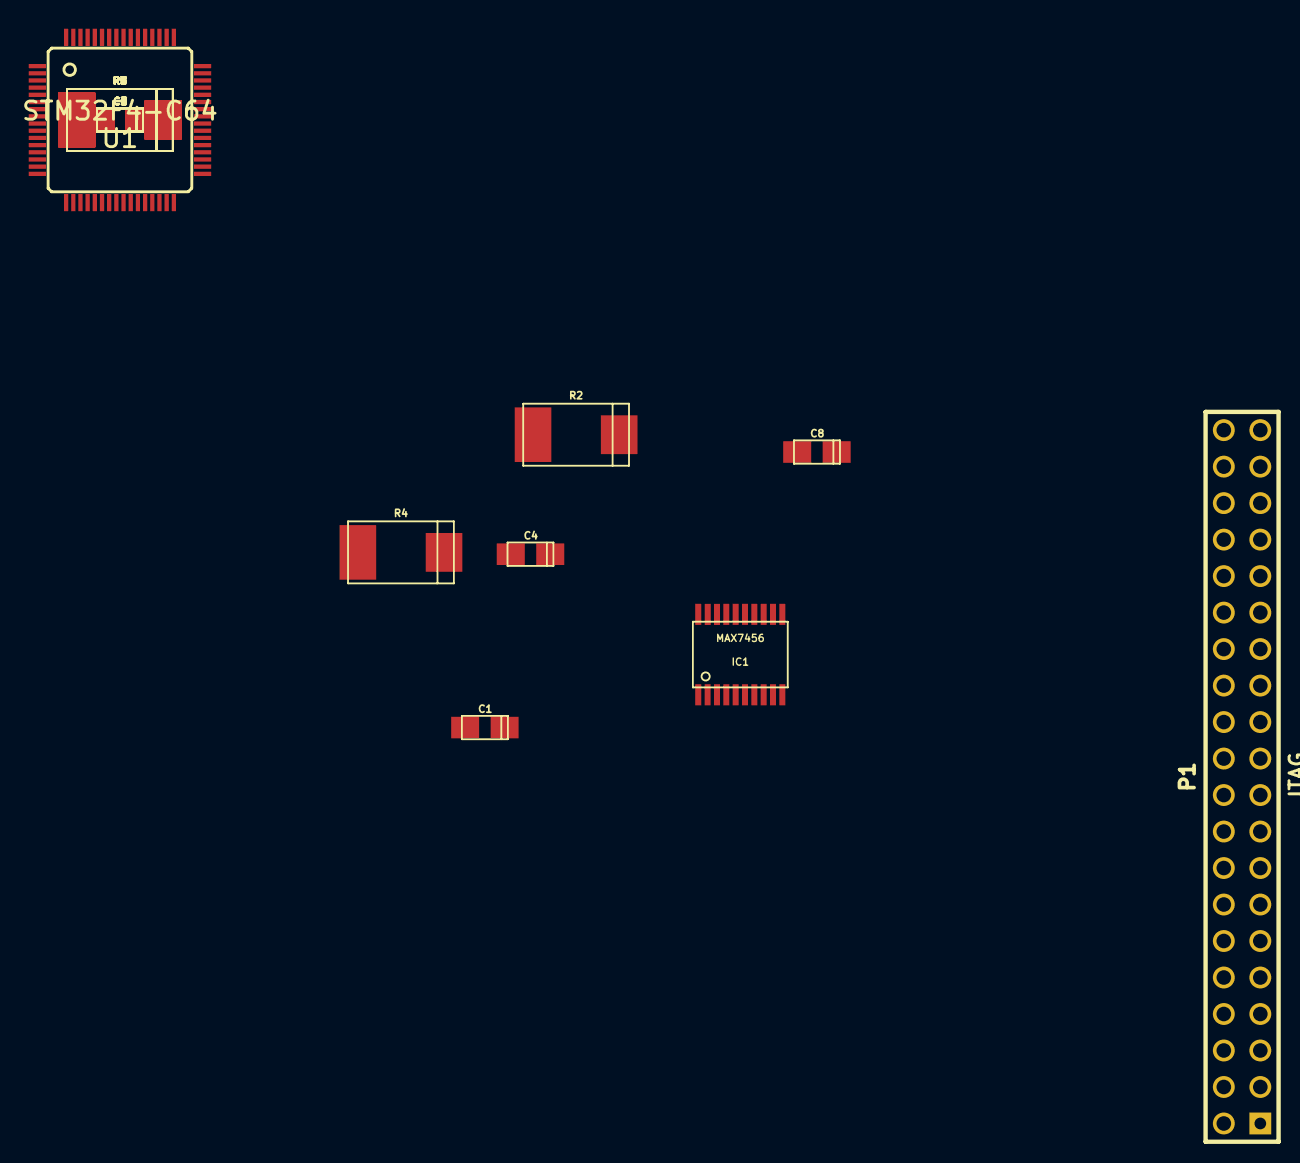
[picture p17: board copter.kicad_pcb from above]

Board: 2 copper layers, 20 parts (0 on the bottom side), 10 nets, no tracks yet.

Parts:
C1, C2, C3, C4, C6: 100nF; c_tant_A
C5, C7, C8: 10µF; c_tant_A
IC1: MAX7456; tssop-20
P1: JTAG; PIN_ARRAY_20X2
R1, R4, R5: 33 R; c_tant_D
R2, R3, R6, R7: 10K; c_tant_D
R8: 0K; c_tant_D
R9: 120K; c_tant_D
U1: STM32F4-C64; LQFP64

Connections:
+5V: C1.1, C2.1, C3.1, C4.1, C5.1, C6.2, C7.2, P1.4, P1.7, R2.2, R3.2, R6.2, R7.2, U1.13
/RESET: P1.6, U1.56
/TCK: P1.1, R7.1, U1.49
/TDI: P1.9, R2.1, U1.50
/TDO: P1.3, R6.1, U1.55
/TMS: P1.5, R3.1, U1.46
/USB_D+: R4.2, U1.45
/USB_D-: R1.2, U1.44
/USB_VBUS: R5.2, U1.42
GND: C1.2, C2.2, C3.2, C4.2, C5.2, C6.1, C7.1, C8.2, P1.2, P1.10, R8.1, U1.12
