arcoslab/open-coroco-legacy/src_DTC-SVM_FixedPoint/bigger_tracks_Three-phase_bridge_SMD/Three-phase bridge.sch

## KiCad design src_DTC-SVM_FixedPoint/bigger_tracks_Three-phase_bridge_SMD/Three-phase bridge.sch (2014-03-24)

Schematic: Three-phase bridge.sch

Parts:
1N1, 1N2, 1N3: 1N4003
ACS1, ACS2: ACS712
BT1: BATTERY_12V
BT2: BATTERY_48
C1, C2, C12, C13: 1000uF
C3, C4, C5, C6, C14, C15, C17: 100uF
C7: 100u
C8, C10, C18, C20: 0.1uF
C9: 2.2uF
C11: 0.33uF
C16: 10uF
C19, C21: 1nF
D1, D2, D3, D4, D5, D6, D7, D8, D9, D10, D11: LED
H1, H2, H3: HALL_SENSOR
INA1, INA2: INA148
IR1, IR2, IR3: IR_2110
L1: L7805CV
LF1: LF33CV
M1, M2: MCP6022-I/P
P1, P4, P5: CONN_1
P2, P6: POWER_FUSE
P3: CONN_2
P7, P8, P9, P10, P11, P12, P13: CONN_1
R1, R3, R5, R7, R8, R9, R10, R11, R12, R13, R15, R17, R18, R21, R22, R23, R24, R25, R26: 1k
R2, R4, R14, R16, R19, R20: 36
R6: 3.9k
R27, R28: R
RV1, RV2, RV3, RV4: POT
R_Shunt_1, R_Shunt_2: 0.05
S1, S2, S3, S4, S5, S6: IRF1010N; TO220
STM32_CONN1: CONN_STM32_25X2
