arcoslab/open-coroco-legacy/src_stiffness_controller/Configuration/ntm_28-30_propdrive.h

//ntm motor configuration

#define MIN_ATTENUATION 0.2f
#define MAX_ATTENUATION 1.0f

#define MAX_MOTOR_FREQ 780.0f


#define P 0.01      //#define P_DOWN 0.0001 //To control deacceleration speed and therefore braking current
#define P_DOWN 0.01 //To control deacceleration speed and therefore braking current
//#define I 0.000001
//#define I 0.0000004 //NMB motor
//#define I_DOWN 0.00000001 //To control deacceleration speed and therefore braking current
//#define I_DOWN 0.0000001 //To control deacceleration speed and therefore braking current /NMB motors
#define I 0.0000004 //NMB motor
#define I_DOWN 0.0000004 //NMB motor
#define I_MAX 80*PI/180.0f
#define P_MAX 80*PI/180.0f
#define PI_MAX 87*PI/180.0f //acceleration torque
#define PI_MIN -1*PI/180.0f //braking torque


#define START_ATTENUATION_FREQ 20.0f
#define START_UP_REF_FREQ 5.0f
#define MIN_CLOSE_LOOP_FREQ 3.0f
#define FIRST_CLOSE_LOOP_REF_FREQ 60.0f
//#define HALL_CAL_OFFSET 136.0f //degrees
//#define HALL_CAL_OFFSET 136.0f //degrees (H1)
//#define HALL_CAL_OFFSET 140.0f //degrees (H3)
//#define HALL_CAL_OFFSET 300.0f //degrees (H2)
#define HALL_CAL_OFFSET 136.0f //degrees (H1)
#define FREQ_TO_STOP_MOTOR 30.0f


//motor parameters
#define R_s_0          0.267154f    //Ohms
#define L_s_d_0        0.0000417428f//0.000062f  //H   0.000089f H
#define L_s_q_0	       0.0000500913f//0.000052f  //H   0.000089f H
#define psi_F_0        0.0014f  //0.0045f    //Wb-t (weber-turn) (kg m2 s-2 A-1)
#define pole_pairs_0   6.0f	    //six pole pairs (seven d-axis)
