arcoslab/open-coroco-legacy/src_stiffness_controller/DTC/DTC.c

/*
 *This file is part of the open-coroco project.
 *
 *  Copyright (C) 2013  Sebastian Chinchilla Gutierrez <tumacher@gmail.com>
 *
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
 *  You should have received a copy of the GNU General Public License
 *  along with this program.  If not, see <http://www.gnu.org/licenses/>.
 */
int optimal_voltage_vector=0;
#define CURRENT_LIMIT 14.99f
//-----------------voltage and current space vectors---------------------


float direct_stator_current_i_sD     (float i_sA)
{
  return i_sA;
}
float quadrature_stator_current_i_sQ (float i_sA,float i_sB)
{
  //return (1.0f/sqrtf(3.0f))*(i_sA+2.0f*i_sB);
  return 0.57735026918962576451f*(i_sA+2.0f*i_sB);
}



void  switching_states (int* S_A, int* S_B, int* S_C)
{
  int S1,S2,S3,S4,S5,S6;
  
  S1=gpio_get(GPIOE, GPIO9 );
  S4=gpio_get(GPIOE, GPIO8 );
  S3=gpio_get(GPIOE, GPIO11);
  S6=gpio_get(GPIOE, GPIO10);
  S5=gpio_get(GPIOE, GPIO13);
  S2=gpio_get(GPIOE, GPIO12);

  if      ( S1 && ~S4) *S_A=1;
  else if (~S1 &&  S4) *S_A=0;
  else                 *S_A=2;

  if      ( S3 && ~S6) *S_B=1;
  else if (~S3 &&  S6) *S_B=0;
  else                 *S_B=2;

  if      ( S5 && ~S2) *S_C=1;
  else if (~S5 &&  S2) *S_C=0;
  else                 *S_C=2;
  
  

}

void  floating_switching_states (float* S_A, float* S_B, float* S_C)
{
  int S1,S2,S3,S4,S5,S6;
  
  S1=gpio_get(GPIOE, GPIO9 );
  S4=gpio_get(GPIOE, GPIO8 );
  S3=gpio_get(GPIOE, GPIO11);
  S6=gpio_get(GPIOE, GPIO10);
  S5=gpio_get(GPIOE, GPIO13);
  S2=gpio_get(GPIOE, GPIO12);

  if      ( S1 && ~S4) *S_A=1.0f;
  else if (~S1 &&  S4) *S_A=0.0f;
  else                 *S_A=0.5f;//0.5f;

  if      ( S3 && ~S6) *S_B=1.0f;
  else if (~S3 &&  S6) *S_B=0.0f;
  else                 *S_B=0.5f;//0.5f;

  if      ( S5 && ~S2) *S_C=1.0f;
  else if (~S5 &&  S2) *S_C=0.0f;
  else                 *S_C=0.5f;//0.5f;
  
  

}

//---------------------stator flux-linkage space vector estimation-------------------------------
#define PI_CTE 3.14159265359f 
#define F_CUTOFF 5.0f//5.0f
#define W_CUTOFF (2.0f*PI_CTE*F_CUTOFF)
#define CTE (150.0f)  
#define K_LPF  0.2f


//#define a_sD (-0.000008721f+0.00000905405538680536f)*2.0f
//#define b_sQ (-0.00000227445533769063f)*2.0f
#define a_sD 0.0f
#define b_sQ 0.0f



float direct_stator_flux_linkage_estimator_psi_sD     (float T,float V_sD,float i_sD,float R_s)//,float electric_frequency)
{
  static float previous_psi_sD=0.0f;

  //if (electric_frequency<1.0f) electric_frequency=1.0f;

  //if (electric_frequency<=200.0f) electric_frequency=200.0f;

/*
  if (electric_frequency>=0) previous_psi_sD = ( previous_psi_sD+T*(V_sD-i_sD*R_s) )/(1.0f+T*( K_LPF*2.0f*PI_CTE*electric_frequency));
  else                       previous_psi_sD = ( previous_psi_sD+T*(V_sD-i_sD*R_s) )/(1.0f+T*(-K_LPF*2.0f*PI_CTE*electric_frequency));
*/                     
  previous_psi_sD = ( previous_psi_sD+T*(V_sD-i_sD*R_s) )/(1.0f+T*W_CUTOFF);
  //previous_psi_sD = ( previous_psi_sD+T*(V_sD-i_sD*R_s) )*(1.0f-2.0f*PI_CTE*F_CUTOFF*T);



  //previous_psi_sD = previous_psi_sD *sqrtf(1.0f+W_CUTOFF*W_CUTOFF/(electric_frequency*electric_frequency) );
  

  return previous_psi_sD;
}

float quadrature_stator_flux_linkage_estimator_psi_sQ (float T,float V_sQ,float i_sQ,float R_s)//,float electric_frequency)
{
  static float previous_psi_sQ=0.0f;

    //if (electric_frequency<=1.0f) electric_frequency=1.0f;

  //previous_psi_sQ = ( previous_psi_sQ+T*(V_sQ-i_sQ*R_s) )/(1.0f+T*(electric_frequency*CTE));
  previous_psi_sQ = ( previous_psi_sQ+T*(V_sQ-i_sQ*R_s) )/(1.0f+T*W_CUTOFF);

/*
  if (electric_frequency>=0)  previous_psi_sQ=( previous_psi_sQ+T*(V_sQ-i_sQ*R_s) )*(1.0f+T*( K_LPF*2.0f*PI_CTE*electric_frequency));
  else                        previous_psi_sQ=( previous_psi_sQ+T*(V_sQ-i_sQ*R_s) )*(1.0f+T*( K_LPF*2.0f*PI_CTE*electric_frequency));
*/     
/*
  if (electric_frequency<1.0f) electric_frequency=1.0f;

  previous_psi_sQ = previous_psi_sQ *sqrtf(1.0f+W_CUTOFF*W_CUTOFF/(electric_frequency*electric_frequency) );
*/
  return previous_psi_sQ;
}


void fast_vector_angle_and_magnitude(float y,float x, float* magnitude, float* angle)
{
    //if (x!=x) x=0.0f;
    //if (y!=y) y=0.0f;

    *angle=fast_vector_angle(y,x);

    //if (*angle!=*angle) *angle=0.0f;

    *magnitude=x/fast_cos(*angle);

    //if (*magnitude!=*magnitude) *magnitude=0.0f; 
}


void flux_linkage_estimator (float T,float V_sD,float V_sQ,float i_sD,float i_sQ,float R_s,float electric_frequency, float* psisD, float* psisQ, float*psis,float* psis_alpha)
{
  static float previous_psi_sD=0.0f;
  static float previous_psi_sQ=0.0f;

  float LPF_psi_sD=0.0f;
  float LPF_psi_sQ=0.0f;
  float LPF_lag_angle=0.0f;

  float LPF_psi_s_alpha=0.0f;
  float LPF_psi_s=0.0f;



  //fixed cutoff frequency
    //LPF_psi_sD = ( previous_psi_sD+T*(V_sD-i_sD*R_s) )/(1.0f+T*( 2.0f*PI_CTE*F_CUTOFF));
    //LPF_psi_sQ = ( previous_psi_sQ+T*(V_sQ-i_sQ*R_s) )/(1.0f+T*( 2.0f*PI_CTE*F_CUTOFF));   


  if (K_LPF*electric_frequency<5.0f)
  {
    LPF_psi_sD = ( previous_psi_sD+T*(V_sD-i_sD*R_s) )/(1.0f+T*( 2.0f*PI_CTE*F_CUTOFF));
    LPF_psi_sQ = ( previous_psi_sQ+T*(V_sQ-i_sQ*R_s) )/(1.0f+T*( 2.0f*PI_CTE*F_CUTOFF));   
    //LPF_psi_sD = ( previous_psi_sD+T*(V_sD) )/(1.0f+T*( 2.0f*PI_CTE*F_CUTOFF));
    //LPF_psi_sQ = ( previous_psi_sQ+T*(V_sQ) )/(1.0f+T*( 2.0f*PI_CTE*F_CUTOFF));   
  }
  else 
  {
    LPF_psi_sD = ( previous_psi_sD+T*(V_sD-i_sD*R_s) )/(1.0f+T*( K_LPF*2.0f*PI_CTE*electric_frequency));
    LPF_psi_sQ = ( previous_psi_sQ+T*(V_sQ-i_sQ*R_s) )/(1.0f+T*( K_LPF*2.0f*PI_CTE*electric_frequency));
    //LPF_psi_sD = ( previous_psi_sD+T*(V_sD) )/(1.0f+T*( K_LPF*2.0f*PI_CTE*electric_frequency));
    //LPF_psi_sQ = ( previous_psi_sQ+T*(V_sQ) )/(1.0f+T*( K_LPF*2.0f*PI_CTE*electric_frequency)); 
  }
/**/


  //LPF_psi_sD = ( previous_psi_sD+T*(V_sD) )/(1.0f+T*( 2.0f*PI_CTE*F_CUTOFF));
  //LPF_psi_sQ = ( previous_psi_sQ+T*(V_sQ) )/(1.0f+T*( 2.0f*PI_CTE*F_CUTOFF));


  //LPF_psi_s       = stator_flux_linkage_magnite_psi_s               (LPF_psi_sD,LPF_psi_sQ);
  //LPF_psi_s_alpha = fast_vector_angle                               (LPF_psi_sQ,LPF_psi_sD);
  //LPF_lag_angle   = 1.0f;

/*
    LPF_psi_sD = ( previous_psi_sD+T*(V_sD-i_sD*R_s) )/(1.0f+T*( 2.0f*PI_CTE*F_CUTOFF));
    LPF_psi_sQ = ( previous_psi_sQ+T*(V_sQ-i_sQ*R_s) )/(1.0f+T*( 2.0f*PI_CTE*F_CUTOFF)); 
*/

  fast_vector_angle_and_magnitude(LPF_psi_sQ,LPF_psi_sD,&LPF_psi_s,&LPF_psi_s_alpha);
  LPF_lag_angle   = 0.0f;

  *psis       = LPF_psi_s;
  *psis_alpha = LPF_psi_s_alpha+LPF_lag_angle;

  previous_psi_sD = LPF_psi_s*fast_cos (*psis_alpha);
  previous_psi_sQ = LPF_psi_s*fast_sine(*psis_alpha);

  *psisD=previous_psi_sD;
  *psisQ=previous_psi_sQ;

/*
//fixed wcutoff, no lag compensation

  LPF_psi_sD = ( previous_psi_sD+T*(V_sD-i_sD*R_s) )/(1.0f+T*( 2.0f*PI_CTE*F_CUTOFF));
  LPF_psi_sQ = ( previous_psi_sQ+T*(V_sQ-i_sQ*R_s) )/(1.0f+T*( 2.0f*PI_CTE*F_CUTOFF));

  previous_psi_sD=LPF_psi_sD;
  previous_psi_sQ=LPF_psi_sQ;

  *psisD=previous_psi_sD;
  *psisQ=previous_psi_sQ;
*/

//no filter, neglecting currents
/*
  LPF_psi_sD = ( previous_psi_sD+T*(V_sD-i_sD*R_s) )/(1.0f+T*( 2.0f*PI_CTE*F_CUTOFF));
  LPF_psi_sQ = ( previous_psi_sQ+T*(V_sQ-i_sD*R_s) )/(1.0f+T*( 2.0f*PI_CTE*F_CUTOFF));

  //LPF_psi_sD = ( previous_psi_sD+T*(V_sD) )/(1.0f+T*( 2.0f*PI_CTE*F_CUTOFF));
  //LPF_psi_sQ = ( previous_psi_sQ+T*(V_sQ) )/(1.0f+T*( 2.0f*PI_CTE*F_CUTOFF));

  previous_psi_sD=LPF_psi_sD;
  previous_psi_sQ=LPF_psi_sQ;

  *psisD=previous_psi_sD;
  *psisQ=previous_psi_sQ;
*/
}


void flux_linkage_estimator_neglected_currents (float T,float V_sD,float V_sQ, float* psisD, float* psisQ)//, float*psis,float* psis_alpha)
{
  static float previous_psi_sD=0.0f;
  static float previous_psi_sQ=0.0f;

  static float previous_VsD=0.0f;
  static float previous_VsQ=0.0f;

/*
  if (K_LPF*electric_frequency<5.0f)
  {
    *psisD = ( previous_psi_sD+T*(V_sD) )/(1.0f+T*( 2.0f*PI_CTE*F_CUTOFF));
    *psisQ = ( previous_psi_sQ+T*(V_sQ) )/(1.0f+T*( 2.0f*PI_CTE*F_CUTOFF));   
  }
  else 
  {
    *psisD = ( previous_psi_sD+T*(V_sD) )/(1.0f+T*( K_LPF*2.0f*PI_CTE*electric_frequency));
    *psisQ = ( previous_psi_sQ+T*(V_sQ) )/(1.0f+T*( K_LPF*2.0f*PI_CTE*electric_frequency)); 
  }
*/    
    *psisD = ( previous_psi_sD+T*(V_sD) )/(1.0f+T*( 2.0f*PI_CTE*F_CUTOFF));
    *psisQ = ( previous_psi_sQ+T*(V_sQ) )/(1.0f+T*( 2.0f*PI_CTE*F_CUTOFF));   

  //fast_vector_angle_and_magnitude(*psisQ,*psisD,psis,psis_alpha);


    if (*psisD!=*psisD)   
    { 
        *psisD = ( previous_psi_sD+T*(previous_VsD) )/(1.0f+T*( 2.0f*PI_CTE*F_CUTOFF));
        *psisQ = ( previous_psi_sQ+T*(previous_VsQ) )/(1.0f+T*( 2.0f*PI_CTE*F_CUTOFF));
    }
    if (*psisQ!=*psisQ)     
    {
        *psisD = ( previous_psi_sD+T*(previous_VsD) )/(1.0f+T*( 2.0f*PI_CTE*F_CUTOFF));
        *psisQ = ( previous_psi_sQ+T*(previous_VsQ) )/(1.0f+T*( 2.0f*PI_CTE*F_CUTOFF));
    }

    previous_psi_sD = *psisD;
    previous_psi_sQ = *psisQ;

    previous_VsD=V_sD;
    previous_VsQ=V_sQ;

  if (V_sD!=V_sD || V_sQ!=V_sQ )
    t_e_ref=66.0f;
  else if (psisD!=psisD && psisQ!=psisQ)
  {
   t_e_ref=55.0f;
   //psi_sD_i_neglected=0.0f;
   //psi_sD_i_neglected=0.0f;
  }
  else if (*psisD!=*psisD)
   t_e_ref=V_sD;
  else if (*psisQ!=*psisQ)
   t_e_ref=33.0f;

}




float rotor_speed_w_r(float psi_sD, float psi_sQ, float T)
{
  static float previous_psi_sD=0.0f;
  static float previous_psi_sQ=0.0f;
  float w_=0.0f;
  w_=(previous_psi_sD*psi_sQ-previous_psi_sQ*psi_sD)/(T*(psi_sD*psi_sD+psi_sQ*psi_sQ));
  previous_psi_sD=psi_sD;
  previous_psi_sQ=psi_sQ;
  return w_;
}





//electromagnetic torque estimation
float electromagnetic_torque_estimation_t_e(float psi_sD,float i_sQ, float psi_sQ,float i_sD,float pole_pairs)
{
  return ( 1.5f*pole_pairs* (psi_sD*i_sQ-psi_sQ*i_sD) );//t_e;
}



//hysteresis windows
int stator_flux_linkage_hysteresis_controller_d_psi(float psi_s_ref, float psi_s,float psi_delta_percentage)
{
  static int d_psi=0; 
  if      (psi_s<=psi_s_ref*(1.0f-psi_delta_percentage/100.0f) )
  {
    d_psi=1;
  }
  else if (psi_s>=psi_s_ref*(1.0f+psi_delta_percentage/100.0f) )
  {
    d_psi=0;
  }
  else
  {
    d_psi=d_psi;
  }
  return d_psi;
}


int electromagnetic_torque_hysteresis_controller_d_te(float te_ref, float t_e, float t_e_delta_percentage)
{
  int d_te=0;
  
  //forward rotation  
  if (te_ref>=0.0f)
  {
    if      (t_e<=te_ref*(1.0f-t_e_delta_percentage/100.0f))
    {
      d_te=1;
    }
    else if (t_e>=te_ref*(1.0f+t_e_delta_percentage/100.0f))
    {
      d_te=-1;
    }
    else
    {
      d_te=0;
    }
  }
  //clockwise rotation
  else
  {
    if (t_e<=te_ref*(1.0f+t_e_delta_percentage/100.0f))//(t_e<=te_ref*(1.0f+t_e_delta_percentage))
    {
      d_te=1;
    }
    else if (t_e>=te_ref*(1.0f-t_e_delta_percentage/100.0f))//(t_e>=te_ref*(1.0f-t_e_delta_percentage))
    {
      d_te=-1;
    }
    else 
    {
      d_te=0;
    }
  }  
  
  return d_te;
}



//output voltages

//vector voltages definition
#define V_1  *S_A=1;*S_B=0;*S_C=0; //100
#define V_2  *S_A=1;*S_B=1;*S_C=0; //110
#define V_3  *S_A=0;*S_B=1;*S_C=0; //010
#define V_4  *S_A=0;*S_B=1;*S_C=1; //011
#define V_5  *S_A=0;*S_B=0;*S_C=1; //001
#define V_6  *S_A=1;*S_B=0;*S_C=1; //101
//#define V_7  *S_A=1;*S_B=1;*S_C=1; //111
//#define V_8  *S_A=0;*S_B=0;*S_C=0; //000
//#define V_7  *S_A=2;*S_B=2;*S_C=2; //111
//#define V_8  *S_A=2;*S_B=2;*S_C=2; //000
#define V_7  *S_A=*S_A;*S_B=*S_B;*S_C=*S_C; //111
#define V_8  *S_A=*S_A;*S_B=*S_B;*S_C=*S_C; //000

void optimal_voltage_switching_vector_selection_table(int d_psi,int d_te,int alpha,int* S_A, int* S_B, int* S_C)
{

  if (d_psi==1) { if      (d_te==1) { if           (alpha==1) { V_2 optimal_voltage_vector=60; }//2;}
                                      else if      (alpha==2) { V_3 optimal_voltage_vector=120;}//3;}
                                      else if      (alpha==3) { V_4 optimal_voltage_vector=180;}//4;}
                                      else if      (alpha==4) { V_5 optimal_voltage_vector=240;}//5;}
                                      else if      (alpha==5) { V_6 optimal_voltage_vector=300;}//6;}
                                      else if      (alpha==6) { V_1 optimal_voltage_vector=0;  }//1;}
                                      else                    {     optimal_voltage_vector=9;}                      
                                    }
                  else if (d_te==0) { if           (alpha==1) { V_7 optimal_voltage_vector=7;}
                                      else if      (alpha==2) { V_8 optimal_voltage_vector=8;}
                                      else if      (alpha==3) { V_7 optimal_voltage_vector=7;}
                                      else if      (alpha==4) { V_8 optimal_voltage_vector=8;}
                                      else if      (alpha==5) { V_7 optimal_voltage_vector=7;}
                                      else if      (alpha==6) { V_8 optimal_voltage_vector=8;}
                                      else                    {     optimal_voltage_vector=14;}                      
                                    }
                  else if (d_te==-1){ if           (alpha==1) { V_6 optimal_voltage_vector=300;}//6;}
                                      else if      (alpha==2) { V_1 optimal_voltage_vector=0;  }//1;}
                                      else if      (alpha==3) { V_2 optimal_voltage_vector=60; }//2;}
                                      else if      (alpha==4) { V_3 optimal_voltage_vector=120;}//3;}
                                      else if      (alpha==5) { V_4 optimal_voltage_vector=180;}//4;}
                                      else if      (alpha==6) { V_5 optimal_voltage_vector=240;}//5;}
                                      else                    {     optimal_voltage_vector=10;}                      
                                    }
                }

  else if (d_psi==0) { 
                  if      (d_te==1) { if           (alpha==1) { V_3 optimal_voltage_vector=120;}//3;}
                                      else if      (alpha==2) { V_4 optimal_voltage_vector=180;}//4;}
                                      else if      (alpha==3) { V_5 optimal_voltage_vector=240;}//5;}
                                      else if      (alpha==4) { V_6 optimal_voltage_vector=300;}//6;}
                                      else if      (alpha==5) { V_1 optimal_voltage_vector=0;  }//1;}
                                      else if      (alpha==6) { V_2 optimal_voltage_vector=60; }//2;}
                                      else                    {     optimal_voltage_vector=11; }                      
                                    }
                  else if (d_te==0) { if           (alpha==1) { V_8 optimal_voltage_vector=8;}
                                      else if      (alpha==2) { V_7 optimal_voltage_vector=7;}
                                      else if      (alpha==3) { V_8 optimal_voltage_vector=8;}
                                      else if      (alpha==4) { V_7 optimal_voltage_vector=7;}
                                      else if      (alpha==5) { V_8 optimal_voltage_vector=8;}
                                      else if      (alpha==6) { V_7 optimal_voltage_vector=7;}
                                      else                    {     optimal_voltage_vector=12;}                      
                                    }
                  else if (d_te==-1){ if           (alpha==1) { V_5 optimal_voltage_vector=240;}//5;}
                                      else if      (alpha==2) { V_6 optimal_voltage_vector=300;}//6;}
                                      else if      (alpha==3) { V_1 optimal_voltage_vector=0;  }//1;}
                                      else if      (alpha==4) { V_2 optimal_voltage_vector=60; }//2;}
                                      else if      (alpha==5) { V_3 optimal_voltage_vector=120;}//3;}
                                      else if      (alpha==6) { V_4 optimal_voltage_vector=180;}//4;}
                                      else                    {     optimal_voltage_vector=13;}                      
                                    }
                }

}

void voltage_switch_inverter_VSI(int S_A, int S_B, int S_C)
{
  /*
  float duty_a=1.0f;
  float duty_b=1.0f;
  float duty_c=1.0f;
  float attenuation =1.0f;
  */
  close_loop=true;
  cur_angle+=2.0f*PI*TICK_PERIOD*ref_freq;
  //converting big angles into something between 0 and 2pi
  if (cur_angle >= (2.0f*PI)) {
    cur_angle=cur_angle-(2.0f*PI);
  }

//close_loop=false;

  if (!close_loop) 
  {
    duty_a=sinf(cur_angle);
    duty_b=sinf(cur_angle+2.0f*PI/3.0f);
    duty_c=sinf(cur_angle+4.0f*PI/3.0f);
  } 
  else
  {
    duty_a=1.0f;
    duty_b=1.0f;
    duty_c=1.0f;
    attenuation =1.0f;//0.5f;//1.0f;
  }

  if (motor_off) 
  {
    duty_a=0.0f;
    duty_b=0.0f;
    duty_c=0.0f;
    attenuation=1.0f;
  }



//dtc switching selection

if (close_loop)
{
  //----------------SA: S1 and S4---------------------------------
  if (S_A==1)
    {
      timer_set_oc_mode(TIM1, TIM_OC1, TIM_OCM_PWM1);
      //timer_set_oc_mode       (TIM1, TIM_OC1, TIM_OCM_FORCE_HIGH);
      timer_enable_oc_output  (TIM1, TIM_OC1 );  //S1 on
      timer_disable_oc_output (TIM1, TIM_OC1N);  //S4 off
    }

  else if (S_A==0)
    {
      timer_set_oc_mode(TIM1, TIM_OC1, TIM_OCM_PWM1);
      //timer_set_oc_mode       (TIM1, TIM_OC1, TIM_OCM_FORCE_HIGH);
      timer_disable_oc_output (TIM1, TIM_OC1);  //S1 off
      timer_enable_oc_output  (TIM1, TIM_OC1N); //S4 on
    }
  else
    {
      duty_a=0.0f;
      timer_set_oc_mode(TIM1, TIM_OC1, TIM_OCM_PWM1);
      //timer_set_oc_mode       (TIM1, TIM_OC1, TIM_OCM_FORCE_HIGH);
      timer_disable_oc_output (TIM1, TIM_OC1);  //S1 off
      timer_disable_oc_output  (TIM1, TIM_OC1N); //S4 on
    }
  //-------------SB: S3 and S6------------------------------------
  if (S_B==1)
    {
      timer_set_oc_mode(TIM1, TIM_OC2, TIM_OCM_PWM1);
      //timer_set_oc_mode(TIM1, TIM_OC2, TIM_OCM_FORCE_HIGH);
      timer_enable_oc_output(TIM1, TIM_OC2 );    //S3 on
      timer_disable_oc_output (TIM1, TIM_OC2N);  //S6 off
    }


  else if (S_B==0)
    {
      timer_set_oc_mode(TIM1, TIM_OC2, TIM_OCM_PWM1);
      //timer_set_oc_mode(TIM1, TIM_OC2, TIM_OCM_FORCE_HIGH);
      timer_disable_oc_output(TIM1, TIM_OC2 );  //S3 off
      timer_enable_oc_output (TIM1, TIM_OC2N);  //S6 on
    }
  else 
    {
      duty_b=0.0f;
      timer_set_oc_mode(TIM1, TIM_OC2, TIM_OCM_PWM1);
      //timer_set_oc_mode(TIM1, TIM_OC2, TIM_OCM_FORCE_HIGH);
      timer_disable_oc_output(TIM1, TIM_OC2 );  //S3 off
      timer_disable_oc_output (TIM1, TIM_OC2N);  //S6 on
    }
  //-----------SC: S5 and S2--------------------------------------
  if (S_C==1)
    {
      timer_set_oc_mode(TIM1, TIM_OC3, TIM_OCM_PWM1);
      //timer_set_oc_mode(TIM1, TIM_OC3, TIM_OCM_FORCE_HIGH);
      timer_enable_oc_output(TIM1, TIM_OC3 );   //S5 on
      timer_disable_oc_output (TIM1, TIM_OC3N); //S2 off
    }
  else if (S_C==0)
    {

      timer_set_oc_mode(TIM1, TIM_OC3, TIM_OCM_PWM1);
      //timer_set_oc_mode(TIM1, TIM_OC3, TIM_OCM_FORCE_HIGH);
      timer_disable_oc_output(TIM1, TIM_OC3 );  //S5 off
      timer_enable_oc_output (TIM1, TIM_OC3N);  //S2 on
    }
  else 
    {
      duty_c=0.0f;
      timer_set_oc_mode(TIM1, TIM_OC3, TIM_OCM_PWM1);
      //timer_set_oc_mode(TIM1, TIM_OC3, TIM_OCM_FORCE_HIGH);
      timer_disable_oc_output(TIM1, TIM_OC3 );  //S5 off
      timer_disable_oc_output (TIM1, TIM_OC3N);  //S2 on
    }
}




  /* Set the capture compare value for OC1. */
  timer_set_oc_value(TIM1, TIM_OC1, duty_a*attenuation*PWM_PERIOD_ARR);
  /* Set the capture compare value for OC1. */
  timer_set_oc_value(TIM1, TIM_OC2, duty_b*attenuation*PWM_PERIOD_ARR);
  /* Set the capture compare value for OC1. */
  timer_set_oc_value(TIM1, TIM_OC3, duty_c*attenuation*PWM_PERIOD_ARR);
  //tim_force_update_event(TIM1);
}



float fast_vector_angle(float y, float x)
{
  float angle;

  if      (x>=0.0f && y>=0.0f &&  x>= y) { angle =        fast_atan( y/ x); }  //1st quadrant
  else if (x>=0.0f && y>=0.0f &&  y> x)  { angle =  90.0f-fast_atan( x/ y); }  //2nd quadrant
  else if (x< 0.0f && y>=0.0f &&  y>=-x) { angle =  90.0f+fast_atan(-x/ y); }  //3rd quadrant
  else if (x< 0.0f && y>=0.0f && -x> y)  { angle = 180.0f-fast_atan( y/-x); }  //4th quadrant
  else if (x< 0.0f && y< 0.0f && -x>=-y) { angle = 180.0f+fast_atan(-y/-x); }  //5th quadrant
  else if (x< 0.0f && y< 0.0f && -y>-x)  { angle = 270.0f-fast_atan(-x/-y); }  //6th quadrant
  else if (x>=0.0f && y< 0.0f && -y>= x) { angle = 270.0f+fast_atan( x/-y); }  //7th quadrant 
  else if (x>=0.0f && y< 0.0f &&  x>-y)  { angle = 360.0f-fast_atan(-y/ x); }  //8th quadrant 
  else                                   { angle =   0.0f                 ; }

  return angle;
}


float extended_fast_atan(float tan_value)
{
    return fast_vector_angle(tan_value,1.0f); //this makes the fast_atan able to give as a result angles between -90° and 90 ° (I and II quadrants). 
                                              //Originally fast_atan could only give values between 0° and 45°
}

float A_inverse_clark_transformation(float V_sD)//(float V_sD,V_sQ)
{
	//return V_sQ;
	return V_sD;
}

float B_inverse_clark_transformation(float V_sQ, float V_sD)
{
	float V_sB;
	//V_sB=(-V_sQ+sqrtf(3.0f)*V_sD)/2.0f;
	V_sB=(-V_sD+sqrtf(3.0f)*V_sQ)/2.0f;
	return V_sB;
}

float C_inverse_clark_transformation(float V_sQ, float V_sD)
{
	float V_sC;
	//V_sC=(-V_sQ-sqrtf(3.0f)*V_sD)/2.0f;
	V_sC=(-V_sD-sqrtf(3.0f)*V_sQ)/2.0f;
	return V_sC;
}
//-------------------------------------------------------------------------------
//necesita refinarse porque no considera el cuadrante donde se encuentra el vector absoluto del estator, 
//ni tampoco que la diferencia entre A, B y C es de 120°
float duty_cycle_to_angle(float duty_cycle)
{
	float angle;
	angle=180.0f/PI*asinf(duty_cycle);

	if (angle>=360.0f)
		angle=angle-360.0f;
	else if (angle<0.0f)
		angle=angle+360.0f;

	return angle;
}
//-------------------------------------------------------------------------------

float phase_A_angle_to_stator_angle(float phase_A_angle)
{
	float stator_angle;
	stator_angle=451.0f-phase_A_angle;

	if (stator_angle>=360.0f)
		stator_angle=stator_angle-360.0f;
	else if (stator_angle<0.0f)
		stator_angle=stator_angle+360.0f;
	
	return stator_angle;	
}

float stator_angle_to_phase_A(float stator_angle)
{
	float phase_A;
	phase_A=450-stator_angle;
	
	if (phase_A>=360.0f)
		phase_A=phase_A-360.0f;
	else if (phase_A<0.0f)
		phase_A=phase_A+360.0f;

	return phase_A;	
}




#define P_DTC 0.01f//0.000028f
#define I_DTC 1.0f
float DTC_torque_reference_PI(float w, float w_ref)
{
  float te_error=0.0f;
  float te_ref  =0.0f;

  te_error=w_ref-w;

  te_ref=-P_DTC*te_error;
  
  return te_ref;

}
