arcoslab/open-coroco-legacy/src_stiffness_controller/Trigonometric_Functions/cos_table.h

/*
 *This file is part of the open-coroco project.
 *
 *  Copyright (C) 2013  Sebastian Chinchilla Gutierrez <tumacher@gmail.com>
 *
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
 *  You should have received a copy of the GNU General Public License
 *  along with this program.  If not, see <http://www.gnu.org/licenses/>.
 */
#define COS_TABLE_SIZE 3600
#define COS_TABLE_SIZE_F 3600.0f

/*
float cos_table [COS_TABLE_SIZE] =  
{
1.0f,
0.9999984769f,
0.9999939077f,
0.9999862922f,
0.9999756307f,
0.9999619231f,
0.9999451694f,
0.9999253697f,
0.999902524f,
0.9998766325f,
0.9998476952f,
0.9998157121f,
0.9997806835f,
0.9997426093f,
0.9997014898f,
0.999657325f,
0.999610115f,
0.9995598601f,
0.9995065604f,
0.9994502159f,
0.999390827f,
0.9993283938f,
0.9992629164f,
0.9991943951f,
0.9991228301f,
0.9990482216f,
0.9989705698f,
0.998889875f,
0.9988061373f,
0.9987193572f,
0.9986295348f,
0.9985366703f,
0.9984407642f,
0.9983418166f,
0.9982398279f,
0.9981347984f,
0.9980267284f,
0.9979156183f,
0.9978014683f,
0.9976842788f,
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
};
*/
