arcoslab/open-coroco-legacy/src/set_up.c

/*
 *This file is part of the open-coroco project.
 *
 *  Copyright (C) 2013  Sebastian Chinchilla Gutierrez <tumacher@gmail.com>
 *
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
 *  You should have received a copy of the GNU General Public License
 *  along with this program.  If not, see <http://www.gnu.org/licenses/>.
 */


void clock_setup(void)
{
	rcc_clock_setup_hse_3v3(&hse_8mhz_3v3[CLOCK_3V3_168MHZ]);
}

void gpio_LED_set_up(void)
{
	/* Enable GPIOC clock. */
	rcc_peripheral_enable_clock(&RCC_AHB1ENR, RCC_AHB1ENR_IOPDEN);		

	/* Set GPIOs (in GPIO port D) to 'output push-pull'. */
	gpio_mode_setup(GPIOD, GPIO_MODE_OUTPUT,GPIO_PUPD_NONE, GPIO12);	//	green LED 
	gpio_mode_setup(GPIOD, GPIO_MODE_OUTPUT,GPIO_PUPD_NONE, GPIO13);	//	orange led	
	gpio_mode_setup(GPIOD, GPIO_MODE_OUTPUT,GPIO_PUPD_NONE, GPIO14);	//	red led
	gpio_mode_setup(GPIOD, GPIO_MODE_OUTPUT,GPIO_PUPD_NONE, GPIO15);	//	blue led
}

void gpio_digital_hall_sensors_set_up(void)
{
	/* Enable GPIOB and GPIOE clock. */
	rcc_peripheral_enable_clock(&RCC_AHB1ENR, RCC_AHB1ENR_IOPBEN);		
	rcc_peripheral_enable_clock(&RCC_AHB1ENR, RCC_AHB1ENR_IOPEEN);

	/* Set GPIO to 'input open-drain'. */

	//Hall sensor 1 
	gpio_mode_setup(GPIOE, GPIO_MODE_INPUT, GPIO_PUPD_NONE, GPIO15);		
	gpio_set_af(GPIOE, GPIO_AF0, GPIO15);	

	//Hall sensor 2 
	gpio_mode_setup(GPIOB, GPIO_MODE_INPUT, GPIO_PUPD_NONE, GPIO11);		
	gpio_set_af(GPIOB, GPIO_AF0, GPIO11);	

	//Hall sensor 3 
	gpio_mode_setup(GPIOB, GPIO_MODE_INPUT, GPIO_PUPD_NONE, GPIO13);		
	gpio_set_af(GPIOB, GPIO_AF0, GPIO13);	


}

void exti_button_setup(void)
{
	/* Enable GPIOA clock. */
	rcc_peripheral_enable_clock(&RCC_AHB1ENR, RCC_AHB1ENR_IOPAEN);		

	/* Enable EXTI0 interrupt. */
	nvic_enable_irq(NVIC_EXTI0_IRQ);

	/*enable update interrupt*/
	nvic_enable_irq(NVIC_TIM1_UP_TIM10_IRQ);

	/* Set GPIO0 (in GPIO port A) to 'input open-drain'. */
	gpio_mode_setup(GPIOA, GPIO_MODE_INPUT, GPIO_PUPD_NONE, GPIO0);		//f4 user button still at PA0 
	gpio_set_af(GPIOA, GPIO_AF0, GPIO0);	

	/* Configure the EXTI subsystem. */
	exti_select_source(EXTI0, GPIOA);
	exti_direction = FALLING;
	exti_set_trigger(EXTI0, EXTI_TRIGGER_FALLING);
	exti_enable_request(EXTI0);
}


void tim_setup(void)
{
	/* Enable TIM1 clock. */
	rcc_peripheral_enable_clock(&RCC_APB2ENR, RCC_APB2ENR_TIM1EN);  //F4 clock for TIM 1 is APB2. TIM1 port is E
	
	/*Enable AF clock*/
	rcc_peripheral_enable_clock(&RCC_AHB1ENR, RCC_AHB1ENR_IOPEEN);

	/*
	 * Set TIM1 channel output pins to
	 * 'output alternate function push-pull'.
	 */
	gpio_mode_setup(GPIOE, GPIO_MODE_AF,GPIO_PUPD_NONE,GPIO9 | GPIO11 | GPIO13);	//f4 TIM1=> GIO9: CH1, GPIO11: CH2, GPIO13: CH3
	
	/*TIM1 CH1, CH2 and CH3 as alternate functions*/
	gpio_set_af(GPIOE, GPIO_AF1, GPIO9 | GPIO11 | GPIO13);	//f4 AF1 means TIM1/TIM2. From PE8 to PE15 AF is for TIM1

	/*
	 * Set TIM1 complementary channel output pins to
	 * 'output alternate function push-pull'.
	 */
	gpio_mode_setup(GPIOE, GPIO_MODE_AF,GPIO_PUPD_NONE,GPIO8 | GPIO10 | GPIO12);	//f4 TIM1=> GIO8: CH1N, GPIO10: CH2N, GPIO12: CH3N
	/*TIM1 CH1N, CH2N and CH3N as alternate functions*/
	gpio_set_af(GPIOE, GPIO_AF1, GPIO8 | GPIO10 | GPIO12);	//f4 AF1 means TIM1/TIM2. From PE8 to PE15 AF is for TIM1

	/* Enable TIM1 commutation interrupt. */
	nvic_enable_irq(NVIC_TIM1_TRG_COM_TIM11_IRQ);	//f4



	/* Reset TIM1 peripheral. */
	timer_reset(TIM1);

	/* Timer global mode:
	 * - No divider
	 * - Alignment edge
	 * - Direction up
	 */
	timer_set_mode(TIM1, TIM_CR1_CKD_CK_INT,
		       TIM_CR1_CMS_CENTER_3,	//TIM_CR1_CMS_EDGE 
						//TIM_CR1_CMS_CENTER_1 
						//TIM_CR1_CMS_CENTER_2 
						//TIM_CR1_CMS_CENTER_3 la frequencia del pwm se divide a la mitad.
			 TIM_CR1_DIR_UP);

	/* Reset prescaler value. */
	timer_set_prescaler(TIM1, prescale);

	/* Reset repetition counter value. */
	timer_set_repetition_counter(TIM1, repetition_counter_value);

	/* Enable preload. */
	timer_enable_preload(TIM1);

	/* Continuous mode. */
	timer_continuous_mode(TIM1);

	/* Period (32kHz). */
	timer_set_period(TIM1,pwm_period_ARR);


	/* Configure break and deadtime. */
	timer_set_deadtime(TIM1, deadtime_percentage*pwm_period_ARR);
	timer_set_enabled_off_state_in_idle_mode(TIM1);
	timer_set_enabled_off_state_in_run_mode(TIM1);
	timer_disable_break(TIM1);
	timer_set_break_polarity_high(TIM1);
	timer_disable_break_automatic_output(TIM1);
	timer_set_break_lock(TIM1, TIM_BDTR_LOCK_OFF);

	/* -- OC1 and OC1N configuration -- */

	/* Disable outputs. */
	timer_disable_oc_output(TIM1, TIM_OC1);
	timer_disable_oc_output(TIM1, TIM_OC1N);

	/* Configure global mode of line 1. */
	timer_disable_oc_clear(TIM1, TIM_OC1);
	timer_enable_oc_preload(TIM1, TIM_OC1);
	timer_set_oc_slow_mode(TIM1, TIM_OC1);
	timer_set_oc_mode(TIM1, TIM_OC1, TIM_OCM_PWM1);

	/* Configure OC1. */
	timer_set_oc_polarity_high(TIM1, TIM_OC1);
	timer_set_oc_idle_state_set(TIM1, TIM_OC1);

	/* Configure OC1N. */
	timer_set_oc_polarity_high(TIM1, TIM_OC1N);
	timer_set_oc_idle_state_set(TIM1, TIM_OC1N);

	/* Set the capture compare value for OC1. */
	timer_set_oc_value(TIM1, TIM_OC1, 1000);//initial_duty_cycle*pwm_period_ARR);

	/* Reenable outputs. */
	timer_enable_oc_output(TIM1, TIM_OC1);
	timer_enable_oc_output(TIM1, TIM_OC1N);

	/* -- OC2 and OC2N configuration -- */

	/* Disable outputs. */
	timer_disable_oc_output(TIM1, TIM_OC2);
	timer_disable_oc_output(TIM1, TIM_OC2N);

	/* Configure global mode of line 2. */
	timer_disable_oc_clear(TIM1, TIM_OC2);
	timer_enable_oc_preload(TIM1, TIM_OC2);
	timer_set_oc_slow_mode(TIM1, TIM_OC2);
	timer_set_oc_mode(TIM1, TIM_OC2, TIM_OCM_PWM1);

	/* Configure OC2. */
	timer_set_oc_polarity_high(TIM1, TIM_OC2);
	timer_set_oc_idle_state_set(TIM1, TIM_OC2);

	/* Configure OC2N. */
	timer_set_oc_polarity_high(TIM1, TIM_OC2N);
	timer_set_oc_idle_state_set(TIM1, TIM_OC2N);

	/* Set the capture compare value for OC2. */
	timer_set_oc_value(TIM1, TIM_OC2, 1000);//initial_duty_cycle*pwm_period_ARR);

	/* Reenable outputs. */
	timer_enable_oc_output(TIM1, TIM_OC2);
	timer_enable_oc_output(TIM1, TIM_OC2N);

	/* -- OC3 and OC3N configuration -- */

	/* Disable outputs. */
	timer_disable_oc_output(TIM1, TIM_OC3);
	timer_disable_oc_output(TIM1, TIM_OC3N);

	/* Configure global mode of line 3. */
	timer_disable_oc_clear(TIM1, TIM_OC3);
	timer_enable_oc_preload(TIM1, TIM_OC3);
	timer_set_oc_slow_mode(TIM1, TIM_OC3);
	timer_set_oc_mode(TIM1, TIM_OC3, TIM_OCM_PWM1);

	/* Configure OC3. */
	timer_set_oc_polarity_high(TIM1, TIM_OC3);
	timer_set_oc_idle_state_set(TIM1, TIM_OC3);

	/* Configure OC3N. */
	timer_set_oc_polarity_high(TIM1, TIM_OC3N);
	timer_set_oc_idle_state_set(TIM1, TIM_OC3N);

	/* Set the capture compare value for OC3. */
	timer_set_oc_value(TIM1, TIM_OC3, 1000);//initial_duty_cycle*pwm_period_ARR);//100);

	/* Reenable outputs. */
	timer_enable_oc_output(TIM1, TIM_OC3);
	timer_enable_oc_output(TIM1, TIM_OC3N);

	/* ---- */

	/* ARR reload enable. */
	timer_enable_preload(TIM1);

	/*
	 * Enable preload of complementary channel configurations and
	 * update on COM event.
	 */
	//timer_enable_preload_complementry_enable_bits(TIM1);
	timer_disable_preload_complementry_enable_bits(TIM1);

	/* Enable outputs in the break subsystem. */
	timer_enable_break_main_output(TIM1);

	/* Counter enable. */
	timer_enable_counter(TIM1);

	/* Enable commutation interrupt. */
	timer_enable_irq(TIM1, TIM_DIER_COMIE);



	



	/*********/
	/*Capture compare interrupt*/
	
	//enable capture compare interrupt 
	//timer_enable_update_event(TIM1);

	/* Enable commutation interrupt. */
	//timer_enable_irq(TIM1, TIM_DIER_CC1IE);	//Capture/compare 1 interrupt enable
	/* Enable commutation interrupt. */
	timer_enable_irq(TIM1, TIM_DIER_CC1IE);
	nvic_enable_irq(NVIC_TIM1_CC_IRQ);

}

/*
void mortal_adc (void)
{

rcc_peripheral_enable_clock(&RCC_APB2ENR, RCC_APB2ENR_ADC1EN);

gpio_mode_setup(GPIOA, GPIO_MODE_ANALOG, GPIO_PUPD_NONE, GPIO1);	//PA1
gpio_mode_setup(GPIOA, GPIO_MODE_ANALOG, GPIO_PUPD_NONE, GPIO3);	//PA3
gpio_mode_setup(GPIOA, GPIO_MODE_ANALOG, GPIO_PUPD_NONE, GPIO5);	//PA5


//gpio_mode_setup(GPIOA, GPIO_MODE_ANALOG, GPIO_PUPD_NONE, GPIO2);	//PA2
//gpio_mode_setup(GPIOA, GPIO_MODE_ANALOG, GPIO_PUPD_NONE, GPIO7);	//PA7
//gpio_mode_setup(GPIOA, GPIO_MODE_ANALOG, GPIO_PUPD_NONE, GPIO4);	//PA4
//gpio_mode_setup(GPIOA, GPIO_MODE_ANALOG, GPIO_PUPD_NONE, GPIO6);	//PA6

rcc_peripheral_enable_clock(&RCC_AHB1ENR, RCC_AHB1ENR_IOPAEN);

adc_set_clk_prescale(ADC_CCR_ADCPRE_BY2);
adc_disable_scan_mode(ADC1);
adc_set_single_conversion_mode(ADC1);
adc_set_sample_time(ADC1, ADC_CHANNEL1, ADC_SMPR1_SMP_1DOT5CYC);
adc_set_sample_time(ADC1, ADC_CHANNEL3, ADC_SMPR1_SMP_1DOT5CYC);
adc_set_sample_time(ADC1, ADC_CHANNEL5, ADC_SMPR1_SMP_1DOT5CYC);
//u8 channels[16];
//channels[0] = ADC_CHANNEL1;
//adc_set_regular_sequence(ADC1, 16, channels);

adc_set_multi_mode(ADC_CCR_MULTI_INDEPENDENT);
adc_power_on(ADC1);
}
*/

void usart_setup(void)
{
	/* Enable GPIOD clock for LED & USARTs. */
	rcc_peripheral_enable_clock(&RCC_AHB1ENR, RCC_AHB1ENR_IOPAEN);

	/* Enable clocks for USART2. */
	rcc_peripheral_enable_clock(&RCC_APB1ENR, RCC_APB1ENR_USART2EN);
	/* Setup USART2 parameters. */
	usart_set_baudrate(USART2,115200);
	usart_set_databits(USART2, 8);
	usart_set_stopbits(USART2, USART_STOPBITS_1);
	usart_set_mode(USART2, USART_MODE_TX_RX);// USART_MODE_TX);
	usart_set_parity(USART2, USART_PARITY_NONE);
	usart_set_flow_control(USART2, USART_FLOWCONTROL_NONE);

	/* Finally enable the USART. */
	usart_enable(USART2);

	/* Setup GPIO pins for USART2 transmit. */
	gpio_mode_setup(GPIOA, GPIO_MODE_AF, GPIO_PUPD_NONE, GPIO2);

	/* Setup GPIO pins for USART2 receive. */
	gpio_mode_setup(GPIOA, GPIO_MODE_AF, GPIO_PUPD_NONE, GPIO3);

	/* Setup USART2 TX pin as alternate function. */
	gpio_set_af(GPIOA, GPIO_AF7, GPIO2);

	/* Setup USART2 TX pin as alternate function. */
	gpio_set_af(GPIOA, GPIO_AF7, GPIO3);
}


void stm32_setup()
{
	clock_setup();
	gpio_LED_set_up();
	gpio_digital_hall_sensors_set_up();
	tim_setup();
	exti_button_setup();
	//exti1_setup;
	//mortal_adc();
	usart_setup();

}
