arcoslab/open-coroco-legacy/src_DTC-SVM_FixedPoint/baldor_control_utils/test_1.py

#!/usr/bin/env python

#importing libraries
#import yarp     as y
import serial   as s
from serial import SerialException
from numpy  import pi
from time   import sleep
import sys

'''
#-----------------yarp connection----------------------------------

#starting yarp network
y.Network.init()


#creting output port
stm32_1_output_port_1=y.BufferedPortBottle()
stm32_1_output_port_1_name="/stm32_1/position/out1"
stm32_1_output_port_1.open(stm32_1_output_port_1_name)

#creating an input port
stm32_1_input_port_1        =y.BufferedPortBottle()
stm32_1_input_port_1_name   ="/stm32_1/position/in1"
stm32_1_input_port_1.open(stm32_1_input_port_1_name)



#creating an input port from PS3 controller
stm32_1_input_port_speed_1        =y.BufferedPortBottle()
stm32_1_input_port_speed_1_name   ="/stm32_1/speed/in_1"
stm32_1_input_port_speed_1.open(stm32_1_input_port_speed_1_name)




#connecting with remote port STM32_2
style=y.ContactStyle()
style.persistent=1
stm32_2_input_port_1_name="/stm32_2/position/in1"
stm32_3_input_port_1_name="/stm32_3/position/in1"
stm32_4_input_port_1_name="/stm32_4/position/in1"
y.Network.connect(stm32_1_output_port_1_name,stm32_2_input_port_1_name,style)
y.Network.connect(stm32_1_output_port_1_name,stm32_3_input_port_1_name,style)
y.Network.connect(stm32_1_output_port_1_name,stm32_4_input_port_1_name,style)
'''

#------------------Initial values -----------------

#for speeds and postition calculations
max_speed=12*2*pi
last_raw_angle=0.
raw_angle=0.
angle=0.
rads=0.

value=33
cmd_speed=0.0

#for serial port
stm32_position='0'
serial_device_counter=0
connected=False
while_interation = 0;
avoid_loop = False
pause = 0


while True:
    
    #------------Connecting to the serial port---------------------
    
    #initial connection
    while not connected:
        try:
            #serial_device_counter=3;
            com=s.Serial("/dev/ttyACM"+str(serial_device_counter), baudrate=921600,timeout=1)
            print "Connecting to /dev/ttyACM"+str(serial_device_counter)
        except:
            
            if (serial_device_counter>100):
              serial_device_counter=0
            print "Connect opencoroco usb cable, trying: /dev/ttyACM"+str(serial_device_counter)  
            print "stm32_position: " + stm32_position     
            serial_device_counter=serial_device_counter+1  
        else:
            connected=True
            print "Connected to /dev/ttyACM"+str(serial_device_counter) 
            #print "stm32_position: " + stm32_position
 
   
 
   
 


    #-----------------------------
    try:
   
        while connected==True:

            #waiting for data from stm32 serial port
            while com.inWaiting()>0:
                com.read(com.inWaiting())
                print "waiting"  
            
            #writing data from stm32
            com.write("f "+str(cmd_speed)+"\n\r")
            print "writing to stm32: "+ str(cmd_speed)+"original_value: "+str(value)+"test: "
            print "Connected to /dev/ttyACM"+str(serial_device_counter)   

            #reading data from stm32
            line=com.readline() 
            print "line_from_stm: ",line 
            #line_split=line.split()
            #stm32_1_position=line_split[0]
            #print "stm32_position: " + stm32_1_position
            while_interation = while_interation + 1;

            if(not avoid_loop):
                if(while_interation==5):
                    while_interation = 0;
                    print "Press '9' to exit,'a' to avoid loop or anything else to continue"
                    pause = raw_input()
                    if (pause == '9'):
                        sys.exit("User wanted to exit")
                    if (pause == 'a'):
                        avoid_loop = True
            '''          
            #-----------connected to STM32 1----------
            if stm32_1_position=='1':

                #-------------------Communication though yarp bottles-----------
                sleep(0.01)

                #sending a bottle with stm32_1 position
                stm32_1_output_bottle_1=stm32_1_output_port_1.prepare()
                stm32_1_output_bottle_1.clear()
                stm32_1_output_bottle_1.addString(stm32_1_position)
                stm32_1_output_bottle_1.addInt(serial_device_counter)                
                stm32_1_output_port_1.write()


                #receiving a bottle from stm32_2
                stm32_1_input_bottle_1=stm32_1_input_port_1.read(False)
                if stm32_1_input_bottle_1:
                    stm32_1_input_data_1=stm32_1_input_bottle_1.get(0)
                    stm32_2_position=stm32_1_input_data_1.asString()
                    print "there is a bottle from ",stm32_2_input_port_1_name
                    print "bottle content: ",stm32_2_position
                    
                else:
                    print "there is no bottle from ",stm32_2_input_port_1_name    


                #receiving a bottle from PS3 controller
                stm32_1_input_bottle_speed_1=stm32_1_input_port_speed_1.read(False)
                if stm32_1_input_bottle_speed_1:
                    stm32_1_input_data_speed_1=stm32_1_input_bottle_speed_1.get(0)
                    speed_1_value=stm32_1_input_data_speed_1.asDouble()
                    cmd_speed=speed_1_value
                    print "there is a bottle from ",stm32_1_input_port_speed_1_name
                    print "bottle content: ",speed_1_value
                    
                else:
                    print "there is no bottle from ",stm32_1_input_port_speed_1_name   

            #---------not connected to STM32 1----------------
            else:
                connected=False
                print "wrong stm32, detected: ",stm32_1_position
                stm32_1_position='0'
                serial_device_counter=serial_device_counter+1
            '''

    except SerialException:
        #com.close()
        #del com
        print com.inWaiting()
        print "error! error!"
        #print line
        connected=False  
