arcoslab/open-coroco-legacy/src_DTC-SVM_FixedPoint/baldor_control_utils/baldor_control.py

#!/usr/bin/env python

wheel_diameter=5.95 #inches

import yarp as y
import serial as s
from numpy import pi
from time import sleep

y.Network.init()
port=y.BufferedPortBottle()
portname="/coroco/baldor/in"
port.open(portname)
portout=y.BufferedPortBottle()
portnameout="/coroco/baldor/out"
portout.open(portnameout)


max_speed=12*2*pi
last_raw_angle=0.
raw_angle=0.
angle=0.
rads=0.


while True:
    connected=False
    while not connected:
        try:
            com=s.Serial("/dev/ttyACM0", baudrate=921600)
        except:
            print "Connect opencoroco usb cable"
        else:
            connected=True
        sleep(0.1)
    while com.inWaiting()>0:
        com.read(com.inWaiting())
    try:
        while True:
            bottle=port.read(False)
            if bottle:
                yvalue=bottle.get(0)
                value=yvalue.asDouble()
                cmd_speed=value*max_speed
                #print "cmd_speed: ", cmd_speed
                com.write("f "+str(cmd_speed)+"\n\r")
                line=com.readline()
                #line=com.read(com.inWaiting())
                #print "Coroco line: ", line
                line_split=line.split()
                est_freq=float(line_split[1])
                last_raw_angle=float(raw_angle)
                raw_angle=int(line_split[3])
                if last_raw_angle>(2**16-2**13) and raw_angle<(2**13):
                    last_raw_angle-=2**16
                if raw_angle>(2**16-2**13) and last_raw_angle<(2**13):
                    last_raw_angle+=2**16
                angle+=raw_angle-last_raw_angle
                rads=angle*2*pi/2**16
                odometry=rads*((wheel_diameter*0.0254)/2.0)

                bottleout=portout.prepare()
                bottleout.clear()
                bottleout.addDouble(odometry)
                portout.write(True)

                print "raw angle: ", raw_angle, " rads: ", rads, " odometry: ", odometry , " est_freq: ", est_freq
            #while com.inWaiting()>0:
            #    print "Reading stuff", com.inWaiting()
            #    com.read(com.inWaiting())
            #print
            #sleep(1)
    except:
        com.close()
        del com

port.close()
y.Network.fini()
