arcoslab/open-coroco-legacy/(commit log)

2013-04-15 ADC no longer used for hall-sensor measuring. Using GPIO digital value instead.
    [control_loops.c, hall_sensors.c, interrupt_handler.c, pwm_6step_experiment.c, set_up.c, timer_2.c]
2013-04-16 Semi-functional speed PID.
2013-04-17 Testing motor default offset due to Hall-sensor misplacement.
2013-04-18 List of allowed I/O with their correnponding AF0 and position on the board.
    [IO - STM32F4Discovery.ods]
2013-04-21 .gitignore update
    [IO - STM32F4Discovery.ods]
2013-04-24 Stator Voltage vector, direct and quadrature voltage vectors added.
2013-04-29 Closed loop enabled. Zero offset, just Stator frequency=Rotor frecuency
2013-04-30 Close loop working from 30Hz to 120 Hz. Starting open loop rather slow.
2013-05-02 Open loop functional. Closed loop not completed yet.
    [IO - STM32F4Discovery.ods]
2013-06-06 Hall sensor is read
2013-06-06 some hall sensor calculations
2013-06-07 Print of new reference freq fixed
    [cdcacm_example.c]
2013-06-07 Added attenuation adjustment (based on current angle advance), and some other minor fixes
    [cdcacm_example.c]
2013-06-07 Motor start up rutine now part of control loop
2013-06-07 Now we use openocd, it works better, it reset after and before programming
    [cdcacm_example.c]
2013-06-09 Now with the usb transmit problem semi-solved
    [cdcacm_example.c]
2013-06-09 Motor stops and goes, interactive input to set ref_freq some general adjustments
2013-06-09 Motor stops and goes from 0 to any speed and from any speed to 0 from keyboard commands
2013-06-09 Code a bit organized. .h files for different motors.
2013-07-23 Adding first DTC code attempt and ADC interrupts.
2013-07-23 ADC tripple interruptions enabled.
2013-07-23 Voltage and current directand quadrature components, magnitud and angle added.
2013-08-13 DTC hysteresis controllers and optimum voltage switching vector controller added.
2013-08-14 Parameter identification functions added. Stator resistance and permanent magnet flux-linkage values added (calculated manually).
2013-08-24 Multi-rotor parameters added (stator resistance, rotor flux-linkage and stator resistance).
2013-08-24 ADC stator currents code added. Estimated values for shunt resistors added.
2013-08-30 ntm and multi-rotor parameters were updated (stator resistance,motor inductances, shunt resistances and flux-linkages).
2013-09-09 Values of resistancies and gains of the amp ops and the differential amplifiers have been added.
2013-09-10 Current and voltage collecting functions added and enabled. Test pins for debugging added. For speeds below 100Hz the voltage measure is not what it was expected yet.
2013-09-11 -Code for manually measuring the Lq and Ld inductances has been added (physically cables have to be connected accordingly). -Final parameters for the motor-drive and ntm-propdrive motors, shunt resis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
2013-09-12 DTC enabled. Debugging varibles for printinf in main function have been added.
2013-09-16 Low pass filter has been added to the open-loop integrator in order to cancel the flux-linkage drift. Now the Flux-linkage is centered around the origin. Test were done with a 100% duty cycle, no sta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
    [DTC.c, DTC_example.c, PID.c, interrupts.c, ntm_28-30_propdrive.h, shunt.c]
2014-02-15 Open-loop intetgrator drift has been fixed using a low pass filter with w_cutoff=200. Electromagnetic torque and flux-linkage reference can be now calculated.
    [DTC.c, DTC_example.c, interrupts.c]
2014-02-15 Print functions and variables have been adapted to debug the DTC algorithm.
2014-02-15 First attempt to move the motor with no PID controller and just the DTC code. The motor does rotate but vibration and noise is present.
    [DTC.c, DTC_example.c, PID.c, initial_setup.c, interrupts.c, pwm-related_timer_configuration.h]
2014-02-15 The DTC inverter block was disabled, now the PID controller is generating again the signals for debugging the flux-linkage and torque estimators functions.
2014-02-15 Flux linkage angle is not taken from the actual measures but from the hall sensor angle instead. This is inteanded to find out wheter or not the calculated psi_angle is numerically wrong. PID is stil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
    [DTC.c, DTC.h, DTC_example.c, interrupts.c]
2014-02-15 Torque direction fixed. It was positive when it had to be negative because both differntial amplifiers had the inputs inverted. Now the torque is negative whe the motor spins clock-wise as it should.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
    [DTC.c, DTC_example.c, PID.c, interrupts.c]
2014-02-15 This src is intended to continue the DTC debbuging. The src_test_DTC was used for testing the DTC estimations with the PID controller.
2014-02-15 DTC_timer_init function sets the pwm in edge_aligned instead of center_aligned. This allows to duplicate the speed and have an actual value of the voltage every cycle.
2014-02-15 DTC output voltage vector were disabled for testing the open loop starting.
2014-02-15 DTC somehow working (high current values ~10A). Motor starting is done by an open loop sinusoidal wave and still the hall sensor for corroborating the speed value.
2014-02-15 Saving before modifying the code for limiting the current by software.
2014-02-15 DTC is working, but it is not stable yet. Having a PID based on Hallsensor speed, with a Kp of 0.01, and hysteresis bands of 0.05% for the flux and 0.8 for the torque, a constant speed of 219.18 is o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
2014-02-15 Limitation for maximum current has been added. When any phases surpases 15 A the motor is suddenly stopped by setting the duty cycles to 0. Also, the startup function has been disabled in order to le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
2014-02-15 Debugging DTC. When DTC torque reference is inverted the torque still bounces between positive and negative. Apart from that, It has been enabled a print option that prints most of the important vari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
    [DTC.c, DTC_example.c, PID.c, interrupts.c, multi-rotor-530kv.h, ntm_28-30_propdrive.h]
2014-02-15 Flux-linkage of the permanent magnet was miscalculated. It still neede to be divided by PI. Now the values are psi_F=0.0016 for the Motordrive, and 0.0014 for the ntmprovedrive. Also, the hysteresys 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
2014-02-15 Simple DTC cannot be used because it requires at least 40kHz just to operate properly. Otherwise the torque value gets unstable, oscillating between positive and negative values. The solution for suc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
    [DTC.c, PID.c, interrupts.c, multi-rotor-530kv.h]
2014-02-15 Prototype functions and functions for the SVM libraries have been created. They have not been checked yet.
2014-02-15 SVM functions have been check and corrected. Duty cycles are now properly selected. Next step will be rotating the motor with DTC and SVM together.
    [DTC.c, DTC.h, SVM.c, SVM.h, example.c, interrupts.c]
2014-02-15 SVM disabled. PWM Frequency was set to 6kHz in order to allow the code to be ran in one cycle. More data_ variables were added for collecting the SVM variables. It is advisable not to overload the fl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
    [PID.c, SVM.c, SVM.h, example.c, interrupts.c, pwm-related_timer_configuration.h]
2014-02-15 Print routine for printing the SVM values has been enabled.
2014-02-15 Attenuation for smooth operation was determined to be 0.3 based on the value used by the original PID controller. I was using 1.0, which was kind of too much.
    [PID.c, SVM.c, example.c, interrupts.c, pwm-related_timer_configuration.h]
2014-02-15 SVM functional. For now it can make the motor ratate as fast as 30Hz using just 30% voltage attenuation. The speed calculated by the sensorless estimator coincides with the one given by the hall sens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
2014-02-15 Se copió el contenido de src1 a src1_openloop para modificar el funcionamiento a lazo cerrado.
2014-02-15 Sensorless PID function has been created for calculating the appropriate angle that is required for rotating the magnetic flux, and thus the motor. It is based on Federico's hall-sensorPI controller,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
2014-02-15 The Open loop code based on DTC-SVM has been tested and completed. Using a constant attenuation of 0.2, the motor can spin from 30Hz to 120 Hz. The 30Hz value was the best value for fast startup.
2014-02-15 Full open loop rotating of the motor using the DTC-SVM code has been impleted. A small finite state machine has been added for allowing a open loop start up and a close loop regular operation. The cl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
2014-02-15 Testing the P and I constants for the sensorless PI controller.
2014-02-15 sensorless PI controller working with just P constant. Features achieved: close loop starting and normal operation, clock-wise and counter- clock rotation, stop function.
2014-02-15 Close-loop DTC-SVM has been tested on the ntm. Also the attenuation of the pwm has been set to 0 when off and 1 when on. The real attenuation for the voltage is decided by the SVM code when it calcul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
2014-02-15 The P motor is being sintonized and the pi_control limits are been checked. For now the code is working.
2014-02-15 PI for the sensorless controller has been somehow sintonized. It is still not the ideal.
2014-02-15 Sensorless PID controller was left with a P=0.0021*600.0f/interrupt_frequency and I=0. I constant makes the controller to bounce and have a permanent error.
    [example.c, initial_setup.c, multi-rotor-530kv.h, sensorless_PID.c]
2014-02-15 Changing wrongly set sqrt functions to sqrts functions. The first one takes longer.
    [DTC.c, PID.c, SVM.c, interrupts.c]
2014-02-15 Sinf and cosf have been replaced for Look-up tables. Now they are faster. The atanf is still under testing.
    [DTC.c, SVM.c, Trigonometric_Functions.h, cos_table.h, example.c, interrupts.c, multi-rotor-530kv.h]
2014-02-15 Look-up tables for the sine, cosine, atan and vector angle have been implemented and tested. Although they work correctly and fast, the table size needs to increased so that the resulting angles and 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
    [DTC.c, Trigonometric_Functions.h, cos_table.h, example.c, interrupts.c]
2014-02-15 The protobard burned with the 10A that ran through the three-phace bridge. It now has been replaced with a soldered breadboard an now the tests are run in it. The problem right now is that the shunt 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
    Now that we have a soldered and fixed version of the bridge the tests for increasing the frequency have been executed. The error encountered was that the fast_cos and fast_sine were programmed to work with degrees but they had as input radians. Due to that the magnetic flux had some sort of poligonal form instead of a circle. When the inputs were changed to angles in degrees the motor work as it shoul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
    [PID.c, SVM.c, example.c, interrupts.c, sensorless_PID.c]
2014-02-15 DTC-SVM working at 30kHz center aligned before dividing the code (30khz interruptions, 15kHz sinusoidal waves).
2014-02-15 The deadtime has been disabled in the code due to the decreasing in the swithing time of the transistor. It was achieved reducing the gate resistances from 1000Ohms to 36Ohms. Now the voltage waves a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
    # Please enter the commit message for your changes. Lines starting
2014-02-15 Maximum input voltage has been reduced to 0.7*U_d so that the motor does not consume too much current, thus avoiding burning the protorboard. The proportional was left as 0.00001f and now the motor r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
    [SVM.c, Trigonometric_Functions.h, sensorless_PID.c]
2014-02-15 Sine table has been split to just a fourth of its degrees (from 0 to 90°) but keeping the same amount of memory space (3600 values, but 14400 effective due to the four sectors split). The same goes f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
    [Trigonometric_Functions.h, example.c]
2014-02-15 The sensorless speed controller is working up to 200Hz. The difference between the hall sensor and sensorless frequency was due to having divided the calculus from 1 to 2 cycles, so now the TICK_PERI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
    [PID.c, SVM.c, example.c, interrupts.c, sensorless_PID.c, sensorless_PID.h]
2014-02-15 sensorless PID torque controller has been programmed and tested. It is not woking properly yet. Below 1Nm the motor rotates at a relatively constante pace, but above 1.3 it starts accelerationg so fa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
    [PID.c, SVM.c, SVM.h, example.c, pwm-related_timer_configuration.h, sensorless_PID.c, sensorless_PID.h]
2014-02-15 Sine and atan tables have been icreased to 5500 each one thanks to the python table generator, whose files have been included in the Trigonometric_functions code. In addition interpolation functions 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
2014-02-15 dc car: motor moves with h bridge correctly
    [cdcacm_example.c]
2014-02-15 dc car: Encoder working with TIM4
2014-02-15 Test PI values. The controller is not working properly. It suddenly stops working and starts having weird behaviour. For example, the frequency has no data assigned to it, the pwm outputs are all in 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
    [example.c, interrupts.c, pwm-related_timer_configuration.h, sensorless_PID.c]
2014-02-15 The sine and atan table size have been reduced to 4000 entries in order to allow the sine and atan to have linear interpolation. Otherwise the stm32 has memory problems and stops working.
    [Trigonometric_Functions.h]
2014-02-15 Kicad files for the Three-phase bridge have been added.
    [IO - STM32F4Discovery.ods, Three-phase bridge.kicad_pcb, Three-phase bridge.sch]
2014-02-15 Kicad pcb has been separated into three bloks: stm32 connections, three-phase bridge and current sensing. The idea is to have the current operational and diffential amplifiers as close as possible to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
    [Three-phase bridge.kicad_pcb, Three-phase bridge.sch]
2014-02-15 Updating the three parts of the pcb.
    [Three-phase bridge.kicad_pcb]
2014-02-15 Schematic and PCB updated.
    [Three-phase bridge.kicad_pcb, Three-phase bridge.sch]
2014-02-15 The two INA148 have been wired.
    [Three-phase bridge.kicad_pcb]
2014-02-15 INA148s and MCP6s have been gotten closer.
    [Three-phase bridge.kicad_pcb]
2014-02-15 The conector from STM32 to the PCB has been fully wired up.
    [Three-phase bridge.kicad_pcb]
2014-02-15 The wire up for the Three-phase bridge has been completed. Nevertheless, the fillzones still remain undone.
    [$Three-phase bridge.sch, Three-phase bridge.kicad_pcb, Three-phase bridge.sch]
2014-02-15 A couple of capacitors have been added to VDD, and a LED for the 48V signal (just for having a visual check).
    [$Three-phase bridge.sch, Three-phase bridge.kicad_pcb, Three-phase bridge.sch]
2014-02-15 PCB: Fill zones for the IRF1010N have been added.
    [Three-phase bridge.kicad_pcb]
2014-02-15 PCB is apparently completed. The connections, fillzones and screw holes are done in Kicad.
    [Three-phase bridge.kicad_pcb, Three-phase bridge.sch]
2014-02-15 PCB: SVG files for printing the PCB have been created.
    [Three-phase bridge.kicad_pcb]
2014-02-15 PCB: Module T0-220 has been modified so that pin number 4 (for heat sink) is electrically connected to pin 3 (drain). Now whe the fill zones are filled, the heatsinks are connected to the PCB dissipa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
    [Three-phase bridge.kicad_pcb]
2014-02-15 PCB: Design rules checked.
2014-02-15 PCB: Some capacitor were moved in order to reduce the final PCBarea. Now it is 5.80in x5.72in.
    [Three-phase bridge.kicad_pcb]
2014-02-15 PCB: the circuit was moved to the center of the work sheet.
    [Three-phase bridge.kicad_pcb]
2014-02-15 This is the PCB before editing the fill zones, the pads and clearance. The only inconsistency here is that the red Fill zones have chosen the wrong signals, so that the drain pins are not connected.
    [Three-phase bridge.kicad_pcb, Three-phase bridge.sch]
2014-02-15 This is the PCB before editing the fillzones, paths and clearance.
    [$Three-phase bridge.sch]
2014-02-15 Connetions between the two stm32 connectors are finished.
    [Three-phase bridge.kicad_pcb]
2014-02-15 PCB files before globally editing the vías.
    [Three-phase bridge.kicad_pcb]
2014-02-15 Before deleting fillzones.
    [Three-phase bridge.kicad_pcb]
2014-02-15 Fillzones completed. However, the schematic is damaged, looks incomplete and has interrogation signs in some modules.
    [Three-phase bridge.kicad_pcb]
2014-02-15 Schematic file has been recovered, erc check is ok. PCB is also ok.
    [$Three-phase bridge.sch, Three-phase bridge.kicad_pcb, Three-phase bridge.sch]
2014-02-15 Python code for connecting to the STM32F4 through the serial port has been added. Now the STM32 can dissamble every float into 4 bytes that are reassembled in a computer running the phyton script. Th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
    [Three-phase bridge.kicad_pcb]
2014-02-15 Bidirectional communication between the STM32F4 and the python file has been established.
2014-02-15 In order to send a new frequency reference from python to the STM32F4 you have first to type enter and then "d 50" or the desired value. The function sys.stdin.readline() detects when the first enter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
2014-02-15 printing functions have been modified to adapt to the new sending-byte serial communication. Still debugging.
2014-02-15 Testing the cycles a print takes.
2014-02-15 PCB: the hall-effect current sensors have been added. Python: multiple graphics have been enabled within a figure
    [Three-phase bridge.sch]
2014-02-15 Python file can now receive from and transmit to the stm32f4, as well as print, save in a file, and plot such data. The python code has also been split into three files.
    [data.Thu Dec 12 18:46:12 2013.csv, data.Thu Dec 12 18:50:22 2013.csv, data.Thu Dec 12 18:53:29 2013.csv, data.Thu Dec 12 18:54:18 2013.csv, data.Thu Dec 12 19:22:27 2013.csv, data.Thu Dec 12 19:22:48 2013.csv, data.Thu Dec 12 19:23:23 2013.csv, data.Thu Dec 12 19:23:49 2013.csv]
2014-02-15 Separating class into methods.
    [Three-phase bridge.kicad_pcb, data.Thu Dec 12 18:46:12 2013.csv, data.Thu Dec 12 18:50:22 2013.csv, data.Thu Dec 12 18:53:29 2013.csv, data.Thu Dec 12 18:54:18 2013.csv, data.Thu Dec 12 19:22:27 2013.csv, data.Thu Dec 12 19:22:48 2013.csv, data.Thu Dec 12 19:23:23 2013.csv]
2014-02-15 Python code can now plot data from the stm32f4 into files.
2014-02-15 Python can now plot data from the stm32f4.
    [data.Thu Dec 12 21:32:19 2013.csv]
2014-02-15 Committing before editing the SMD PCB elements.
    [Three-phase bridge.kicad_pcb, Three-phase bridge.sch]
2014-02-15 PCB: All resistances and most of capacitors have been replaced by their SMD counter parts. Required space have been sustancially reduced.
    [Three-phase bridge.kicad_pcb, Three-phase bridge.sch]
2014-02-15 Most of the PCB has been compressed. Only the Red-green leds, fuses and diodes remains.
    [Three-phase bridge.kicad_pcb]
2014-02-15 Changing leds to SMD.
    [Three-phase bridge.kicad_pcb, Three-phase bridge.sch]
2014-02-15 Before changing the fuses.
    [Three-phase bridge.kicad_pcb]
2014-02-15 Fueses have been converted to SMD. THE ACS712/ACS714 have been wired.
    [$Three-phase bridge.sch, Three-phase bridge.kicad_pcb, Three-phase bridge.sch]
2014-02-15 PC1 and PC2 inputs have been enabled in case of using hall current sensors instead of shunt resistors (now both can coexist at the same time, just in case of camparisons).
    [IO - STM32F4Discovery.ods]
2014-02-15 New ADC ports for the hall current sensors have been added to the PCB. Rewiring of surrounding connections is being carried out.
    [Three-phase bridge.kicad_pcb, Three-phase bridge.sch]
2014-02-15 Adding fillzones to the PCB.
    [Three-phase bridge.kicad_pcb]
2014-02-15 The fillzones for GND and 48V where added.
    [Three-phase bridge.kicad_pcb]
2014-02-15 FIll zones completed.
    [Three-phase bridge.kicad_pcb]
2014-02-15 PCB update.
    [Three-phase bridge.kicad_pcb]
2014-02-15 Python fuction for communicating with the stm32f4 have been changed to work with lists instead of just floats for storing data in order to allow pointer-like functions. Just the print-on-screen optio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
2014-02-15 Working with lists didn't worked as expected. It complicates discarting an entire transmition when just a ingle data has been detected as containing errors.
    [Serial_Stm32f4.py]
2014-02-15 Checksum of transmitted bytes has been implemented in python and the stm32. In order to reduce the amount of data that has to be transmitted, and therefore the resultant transmition errors that oblig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
    [Serial_Stm32f4.py]
2014-02-15 Serial_Stm32f4.py causes transmition_error when sending the floaring value 0.01f. The problem is that such a value is the flux-linkage reference. Besides, the only characters detected on this test ve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
    [PID.c, Serial_Stm32f4.py, example.c]
2014-02-15 Print functions have been added all over the transmitting code to find out what is wrong.
    [Serial_Stm32f4.py, byte_to_float.py]
2014-02-15 As a solution for the serial transmition problem, in the stm32 when the function print_float_as_bytes detects a 0.01f value will be sent, then it changes it to 0.010000001f. Apart from that, there ha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
    [Serial_Stm32f4.py, byte_to_float.py, multi-rotor-530kv.h]
2014-02-15 The python code can now print data to a csv file and plot such data according to the preselected set of values established by print_selection. The next step is the creation of a routine for starting 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
2014-02-15 Apparently the NaNs were generated by the function fast_sine when the angle was 0°, 360° or any multiple. The interpolation "if" was written so that when this angle were selected a negative position 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
    [SVM.c, SVM.h, Serial_Stm32f4.py, Trigonometric_Functions.h, interrupts.c, sine_atan_tables_generator.py]
2014-02-15 Fixed fast_sine, fast_cos and fast atan for avoiding NaNs (reading negative positions from sine_table, cos_table and atan_table). Saving file functions are messy.
    [Trigonometric_Functions.h]
2014-02-15 Plotting with python and serial communication is fully working with the stm32. -This is before doing any set up to the P and I constants on the stm32 -the frequency check was eliminated on pyth
    on and a max_time check is done instead
    -the reference frequency is still used for
2014-02-15 PCB holes and fillzones fixed on the Three-phase_bridge_SMD design.
    [Three-phase bridge.kicad_pcb, Three-phase bridge.sch]
2014-02-15 -Trimmers for sensing 12V and 48V have been added to the PCB design. -A visual recheck has been performed to assure that the PCB connection are connected correctly. It seems that it is ready for the 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
    [Three-phase bridge.kicad_pcb]
2014-02-15 Kicad: Testing how to convert the SVG files to a comatible version with the laser cutter. STM32F4: testing PI values.
    [Three-phase bridge.kicad_pcb]
2014-02-15 Testing PI for torque.
2014-02-15 Modifying P and I functions on python to test torque instead of speed.
2014-02-15 Fixing errors of python code for testing torque control.
    [PID.c, Serial_Stm32f4.py]
2014-02-15 Before syntonizing the PI for the torque controller.
2014-02-15 Messy PI controller (speed and torque).
    [Three-phase bridge.kicad_pcb, Three-phase bridge.sch]
2014-02-15 Testing torque controller (rotating_angle=45°)
    [Three-phase bridge.kicad_pcb]
2014-02-15 Checking SVM algorithm and equations in order to find what is wrong with the load angle for the torque generation.
    [PID.c, SVM.c, Serial_Stm32f4.py, interrupts.c, multi-rotor-530kv.h, sensorless_PID.c]
2014-02-15 Mayor error: the SVM selects VsD and VsQ, then recalculates its magnitude and shrinks it to a maximum. The problem is that when calculating again the flux-linkage it uses the not-shrunk value and the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
    [Serial_Stm32f4.py, interrupts.c]
2014-02-15 Still testing and looking for mayor errors.
    [SVM.c, SVM.h, Serial_Stm32f4.py, interrupts.c, multi-rotor-530kv.h, sensorless_PID.c]
2014-02-15 Motor accelerates (maximum rotating angle=40°)
2014-02-16 Befire editing code for torque control on the ntmmotor.
2014-02-16 Even though a low pass filter is being used for the Flux-linkage, the frequency changes drastically due to the distorted measured currents. As a solution a low pass filter might be applied to the cur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
2014-02-18 Before deleting connections in the STM3 connectors.
    [Three-phase bridge.kicad_pcb]
2014-02-18 PCB: removing drill hole for the svg file, reducing vias, increasing track width as much as pussible, and deleating the second stm32 connector.
    [IO - STM32F4Discovery.ods, Three-phase bridge.kicad_pcb, Three-phase bridge.sch, affich.brd, conn_DBxx.brd, conn_HExx.brd, connect1.brd, connect2.brd]
2014-02-20 PCB has been expanded to the maximum pad size allowed.
    [Three-phase bridge.kicad_pcb, Three-phase bridge.sch]
2014-02-20 The PCB has been updated with wider tracks and pads (0.097 in, the maximum value before they touch each other).
    [$Three-phase bridge.sch, Three-phase bridge.kicad_pcb]
2014-02-20 PCB schematic updated.
    [$Three-phase bridge.sch, Three-phase bridge.sch]
2014-02-24 PCB: Increasing the size of connectors to the motor and eliminating their drill holes. Pending: -whether to increase the size of the pads for SMD INA148 and ACS or to change them for through-hole bre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
    [Three-phase bridge.kicad_pcb]
2014-02-28 Fixing the pads size error and changing all the pads from rounded to square form.
    [Three-phase bridge.kicad_pcb]
2014-03-07 Updating PCB design.
    [Three-phase bridge.kicad_pcb]
2014-03-07 Squared pads for PCB (more area for soldering).
    [tracks test.kicad_pcb]
2014-03-24 PCB: Fixed missing connection between pins 5 from the IRF2110 to the shunt resistors. The pdf generation for the laser cutter is still pending.
    [Three-phase bridge.kicad_pcb, Three-phase bridge.sch]
2014-04-03 Updating last PCB changes.
2014-04-05 Testing speed PI controller with new PCB.
2014-04-07 Adapting the code for forcing the rotor to take an initial angle.
2014-04-08 Testing code for aligning the rotor to phase A (not connected to the motor yet).
2014-04-08 Corroborating voltage levels for ADC current reading.
2014-04-08 Updating resistance values to the configuration files.
2014-04-09 Debugging and testing the PCB for the Vref!=1.5V (If it is not exactly 1.5 the currents are calculate wrongly)
    [DTC.c, PID.c, SVM.c, Serial_Stm32f4.py, interrupts.c, sensorless_PID.c]
2014-04-10 Erasing obsolete code and playing with the voltages and flux-linkages.
2014-04-10 Testing direct manipulation of voltage.
2014-04-10 With a load angle of 15 the rotor can spin. First the motor does not move, then it vibrates , then it vibrates more, and finally it spins really fast. Basically the algorithm is working, the problem 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
    [SVM.c, Serial_Stm32f4.py, multi-rotor-530kv.h, ntm_28-30_propdrive.h]
2014-04-11 Testing coerced initial rotor position and load angle 15°.
2014-04-12 Before modifying initial rotor position code.
2014-04-13 Trying to find the mechanical rotor position.
2014-04-15 Testing pulse generation for initial rotor position identification.
2014-04-15 The code for generating the voltage pulses for the rotor initial position is almost ready. The only problem is that sometimes the python code can not catch the data sent by the stm32 and thus plots n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
    [SVM.c, SVM.h, Serial_Stm32f4.py, initial_rotor_position.c, initial_rotor_position.h, sensorless_PID.c, sensorless_PID.h]
2014-04-15 Before getting the first semi-estimation of an initial rotor angle.
2014-04-16 Initial rotor position code does not work properly yet. It will be left aside by now.
    [SVM.c, Serial_Stm32f4.py, initial_rotor_position.c, initial_rotor_position.h]
2014-04-17 Code for voltage open-loop from 0Hz to 80Hz, plus DTC-SVM up to a constant value of 65° for the load angle, is ready. Next step is the actual close loop for speed and torque.
2014-04-17 Testing without voltage open loop, just DTC-SVM load_angle=5°
2014-04-17 Testing torque close loop. The torque bounces between positive and negative values even though the load angle is always positive.
2014-04-17 Before editing the interrupt function for reading currents
2014-04-19 Tested condition for flux-linkage=permanente_magnet_flux=0.0016 are 40%Ud when wcutoff=25Hz. Above 40% the flux-linkage surpaces such a value, and the graph psisQ vs psisD is not centered around cero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
2014-04-20 Using wcutoff=500HZ, 40%Ud and 90degrees constant, a relative constant torque of 0.05Nm has been achieved. Moreover, it is completely positive.
2014-04-20 Python can retry when there is an empty vector, but sometimes it is necessary to manually reset the timer in the stm32 with "d 5" in order to plot the data.
    [DTC.c, Serial_Stm32f4.py]
2014-04-20 Before testing close loop under wcutoff=200Hz, 40%Ud
2014-04-21 Testing load angles and the confusing torque inversion.
2014-04-30 Testing average mean current filter.
2014-05-01 Testial double filter
2014-05-02 Testing current offset.
2014-05-03 Testing effect of current offset on torque and flux-linkage.
2014-05-04 Testing different configurations for achieving a positive torque.
2014-05-05 Testing torque.
2014-05-06 adding PCB
    [Three-phase bridge.kicad_pcb, Three-phase bridge.sch, tracks test.kicad_pcb]
2014-05-06 add AD2S1210
    [AD2S1210.kicad_pcb, AD2S1210.sch]
2014-05-06 DTC-SVM relatively working OK in close loop. The torque and speed ripple is high though.
2014-05-06 Working version of the DTC-STVM on the multi-rotor.
2014-05-09 After having changed the PCB to handle 56V instead of 12V.
2014-05-12 Editting the code to work with the little Baldor motor.
2014-05-12 Before testing the close loop in the Baldor motor at 50V and 50%.
2014-05-14 DTC-SVM has been corrected. Reference for T1 and T2 must be the duty cycle for Us, not 1. Duty_Us=Vs/(2/3*Ud). Testing currents reference voltage.
    [BSM50N.h, SVM.c, Serial_Stm32f4.py, interrupts.c, shunt.c]
2014-05-15 After testing reference voltage adjusments for low value currents.
2014-05-15 BALDOR permanent magnet flux-linkage has been identifyed: psi_F=0.08Wb.
2014-05-19 Just-in-case saving.
2014-05-20 Updating ping list.
    [IO - STM32F4Discovery.ods]
2014-05-26 Before testing torque with just speed SVM.
2014-05-28 Testing DTC-SVM after having fixed the SVM duty cycles. The flux-linkage looks better, but the relation load angle - torque is not quite right. Also, the flux-linkage magnitude does not keep constant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
    [BSM50N.h, DTC.c, DTC.h, PID.c, SVM.c, SVM.h, Serial_Stm32f4.py]
2014-05-31 Added parameters for Vexta motor. First test for Vexta SVM open loop: done.
2014-06-02 Speed control based on control of the voltage frequency has been tested. P constant still has to be tuned.
2014-06-02 Operational speed close loop based on voltage frequency. P constant has been set to P=0.00001 (fastest with minimum oscilations).
    Other settings tested:
    P=0.0001: fastest but too many oscillations
    P=0.000001: no oscillations but too slow
    [SVM.c, SVM.h, Serial_Stm32f4.py, vexta_AXHM450KC-GFH.h]
2014-06-02 File with pinout description has been uptated.
    [IO - STM32F4Discovery.ods]
2014-06-02 Operational close-loop Speed controller based on voltage frequency.
2014-06-03 Added code to transmit admittance parameters from the stm32 to python and viceverse.
2014-06-05 testting negative frequency with two hall sensors.
2014-06-05 Speed controller with positive and negative reference frequency, based on voltage frequency estimation, has been testing and is working. The error that caused the nans on the flux-linkage estimation 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
    [SVM.c, Serial_Stm32f4.py, sensorless_PID.c, vexta_AXHM450KC-GFH.h]
2014-06-12 Before editing how the angles for joint movement are handled.
2014-06-13 Having a resistance of 330 on the INA125P for the gain setup gives a relation of 1 between the torque and the output voltage (after having substracted the reference voltage).
2014-06-16 Before testing admittance control.
    [Three-phase bridge.kicad_pcb]
2014-08-01 Before debugging for presentation.
    [Vexta_motor_adapter.fcstd, Vexta_motor_adapter.stl, Vexta_motor_adapter_real_measures.stl, Vexta_motor_adapter_squared.fcstd, Vexta_motor_adapter_squared_real_measures.fcstd, Vexta_motor_just_holes.fcstd]
2014-09-18 Creating PCB files for the mobile base.
    [Three-phase bridge.kicad_pcb, Three-phase bridge.sch, tracks test.kicad_pcb]
2014-09-25 Modulos originales de libreria de Sebastian
    [Modificado-Three-phase bridge.kicad_pcb, Three-phase bridge.kicad_pcb]
2014-09-25 Agregado esquemático del Puente Wheatstone
    [Three-phase bridge.kicad_pcb, Three-phase bridge.sch, tracks test.kicad_pcb]
2014-09-29 Eliminacion de conecciones de Pin 8 y 9 del stm 32
    [Three-phase bridge.sch]
2014-09-30 Deleted messy Alonso's PCB files.
    [Modificado-Three-phase bridge.kicad_pcb, Three-phase bridge.kicad_pcb, Three-phase bridge.sch, tracks test.kicad_pcb]
2014-09-30 Creating a new PCB directory for the mobile base.
    [Three-phase bridge.kicad_pcb, Three-phase bridge.sch]
2014-09-30 creacion de fichero de lista de componentes .lst y modificacion de fichero .net
2014-09-30 modificacion de modulos en fichero .kicad_pcb
    [Three-phase bridge.kicad_pcb]
2014-09-30 eliminacion de pistas anteriores
    [Three-phase bridge.kicad_pcb]
2014-09-30 se agrego _autosave* al gitignore y se eliminaron los potenciometros
    [Three-phase bridge.sch]
2014-09-30 iniciando el reacomodo de los modulos
    [Three-phase bridge.kicad_pcb]
2014-10-01 disminuir espacio entre modulos ina,stm,c,r,d
    [Three-phase bridge.kicad_pcb]
2014-10-02 agrupacion total de modulos sin revision de profesores.
    [Three-phase bridge.kicad_pcb]
2014-10-04 reduccion adicional pcb, se va iniciar el ruteo
    [Three-phase bridge.kicad_pcb]
2014-10-04 Pistas de 48 V y GND
    [Three-phase bridge.kicad_pcb]
2014-10-10 Version antes del borrado de pistas y incrementar espacio entre componentes
    [Three-phase bridge.kicad_pcb]
2014-10-10 Distribucion modular mas espaciada, algunas pistas GND y 48V
    [Three-phase bridge.kicad_pcb]
2014-10-13 PCB base movil parte Sebastian LISTA
    [Three-phase bridge.kicad_pcb]
2014-10-14 pcb potencia sin zonas de relleno
    [Three-phase bridge.kicad_pcb]
2014-10-14 pcb potencia sin zonas de relleno 2
    [Three-phase bridge.kicad_pcb]
2014-10-14 PCB potencia con zonas de relleno
    [Three-phase bridge.kicad_pcb]
2014-10-14 PCB potencia con zonas relleno 2
    [Three-phase bridge.kicad_pcb]
2014-10-18 PCB potencia y PCB resolver version de Philip Koenig
    [$noname.sch, AD2S1210.csv, AD2S1210.kicad_pcb, AD2S1210.sch, AD2S1210_AD8662-append.kicad_pcb, AD2S1210_AD8662.csv, AD2S1210_AD8662.kicad_pcb, AD2S1210_AD8662.sch]
2014-10-24 new file gerber PCB Three-phase bridge
    [AD2S1210_AD8662-B_Cu.gbl, AD2S1210_AD8662-B_Mask.gbs, AD2S1210_AD8662-B_SilkS.gbo, AD2S1210_AD8662-Edge_Cuts.gbr, AD2S1210_AD8662-F_Cu.gtl, AD2S1210_AD8662-F_Mask.gts, AD2S1210_AD8662-F_SilkS.gto, AD2S1210_AD8662-NPTH.drl]
2014-11-19 JOINT STABLE VERSION [updating .gitignore]
2014-11-21 updating corrected frequency algorithm
    [SVM.c, vexta_AXHM450KC-GFH.h]
2014-11-22 testing P with hall sensor
2014-12-04 reduccion de resolver
    [AD2S1210_AD8662-B_Cu.gbl, AD2S1210_AD8662-B_Mask.gbs, AD2S1210_AD8662-B_SilkS.gbo, AD2S1210_AD8662-Edge_Cuts.gbr, AD2S1210_AD8662-F_Cu.gtl, AD2S1210_AD8662-F_Mask.gts, AD2S1210_AD8662-F_SilkS.gto, AD2S1210_AD8662-NPTH.drl]
2014-12-05 Max electric frequency: 650Hz
2014-12-09 cambio de valores errones
    [AD2S1210_AD8662.kicad_pcb]
2015-01-10 Syntonizing PID [both hall sensors must be checked, speed values drops from 11Hz to 200Hz{H1}, or 100Hz {H2}]
2015-01-13 testing hall PI and SVM with multi-rotor motor
2015-01-16 testing confusing loss of smothness when 85Hz<f<125Hz
2015-01-19 Modifying code in order to find what load angle causes the P controller to fail when 85<f<125
    [PID.c, SVM.c, Serial_Stm32f4.py, multi-rotor-530kv.h]
2015-01-27 silkscreen new
    [Three-phase bridge.kicad_pcb, Three-phase bridge.sch]
2015-01-27 resolver kicad pcb: added vout
    [AD2S1210_AD8662.kicad_pcb]
2015-02-16 The Fixed Point folder created and uploaded
    [Three-phase bridge.kicad_pcb, Three-phase bridge.sch, Vexta_motor_adapter.fcstd, Vexta_motor_adapter.stl, Vexta_motor_adapter_real_measures.stl, Vexta_motor_adapter_squared.fcstd, Vexta_motor_adapter_squared_real_measures.fcstd, Vexta_motor_just_holes.fcstd]
2015-02-19 Cambio de self.read_strings=True
2015-02-26 Pruebas aritmeticas y de tiempo para float y fixed listas
    [Serial_Stm32f4.py, example.c, initial_setup.c, interrupts.c]
2015-03-14 FixedPoint_Validation_Project: This version updates the results of several operations in the .ods file and adds some scope images
    [example.c, initial_setup.c]
2015-03-19 FixedPoint_Proyect: This commit aims to update de Resultados_de_Validacion folder with the historial of all the work in the moment
    [Three-phase bridge.kicad_pcb, Three-phase bridge.sch, Vexta_motor_adapter.fcstd, Vexta_motor_adapter.stl, Vexta_motor_adapter_real_measures.stl, Vexta_motor_adapter_squared.fcstd, Vexta_motor_adapter_squared_real_measures.fcstd, Vexta_motor_just_holes.fcstd]
2015-03-23 FixedPoint: New results about '<<', '>>' operations and transformations fixed to float, float to fixed, review the Resultados_Validacion_operaciones.ods file
    [example.c]
2015-03-25 FixedTesting: This is a new folder which was copied from src_DTC_SVM and it is for develop some tests by modifing only one function to implement fixed point representation. This folder was strictly n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
    [Three-phase bridge.kicad_pcb, Three-phase bridge.sch, Vexta_motor_adapter.fcstd, Vexta_motor_adapter.stl, Vexta_motor_adapter_real_measures.stl, Vexta_motor_adapter_squared.fcstd, Vexta_motor_adapter_squared_real_measures.fcstd, Vexta_motor_just_holes.fcstd]
2015-03-30 FixedPoint: This commit has some modifications about ADC timers in order to check if it can be segmented of pipelined
    [DTC.c, DTC.h, PID.h, example.c, initial_setup.c, interrupts.c]
2015-04-11 FixedPoint Project: This commit includes new results about ADC segmentation, there is a very important discovery that lead to the idea of some improvements. Please, read the file ADC_Measurements_Res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
    [interrupts_Original.c, interrupts_Varios_ADC.c]
2015-04-13 correción de los valores de resistencias del buffer de tarjeta resolver
    [AD2S1210_AD8662.sch]
2015-04-21 before editting
    [IO - STM32F4Discovery.ods]
2015-04-22 FixedPoint: This commit has new updates
    [[Fri Apr 17 19:04:54 2015] [one 300 0, hall frequency controller, P =0.001] data frequencies.csv, [Fri Apr 17 19:05:29 2015] [one 300 0, hall frequency controller, P =0.001] data frequencies.csv, [Fri Apr 17 19:06:12 2015] [one 300 0, hall frequency controller, P =0.001] data frequencies.csv, [Fri Apr 17 19:14:44 2015] [one 300 0, hall frequency controller, P =0.001] data frequencies.csv, [Fri Ap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]
2015-04-23 src_caro_DTC-SVM: copied src_DTC-SVM project and started modifing the code, first resitance test for the head motors
2015-04-23 DTC-SVM code works fine with batteries at an attenuation of 80% of the voltage (0.8Ud). More than that causes the fuse to constantly melt.
    [SVM.c, vexta_AXHM450KC-GFH.h]
2015-04-23 Adding new source for the corrected code of the stiffness controller for the joint (src_stiffness_controller)
    [BSM50N.h, DTC.c, DTC.h, PID.c, PID.h, SVM.c]
2015-04-23 editing src_DTC_SVM PID
2015-04-23 Cleaning the code for the stiffness controller (mainly the SVM.c file)
    [DTC.c, PID.c, SVM.c, Serial_Stm32f4.py, sensorless_PID.c, vexta_AXHM450KC-GFH.h]
2015-04-24 testing actual DTC-SVM code, enabling the pid with the v_s_ref calculation
2015-05-13 motor running
2015-05-13 FixedPoint: Added new files and results (miscellaneous staff)
    [Serial_Stm32f4.py, initial_setup_Respaldo_Intacto.c, initial_setup_Varios_ADC.c, interrupts.c]
2015-05-27 ADC code for controlling the hand with the stm32f4
2015-07-16 JeanCarlosChavarriaHughes: Added new folder with significative advances in analog parallel adquisition with STM32 for open-coroco
    [[Tue Jul 14 19:17:48 2015] [one 300 5, hall frequency controller, P =0.001] data flux-linkage.csv, [Tue Jul 14 19:24:13 2015] [one 300 3, hall frequency controller, P =0.001] data VsQ_vs_VsD.csv, [Tue Jul 14 19:41:55 2015] [one 300 3, hall frequency controller, P =0.001] data VsQ_vs_VsD.csv, [Tue Jul 14 19:42:22 2015] [one 300 5, hall frequency controller, P =0.001] data flux-linkage.csv, [Tue Ju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]
